Newtonsohn/BA-Smart-Waage/Doku/BA_Doku.tex

\documentclass[12pt,a4paper]{article}
\usepackage[utf8]{inputenc}
\usepackage[german]{babel}
\usepackage{amsmath}
\usepackage{amsfonts}
\usepackage{amssymb}
\usepackage{graphicx}
\usepackage{hyperref}
\usepackage{booktabs}
\usepackage{siunitx}
\usepackage{verbatim}
\usepackage{float}
\usepackage[a4paper, left=2.5cm, right=2.5cm, top=2.5cm, bottom=2.5cm]{geometry}
\usepackage{pdfpages}
\usepackage{pdflscape}

\setcounter{secnumdepth}{3}
\setcounter{tocdepth}{3}

\begin{document}
	\includepdf[pages=-]{Images/T_VL_Vorlage_Titelseite_BA.pdf}
	\includepdf[pages=-]{Images/BA_Doku_removed_signed}
	\newpage

	% ============================================================
	\section*{Abstract}
	% ============================================================

	\textbf{English}

	\medskip
	\noindent
	This thesis advances a previously developed ESP32-based smart scale prototype for industrial parts and bulk-goods inventory management.
	Two aspects are addressed in depth: measurement accuracy and energy efficiency.

	For measurement accuracy, the four YZC-133 load cells are each connected to a dedicated channel of the ADS1234 24-bit ADC with a PGA gain of~128 and a data rate of 10~SPS.
	Individual per-sensor calibration enables corner-load compensation, which was not possible with the single summed channel of the predecessor.
	Measurements confirm a repeatability of $\pm$\,0.1\,g, though absolute accuracy is limited by mechanical imperfections of the prototype.

	For energy efficiency, three hardware measures were implemented: the load-cell supply is interrupted via MOSFET before entering deep sleep; the ESP32 is powered directly through the 3V3~pin, eliminating the on-board LDO; and the buck-converter output voltage was reduced from 3.3\,V to 3.0\,V, saving an additional 73.4\,mJ per cycle ($-$17.6\,\%).
	Combined with software-level optimisations including the migration from the Arduino BLE stack to NimbleBLE, the active-cycle energy consumption is reduced from 6503\,mJ to 689.5\,mJ, a reduction of \textbf{89.4\,\%}.
	A custom PCB was designed to consolidate the power path; a component selection error in the buck converter prevents its immediate use in the current revision.

	\bigskip
	\textbf{Deutsch}

	\medskip
	\noindent
	Diese Bachelorarbeit baut auf einem bestehenden ESP32-basierten Smart-Waagen-Prototyp für die industrielle Inventarisierung von Kleinteilen und Schüttgut auf und vertieft zwei Schwerpunkte: Messgenauigkeit und Energieeffizienz.

	Zur Verbesserung der Messgenauigkeit wird jede der vier YZC-133-Wägezellen einzeln an einen dedizierten Kanal des ADS1234 (24-Bit-ADC, PGA-Faktor~128, 10~SPS) angeschlossen.
	Die individuelle Kalibrierung pro Sensor ermöglicht eine Ecklastkompensation, die mit dem summierten Einzelkanalansatz der Vorgängerarbeit nicht realisierbar war.
	Die Messungen zeigen eine Wiederholbarkeit von $\pm$\,0{,}1\,g; die Absolutgenauigkeit ist durch mechanische Unzulänglichkeiten des Prototyps eingeschränkt.

	Für die Energieoptimierung wurden drei Hardwaremassnahmen umgesetzt: Die Wägezellen werden über einen MOSFET vor dem Deep-Sleep abgeschaltet; der ESP32 wird direkt über den 3V3-Pin versorgt, womit der interne Board-LDO entfällt; die Ausgangsspannung des Buck-Converters wurde von 3{,}3\,V auf 3{,}0\,V abgesenkt, was eine zusätzliche Einsparung von 73{,}4\,mJ pro Zyklus ($-$17{,}6\,\%) erzielt.
	In Kombination mit Softwareoptimierungen -- darunter die Migration vom Arduino-BLE-Stack auf NimbleBLE -- sinkt der Energieverbrauch pro Aktivzyklus von 6503\,mJ auf 689{,}5\,mJ, eine Reduktion um \textbf{89{,}4\,\%}.
	Ein eigens entwickeltes PCB wurde zur Konsolidierung des Strompfads ausgelegt; ein Fehler bei der Schaltreglerwahl verhindert dessen unmittelbaren Einsatz in der vorliegenden Revision.

	\newpage
	\tableofcontents
	\newpage

	% ============================================================
	\section{Einleitung}
	% ============================================================

	Die zunehmende Vernetzung industrieller Prozesse stellt neue Anforderungen an eingebettete Systeme -- insbesondere hinsichtlich Energieeffizienz, Messgenauigkeit und Kommunikationszuverlässigkeit.
	Diese Arbeit baut auf einem bestehenden Proof of Concept~\cite{vorgaengerarbeit} auf und vertieft dessen technische Grundlagen mit Fokus auf die Weiterentwicklung der Smart-Waage selbst.

	\subsection{Ausgangslage}

	Ausgangslage für diese Arbeit bildet die Firma Skysec GmbH, ein Startup, das sich auf die Herstellung von Drohnen zum Schutz von Einrichtungen spezialisiert hat.
	Für den Herstellungsprozess, insbesondere die Inventarisierung von Kleinteilen und Schüttgut, sollen intelligente Waagen (Smart-Bins) eingesetzt werden.
	Bestehende kommerzielle Lösungen -- etwa von Bossard -- sind an proprietäre Cloud-Plattformen gebunden und erlauben keine eigenständige Datenhoheit, was für den Industriepartner aufgrund seiner sicherheitskritischen Tätigkeit nicht akzeptabel ist.

	Im Rahmen der vorangegangenen Bachelorarbeit~\cite{vorgaengerarbeit} (Berger \& Müller, BA~FS25) wurde bereits ein funktionsfähiger Prototyp entwickelt: ein ESP32-basiertes Wägesystem mit BLE-Kommunikation, einem Raspberry-Pi-Gateway und einem containerisierten ASP.NET-Core-Backend.
	Die vorliegende Arbeit knüpft an diesen PoC an und setzt den Schwerpunkt auf die Optimierung der Waage selbst -- mit Fokus auf Messgenauigkeit und Energieverbrauch.

	\subsection{Zielsetzung}

	Die Zielsetzung gliedert sich in funktionale und organisatorische Ziele gemäss der Projektvereinbarung~\cite{vereinbarung}.

	\begin{table}[H]
		\centering
		\caption{Funktionale Ziele gemäss Vereinbarung}
		\label{tab:ziele-funktional}
		\begin{tabular}{p{9.5cm}ccc}
			\toprule
			\textbf{Funktionales Ziel} & \textbf{Muss} & \textbf{Soll} & \textbf{Optional} \\
			\midrule
			Evaluation Hardware-Plattformen (ESP32, STM32, Arduino, Raspberry) & $\times$ & & \\
			Evaluation Kommunikationsprotokoll (BLE, ESP-NOW)                  & $\times$ & & \\
			Analyse Leistungsbedarf und Evaluation von Leistungssparmassnahmen & $\times$ & & \\
			Interface mit der Waage (Tara, Stückzahl, Gewicht, Einheitenumrechner) & $\times$ & & \\
			Power-Optimierung: Reduktion Aktiv- und Ruheströme                & $\times$ & & \\
			Evaluation Energiequelle (Batterie vs.\ Akku)                     & $\times$ & & \\
			Temperaturkorrektur der Dehnmessstreifen                          & & $\times$ & \\
			Massenproduktionstaugliches PCB                                     & & & $\times$ \\
			Umporten auf STM32                                                 & & & $\times$ \\
			Umbau auf Batteriebetrieb                                          & & & $\times$ \\
			\bottomrule
		\end{tabular}
	\end{table}

	\begin{table}[H]
		\centering
		\caption{Organisatorische Ziele gemäss Vereinbarung}
		\label{tab:ziele-org}
		\begin{tabular}{p{11cm}cc}
			\toprule
			\textbf{Organisatorisches Ziel} & \textbf{Muss} & \textbf{Soll} \\
			\midrule
			Erstellung eines Projektplans              & $\times$ & \\
			Beschaffung der benötigten Hardware        & $\times$ & \\
			Einhaltung des Abgabetermins               & $\times$ & \\
			Einhaltung der Meilensteine                & & $\times$ \\
			\bottomrule
		\end{tabular}
	\end{table}

	\subsection{Systemabgrenzung und Randbedingungen}

	Folgende Bereiche sind explizit \textbf{nicht} Bestandteil dieser Arbeit:
	\begin{itemize}
		\item On-Premise-Lösung (keine Cloud-Anbindung)
		\item Dynamisches Softwareupdate (OTA)
		\item Einbindung in Firmennetzwerk
		\item Fertiges Produkt (Prototyp-Status)
		\item Verschlüsselte Übermittlung der Sensordaten an das Gateway
		\item Weiterentwicklung des bestehenden Backends
	\end{itemize}

	\noindent Randbedingungen:
	\begin{itemize}
		\item Arbeitsplätze im Raum TE514\,/\,TE516 sowie Messgeräte, Lötstation und Industrienetzgerät stehen bereit.
		\item Der Projektstand wird regelmässig mit dem Betreuer besprochen.
		\item Der Quellcode wird auf GitHub gehostet.
	\end{itemize}

	\subsection{Meilensteine}

	\begin{enumerate}
		\item \textbf{Hardware-Entwicklung:} Evaluation alternativer Plattformen; Redesign des Strompfads für Low-Power-Betrieb.
		\item \textbf{Quality of Life:} Implementierung von Bedienelementen (Taster) sowie Software-Funktionen (Tara, Kalibrierung, Einheitenumrechner).
		\item \textbf{Kommunikationsprotokolle:} Evaluation und Implementierung von ESP-NOW vs.\ BLE (NimbleBLE).
	\end{enumerate}

	\subsection{Aufbau der Arbeit}

	Die Arbeit ist in folgende Kapitel gegliedert:
	Kapitel~2 beschreibt die technische Ausgangslage und die getroffenen Designentscheidungen.
	In Kapitel~3 werden die Low-Power-Optimierungen erläutert -- von der Hardwareanpassung bis zur Strommessung.
	Kapitel~4 behandelt die Optimierung der Messgenauigkeit, einschliesslich Sensorik, ADC-Ansteuerung und Kalibrierung.
	Eine Geräteübersicht beider Prototypen ist in Kapitel~5 dargestellt.
	Das PCB-Design ist in Kapitel~6 dokumentiert.
	Kapitel~7 fasst die Messungen zusammen, und Kapitel~8 schliesst mit Fazit und Ausblick.

	% ============================================================
	\section{Technische Ausgangslage}
	% ============================================================

	\subsection{Design Space Exploration}

	\subsubsection{MCU-Auswahl: SBC-NodeMCU-ESP32-C vs. ESP32-C3 vs. nRF52840}

	Für die Wahl des Mikrocontrollers wurden drei Kandidaten verglichen.
	Die wesentlichen Stromverbrauchswerte sind in Tabelle~\ref{tab:mcu} gegenübergestellt.

	\begin{table}[h]
		\centering
		\begin{tabular}{lrrr}
			\toprule
			\textbf{MCU} & \textbf{Aktiv (mit RF)} & \textbf{Light Sleep} & \textbf{Deep Sleep} \\
			\midrule
			SBC-NodeMCU-ESP32-C (Board)$^\dagger$ & \SI{160}{\milli\ampere} -- \SI{240}{\milli\ampere} & $\sim$\SI{5}{\milli\ampere} & $\sim$\SI{4}{\milli\ampere} \\
			ESP32-C3 (SoC)                        & \SI{100}{\milli\ampere} -- \SI{335}{\milli\ampere} & \SI{130}{\micro\ampere}     & \SI{5}{\micro\ampere}  \\
			nRF52840 (SoC)                        & $\sim$\SI{16}{\milli\ampere}                       & \SI{1{,}5}{\micro\ampere}   & \SI{0{,}4}{\micro\ampere} \\
			\bottomrule
		\end{tabular}
		\caption{Stromverbrauch der MCU-Kandidaten \cite{sbc_nodemcu_esp32c_datasheet, esp32_devboard_sleep, esp32c3_datasheet, nrf52840_datasheet}.
		$^\dagger$~Board-Werte inkl.\ CP2102, LDO und Power-LED; ESP32-C3 und nRF52840 beziehen sich auf den SoC-Chip allein.}
		\label{tab:mcu}
	\end{table}

	Das nRF52840 ist energetisch am effizientesten, erfordert jedoch ein vollständiges Porting der bestehenden Software sowie eine neue Peripherieschaltung.
	Der ESP32-C3 bietet auf SoC-Ebene einen deutlich besseren Sleep-Strom als das SBC-Entwicklungsboard und wäre mit moderatem Aufwand adaptierbar, benötigt aber ebenfalls eine eigene Peripheriebeschaltung.
	Da die Vorgängerarbeit~\cite{vorgaengerarbeit} bereits auf dem SBC-NodeMCU-ESP32-C basiert, kann dessen bestehende Hardware- und Softwarebasis direkt übernommen werden, ohne eine Peripherieschaltung neu auslegen zu müssen.
	Angesichts des erheblichen Einsparpotenzials auf Seiten der DMS-Signalkette und der Software fiel die Entscheidung daher auf den SBC-NodeMCU-ESP32-C, um den Entwicklungsaufwand zu minimieren und den Fokus auf die relevanten Optimierungen zu legen.
	Der hohe Sleep-Strom des Boards -- verursacht durch CP2102, Board-LDO und Power-LED -- wurde dabei als bekannte Einschränkung in Kauf genommen.
	
	% ============================================================
	\section{Low-Power Optimierung}
	% ============================================================
	\subsection{Motivation}

	Die Waage ist für den Einsatz in der Intralogistik konzipiert, wo sie autonom und ohne regelmässige Wartung den Füllstand von Lagerbehältern überwacht.
	In diesem Umfeld ist eine möglichst lange Batterielaufzeit entscheidend: Jeder Akkuwechsel verursacht Wartungsaufwand, der bei einer grossen Anzahl verteilter Geräte erhebliche Betriebskosten erzeugen kann.

	Da die Vorgängerarbeit ihren Schwerpunkt auf die funktionale Korrektheit des Systems legte, wurde die Optimierung des Stromverbrauchs bisher nicht adressiert.
	Das System bietet daher noch erhebliches Einsparpotenzial, das in dieser Arbeit systematisch erschlossen wird.
	
	\subsection{Strompfad Schema}
	Die folgenden Diagramme zeigen den Strompfad der alten und neuen Waage.

		\subsubsection{Ausgangslage}
			\begin{figure}[h]
			\centering
			
			\caption{Schema Strompfad -- Ausgangslage}
			\label{fig:strompfad-ausgangslage}
		\end{figure}

		Die Spannungsversorgung der Ausgangslage besteht aus drei in Reihe geschalteten 18650-Lithium-Ionen-Zellen mit einer Nennspannung von \SI{11.1}{\volt}.
		Ein \textbf{LM2596}-Schaltregler wandelt diese Spannung auf ein stabiles \SI{5}{\volt}-Rail herunter, von dem alle Verbraucher gespeist werden: der ESP32 (über den internen LDO des Entwicklerboards), der HX711-ADC, die Dehnmessstreifen sowie das E-Paper-Display.
		Der LDO des Entwicklerboards wandelt die \SI{5}{\volt} auf die vom Mikrocontroller benötigten \SI{3.3}{\volt} -- eine zusätzliche Spannungskonversion, die unnötige Verlustleistung erzeugt und im Hardware Redesign beseitigt wird.

		\subsubsection{Hardware Redesign}
			\begin{figure}[H]
			\centering
			
			\caption{Schema Strompfad -- Hardware Redesign}
			\label{fig:strompfad-redesign}
		\end{figure}

		Das Hardware Redesign optimiert den Strompfad in zwei wesentlichen Punkten:
		\begin{itemize}
			\item \textbf{Dehnmessstreifen über MOSFET geschaltet:} In der Ausgangslage waren die Wägezellen dauerhaft mit Spannung versorgt -- auch im Deep Sleep. Durch einen MOSFET wird die Versorgung der Dehnmessstreifen vor dem Eintreten in den Deep Sleep unterbrochen, was den Ruhestrom merklich senkt.
			\item \textbf{ESP32 direkt über den 3V3-Pin versorgt:} Das Entwicklerboard enthielt einen internen LDO, der \SI{5}{\volt} auf \SI{3.3}{\volt} regelte. Im neuen Design wird der ESP32 direkt über den \texttt{3V3}-Pin eingespeist, womit diese Verlustleistung entfällt. Ausserdem wurde die Ausgangsspannung des Buck-Converters auf \SI{3.0}{\volt} reduziert, was gegenüber dem Betrieb mit \SI{3.3}{\volt} eine weitere Einsparung von \SI{73.4}{\milli\joule} pro Zyklus ($-17{,}6\,\%$) erzielt (siehe Abschnitt~\ref{sec:spannungsreduktion}).
		\end{itemize}

	\subsection{Strommessungen und Low-Power-Optimierung}

	Ein zentrales Ziel dieser Arbeit ist die Minimierung des Stromverbrauchs, um eine möglichst lange Batterielaufzeit zu erreichen.
	Die folgenden Messungen dokumentieren den Energieverbrauch in den einzelnen Betriebsphasen und quantifizieren den Effekt der implementierten Optimierungen.
	Tabellen~\ref{tab:sw-vergleich} und~\ref{tab:sys-vergleich} fassen die verbrauchte Energie pro Phase zusammen -- jeweils im direkten Vergleich zwischen Ausgangslage und optimiertem System.

	\subsection{Übersicht Zyklus}

	Für die Strommessungen kamen zwei Messgeräte zum Einsatz, die je nach Messaufgabe in den Versorgungspfad eingeschleift wurden.

	Das \textbf{Nordic Semiconductor Power Profiler Kit~II} (PPK2) wurde für das qualitative Stromverlauf-Profiling eingesetzt und liefert eine zeitlich aufgelöste Visualisierung der einzelnen Betriebsphasen (Boot, ADC-Messung, BLE, Deep Sleep) in der nRF Connect Power Profiler App.

	Die quantitativen Energie- und Leistungsmessungen wurden mit dem \textbf{JouleScope} durchgeführt.
	Das JouleScope misst gleichzeitig Strom und Spannung und berechnet daraus direkt die verbrauchte Energie in Millijoule -- unter Berücksichtigung des tatsächlichen Spannungsniveaus am jeweiligen Messpunkt.
	Je nach Messung wurde das Gerät an unterschiedlichen Stellen in den Strompfad eingeschleift: vor dem Buck-Converter (Batterieseite), nach dem Buck-Converter (Power-Rail), direkt vor einzelnen Verbrauchern (ESP32, ADC, Dehnmessstreifen) oder am LDO-Ein- bzw.\ Ausgang.

	\subsection{Gesamtsystem Stromverbrauch}

	Tabelle~\ref{tab:sw-vergleich} vergleicht die Software-Ausgangslage mit dem optimierten System auf Basis der JouleScope-Messungen am 3V3-Pin des ESP32.
	Tabelle~\ref{tab:sys-vergleich} stellt den Gesamtenergieverbrauch beider Systeme gegenüber; die Werte beziehen sich auf JouleScope-Messungen vor dem Buck-Converter (Batterieseite) und umfassen damit sämtliche Wandlungsverluste.
	
	\subsubsection{Vergleich Energieverbrauch Aktiver Zyklus}
	\begin{table}[H]
	\centering
	\caption{Gesamtsystem Energiebedarf Zusammensetzung -- Vergleich Aktiver Zyklus}
	\label{tab:sys-vergleich}
	\begin{tabular*}{\textwidth}{@{\extracolsep{\fill}}lrrr@{}}
		\toprule
		Verbraucher 					& Alt [mJ] 	& Neu [mJ] 	& Ersparnis \\
		\midrule

		\multicolumn{4}{l}{\textit{Verbrauch}} \\[2pt]
		\quad ESP32 über 3V3			&	2220	&	223.8	&	$-89.9\,\%$	\\
		\quad Dehnmessstreifen			&	781.9	&	89.1	&	$-88.6\,\%$	\\
		\quad ADC						&	106.2	&	13.42	&	$-87.4\,\%$	\\[4pt]
		\multicolumn{4}{l}{\textit{Verluste Umwandlung}} \\[2pt]
		\quad Verlust LDO				&	1210	&	0		&	Entfällt	\\
		\quad Verlust Buck				&	2955	&	346.1	&	$-88.3\,\%$	\\
		\midrule
		Summiert						&	7273.1	&	672.4	&	$-90.7\,\%$	\\
		Diskrepanz						&	$-770.1$&	17.1	&				\\
		\midrule
		\textbf{Gesamt Gemessen}    	& 	6503	&	689.5	&	$-89.4\,\%$	\\
		\bottomrule
	\end{tabular*}
	\\[4pt]
\end{table}

	\subsubsection{Vergleich Leistungsverbrauch Deep-Sleep}

	Tabelle~\ref{tab:sys-vergleich-deep-sleep} vergleicht den Leistungsverbrauch im Deep Sleep.
	Einzelmessungen der Verbraucher: Abb.~\ref{fig:deep-dms-alt} (DMS), \ref{fig:deep-adc-alt}/\ref{fig:deep-adc-neu} (ADC).
	Gesamtmessungen vor dem Buck-Converter: Abb.~\ref{fig:deep-vorbuck-alt}/\ref{fig:deep-vorbuck-neu}.
	Trotz der Komponenteneinsparungen ($-87{,}7\,\%$ nach Buck) begrenzt der Leerlaufverlust des LM2596S von \SI{69.77}{\milli\watt} (Abb.~\ref{fig:deep-leerlauf-buck}) die tatsächliche Ersparnis auf Batterieebene erheblich: Er übersteigt allein bereits den Gesamtverbrauch aller Komponenten des neuen Systems.

	\begin{table}[H]
	\centering
	\caption{Vergleich Leistungsverbrauch Deep-Sleep -- Ausgangslage vs.\ Optimiertes System}
	\label{tab:sys-vergleich-deep-sleep}
	\begin{tabular}{@{}lrrr@{}}
		\toprule
		Verbraucher & Alt [mW] & Neu [mW] & Ersparnis \\
		\midrule
		\multicolumn{4}{l}{\textit{Nach Buck-Converter (Power Rail)}} \\[2pt]
		\quad Dehnmessstreifen       & 78{,}19  & 0        & $-$100\,\% (MOSFET) \\
		\quad ADC                    & 9{,}762  & 4{,}042  & $-$58{,}6\,\% \\
		\quad ESP32                  & 27{,}53  & 10{,}15  & $-$63{,}1\,\% \\
		\midrule
		Summiert (nach Buck)         & 115{,}4  & 14{,}19  & $-$87{,}7\,\% \\
		\midrule
		\multicolumn{4}{l}{\textit{Vor Buck-Converter (Batterieseite)}} \\[2pt]
		\textbf{Gesamt gemessen}     & \textbf{268{,}2} & \textbf{90{,}96} & $-$66{,}1\,\% \\
		\bottomrule
	\end{tabular}
	\\[4pt]
	\end{table}

	\subsection{Vergleich Energieverbrauch ESP32}
	
	\subsubsection{Übersicht Stromverlauf ESP32}
	
	Abbildung~\ref{fig:stromverbrauch-ausgangslage} zeigt den Stromverlauf eines vollständigen Messzyklus in der Ausgangslage, wie er direkt aus der Vorgängerarbeit übernommen wurde.
	In dieser Vorarbeit stand die funktionale Korrektheit im Vordergrund -- eine gezielte Optimierung des Stromverbrauchs hatte keine Priorität.
	
	Im Profil sind drei charakteristische Abschnitte erkennbar: ein kurzer initialer Peak während Boot und Initialisierung, ein ruhigeres Plateau während der ADC-Messung sowie ein erhöhter und zeitlich ausgedehnter Abschnitt während der BLE-Kommunikation.
	Die gesamte Aktivphase erstreckt sich über ca.\ \textbf{10\,s}, bevor das System in den Deep Sleep übergeht.
	
	\begin{figure}[H]
		\centering
		
		\caption{Stromverbrauch -- Ausgangslage, ein vollständiger Messzyklus}
		\label{fig:stromverbrauch-ausgangslage}
	\end{figure}
	
	\begin{enumerate}
		\item \textbf{Deep Sleep:} Zwischen den Messzyklen befindet sich das System im Deep Sleep. Die meisten Funktionen sind abgeschaltet; lediglich der RTC-Timer läuft weiter und weckt den ESP32 nach Ablauf des konfigurierten Intervalls. Der Stromverbrauch ist in dieser Phase minimal.
		\item \textbf{Boot und Initialisierung:} Der ESP32 startet nach dem Deep Sleep neu. Der nichtflüchtige Speicher (NVS) wird ausgelesen, die State Machine initialisiert und der HX711-ADC eingerichtet.
		\item \textbf{ADC-Messung:} Der HX711 erfasst 20 Samples auf einem einzigen Kanal, an dem alle vier Wägezellen als gemeinsame Brücke angeschlossen sind. Zwischen jedem Sample wartet der ESP32 in einem blockierenden \texttt{delay(50\,ms)}, was den Kern während der gesamten Messphase vollständig aktiv hält.
		\item \textbf{BLE-Initialisierung:} Der BLE-Stack wird gestartet und das Advertisement für die Gateway-Verbindung gesendet.
		\item \textbf{Verbindung und Datenübertragung:} Das System wartet auf den Verbindungsaufbau des Gateways (typisch ca.\ 6\,s), überträgt den Messwert per GATT-Indication und trennt die Verbindung.
		\item \textbf{Nächster Zyklus:} Der Messzyklus ist abgeschlossen; das System kehrt in den Deep Sleep zurück. Im gezeigten Stromprofil folgt der nächste Zyklus sofort, weshalb kein ausgeprägtes Tiefstromplateau sichtbar ist.
	\end{enumerate}
	\subsubsection{Vergleich ESP32 Energieverbrauch}
	\begin{table}[H]
	\centering
	\caption{Software-Vergleich Aktiver Zyklus am ESP32-3V3-Pin: Ausgangslage vs.\ Optimiertes System. Beide ESP32 wurden mit 3.0V gespeist. DMS und LDO sind aus dem Messpfad ausgeschlossen.
	Messprofile und Berechnungen vgl.\ Abschnitt~\ref{par:esp32}.}
	\label{tab:sw-vergleich}
	\begin{tabular}{@{}lrrr@{}}
		\toprule
		Betriebsphase                 & Alt [mJ]       & Neu bereinigt$^{*}$ [mJ] & Einsparung \\
		\midrule
		Boot und Ramp-up              & 360.3          & 57.66                    & $-84.0\,\%$ \\
		ADC-Messung                   & 807.8          & 37.41                    & $-95.4\,\%$ \\
		BLE                           & 1293           & 88.18                    & $-93.2\,\%$ \\
		ADS1234 Chip (Abzug$^{*}$)    & --             & 13.42                    & -- \\
		\midrule
		\textbf{Gesamt Zyklus}        & \textbf{1858}  & \textbf{210.4}           & $\mathbf{-88.7\,\%}$ \\
		\bottomrule
	\end{tabular}
	\\[6pt]
	\begin{minipage}{0.95\linewidth}
		\footnotesize $^{*}$~Der ADS1234 ist am ESP32-3V3-Rail angeschlossen und in den Phasenmessungen des
		neuen Systems enthalten. Da der HX711 des alten Systems ausserhalb des Messpfades lag, wird der
		ADS1234-Anteil (\SI{13.42}{\milli\joule}) von allen Neu-Werten abgezogen.
		Rohmessungen und Rechnungen: Abschnitt~\ref{par:esp32}.
	\end{minipage}
	\end{table}

	Die nachfolgenden Abschnitte beschreiben jede Betriebsphase im Detail und erläutern, welche Massnahmen zur jeweiligen Einsparung geführt haben:
	\subsubsection{Optimierung Energieverbrauch Software}\label{sub:software}
	\begin{enumerate}

		\item \textbf{Ramp Up -- Boot, Initialisierung und ADC}: \\
		Diese Phase umfasst den ESP32-Bootvorgang, die State-Machine-Initialisierung sowie die ADS1234-Messung.
		In der Vorgängerarbeit wurden Kalibrierparameter bei jedem Aufwachen aus dem Deep Sleep neu aus dem nichtflüchtigen Speicher (NVS) ausgelesen.
		Im optimierten System werden diese Werte einmalig beim ersten Boot geladen und anschliessend im RTC-Speicher gehalten, der den Deep Sleep überlebt -- das NVS-Auslesen entfällt damit bei jedem Folge-Zyklus und verkürzt die Boot-Phase entsprechend.

		\item \textbf{ADC}: \\
		In der Ausgangslage verwendete die Vorgängerarbeit den \textbf{HX711} -- einen einkanaligen 24-Bit-ADC, an den alle vier Wägezellen als gemeinsame Brücke angeschlossen waren.
		Die Messung erfasste 20~Samples auf diesem einzigen Kanal; zwischen jedem Sample wurde ein blockierendes \texttt{delay(50\,ms)} ausgeführt, was den ESP32-Kern für die gesamte Wartezeit vollaktiv liess.

		Im optimierten Design werden die vier Kanäle des ADS1234 sequenziell ausgelesen; pro Kanal werden \textbf{5~Samples} erfasst.
		Nach jedem Sample kehrt der ESP32 sofort in den Light Sleep zurück und wird durch einen GPIO-Interrupt auf dem \texttt{DRDY}-Pin geweckt.
		Zwischen den vier Kanalgruppen liegt eine Pause von ca.\ \textbf{400\,ms}: die physikalisch bedingte Einschwingzeit des internen sinc\textsuperscript{3}-Filters nach einem Kanalwechsel.
		Auch diese Wartezeit verbringt der ESP32 im Light Sleep.

		\begin{figure}[H]
			\centering
			\begin{minipage}[t]{0.48\linewidth}
				\centering
				
				\caption{ADC-Stromverlauf -- Ausgangslage (HX711)}
				\label{fig:sw-adc-alt}
			\end{minipage}
			\hfill
			\begin{minipage}[t]{0.48\linewidth}
				\centering
				
				\caption{ADC-Stromverlauf -- Optimiertes System (ADS1234)}
				\label{fig:sw-adc-neu}
			\end{minipage}
		\end{figure}

		\item \textbf{BLE-Initialisierung und Advertisement}: \\
		In der Ausgangslage verwendete die Firmware die Arduino-BLE-Bibliothek (Bluedroid) und baute für jeden Messzyklus eine vollständige GATT-Verbindung auf.
		Die Dauer dieser Phase variiert stark in Abhängigkeit vom Scan-Intervall des Gateways -- im gezeigten Profil \textbf{5.6\,s}, in anderen Messungen bis zu \textbf{7\,s}.

		Der fundamentale Optimierungsansatz bestand darin, den Verbindungsaufbau vollständig zu eliminieren: Der Messwert wird direkt in die Manufacturer-Specific-Data des Advertisement-Pakets kodiert -- das Gateway empfängt die Daten durch passives Scannen, ohne eine Verbindung aufzubauen.
		Im zweiten Schritt wurde Bluedroid durch den schlanken \textbf{NimBLE}-Stack ersetzt, der einen deutlich geringeren Initialisierungsoverhead aufweist.

		\begin{figure}[H]
			\centering
			\begin{minipage}[t]{0.48\linewidth}
				\centering
				
				\caption{BLE -- Ausgangslage (Bluedroid, GATT-Verbindung)}
				\label{fig:sw-ble-alt}
			\end{minipage}
			\hfill
			\begin{minipage}[t]{0.48\linewidth}
				\centering
				
				\caption{BLE -- Optimiertes System (NimBLE, Advertisement)}
				\label{fig:sw-ble-nimble}
			\end{minipage}
		\end{figure}

		Als Zwischenschritt wurde der Advertisement-Ansatz zunächst mit der bestehenden Arduino-BLE-Bibliothek validiert (Abbildung~\ref{fig:sw-ble-arduino}), bevor der Wechsel zu NimBLE erfolgte.

		\begin{figure}[H]
			\centering
			
			\caption{BLE -- Zwischenschritt (Arduino BLE-Library, Advertisement)}
			\label{fig:sw-ble-arduino}
		\end{figure}

		Die Wahl von \textbf{zwei Advertisements} pro Zyklus ist ein bewusster Kompromiss.
		In einem Zuverlässigkeitstest über \textbf{100 aufeinanderfolgende Messzyklen} wurden \textbf{91 von 100} Advertisements erfolgreich vom Gateway empfangen, was für ein periodisches Überwachungssystem ausreichend ist.

		\begin{figure}[H]
			\centering
			
			\caption{Zuverlässigkeitstest -- 100 BLE Advertisements (NimBLE)}
			\label{fig:sw-ble-reliab}
		\end{figure}

	\end{enumerate}

	% Hier Text einfügen (optimierte Messungen BLE-Verbindung -- Screenshot nachher)

	\subsection{Verluste Hardware}
	Dieses Unterkapitel quantifiziert die Wandlungsverluste des Buck-Converters und des LDO sowie den Energiebedarf des ADC.
	\subsubsection{Messmethode}
	Für Buck-Converter und LDO wird die Energie jeweils \emph{vor} und \emph{nach} dem Bauteil über einen vollständigen Zyklus erfasst; die Differenz entspricht dem jeweiligen Wandlungsverlust.
	Der Energiebedarf des ADC wird direkt am Versorgungspin des Chips gemessen.
	
	\subsubsection{Buck converter}\label{sub:Buck}

	Zur Bestimmung des Verlusts am LM2596S-Schaltregler wird die Energie \emph{vor} dem Konverter (Eingang, Batterieseite) mit der Energie \emph{nach} dem Konverter (Ausgang, Lastseite) verglichen; die Differenz entspricht dem Schaltregler-Board zuzuschreibenden Verlust.
	Die Messwerte entstammen den JouleScope-Aufzeichnungen
	(Abbildungen~\ref{fig:buck-vor-alt}, \ref{fig:buck-vor-neu},
	\ref{fig:buck-nach-alt} und~\ref{fig:buck-nach-neu})
	und umfassen jeweils einen vollständigen Messzyklus.
	Beim alten System wurde sichergestellt, dass BLE-Initialisierung und Subscription zusammen ca.\ \SI{5.4}{\second} dauerten, um vergleichbare und reproduzierbare Messungen zu gewährleisten.

	\paragraph{Altes System}

	\begin{align}
		\Delta E_{\text{Buck, alt}} &= \SI{6503}{\milli\joule} - \SI{3548}{\milli\joule} = \SI{2955}{\milli\joule} \\
		\eta_{\text{Buck, alt}} &= \frac{\SI{3548}{\milli\joule}}{\SI{6503}{\milli\joule}} \approx \SI{54.6}{\percent}
	\end{align}

	\paragraph{Neues System}

	\begin{align}
		\Delta E_{\text{Buck, neu}} &= \SI{689.5}{\milli\joule} - \SI{343.4}{\milli\joule} = \SI{346.1}{\milli\joule} \\
		\eta_{\text{Buck, neu}} &= \frac{\SI{343.4}{\milli\joule}}{\SI{689.5}{\milli\joule}} \approx \SI{49.8}{\percent}
	\end{align}

	\paragraph{Vergleich}

	Beide Systeme weisen einen ähnlichen Wirkungsgrad von ca.\ \SI{50}{\percent} auf.
	Der entscheidende Unterschied liegt im absoluten Verlust: Das alte System verliert \SI{2955}{\milli\joule} pro Zyklus am Schaltregler, das neue System nur \SI{346.1}{\milli\joule} -- eine Reduktion um den Faktor \textbf{8,5}.
	Der geringere absolute Verlust ist direkt auf den deutlich niedrigeren Gesamtenergieverbrauch des optimierten Systems zurückzuführen.

	\paragraph{Plausibilitätsprüfung anhand des Datenblatts}

	Das Datenblatt des LM2596S~\cite{lm2596_datasheet} gibt für eine Konfiguration von \SI{12}{\volt} Eingang auf \SI{3.3}{\volt} Ausgang bei einem Ausgangsstrom von \SI{3}{\ampere} einen typischen Wirkungsgrad von \SI{79}{\percent} an.
	Die gemessenen Werte von ca.\ \SI{50}{\percent} liegen erwartungsgemäss darunter -- zum einen weil beide Systeme mit mittleren Lastströmen weit unter \SI{3}{\ampere} betrieben werden, zum anderen weil es sich nicht um den nackten LM2596S-Chip handelt, sondern um ein fertiges Schaltregler-Board mit zusätzlicher Peripherie (Freilaufdiode, Spule, Filterkapazitoren, Schutzschaltungen), die den Gesamtwirkungsgrad weiter senken.

	Bei geringer Nutzlast dominiert zudem der Quiescent-Strom des LM2596S von ca.\ \SI{5.5}{\milli\ampere} den Eingangsstrom überproportional -- bei \SI{3}{\ampere} Nennlast wäre er vernachlässigbar.
	Da der LM2596S keinen Burst- oder PFM-Modus für Leichtlast unterstützt, ist dieser Verlust strukturell bedingt.
	\subsubsection{LDO}\label{sub:ldo}

	Der interne LDO des ESP32-Entwicklerboards wandelt die vom LM2596S gelieferte Spannung
	auf die vom Mikrocontroller benötigten \SI{3.3}{\volt}.
	Diese zusätzliche Konverterstufe erzeugt eine nicht vernachlässigbare Verlustleistung.

	\paragraph{Ausgangslage}

	Die Energie vor dem LDO (am VIN-Pin, Eingang) beträgt \SI{3430}{\milli\joule}; nach dem LDO
	(am 3V3-Pin, Ausgang) verbleiben \SI{2220}{\milli\joule}:

	\begin{align}
		\Delta E_{\text{LDO, alt}} &= \SI{3430}{\milli\joule} - \SI{2220}{\milli\joule} = \SI{1210}{\milli\joule} \\
		\eta_{\text{LDO, alt}} &= \frac{\SI{2220}{\milli\joule}}{\SI{3430}{\milli\joule}} \approx \SI{64.7}{\percent}
	\end{align}

	Die Messprofile sind in Abbildungen~\ref{fig:ldo-vor-alt} und~\ref{fig:ldo-nach-alt} dargestellt.

	\paragraph{Optimiertes System -- LDO entfällt}

	Im optimierten System wird der ESP32 direkt über den \texttt{3V3}-Pin eingespeist, anstatt über den
	\texttt{VIN}-Pin. Damit wird der interne LDO vollständig umgangen, und der Verlust von
	\SI{1210}{\milli\joule} pro Zyklus entfällt ersatzlos
	(vgl.\ Tabelle~\ref{tab:sys-vergleich}, Zeile \textit{Verlust LDO}).

	\subsubsection{ADC}

	Der ADS1234 wird nach der Messung über den \texttt{!PDWN}-Pin in den Standby-Modus versetzt
	und vor dem nächsten Zyklus wieder aktiviert.
	Da der ESP32 im Anschluss in den Deep Sleep übergeht und die GPIO-Pins floatend werden,
	bleibt der ADC im Tiefschlaf teilweise aktiv; ein Pull-down-Widerstand am \texttt{!PDWN}-Pin
	hätte eine vollständige Abschaltung ermöglicht.
	Im alten System war der HX711 hardwareseitig nicht im Messpfad eingebunden und wird daher
	separat betrachtet.
	Die Zahlenwerte sind Tabelle~\ref{tab:sys-vergleich} zu entnehmen;
	die Messprofile sind in Abbildungen~\ref{fig:adc-verlust-alt}
	und~\ref{fig:adc-verlust-neu} dargestellt.

	\begin{figure}[H]
		\centering
		\begin{minipage}[t]{0.48\linewidth}
			\centering
			
			\caption{ADC-Verlust -- Ausgangslage (HX711); \SI{9.765}{\milli\watt}}
			\label{fig:adc-verlust-alt}
		\end{minipage}
		\hfill
		\begin{minipage}[t]{0.48\linewidth}
			\centering
			
			\caption{ADC-Verlust -- Optimiertes System (ADS1234); \SI{3.738}{\milli\watt}}
			\label{fig:adc-verlust-neu}
		\end{minipage}
	\end{figure}
	
	\subsection{Gesamtverbrauch und Batterielebensdauer}
	\label{sec:gesamtverbrauch}

	Die Batterielaufzeit ergibt sich aus der Energiebilanz pro Messzyklus; Grundlage sind die direkt am JouleScope gemessenen Werte vor dem Buck-Converter (Batterieseite):
	\begin{itemize}
		\item \textbf{Aktivzyklus-Energie:} \SI{689.5}{\milli\joule} (neu) vs.\ \SI{6503}{\milli\joule} (alt), siehe Tabelle~\ref{tab:sys-vergleich}
		\item \textbf{Deep-Sleep-Leistung:} \SI{90.96}{\milli\watt} (neu) vs.\ \SI{268.2}{\milli\watt} (alt), siehe Tabelle~\ref{tab:sys-vergleich-deep-sleep}
	\end{itemize}

	Als Batteriekapazität wird $3 \times \SI{2600}{\milli\ampere\hour}$ bei \SI{11.1}{\volt} angenommen:
	\[
		E_{\text{Bat}} = \SI{103.9}{\kilo\joule}
	\]

	Die Energie pro Messzyklus ergibt sich zu (da $t_{\text{aktiv}} \ll T$):
	\[
		E_{\text{Zyklus}}(T) \approx E_{\text{aktiv}} + P_{\text{sleep}} \cdot T
	\]

	\begin{table}[H]
	\centering
	\caption{Berechnete Batterielaufzeit -- Vergleich Alt vs.\ Neu ($3 \times \SI{2600}{\milli\ampere\hour}$, \SI{11.1}{\volt})}
	\label{tab:batterielaufzeit}
	\begin{tabular}{@{}lrrrr@{}}
		\toprule
		Intervall $T$ & $E_{\text{Zyklus, neu}}$ & Laufzeit neu & $E_{\text{Zyklus, alt}}$ & Laufzeit alt \\
		\midrule
		1\,min\ \ (\SI{60}{\second})   & \SI{6.15}{\joule}   & $\approx$\,\textbf{12\,Tage} & \SI{22.6}{\joule}  & $\approx$\,3\,Tage \\
		10\,min (\SI{600}{\second})  & \SI{55.3}{\joule}  & $\approx$\,\textbf{13\,Tage} & \SI{167}{\joule}  & $\approx$\,4\,Tage \\
		30\,min (\SI{1800}{\second}) & \SI{164}{\joule} & $\approx$\,\textbf{13\,Tage} & \SI{489}{\joule} & $\approx$\,4\,Tage \\
		\bottomrule
	\end{tabular}
	\end{table}

	Die Laufzeit ist nahezu intervallunabhängig, da der Deep-Sleep-Ruhestrom die Energiebilanz dominiert.
	Das grösste verbleibende Einsparpotenzial liegt in der Reduktion des Tiefschlaf-Ruhestroms -- primär durch Ersetzen des SBC-NodeMCU-ESP32-C-Boards und des LM2596S.

	% ============================================================
	\section{Optimierung Messgenauigkeit}
	% ============================================================

	\subsection{Sensorik: Wägezellen und ADC}

	\subsubsection{Wägezellen (YZC-133)}

	Als Kraftsensoren kommen vier Wägezellen des Typs YZC-133 zum Einsatz \cite{yzc133_datasheet}.
	Jede Zelle ist für eine Nennlast von \SI{1}{\kilogram} ausgelegt und enthält intern eine vollständige Wheatstone-Brücke aus vier Dehnungsmessstreifen (DMS).
	Die relevanten elektrischen Kenngrössen sind in Tabelle~\ref{tab:yzc133} zusammengefasst.

	\begin{table}[h]
		\centering
		\caption{Elektrische Spezifikation YZC-133}
		\label{tab:yzc133}
		\begin{tabular}{@{}ll@{}}
			\toprule
			Parameter & Wert \\ \midrule
			Nennlast                & \SI{1}{\kilogram} \\
			Nennkennwert (Empfindlichkeit) & $1{,}0 \pm 0{,}15\,\text{mV/V}$ \\
			Nullpunktsignal         & $\pm 0{,}1\,\text{mV/V}$ \\
			Kriechfehler            & $0{,}03\,\%\,\text{F.S.} / \SI{30}{\minute}$ \\
			Eingangsimpedanz        & $1066 \pm 20\,\Omega$ \\
			Ausgangsimpedanz        & $1000 \pm 5\,\Omega$ \\ \bottomrule
		\end{tabular}
	\end{table}

	Bei \SI{3{,}0}{\volt} Erregerspannung liegen beide Ausgangspins der Brücke auf einem Gleichtaktpotenzial von ca.\ \SI{1{,}5}{\volt} ($V_{\text{ex}}/2$).
	Das Nutzsignal ist die \emph{Differenz} zwischen diesen beiden Pins: bei Vollast nominell $1{,}0\,\text{mV/V} \times 3{,}0\,\text{V} = \SI{3{,}0}{\milli\volt}$.
	Der differentielle Eingang des ADS1234 erfasst genau diese Differenz und unterdrückt das Gleichtaktsignal durch seine hohe Gleichtaktunterdrückung (CMRR).
	Die vier Zellen sind in X-Formation an den Ecken der Waagplattform montiert.

	\subsubsection{ADS1234 -- 4-Kanal-24-Bit-ADC}

	Für die Signalerfassung wird der ADS1234 von Texas Instruments eingesetzt \cite{ads1234_datasheet}.
	Der Chip ist ein 24-Bit-Sigma-Delta-ADC mit vier differenziellen Eingangskanälen und einem integrierten programmierbaren Verstärker (PGA) mit den Verstärkungsfaktoren 1, 2, 64 und 128.
	Mit PGA-Gain 128 ergibt sich für das \SI{3{,}0}{\milli\volt}-Signal der YZC-133 ein verstärktes Differenzsignal von ca. \SI{384}{\milli\volt}, das den Eingangsbereich des ADC gut ausnutzt.
	Die wählbare Ausgabedatenrate beträgt 10~SPS oder 80~SPS; im vorliegenden System wird 10~SPS verwendet, da dies das Eingangsrauschen durch die längere Integrationszeit maximal reduziert.

	\subsubsection{Von einem auf vier ADC-Kanäle}

	In der Vorarbeit zu dieser Bachelorarbeit waren alle vier Wägezellen in einer gemeinsamen Wheatstone-Brücke zusammengeschaltet und lieferten ihr summiertes Signal an einen einzigen ADC-Kanal.
	In dieser Arbeit wird jede Wägezelle einzeln an einen eigenen Eingangskanal des ADS1234 geführt.
	Dieser Wechsel bringt zwei wesentliche Vorteile:

	\paragraph{Ecklastkompensation}
	Mit einem einzigen Summensignal ist keine positionsabhängige Korrektur möglich: Das System kann nicht unterscheiden, ob eine Abweichung durch einen exzentrischen Lastangriffspunkt oder durch eine tatsächliche Massenänderung entsteht.
	Durch die individuellen Kanäle lässt sich jede Wägezelle separat kalibrieren und der dominante Sensor pro Lastposition gezielt korrigieren (siehe Abschnitt~\ref{sec:kalibrierung}).

	\paragraph{Rauschverhalten und individuelle Kalibrierung}
	Die Empfindlichkeit der YZC-133 streut mit $\pm 15\,\%$ zwischen den Exemplaren.
	In der Einzelkanal-Lösung mittelte sich diese Streuung über die parallele Zusammenschaltung heraus, konnte aber nicht pro Sensor korrigiert werden.
	Mit vier separaten Kanälen wird die Empfindlichkeitsdifferenz jeder Wägezelle durch den individuell bestimmten Skalierungsfaktor (\texttt{spanFactor}) in der Software exakt kompensiert.

	\subsection{ADS1234 -- Ansteuerung und Kalibrierung}
	\label{sec:kalibrierung}

	\subsubsection{Überblick}

	Der ADS1234 ist ein 24-Bit-Sigma-Delta-ADC von Texas Instruments, der speziell für den Einsatz mit Brückensensoren wie Dehnungsmessstreifen (DMS) ausgelegt ist \cite{ads1234_datasheet}.
	Er stellt vier unabhängige Eingangskanäle bereit, die über zwei digitale Adressleitungen (\texttt{A0}, \texttt{A1}) ausgewählt werden.
	Die Kommunikation mit dem Mikrocontroller erfolgt über ein synchrones serielles Protokoll mit den Leitungen \texttt{DRDY/DOUT} (kombiniertes Datenbereit- und Datensignal), \texttt{SCLK} (Takt) sowie \texttt{!PDWN} (Power-Down/Reset).

	\begin{table}[h]
		\centering
		\caption{Pin-Belegung ADS1234 -- ESP32}
		\begin{tabular}{@{}lll@{}}
			\toprule
			Signal & GPIO & Funktion \\ \midrule
			\texttt{DRDY/DOUT} & 2  & Datenbereit-Anzeige und serieller Datenausgang \\
			\texttt{SCLK}      & 15 & Serieller Takt (Master-Ausgang) \\
			\texttt{!PDWN}      & 26 & Power-Down / Reset \\
			\texttt{DMS\_PWR}  & 17 & Versorgung der Wägezellen (schaltbar) \\
			\texttt{A0}        & 32 & Kanal-Adresse Bit 0 \\
			\texttt{A1}        & 4  & Kanal-Adresse Bit 1 \\ \bottomrule
		\end{tabular}
	\end{table}

	\subsubsection{Serielles Leseprotokoll}

	Der ADS1234 signalisiert eine abgeschlossene Wandlung, indem er die \texttt{DRDY}-Leitung auf \texttt{LOW} zieht.
	Die Software wartet aktiv auf diesen Zustand und liest anschliessend 24 Bit MSB-first aus, indem für jedes Bit ein \texttt{SCLK}-Impuls erzeugt und der Pegel von \texttt{DOUT} abgetastet wird.
	Nach dem 24. Bit wird gemäss Datenblatt (Figure~7-10) ein 25.~Taktimpuls gesendet, der \texttt{DRDY} wieder auf \texttt{HIGH} zwingt und damit den ADC für die nächste Wandlung freigibt.
	Da der ADS1234 ein Zweierkomplement-Format mit 24~Bit Breite verwendet, wird der Rohwert abschliessend vorzeichenrichtig auf 32~Bit erweitert:

	\begin{verbatim}
	if (raw & 0x800000) raw |= 0xFF000000;
	return (int32_t)raw;
	\end{verbatim}

	\subsubsection{Kanalwechsel CH4 $\rightarrow$ CH1: !PDWN-Workaround}

	Der ADS1234 kodiert den aktiven Kanal über die beiden Adressleitungen als 2-Bit-Binärzahl: Kanal~1 entspricht \texttt{A0=0, A1=0}, Kanal~4 entspricht \texttt{A0=1, A1=1}.
	Der Chip erkennt einen Kanalwechsel intern anhand steigender Flanken auf \texttt{A0} oder \texttt{A1}.
	Beim Wechsel von Kanal~4 nach Kanal~1 fallen jedoch \emph{beide} Adressleitungen von \texttt{HIGH} auf \texttt{LOW} -- es entsteht keine einzige steigende Flanke.
	Der ADS1234 erkennt diesen Wechsel daher nicht als Kanalumschaltung und setzt \texttt{DRDY} nicht zurück.
	Die Leitung bleibt \texttt{LOW}, was der Software fälschlicherweise signalisiert, dass bereits ein gültiger Messwert des neuen Kanals vorliegt, obwohl noch der alte Kanal aktiv ist.

	Als Lösung wird nach dem Setzen der Adressleitungen auf Kanal~1 geprüft, ob \texttt{DRDY} bereits \texttt{LOW} ist.
	Trifft dies zu, wird ein \texttt{!PDWN}-Puls von \SI{500}{\micro\second} ausgelöst, der den ADC in den Power-Down-Zustand versetzt und anschliessend neu startet.
	Dieser Reset zwingt den Chip, den ausgewählten Kanal neu zu initialisieren und eine frische Wandlung durchzuführen, bevor \texttt{DRDY} das nächste Mal \texttt{LOW} wird.

	\begin{verbatim}
	int32_t readChannel(int ch) {
	    setChannel(ch);
	    if (ch == 1 && digitalRead(PIN_DRDY_DOUT) == LOW) {
	        digitalWrite(PIN_PDWN, LOW);
	        delayMicroseconds(500);
	        digitalWrite(PIN_PDWN, HIGH);
	    }
	    return readADS1234();
	}
	\end{verbatim}

	\subsubsection{Kalibrierung}

	Die Kalibrierung läuft in drei aufeinanderfolgenden Schritten ab und wird einmalig beim Start der Firmware über die serielle Schnittstelle ausgelöst.
	Alle Messwerte sind Mittelwerte aus \texttt{CAL\_SAMPLES}~=~5 Wandlungen pro Kanal, was bei 10~SPS einer Messzeit von rund 0,4~Sekunden pro Kanal entspricht.

	\paragraph{Schritt 1 -- Nullpunkt (Zero Offset)}
	Die Waage wird vollständig entlastet und für jeden der vier Kanäle ein gemittelter Rohwert erfasst, der als Nullpunkt \texttt{zeroOffset[ch]} gespeichert wird.
	Dieser Wert kompensiert thermische und mechanische Vorlast der Wägezellen sowie Offset-Fehler des ADC.

	\paragraph{Schritt 2 -- Empfindlichkeit (Span)}
	Ein bekanntes Kalibriergewicht von \SI{3000}{\gram} wird mittig auf die Waagplattform gelegt.
	Für jeden Kanal wird die Abweichung vom Nullpunkt berechnet:
	\begin{equation}
		\Delta_i = \overline{x}_i - \text{zeroOffset}_i
	\end{equation}
	Die vier Wägezellen sind in X-Formation an den Ecken der Plattform angebracht.
	Bei dieser Anordnung werden die zwei diagonal gegenüberliegenden Zellen beim Belasten auf Zug, die anderen zwei auf Druck beansprucht, was zu einem mechanisch bedingten Vorzeichenwechsel im ADC-Signal führt.
	Das Vorzeichen von $\Delta_i$ wird daher pro Kanal automatisch erfasst und als \texttt{channelSign} gespeichert.
	Der initiale Skalierungsfaktor ergibt sich aus der Gesamtauslenkung über alle vier Kanäle:
	\begin{equation}
		s_{\text{init}} = \frac{m_{\text{cal}}}{\sum_{i=1}^{4} |\Delta_i|}
		\qquad \Rightarrow \qquad
		\text{spanFactor}_i = \text{channelSign}_i \cdot s_{\text{init}}
	\end{equation}
	Damit trägt jeder Kanal anteilig zur Gesamtmasse bei, wobei die Polarität korrekt berücksichtigt wird.

	\paragraph{Schritt 3 -- Ecklastkompensation (Corner Trim)}
	Bei einer Plattformwaage mit vier Wägezellen in den Ecken führen fertigungsbedingte Toleranzen der Sensoren dazu, dass ein exzentrisch aufgelegtes Gewicht -- je nach Position -- unterschiedliche Gesamtmassen anzeigt.
	Um dies zu kompensieren, wird das Kalibriergewicht nacheinander über jede der vier Ecken gestellt.

	Bei jeder Eckenbelastung ermittelt die Software denjenigen Kanal mit der grössten absoluten Auslenkung (\emph{dominanter Kanal}), da dieser am stärksten von der Lastposition beeinflusst wird.
	Die aktuelle Gesamtanzeige $m_{\text{meas}}$ ergibt sich aus den Beiträgen aller vier Kanäle:
	\begin{equation}
		m_{\text{meas}} = \sum_{i=1}^{4} \text{spanFactor}_i \cdot \Delta_i
	\end{equation}
	Der Skalierungsfaktor des dominanten Kanals~$d$ wird anschliessend so angepasst, dass die Anzeige exakt dem Kalibriergewicht entspricht, während die Faktoren der übrigen Kanäle unverändert bleiben:
	\begin{equation}
		\text{spanFactor}_d = \frac{m_{\text{cal}} - \sum_{i \neq d} \text{spanFactor}_i \cdot \Delta_i}{\Delta_d}
	\end{equation}
	Ein einziger Durchlauf über alle vier Ecken ist für typische DMS-Toleranzen von unter 5\,\% ausreichend.

	\paragraph{Gewichtsberechnung im Betrieb}
	Nach abgeschlossener Kalibrierung berechnet sich die angezeigte Masse in jedem Messtakt als:
	\begin{equation}
		m = \sum_{i=1}^{4} \text{spanFactor}_i \cdot \bigl(\text{raw}_i - \text{zeroOffset}_i\bigr)
	\end{equation}

	 \subsection{Messreihe Messgenauigkeit}

	Zur Beurteilung der Messgenauigkeit wurden an sechs Messpositionen (vier Ecken sowie die Mitte der Wägefläche) jeweils 5 aufeinanderfolgende Messwerte aufgezeichnet.
	Die Ergebnisse sind in Tabelle~\ref{tab:messreihe} zusammengefasst.

	\begin{table}[h]
		\centering
		\begin{tabular}{llrrr}
			\toprule
			\textbf{Position} & \textbf{Referenz} & \textbf{Messwerte (g)} & \textbf{Mittelwert (g)} & \textbf{Abweichung (g)} \\
			\midrule
			Ecke 1  & 1000{,}0 g & 1020{,}5 -- 1020{,}7 & 1020{,}6 & $+$20{,}6 \\
			Ecke 2  & 1000{,}0 g & 975{,}4 -- 975{,}7  & 975{,}5  & $-$24{,}5 \\
			Ecke 3  & 1000{,}0 g & 996{,}6 -- 996{,}7  & 996{,}6  & $-$3{,}4  \\
			Ecke 4  & 1000{,}0 g & 999{,}9 -- 1000{,}2 & 1000{,}0 & $\pm$0{,}0 \\
			Mitte   & 1000{,}0 g & 1033{,}2 -- 1035{,}6 & 1035{,}1 & $+$35{,}1 \\
			Mitte   & 3000{,}0 g & 3205{,}6 -- 3205{,}8 & 3205{,}6 & $+$205{,}6 \\
			\bottomrule
		\end{tabular}
		\caption{Messreihe optimiertes Design: Messwerte an verschiedenen Positionen}
		\label{tab:messreihe}
	\end{table}

	\paragraph{Präzision vs. Genauigkeit.}
	Die Wiederholbarkeit der Messung ist durchgehend hoch: Die Streuung innerhalb jeder Messreihe beträgt lediglich ca.\ 0{,}1\,g bis 0{,}2\,g, was auf eine stabile und rauscharme Signalverarbeitung hinweist.
	Die absolute Genauigkeit hingegen weist erhebliche Abweichungen auf.
	Besonders auffällig ist die Mittenbelastung mit 3\,kg, bei der ein Messwert von rund 3206\,g statt 3000\,g ausgegeben wird -- eine Abweichung von über 6\,\%.

	\paragraph{Mechanische Einflüsse.}
	Neben der Kalibrierung tragen auch mechanische Unzulänglichkeiten des Prototyps zum Messfehler bei.
	Die vier Wägezellen sind nicht exakt symmetrisch verbaut, da die Waage mit Heisskleber fixiert wurde und dadurch geringfügig in der Horizontalen geneigt ist.
	Zusätzlich streift die Wägezelle an Ecke~4 leicht den Rand des 3D-gedruckten Gehäuses, was deren Messwert mechanisch beeinflusst.
	Diese Effekte erklären, weshalb die positionsabhängigen Abweichungen stark variieren und keine konsistente Offset-Korrektur durch einfache Nachkalibrierung möglich ist.

	\paragraph{Fehlende Transientunterdrückung.}
	Ein weiteres Problem tritt beim Aufbringen oder Abnehmen eines Gewichts auf: Während des Übergangs werden transiente Messwerte ausgelesen und ungefiltert an das Backend übermittelt.
	In einem Logistiksystem führt dies dazu, dass der erfasste Lagerbestand kurzzeitig falsche Werte annimmt und hin- und herspringt, bis sich die Waage wieder einschwingt.
	Eine softwareseitige Filterung -- etwa durch eine Schwellwertentscheidung auf Basis der zeitlichen Änderungsrate -- wäre notwendig, um stabile Messwerte zu gewährleisten, wurde im Rahmen dieser Arbeit jedoch nicht mehr umgesetzt.
	% ============================================================
	\section{Geräteübersicht}
	% ============================================================

	Abbildung~\ref{fig:vergleich-alt-neu} zeigt die beiden Prototypen nebeneinander: links die neue Waage (optimiertes Design, rosa Gehäuse) mit drei Bedientastern und verbesserter Elektronik, rechts die Ausgangslage aus der Vorgängerarbeit~\cite{vorgaengerarbeit} (schwarzes Gehäuse, ohne Bedienelemente).
	Beide Geräte verfügen über ein E-Paper-Display zur Statusanzeige.

	\begin{figure}[H]
		\centering
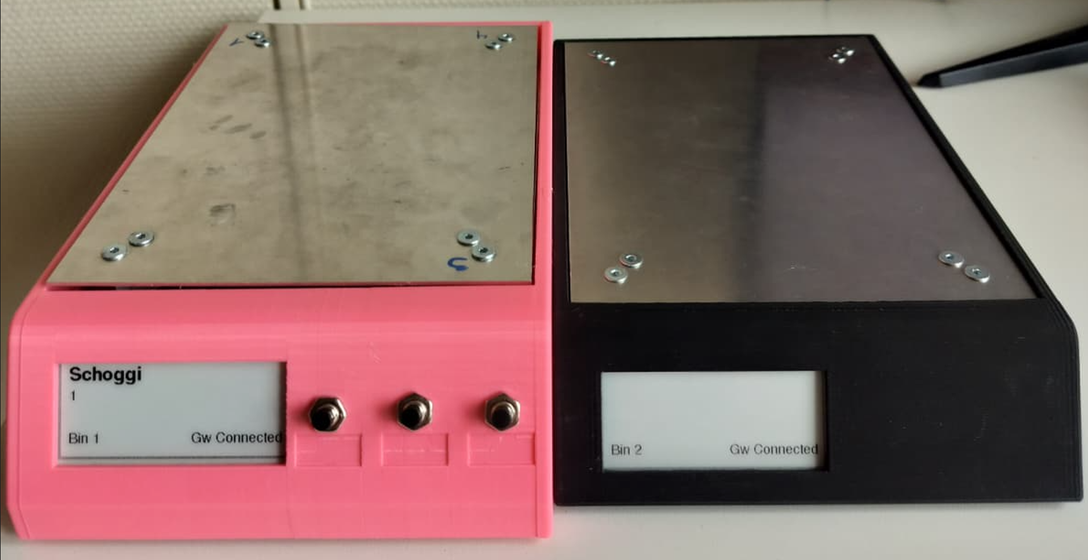
[picture p1: Doku/Images/Vergleich_alt_neu.png]
		
		\caption{Geräteübersicht: neue Waage (links, rosa) und Vorgängerprototyp (rechts, schwarz)}
		\label{fig:vergleich-alt-neu}
	\end{figure}

	% ============================================================
\section{PCB-Design}
% ============================================================

Das PCB-Layout und der vollständige Schaltplan sind im Anhang dokumentiert.
Dieses Kapitel beschreibt die wesentlichen Designentscheidungen sowie die im Rahmen der Arbeit
identifizierten Schwachstellen des realisierten Boards.

\paragraph{ADS1234}
Der Einsatz des ADS1234 hat sich als richtige Entscheidung erwiesen.
Dank seiner 24-Bit-Auflösung und vier unabhängigen Eingangskanälen ermöglicht er hochgenaue
Einzelkanalmessungen sowie die in Abschnitt~\ref{sec:kalibrierung} beschriebene
Ecklastkompensation.

\paragraph{ADS1234 -- Hardware-Filterung}
Im PCB wurde ein analoger Filterschaltkreis (RC-Tiefpass) vor den Differenzeingängen des ADS1234
vorgesehen, jedoch nicht bestückt und nicht weiter untersucht.
Die entsprechenden Bestückungsplätze wurden für den Betrieb mit Lötzinn überbrückt.

\paragraph{Temperatursensor SHT30}
Ein SHT30-Temperatursensor wurde in das PCB integriert, um temperaturbedingte Messfehler der
Wägezellen softwareseitig kompensieren zu können.
Die Hardwareanbindung (I\textsuperscript{2}C) ist vollständig implementiert; eine softwareseitige
Auswertung wurde im Rahmen dieser Arbeit nicht realisiert.

\paragraph{TPS62842 Buck-Converter}
Für das PCB wurde der TPS62842 als Schaltregler gewählt, um die Versorgungsspannung direkt auf die für den ESP32 benötigten \SI{3.0}{\volt} zu regeln -- in der Annahme, der LM2596S könne nicht unter \SI{5}{\volt} regeln.
Dass der TPS62842 mit einer maximalen Eingangsspannung von \SI{6.5}{\volt} für den direkten Betrieb an der Batterie (Nennspannung \SI{7.4}{\volt}, max.\ \SI{8.4}{\volt}) ungeeignet ist, war dabei bekannt und wäre in einer Folgerevision zu adressieren gewesen.
Der eigentliche Irrtum wurde erst gegen Ende der Arbeit erkannt: Der LM2596S kann die Ausgangsspannung durchaus auf \SI{3.0}{\volt} absenken -- der TPS62842 wäre damit überflüssig.
Die gravierendere, ebenfalls erst spät erkannte Schwäche ist die schlechte Effizienz des LM2596S bei Leichtlast, die massgeblich für den hohen Ruhestrom im Deep Sleep verantwortlich ist (vgl.\ Abschnitt~\ref{sub:Buck}).

\paragraph{Messpunkte (Power-Header)}
Auf dem PCB wurden 2$\times$1-Pin-Header als Strommess-Breakouts in die Versorgungspfade der
einzelnen Verbraucher eingeschleift.
Diese Messpunkte haben sich bei der Leistungsanalyse als äusserst
hilfreich erwiesen, da sie den direkten Anschluss des JouleScope ohne Unterbrechung der
Leiterbahnen ermöglichen.

	\section{Messungen}
	\subsection{Low-Power Analyse und Optimierung}

		\subsubsection{Reduktion Versorgungsspannung 3{,}3\,V auf 3{,}0\,V}\label{sec:spannungsreduktion}

		Da der ESP32 gemäss Datenblatt bei einer Versorgungsspannung von \SI{3.0}{\volt} bis \SI{3.6}{\volt} zuverlässig betrieben werden kann, wurde die Ausgangsspannung des Buck-Converters im neuen System von \SI{3.3}{\volt} auf \SI{3.0}{\volt} abgesenkt.
		Abbildung~\ref{fig:buck-3v3} und~\ref{fig:buck-3v} zeigen den am Buck-Converter-Ausgang gemessenen Energieverbrauch für einen vollständigen Aktivzyklus -- einmal mit \SI{3.3}{\volt} und einmal mit \SI{3.0}{\volt} Ausgangsspannung.

		\begin{figure}[H]
			\centering
			\begin{minipage}[t]{0.48\linewidth}
				\centering
				
				\caption{Messpunkt: nach Buck-Converter, Ausgang \SI{3.3}{\volt} -- neues System; Verbrauch: \SI{416.8}{\milli\joule}}
				\label{fig:buck-3v3}
			\end{minipage}
			\hfill
			\begin{minipage}[t]{0.48\linewidth}
				\centering
				
				\caption{Messpunkt: nach Buck-Converter, Ausgang \SI{3.0}{\volt} -- neues System; Verbrauch: \SI{343.4}{\milli\joule}}
				\label{fig:buck-3v}
			\end{minipage}
		\end{figure}

		Die Reduktion der Versorgungsspannung um \SI{0.3}{\volt} ergibt eine Energieeinsparung von \SI{73.4}{\milli\joule} pro Zyklus, was einer Verbesserung von \SI{17.6}{\percent} entspricht.
		Der Grund ist, dass der ESP32 bei niedrigerer Versorgungsspannung weniger Leistung aufnimmt.

		\subsubsection{Vergleich Energieverbrauch Aktiver Zyklus}

		\paragraph{ESP32 über 3V3-Pin}
		Der Messpunkt liegt direkt am 3V3-Versorgungspin des ESP32.
		In der Ausgangslage wird der ESP32 mit \SI{3.3}{\volt} gespeist, was dem Ausgang des internen Board-LDO entspricht.
		Im optimierten System entfällt der LDO; die Speisung erfolgt direkt über den 3V3-Pin mit \SI{3.0}{\volt}.

		\begin{figure}[H]
			\centering
			\begin{minipage}[t]{0.48\linewidth}
				\centering
				
				\caption{Messpunkt: vor ESP32 3V3-Pin -- Ausgangslage; Wert: \SI{2220}{\milli\joule}}
				\label{fig:esp32-3v3-alt}
			\end{minipage}
			\hfill
			\begin{minipage}[t]{0.48\linewidth}
				\centering
				
				\caption{Messpunkt: vor ESP32 3V3-Pin -- Optimiertes System; Wert: \SI{312.9}{\milli\joule}}
				\label{fig:esp32-3v3-neu}
			\end{minipage}
		\end{figure}

		\paragraph{Dehnmessstreifen}
		In der \textbf{Ausgangslage} sind die Wägezellen dauerhaft mit Spannung versorgt.
		Der gemessene Leistungsverbrauch von \SI{78.19}{\milli\watt} (Abb.~\ref{fig:deep-dms-alt}) ergibt über die aktive Zyklusdauer von \SI{10}{\second} einen Energiebedarf von:
		\[
			P_{\text{DMS}} \times t_{\text{aktiv}} = \SI{78.19}{\milli\watt} \times \SI{10}{\second} = \SI{781.9}{\milli\joule}
		\]

		Im \textbf{optimierten System} wird der DMS-Anteil indirekt als Differenz zweier Messungen am 3V3-Pin bestimmt -- einmal mit und einmal ohne eingeschaltete Dehnmessstreifen:
		\[
			E_{\text{DMS}} = E_{\text{mit DMS}} - E_{\text{ohne DMS}} = \SI{312.9}{\milli\joule} - \SI{223.8}{\milli\joule} = \SI{89.1}{\milli\joule}
		\]

		\begin{figure}[H]
			\centering
			\begin{minipage}[t]{0.48\linewidth}
				\centering
				
				\caption{Ganzer Zyklus \textbf{mit} DMS -- Optimiertes System; Wert: \SI{312.9}{\milli\joule}}
				\label{fig:dms-mitDMS}
			\end{minipage}
			\hfill
			\begin{minipage}[t]{0.48\linewidth}
				\centering
				
				\caption{Ganzer Zyklus \textbf{ohne} DMS -- Optimiertes System; Wert: \SI{223.8}{\milli\joule}}
				\label{fig:dms-ohneDMS}
			\end{minipage}
		\end{figure}

		\paragraph{ADC}
		Der Energiebedarf des ADC wird direkt am Versorgungspin des jeweiligen Chips gemessen.

		\begin{figure}[H]
			\centering
			\begin{minipage}[t]{0.48\linewidth}
				\centering
				
				\caption{Messpunkt: vor HX711 VIN-Pin -- Ausgangslage; Wert: \SI{106.2}{\milli\joule}}
				\label{fig:adc-alt}
			\end{minipage}
			\hfill
			\begin{minipage}[t]{0.48\linewidth}
				\centering
				
				\caption{Messpunkt: vor ADS1234 AVDD/DVDD-Pin -- Optimiertes System; Wert: \SI{13.42}{\milli\joule}}
				\label{fig:adc-neu}
			\end{minipage}
		\end{figure}

		\paragraph{Verluste Umwandlung}
		Die Verluste des LDO (Ausgangslage) sowie des Buck-Converters werden in den Abschnitten~\ref{par:ldo} und~\ref{sub:Buck} hergeleitet und in Tabelle~\ref{tab:sys-vergleich} übernommen.

		\subsubsection{Vergleich Energieverbrauch ESP32}\label{par:esp32}

		Dieser Abschnitt dokumentiert die JouleScope-Messungen am ESP32-3V3-Pin pro Betriebsphase (ohne DMS und LDO).
		Um Software- und Hardwareeinflüsse zu trennen, wurde das alte System für diesen Vergleich ebenfalls mit \SI{3{,}0}{\volt} am 3V3-Pin gespeist; die Gesamtsystemmessungen (Tabelle~\ref{tab:sys-vergleich}) verwenden hingegen die reale Systemkonfiguration (\SI{3{,}3}{\volt} im alten, \SI{3{,}0}{\volt} im neuen System).
		Da der ADS1234 am gleichen Rail angeschlossen ist, enthält jede Phasenmessung des neuen Systems
		dessen Anteil. Für den fairen Vergleich wird der gemessene ADS1234-Anteil von
		\SI{13.42}{\milli\joule} von allen Neu-Werten abgezogen; die bereinigten Werte entsprechen
		Tabelle~\ref{tab:sw-vergleich}.

		\paragraph{Boot und Ramp-up}
		\begin{figure}[H]
			\centering
			\begin{minipage}[t]{0.48\linewidth}
				\centering
				
				\caption{Boot -- Ausgangslage; \SI{360.3}{\milli\joule}}
				\label{fig:esp32-boot-alt}
			\end{minipage}
			\hfill
			\begin{minipage}[t]{0.48\linewidth}
				\centering
				
				\caption{Boot -- Optimiertes System; \SI{71.08}{\milli\joule}}
				\label{fig:esp32-boot-neu}
			\end{minipage}
		\end{figure}
		\[
			E_{\text{Boot, ber.}} = \SI{71.08}{\milli\joule} - \SI{13.42}{\milli\joule} = \SI{57.66}{\milli\joule}
		\]

		\paragraph{ADC-Messung}
		\begin{figure}[H]
			\centering
			\begin{minipage}[t]{0.48\linewidth}
				\centering
				
				\caption{ADC-Phase -- Ausgangslage; \SI{807.8}{\milli\joule}}
				\label{fig:esp32-adc-alt}
			\end{minipage}
			\hfill
			\begin{minipage}[t]{0.48\linewidth}
				\centering
				
				\caption{ADC-Phase -- Optimiertes System; \SI{50.83}{\milli\joule}}
				\label{fig:esp32-adc-neu}
			\end{minipage}
		\end{figure}
		\[
			E_{\text{ADC, ber.}} = \SI{50.83}{\milli\joule} - \SI{13.42}{\milli\joule} = \SI{37.41}{\milli\joule}
		\]

		\paragraph{BLE}
		\begin{figure}[H]
			\centering
			\begin{minipage}[t]{0.48\linewidth}
				\centering
				
				\caption{BLE-Phase -- Ausgangslage; \SI{1293}{\milli\joule}}
				\label{fig:esp32-ble-alt}
			\end{minipage}
			\hfill
			\begin{minipage}[t]{0.48\linewidth}
				\centering
				
				\caption{BLE-Phase -- Optimiertes System; \SI{101.6}{\milli\joule}}
				\label{fig:esp32-ble-neu}
			\end{minipage}
		\end{figure}
		\[
			E_{\text{BLE, ber.}} = \SI{101.6}{\milli\joule} - \SI{13.42}{\milli\joule} = \SI{88.18}{\milli\joule}
		\]

		\paragraph{ADS1234 Chip (nur neues System)}
		Im alten System befand sich der HX711 ausserhalb des Messpfades und wurde nicht separat erfasst.
		Im neuen System ist der ADS1234 am selben 3{,}0\,V-Rail angeschlossen; sein Gesamtanteil pro
		Zyklus wird separat über den AVDD/DVDD-Pin gemessen und als Korrekturterm von allen
		Phasenmessungen abgezogen.

		\begin{figure}[H]
			\centering
			
			\caption{ADS1234 Chip -- Optimiertes System; \SI{13.42}{\milli\joule}}
			\label{fig:esp32-adcchip-neu}
		\end{figure}

		\paragraph{Ganzer Zyklus}
		\begin{figure}[H]
			\centering
			\begin{minipage}[t]{0.48\linewidth}
				\centering
				
				\caption{Ganzer Zyklus -- Ausgangslage; \SI{1858}{\milli\joule}}
				\label{fig:esp32-zyklus-alt}
			\end{minipage}
			\hfill
			\begin{minipage}[t]{0.48\linewidth}
				\centering
				
				\caption{Ganzer Zyklus -- Optimiertes System; \SI{223.8}{\milli\joule}}
				\label{fig:esp32-zyklus-neu}
			\end{minipage}
		\end{figure}
		\[
			E_{\text{Zyklus, ber.}} = \SI{223.8}{\milli\joule} - \SI{13.42}{\milli\joule} = \SI{210.4}{\milli\joule}
		\]
		
		\subsubsection{Verluste Hardware}
		\paragraph{Buck-Converter}\label{sub:verluste-buck}

		Die Messungen erfassen jeweils die Energie \emph{vor} (Batterieseite) und \emph{nach}
		(Power-Rail) dem LM2596S-Schaltregler über einen vollständigen Zyklus.
		Die Herleitung des Wirkungsgrads sowie die Verlustberechnung finden sich in
		Abschnitt~\ref{sub:Buck}.

		\noindent\textit{Vor dem Buck-Converter (Batterieseite):}
		\begin{figure}[H]
			\centering
			\begin{minipage}[t]{0.48\linewidth}
				\centering
				
				\caption{Vor Buck-Converter -- Ausgangslage; \SI{6503}{\milli\joule}}
				\label{fig:buck-vor-alt}
			\end{minipage}
			\hfill
			\begin{minipage}[t]{0.48\linewidth}
				\centering
				
				\caption{Vor Buck-Converter -- Optimiertes System; \SI{689.5}{\milli\joule}}
				\label{fig:buck-vor-neu}
			\end{minipage}
		\end{figure}

		\noindent\textit{Nach dem Buck-Converter (Power-Rail):}
		\begin{figure}[H]
			\centering
			\begin{minipage}[t]{0.48\linewidth}
				\centering
				
				\caption{Nach Buck-Converter -- Ausgangslage; \SI{3548}{\milli\joule}}
				\label{fig:buck-nach-alt}
			\end{minipage}
			\hfill
			\begin{minipage}[t]{0.48\linewidth}
				\centering
				
				\caption{Nach Buck-Converter -- Optimiertes System; \SI{343.4}{\milli\joule}}
				\label{fig:buck-nach-neu}
			\end{minipage}
		\end{figure}

		\paragraph{LDO}\label{par:ldo}

		Der LDO ist ausschliesslich in der Ausgangslage relevant; das optimierte System speist
		den ESP32 direkt über den \texttt{3V3}-Pin ein und umgeht den LDO vollständig.

		\begin{figure}[H]
			\centering
			\begin{minipage}[t]{0.48\linewidth}
				\centering
				
				\caption{Vor LDO (VIN-Pin) -- Ausgangslage; \SI{3430}{\milli\joule}}
				\label{fig:ldo-vor-alt}
			\end{minipage}
			\hfill
			\begin{minipage}[t]{0.48\linewidth}
				\centering
				
				\caption{Nach LDO (3V3-Pin) -- Ausgangslage; \SI{2220}{\milli\joule}}
				\label{fig:ldo-nach-alt}
			\end{minipage}
		\end{figure}

		\subsubsection{Vergleich Leistungsverbrauch Deep-Sleep}\label{par:deep}

		\paragraph{Dehnmessstreifen}
		In der Ausgangslage sind die Wägezellen dauerhaft mit Spannung versorgt und verbrauchen auch im Tiefschlaf \SI{78.19}{\milli\watt}.
		Im optimierten System werden sie vor dem Deep Sleep über den MOSFET vollständig abgeschaltet; ihr Beitrag im Tiefschlaf entfällt damit ersatzlos.

		\begin{figure}[H]
			\centering
			\begin{minipage}[t]{0.48\linewidth}
				\centering
				
				\caption{Messpunkt: vor DMS -- Ausgangslage; \SI{78.19}{\milli\watt}}
				\label{fig:deep-dms-alt}
			\end{minipage}
			\hfill
			\begin{minipage}[t]{0.48\linewidth}
				\centering
				\vspace{1.5cm}
				\centering
				{\large $\rightarrow$ Entfällt}\\[0.4em]
				\small MOSFET schaltet Versorgung\\vor Deep Sleep ab.
			\end{minipage}
		\end{figure}

		\paragraph{ADC-Chip}
		Der ADS1234 verbraucht im Tiefschlaf \SI{9.762}{\milli\watt} in der Ausgangslage.
		Im optimierten System konnte dieser Wert auf \SI{4.042}{\milli\watt} gesenkt werden.
		Ein vollständiges Abschalten ist jedoch nicht möglich, da kein Hardware-Pull-down am \texttt{!PDWN}-Pin verbaut ist und der GPIO im Deep Sleep floaten kann.

		\begin{figure}[H]
			\centering
			\begin{minipage}[t]{0.48\linewidth}
				\centering
				
				\caption{ADC-Chip im Deep Sleep -- Ausgangslage (HX711); \SI{9.762}{\milli\watt}}
				\label{fig:deep-adc-alt}
			\end{minipage}
			\hfill
			\begin{minipage}[t]{0.48\linewidth}
				\centering
				
				\caption{ADC-Chip im Deep Sleep -- Optimiertes System (ADS1234); \SI{4.042}{\milli\watt}}
				\label{fig:deep-adc-neu}
			\end{minipage}
		\end{figure}

		\paragraph{Vor Buck-Converter (Gesamtsystem im Deep Sleep)}
		Die Messungen vor dem Buck-Converter erfassen den vollständigen Ruhestrom des Systems auf Batterieebene -- einschliesslich aller Buck-Converter-Verluste.

		\begin{figure}[H]
			\centering
			\begin{minipage}[t]{0.48\linewidth}
				\centering
				
				\caption{Vor Buck-Converter im Deep Sleep -- Ausgangslage; \SI{268.2}{\milli\watt}}
				\label{fig:deep-vorbuck-alt}
			\end{minipage}
			\hfill
			\begin{minipage}[t]{0.48\linewidth}
				\centering
				
				\caption{Vor Buck-Converter im Deep Sleep -- Optimiertes System; \SI{90.96}{\milli\watt}}
				\label{fig:deep-vorbuck-neu}
			\end{minipage}
		\end{figure}

		\paragraph{Buck-Converter Leerlaufverlust}
		Abbildung~\ref{fig:deep-leerlauf-buck} zeigt den Eigenverbrauch des LM2596S ohne angeschlossene Last.
		Mit \SI{69.77}{\milli\watt} übersteigt dieser Leerlaufverlust bereits den Gesamtverbrauch aller Verbraucher des neuen Systems (\SI{14.19}{\milli\watt}) um das Fünffache.

		\begin{figure}[H]
			\centering
			
			\caption{LM2596S Leerlaufverlust (kein Verbraucher angeschlossen); \SI{69.77}{\milli\watt}}
			\label{fig:deep-leerlauf-buck}
		\end{figure}

	% ============================================================

	\section{Fazit, Diskussion und Ausblick}
	% ============================================================

	\subsection{Fazit}

	Diese Arbeit hatte zwei Schwerpunkte: die Optimierung des Energieverbrauchs und die Verbesserung der Messgenauigkeit einer ESP32-basierten Smart-Waage für die industrielle Inventarisierung.

	\paragraph{Energieoptimierung.}
	Durch den kombinierten Einsatz von Hardware- und Softwaremassnahmen konnte der Energieverbrauch pro Aktivzyklus von \SI{6503}{\milli\joule} auf \SI{689.5}{\milli\joule} gesenkt werden, was einer Reduktion von \textbf{89{,}4\,\%} entspricht.
	Die wirkungsvollsten Einzelmassnahmen waren der Entfall des internen Board-LDOs durch direkte Einspeisung über den \texttt{3V3}-Pin (\SI{1210}{\milli\joule} gespart) sowie die Migration des BLE-Stacks von der Arduino-BLE-Bibliothek auf NimbleBLE, welche die Aktivzeit der Funkphase erheblich verkürzte.
	Die MOSFET-Abschaltung der Dehnmessstreifen im Tiefschlaf sowie die Reduktion der Buck-Converter-Ausgangsspannung von \SI{3.3}{\volt} auf \SI{3.0}{\volt} leisteten weitere messbare Beiträge.
	Auf Batterieebene steigt die Laufzeit gegenüber der Ausgangslage von ca.\ \textbf{3\,Tagen} auf ca.\ \textbf{12\,Tagen} -- eine Verbesserung um den Faktor~4 (vgl.\ Tabelle~\ref{tab:batterielaufzeit}).

	\paragraph{Messgenauigkeit.}
	Der Wechsel von einem summierten Einzelkanal auf vier individuelle ADS1234-Kanäle mit separater Kalibrierung pro Sensor ermöglicht erstmals eine Ecklastkompensation.
	Die Wiederholbarkeit der Messung ist mit $\pm$\,0{,}1\,g gut; die absolute Genauigkeit ist jedoch aufgrund einer unzureichenden Kalibrierung und mechanischer Mängel des Prototypen eingeschränkt -- bei Mittenbelastung mit \SI{3}{\kilogram} wurden bis zu \SI{+205}{\gram} Abweichung gemessen.

	\subsection{Kritische Beurteilung}

	Trotz der erzielten Fortschritte weist das System eine Reihe fundamentaler Schwächen auf, die einer praxistauglichen Umsetzung entgegenstehen.

	\paragraph{Entwicklungsboard und Sleep-Strom.}
	Die Entscheidung, das SBC-NodeMCU-ESP32-C-Entwicklungsboard beizubehalten, war pragmatisch, erweist sich aber als grösste Limitierung des Systems.
	Das Board verbraucht im Deep Sleep ca.\ \SI{13.75}{\milli\ampere} am 3{,}3\,V-Rail -- massgeblich verursacht durch den dauernd aktiven CP2102-USB-UART-Chip, den internen LDO und die Power-LED, die auch im Tiefschlaf nicht abgeschaltet werden können.
	Zum Vergleich: das nRF52840 erreicht im System-OFF-Modus \SI{0.4}{\micro\ampere} -- einen um den Faktor \textbf{34\,000} niedrigeren Ruhestrom.
	Die Folge ist, dass der Sleep-Strom die Energiebilanz vollständig dominiert: Die berechnete Batterielaufzeit ist nahezu unabhängig vom Messintervall (12--13 Tage bei 1\,min bis 30\,min Intervall), was den Nutzen längerer Schlafphasen zunichtemacht.
	In einem realen Logistiksystem, das auf Batterie läuft, macht dieses Board das Produkt in der vorliegenden Form \textbf{nicht industrietauglich}.

	\paragraph{ADC-Ruhestrom durch fehlenden Pull-down.}
	Der \texttt{!PDWN}-Pin des ADS1234 wird im Deep Sleep nicht durch einen Hardware-Pull-down auf \texttt{LOW} gehalten.
	Da der GPIO im unkonfigurierten Zustand floaten oder auf \texttt{HIGH} gezogen sein kann, bleibt der ADC möglicherweise aktiv und verbraucht unnötig ca.\ \SI{1}{\milli\ampere} im Schlaf.
	Dieser Fehler hätte mit einem einzigen Pull-down-Widerstand auf der Platine behoben werden können.

	\paragraph{Ineffizienter Buck-Converter.}
	Der eingesetzte LM2596S ist für den vorliegenden Anwendungsfall ungeeignet.
	Sein Leerlaufverbrauch beträgt \SI{69.77}{\milli\watt} -- fast fünfmal so viel wie der Gesamtverbrauch des neuen Systems im Tiefschlaf (\SI{14.19}{\milli\watt}).
	Bei der im Tiefschlaf anliegenden Teillast sinkt der Wirkungsgrad auf unter 50\,\%, was bedeutet, dass mehr Energie im Schaltregler verheizt als an die Last geliefert wird.
	Dieser Umstand wurde erst spät im Projektverlauf erkannt und konnte nicht mehr behoben werden.
	In Kombination mit dem hohen Board-Sleep-Strom ist der LM2596S der zweitgrösste Energiefresser des Systems.
	Hinzu kommt, dass keine geeignete Kombination aus effizientem Schaltregler und passendem Akku-Setup evaluiert werden konnte; die in Abschnitt~\ref{sec:gesamtverbrauch} berechnete Batterielaufzeit basiert daher auf dem vorhandenen, ineffizienten LM2596S und ist nicht repräsentativ für eine optimierte Hardwarekonfiguration.

	\paragraph{Nicht evaluierte Muss-Ziele.}
	Zwei Muss-Ziele gemäss Projektvereinbarung wurden nicht erfüllt.
	Die Evaluation der Energiequelle (Batterie vs.\ Akku) wurde vernachlässigt; eine strukturierte Gegenüberstellung unter realistischen Lastprofilen hätte die Laufzeitberechnung auf eine solidere Grundlage gestellt.
	Die Evaluation des Kommunikationsprotokolls ESP-NOW wurde bewusst nicht durchgeführt: Da eine professionelle Waage langfristig auf ein energieeffizientes Custom-PCB mit einem nRF-Chip migriert werden sollte -- wie im Ausblick beschrieben -- und ESP-NOW auf nRF-Chips nicht verfügbar ist, wäre eine Implementierung auf dem ESP32 eine sackgassenartige Optimierung ohne Zukunft.

	\paragraph{Messgenauigkeit.}
	Die aktuelle Kalibrierung genügt nicht für den produktiven Einsatz.
	Die positionsabhängigen Abweichungen (bis $-24{,}5$\,g an Ecke~2 und $+35$\,g bei Mittenbelastung mit \SI{1}{\kilogram}) sowie die stark ausgeprägte Überschätzung bei \SI{3}{\kilogram} zeigen, dass die Kalibrierstrategie und die mechanische Ausführung des Prototypen überarbeitet werden müssen.
	Zudem fehlt eine Transientunterdrückung: Beim Aufbringen oder Abnehmen von Gewicht werden instabile Messwerte ungefiltert ans Backend übermittelt, was im Logistiksystem zu Bestandsschwankungen führt.

	\subsection{Ausblick}

	Die vorliegende Arbeit legt eine solide Grundlage, lässt aber klare Ansatzpunkte für folgende Arbeiten offen.

	\paragraph{Plattformwechsel.}
	Der wirkungsvollste einzelne Schritt wäre der Wechsel auf eine Hardware-Plattform mit minimalem Sleep-Strom.
	Das nRF52840 wäre mit \SI{0.4}{\micro\ampere} System-OFF-Strom ideal; alternativ bietet der ESP32-C3 mit \SI{5}{\micro\ampere} Deep-Sleep auf einem schlanken Custom-Board einen guten Kompromiss bei geringerem Portierungsaufwand.

	\paragraph{Buck-Converter und Energiequelle.}
	Der LM2596S muss durch einen modernen Schaltregler mit niedrigem Quiescent-Strom und Leichtlast-Optimierung (z.\,B.\ PFM-Modus) ersetzt werden; die konkrete Bauteilwahl muss mit dem endgültigen Akku-Setup (Zellanzahl, Spannungsbereich) abgestimmt werden.
	Parallel dazu sollte eine strukturierte Evaluation der Energiequelle (Lithium-Polymer-Akku vs.\ Primärzelle) unter realistischen Zyklusbedingungen durchgeführt werden.

	\paragraph{ADC-Abschaltung.}
	Ein Hardware-Pull-down-Widerstand auf dem \texttt{!PDWN}-Pin des ADS1234 stellt sicher, dass der ADC im Deep Sleep vollständig abgeschaltet ist und keine unnötigen \SI{1}{\milli\ampere} verbraucht.

	\paragraph{Messgenauigkeit und Mechanik.}
	Eine überarbeitete Kalibrierung -- idealerweise mit positionsabhängiger Gewichtung der vier Kanäle -- sowie eine präzisere, formschlüssige Montage der Wägezellen im Gehäuse würden die Absolutgenauigkeit erheblich verbessern.
	Eine softwareseitige Transientenfilterung (z.\,B.\ Schwellwertentscheidung auf der zeitlichen Änderungsrate) sollte implementiert werden, um stabile Messwerte an das Backend zu liefern.
	Längerfristig wäre eine Temperaturkompensation der Dehnmessstreifen sinnvoll, da die YZC-133-Zellen temperaturbedingte Drifts aufweisen können.

	\paragraph{Weg zum Produkt.}
	Für eine produktionsreife Version sind ein massenproduktionstaugliches PCB-Layout, ein robustes Gehäusedesign sowie eine Ende-zu-Ende-Validierung unter realen Logistikbedingungen notwendig.
	Die in dieser Arbeit erzielten Software-Optimierungen und das ADS1234-Kanalkonzept stellen dabei eine wiederverwendbare Basis dar.

	\bibliographystyle{plain}
	\bibliography{quellen}

	% ============================================================
	\appendix
	\section{PCB Schaltplan}\label{sec:anhang-pcb}
	% ============================================================

	\begin{landscape}
		\begin{figure}[H]
			\centering
			
			\caption{PCB Schaltplan -- Seite 1}
			\label{fig:anhang-schaltplan-1}
		\end{figure}
	\end{landscape}

	\begin{landscape}
		\begin{figure}[H]
			\centering
			
			\caption{PCB Schaltplan -- Seite 2}
			\label{fig:anhang-schaltplan-2}
		\end{figure}
	\end{landscape}

	\section{Projektvereinbarung}\label{sec:anhang-vereinbarung}

	\includepdf[pages=-]{Images/BA26_brnn_241-Vereinbarung_signed}

	\section{Quellcode}\label{sec:anhang-quellcode}

	Der vollständige Quellcode dieser Arbeit ist öffentlich auf GitHub verfügbar:

	\medskip
	\noindent\url{https://github.com/Newtonsohn/BA-Smart-Waage}
	\medskip

	\noindent Das Repository enthält die Firmware des ESP32 (PlatformIO/Arduino-Framework), die Mess- und Auswertungsskripte sowie die LaTeX-Quelldateien dieser Dokumentation.

\end{document}
