Newtonsohn/BA-Smart-Waage/Doku/BA_Doku.pdf

School of Engineering

### Institute of Embedded Systems (InES)

### Bachelorarbeit Studiengang Elektrotechnik

# Entwicklung einer Smart-Waage mit offener Schnittstelle für die Industrie 4.0

Autor:innen | Thomas Lino Rocheteau
Hauptbetreuung | Kilian Brunner
Datum | 05.06.2026

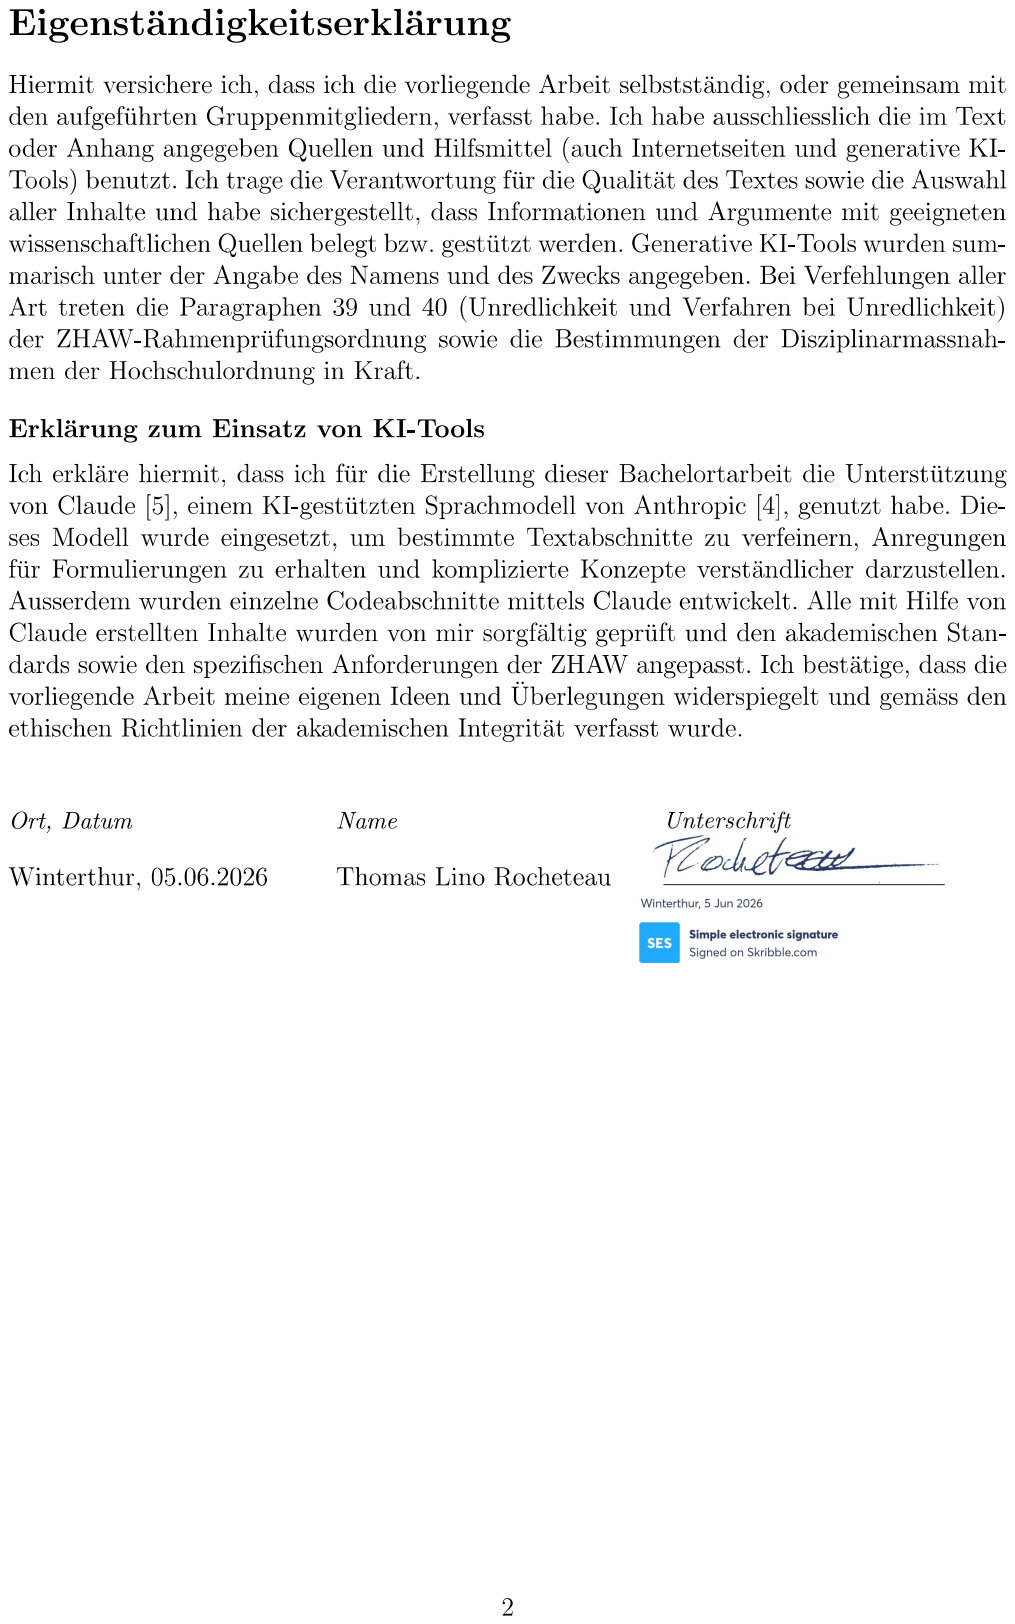
[picture p2: page 2]

## Abstract

English

This thesis advances a previously developed ESP32-based smart scale prototype for industrial parts and bulk-goods inventory management. Two aspects are addressed in depth: measurement accuracy and energy efficiency.
For measurement accuracy, the four YZC-133 load cells are each connected to a dedicated channel of the ADS1234 24-bit ADC with a PGA gain of 128 and a data rate of 10 SPS. Individual per-sensor calibration enables corner-load compensation, which was not possible with the single summed channel of the predecessor. Measurements confirm a repeatability of ± 0.1 g, though absolute accuracy is limited by mechanical imperfections of the prototype.
For energy efficiency, three hardware measures were implemented: the load-cell supply is interrupted via MOSFET before entering deep sleep; the ESP32 is powered directly through the 3V3 pin, eliminating the on-board LDO; and the buck-converter output voltage was reduced from 3.3 V to 3.0 V, saving an additional 73.4 mJ per cycle (−17.6 %). Combined with software-level optimisations including the migration from the Arduino BLE stack to NimbleBLE, the active-cycle energy consumption is reduced from 6503 mJ to 689.5 mJ, a reduction of 89.4 %. A custom PCB was designed to consolidate the power path; a component selection error in the buck converter prevents its immediate use in the current revision.

Deutsch

Diese Bachelorarbeit baut auf einem bestehenden ESP32-basierten Smart-Waagen-Prototyp
fur die industrielle Inventarisierung von Kleinteilen und Sch ¨ | uttgut auf und vertieft zwei ¨
Schwerpunkte: Messgenauigkeit und Energieeffizienz.
Zur Verbesserung der Messgenauigkeit wird jede der vier YZC-133-Wägezellen einzeln an einen dedizierten Kanal des ADS1234 (24-Bit-ADC, PGA-Faktor 128, 10 SPS) angeschlossen. Die individuelle Kalibrierung pro Sensor ermöglicht eine Ecklastkompensation, die mit dem summierten Einzelkanalansatz der Vorgängerarbeit nicht realisierbar war. Die Messungen zeigen eine Wiederholbarkeit von ± 0,1 g; die Absolutgenauigkeit ist durch mechanische Unzulänglichkeiten des Prototyps eingeschränkt.
Fur die Energieoptimierung wurden drei Hardwaremassnahmen umgesetzt: Die W ¨ | ägezellen
werden uber einen MOSFET vor dem Deep-Sleep abgeschaltet; der ESP32 wird direkt ¨
uber den 3V3-Pin versorgt, womit der interne Board-LDO entf ¨ | ällt; die Ausgangsspan-
nung des Buck-Converters wurde von 3,3 V auf 3,0 V abgesenkt, was eine zusätzliche Einsparung von 73,4 mJ pro Zyklus (−17,6 %) erzielt. In Kombination mit Softwareoptimierungen – darunter die Migration vom Arduino-BLE-Stack auf NimbleBLE – sinkt der Energieverbrauch pro Aktivzyklus von 6503 mJ auf 689,5 mJ, eine Reduktion um 89,4 %. Ein eigens entwickeltes PCB wurde zur Konsolidierung des Strompfads ausgelegt; ein Fehler bei der Schaltreglerwahl verhindert dessen unmittelbaren Einsatz in der vorliegenden Revision.

## Inhaltsverzeichnis

1 Einleitung | 6
2 Technische Ausgangslage | 8
2.1.1 | MCU-Auswahl: SBC-NodeMCU-ESP32-C vs. ESP32-C3 vs. nRF52840 8
3 Low-Power Optimierung | 8
3.4 Ubersicht Zyklus | ¨ | 10
3.6.1 | Ubersicht Stromverlauf ESP32 | ¨ | 11
4 Optimierung Messgenauigkeit | 18
4.2.1 | Uberblick | ¨ | 19
5 Geräteubersicht | 22 ¨
6 PCB-Design | 23

7 Messungen | 24
8 Fazit, Diskussion und Ausblick | 31
A PCB Schaltplan | 34
B Projektvereinbarung | 37
C Quellcode | 51

## 1 Einleitung

Die zunehmende Vernetzung industrieller Prozesse stellt neue Anforderungen an eingebettete Systeme – insbesondere hinsichtlich Energieeffizienz, Messgenauigkeit und Kommunikationszuverlässigkeit. Diese Arbeit baut auf einem bestehenden Proof of Concept [4] auf und vertieft dessen technische Grundlagen mit Fokus auf die Weiterentwicklung der Smart-Waage selbst.

### 1.1 Ausgangslage

Ausgangslage fur diese Arbeit bildet die Firma Skysec GmbH, ein Startup, das sich auf die ¨ Herstellung von Drohnen zum Schutz von Einrichtungen spezialisiert hat. Fur den Her- ¨ stellungsprozess, insbesondere die Inventarisierung von Kleinteilen und Schuttgut, sollen ¨ intelligente Waagen (Smart-Bins) eingesetzt werden. Bestehende kommerzielle Lösungen – etwa von Bossard – sind an proprietäre Cloud-Plattformen gebunden und erlauben keine eigenständige Datenhoheit, was fur den Industriepartner aufgrund seiner sicherheitskriti- ¨ schen Tätigkeit nicht akzeptabel ist.
Im Rahmen der vorangegangenen Bachelorarbeit [4] (Berger & Muller, BA FS25) wur- ¨ de bereits ein funktionsfähiger Prototyp entwickelt: ein ESP32-basiertes Wägesystem mit BLE-Kommunikation, einem Raspberry-Pi-Gateway und einem containerisierten ASP.NET-Core-Backend. Die vorliegende Arbeit knupft an diesen PoC an und setzt den Schwerpunkt ¨ auf die Optimierung der Waage selbst – mit Fokus auf Messgenauigkeit und Energieverbrauch.

### 1.2 Zielsetzung

Die Zielsetzung gliedert sich in funktionale und organisatorische Ziele gemäss der Projektvereinbarung [8].

Tabelle 1: Funktionale Ziele gemäss Vereinbarung
Funktionales Ziel | Muss Soll Optional
Evaluation Hardware-Plattformen (ESP32, STM32, Arduino, Raspberry) | ×
Evaluation Kommunikationsprotokoll (BLE, ESP- NOW) | ×
Analyse Leistungsbedarf und Evaluation von Lei- stungssparmassnahmen | ×
Interface mit der Waage (Tara, Stuckzahl, Gewicht, ¨ Einheitenumrechner) | ×
Power-Optimierung: Reduktion Aktiv- und Ruhe- ströme | ×
Evaluation Energiequelle (Batterie vs. Akku) | ×
Temperaturkorrektur der Dehnmessstreifen | ×
Massenproduktionstaugliches PCB | ×
Umporten auf STM32 | ×
Umbau auf Batteriebetrieb | ×

Tabelle 2: Organisatorische Ziele gemäss Vereinbarung
Organisatorisches Ziel | Muss Soll
Erstellung eines Projektplans | ×
Beschaffung der benötigten Hardware | ×
Einhaltung des Abgabetermins | ×
Einhaltung der Meilensteine | ×

### 1.3 Systemabgrenzung und Randbedingungen

Folgende Bereiche sind explizit nicht Bestandteil dieser Arbeit:

On-Premise-Lösung (keine Cloud-Anbindung)

Dynamisches Softwareupdate (OTA)

Einbindung in Firmennetzwerk

Fertiges Produkt (Prototyp-Status)

Verschlusselte ¨ | Ubermittlung der Sensordaten an das Gateway ¨

Weiterentwicklung des bestehenden Backends

Randbedingungen:

Arbeitsplätze im Raum TE514 / TE516 sowie Messgeräte, Lötstation und Industrienetzgerät stehen bereit.

Der Projektstand wird regelmässig mit dem Betreuer besprochen.

Der Quellcode wird auf GitHub gehostet.

### 1.4 Meilensteine

1. Hardware-Entwicklung: Evaluation alternativer Plattformen; Redesign des Strompfads fur Low-Power-Betrieb. ¨
2. Quality of Life: Implementierung von Bedienelementen (Taster) sowie Software-Funktionen (Tara, Kalibrierung, Einheitenumrechner).
3. Kommunikationsprotokolle: Evaluation und Implementierung von ESP-NOW vs. BLE (NimbleBLE).

### 1.5 Aufbau der Arbeit

Die Arbeit ist in folgende Kapitel gegliedert: Kapitel 2 beschreibt die technische Ausgangslage und die getroffenen Designentscheidungen. In Kapitel 3 werden die Low-Power-Optimierungen erläutert – von der Hardwareanpassung bis zur Strommessung. Kapitel 4 behandelt die Optimierung der Messgenauigkeit, einschliesslich Sensorik, ADC-Ansteuerung und Kalibrierung. Eine Geräteubersicht beider Prototypen ist in Kapitel 5 ¨ dargestellt. Das PCB-Design ist in Kapitel 6 dokumentiert. Kapitel 7 fasst die Messungen zusammen, und Kapitel 8 schliesst mit Fazit und Ausblick.

## 2 Technische Ausgangslage

### 2.1 Design Space Exploration

### 2.1.1 MCU-Auswahl: SBC-NodeMCU-ESP32-C vs. ESP32-C3 vs. nRF52840

Fur die Wahl des Mikrocontrollers wurden drei Kandidaten verglichen. Die wesentlichen ¨ Stromverbrauchswerte sind in Tabelle 3 gegenubergestellt. ¨

MCU | Aktiv (mit RF) Light Sleep Deep Sleep
SBC-NodeMCU-ESP32-C (Board)† | 160 mA – 240 mA | ∼5 mA | ∼4 mA
ESP32-C3 (SoC) | 100 mA – 335 mA | 130 µA | 5 µA
nRF52840 (SoC) | ∼16 mA | 1.5 µA | 0.4 µA

Tabelle 3: Stromverbrauch der MCU-Kandidaten [6, 1, 5, 7]. † Board-Werte inkl. CP2102, LDO und Power-LED; ESP32-C3 und nRF52840 beziehen sich auf den SoC-Chip allein.

Das nRF52840 ist energetisch am effizientesten, erfordert jedoch ein vollständiges Porting der bestehenden Software sowie eine neue Peripherieschaltung. Der ESP32-C3 bietet auf SoC-Ebene einen deutlich besseren Sleep-Strom als das SBC-Entwicklungsboard und wäre mit moderatem Aufwand adaptierbar, benötigt aber ebenfalls eine eigene Peripheriebeschaltung. Da die Vorgängerarbeit [4] bereits auf dem SBC-NodeMCU-ESP32-C basiert, kann dessen bestehende Hardware- und Softwarebasis direkt ubernommen werden, ohne ¨ eine Peripherieschaltung neu auslegen zu mussen. Angesichts des erheblichen Einsparpo- ¨ tenzials auf Seiten der DMS-Signalkette und der Software fiel die Entscheidung daher auf den SBC-NodeMCU-ESP32-C, um den Entwicklungsaufwand zu minimieren und den Fokus auf die relevanten Optimierungen zu legen. Der hohe Sleep-Strom des Boards – verursacht durch CP2102, Board-LDO und Power-LED – wurde dabei als bekannte Einschränkung in Kauf genommen.

## 3 Low-Power Optimierung

### 3.1 Motivation

Die Waage ist fur den Einsatz in der Intralogistik konzipiert, wo sie autonom und ohne re- ¨
gelmässige Wartung den Fullstand von Lagerbeh ¨ | ältern uberwacht. In diesem Umfeld ist ¨
eine möglichst lange Batterielaufzeit entscheidend: Jeder Akkuwechsel verursacht Wartungsaufwand, der bei einer grossen Anzahl verteilter Geräte erhebliche Betriebskosten erzeugen kann.
Da die Vorgängerarbeit ihren Schwerpunkt auf die funktionale Korrektheit des Systems legte, wurde die Optimierung des Stromverbrauchs bisher nicht adressiert. Das System bietet daher noch erhebliches Einsparpotenzial, das in dieser Arbeit systematisch erschlossen wird.

### 3.2 Strompfad Schema

Die folgenden Diagramme zeigen den Strompfad der alten und neuen Waage.

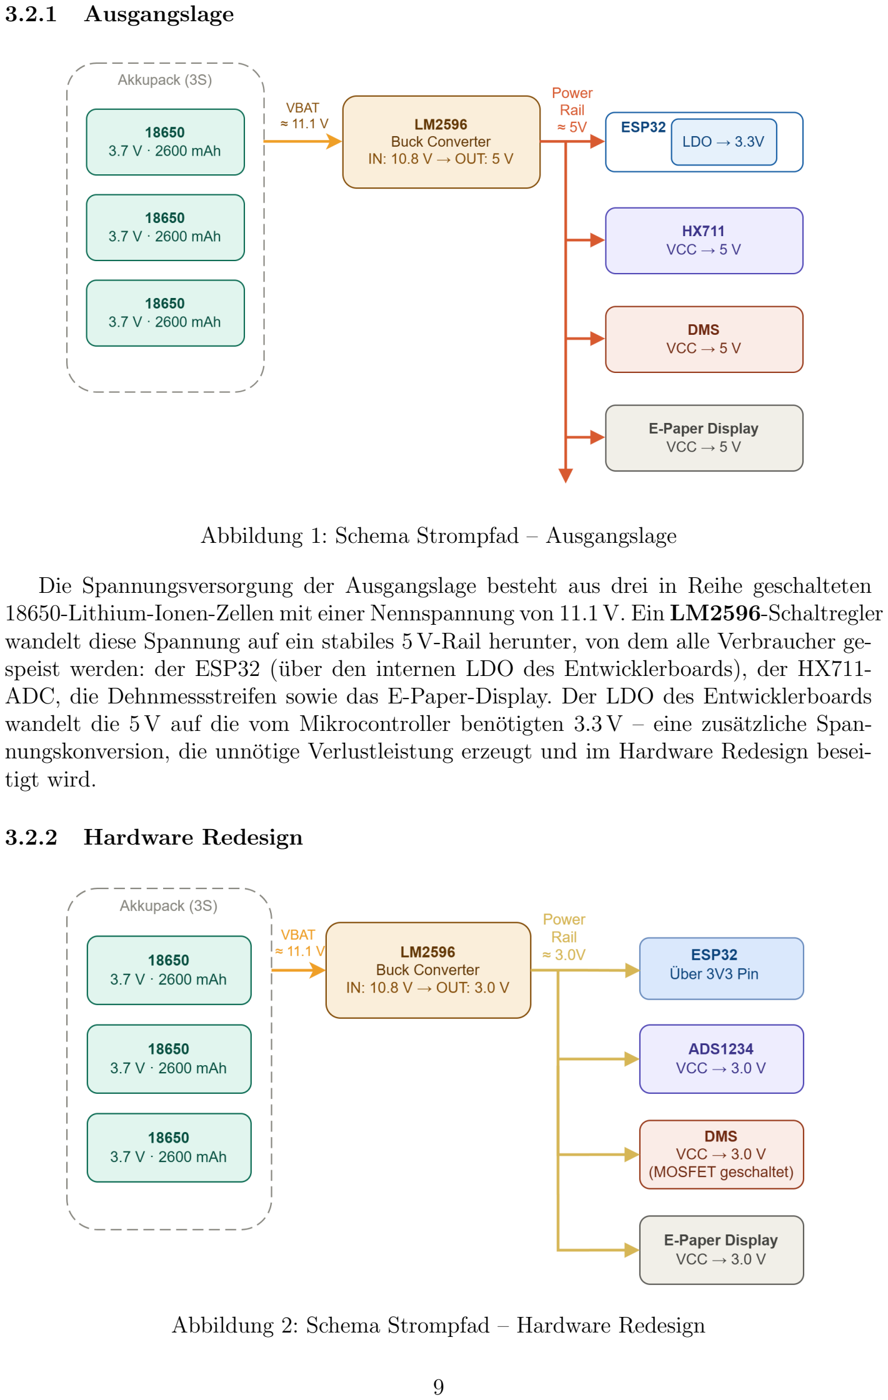
[picture p3: page 9]

### 3.2.1 Ausgangslage

Abbildung 1: Schema Strompfad – Ausgangslage

Die Spannungsversorgung der Ausgangslage besteht aus drei in Reihe geschalteten 18650-Lithium-Ionen-Zellen mit einer Nennspannung von 11.1 V. Ein LM2596-Schaltregler wandelt diese Spannung auf ein stabiles 5 V-Rail herunter, von dem alle Verbraucher gespeist werden: der ESP32 (uber den internen LDO des Entwicklerboards), der HX711- ¨ ADC, die Dehnmessstreifen sowie das E-Paper-Display. Der LDO des Entwicklerboards wandelt die 5 V auf die vom Mikrocontroller benötigten 3.3 V – eine zusätzliche Spannungskonversion, die unnötige Verlustleistung erzeugt und im Hardware Redesign beseitigt wird.

### 3.2.2 Hardware Redesign

Abbildung 2: Schema Strompfad – Hardware Redesign

Das Hardware Redesign optimiert den Strompfad in zwei wesentlichen Punkten:

Dehnmessstreifen uber MOSFET geschaltet: ¨ | In der Ausgangslage waren die
Wägezellen dauerhaft mit Spannung versorgt – auch im Deep Sleep. Durch einen MOSFET wird die Versorgung der Dehnmessstreifen vor dem Eintreten in den Deep Sleep unterbrochen, was den Ruhestrom merklich senkt.
ESP32 direkt uber den 3V3-Pin versorgt: ¨ | Das Entwicklerboard enthielt einen
internen LDO, der 5 V auf 3.3 V regelte. Im neuen Design wird der ESP32 direkt
uber den ¨ | 3V3-Pin eingespeist, womit diese Verlustleistung entfällt. Ausserdem wurde
die Ausgangsspannung des Buck-Converters auf 3.0 V reduziert, was gegenuber dem ¨ Betrieb mit 3.3 V eine weitere Einsparung von 73.4 mJ pro Zyklus (−17,6 %) erzielt (siehe Abschnitt 7.1.1).

### 3.3 Strommessungen und Low-Power-Optimierung

Ein zentrales Ziel dieser Arbeit ist die Minimierung des Stromverbrauchs, um eine möglichst lange Batterielaufzeit zu erreichen. Die folgenden Messungen dokumentieren den Energieverbrauch in den einzelnen Betriebsphasen und quantifizieren den Effekt der implementierten Optimierungen. Tabellen 6 und 4 fassen die verbrauchte Energie pro Phase zusammen – jeweils im direkten Vergleich zwischen Ausgangslage und optimiertem System.

### 3.4 Ubersicht Zyklus ¨

Fur die Strommessungen kamen zwei Messger ¨ | äte zum Einsatz, die je nach Messaufgabe
in den Versorgungspfad eingeschleift wurden.
Das Nordic Semiconductor Power Profiler Kit II (PPK2) wurde fur das qualita- ¨ tive Stromverlauf-Profiling eingesetzt und liefert eine zeitlich aufgelöste Visualisierung der einzelnen Betriebsphasen (Boot, ADC-Messung, BLE, Deep Sleep) in der nRF Connect Power Profiler App.
Die quantitativen Energie- und Leistungsmessungen wurden mit dem JouleScope durchgefuhrt. Das JouleScope misst gleichzeitig Strom und Spannung und berechnet dar- ¨
aus direkt die verbrauchte Energie in Millijoule – unter Berucksichtigung des tats ¨ | ächlichen
Spannungsniveaus am jeweiligen Messpunkt. Je nach Messung wurde das Gerät an unterschiedlichen Stellen in den Strompfad eingeschleift: vor dem Buck-Converter (Batterieseite), nach dem Buck-Converter (Power-Rail), direkt vor einzelnen Verbrauchern (ESP32, ADC, Dehnmessstreifen) oder am LDO-Ein- bzw. Ausgang.

### 3.5 Gesamtsystem Stromverbrauch

Tabelle 6 vergleicht die Software-Ausgangslage mit dem optimierten System auf Basis der JouleScope-Messungen am 3V3-Pin des ESP32. Tabelle 4 stellt den Gesamtenergieverbrauch beider Systeme gegenuber; die Werte beziehen sich auf JouleScope-Messungen vor ¨ dem Buck-Converter (Batterieseite) und umfassen damit sämtliche Wandlungsverluste.

### 3.5.1 Vergleich Energieverbrauch Aktiver Zyklus

Tabelle 4: Gesamtsystem Energiebedarf Zusammensetzung – Vergleich Aktiver Zyklus
Verbraucher | Alt [mJ] | Neu [mJ] | Ersparnis

Verbrauch
ESP32 uber 3V3 | 2220 | 223.8 ¨ | −89.9 %
Dehnmessstreifen | 781.9 | 89.1 | −88.6 %
ADC | 106.2 | 13.42 | −87.4 %

Verluste Umwandlung
Verlust LDO | 1210 | 0 | Entfällt
Verlust Buck | 2955 | 346.1 | −88.3 %
Summiert | 7273.1 | 672.4 | −90.7 %
Diskrepanz | −770.1 | 17.1
Gesamt Gemessen | 6503 | 689.5 | −89.4 %

### 3.5.2 Vergleich Leistungsverbrauch Deep-Sleep

Tabelle 5 vergleicht den Leistungsverbrauch im Deep Sleep. Einzelmessungen der Verbraucher: Abb. 36 (DMS), 37/38 (ADC). Gesamtmessungen vor dem Buck-Converter: Abb. 39/40. Trotz der Komponenteneinsparungen (−87,7 % nach Buck) begrenzt der Leerlaufverlust des LM2596S von 69.77 mW (Abb. 41) die tatsächliche Ersparnis auf Batterieebene erheblich: Er ubersteigt allein bereits den Gesamtverbrauch aller Komponenten ¨ des neuen Systems.

Tabelle 5: Vergleich Leistungsverbrauch Deep-Sleep – Ausgangslage vs. Optimiertes System
Verbraucher | Alt [mW] Neu [mW] | Ersparnis

Nach Buck-Converter (Power Rail)
Dehnmessstreifen | 78,19 | 0 −100 % (MOSFET)
ADC | 9,762 | 4,042 | −58,6 %
ESP32 | 27,53 | 10,15 | −63,1 %
Summiert (nach Buck) | 115,4 | 14,19 | −87,7 %

Vor Buck-Converter (Batterieseite)
Gesamt gemessen | 268,2 | 90,96 | −66,1 %

### 3.6 Vergleich Energieverbrauch ESP32

### 3.6.1 Ubersicht Stromverlauf ESP32 ¨

Abbildung 3 zeigt den Stromverlauf eines vollständigen Messzyklus in der Ausgangslage, wie er direkt aus der Vorgängerarbeit ubernommen wurde. In dieser Vorarbeit stand die ¨ funktionale Korrektheit im Vordergrund – eine gezielte Optimierung des Stromverbrauchs hatte keine Priorität.

Im Profil sind drei charakteristische Abschnitte erkennbar: ein kurzer initialer Peak während Boot und Initialisierung, ein ruhigeres Plateau während der ADC-Messung sowie ein erhöhter und zeitlich ausgedehnter Abschnitt während der BLE-Kommunikation. Die
gesamte Aktivphase erstreckt sich uber ca. ¨ | 10 s, bevor das System in den Deep Sleep
ubergeht. ¨

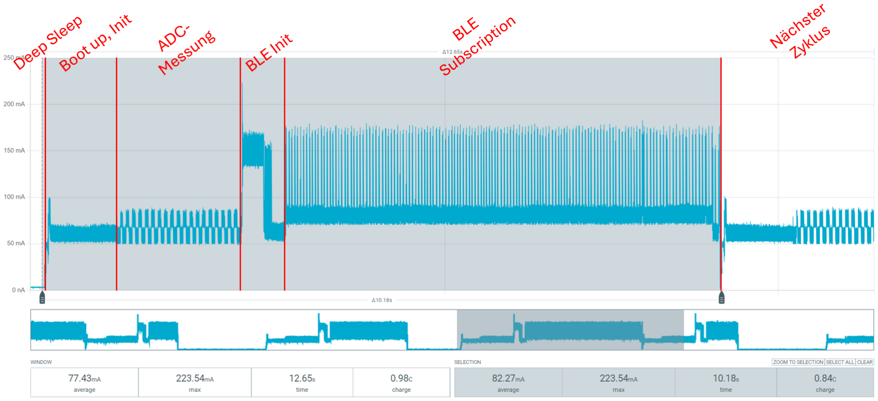
[picture p4: figure]

Abbildung 3: Stromverbrauch – Ausgangslage, ein vollständiger Messzyklus

1. Deep Sleep: Zwischen den Messzyklen befindet sich das System im Deep Sleep. Die meisten Funktionen sind abgeschaltet; lediglich der RTC-Timer läuft weiter und weckt den ESP32 nach Ablauf des konfigurierten Intervalls. Der Stromverbrauch ist in dieser Phase minimal.
2. Boot und Initialisierung: Der ESP32 startet nach dem Deep Sleep neu. Der nichtfluchtige Speicher (NVS) wird ausgelesen, die State Machine initialisiert und ¨ der HX711-ADC eingerichtet.
3. ADC-Messung: Der HX711 erfasst 20 Samples auf einem einzigen Kanal, an dem alle vier Wägezellen als gemeinsame Brucke angeschlossen sind. Zwischen jedem ¨ Sample wartet der ESP32 in einem blockierenden delay(50 ms), was den Kern während der gesamten Messphase vollständig aktiv hält.
4. BLE-Initialisierung: Der BLE-Stack wird gestartet und das Advertisement fur ¨ die Gateway-Verbindung gesendet.
5. Verbindung und Datenubertragung: ¨ | Das System wartet auf den Verbindungs-
aufbau des Gateways (typisch ca. 6 s), ubertr ¨ | ägt den Messwert per GATT-Indication
und trennt die Verbindung.
6. Nächster Zyklus: Der Messzyklus ist abgeschlossen; das System kehrt in den Deep
Sleep zuruck. Im gezeigten Stromprofil folgt der n ¨ | ächste Zyklus sofort, weshalb kein
ausgeprägtes Tiefstromplateau sichtbar ist.

### 3.6.2 Vergleich ESP32 Energieverbrauch

Tabelle 6: Software-Vergleich Aktiver Zyklus am ESP32-3V3-Pin: Ausgangslage vs. Optimiertes System. Beide ESP32 wurden mit 3.0V gespeist. DMS und LDO sind aus dem Messpfad ausgeschlossen. Messprofile und Berechnungen vgl. Abschnitt 7.1.3.
Betriebsphase | Alt [mJ] Neu bereinigt∗
[mJ] Einsparung
Boot und Ramp-up | 360.3 | 57.66 | −84.0 %
ADC-Messung | 807.8 | 37.41 | −95.4 %
BLE | 1293 | 88.18 | −93.2 %
ADS1234 Chip (Abzug∗
) | – | 13.42 | –
Gesamt Zyklus | 1858 | 210.4 | −88.7 %

∗ Der ADS1234 ist am ESP32-3V3-Rail angeschlossen und in den Phasenmessungen des neuen Systems enthalten. Da der HX711 des alten Systems ausserhalb des Messpfades lag, wird der ADS1234-Anteil (13.42 mJ) von allen Neu-Werten abgezogen. Rohmessungen und Rechnungen: Abschnitt 7.1.3.

Die nachfolgenden Abschnitte beschreiben jede Betriebsphase im Detail und erläutern, welche Massnahmen zur jeweiligen Einsparung gefuhrt haben: ¨

### 3.6.3 Optimierung Energieverbrauch Software

1. Ramp Up – Boot, Initialisierung und ADC:
Diese Phase umfasst den ESP32-Bootvorgang, die State-Machine-Initialisierung sowie die ADS1234-Messung. In der Vorgängerarbeit wurden Kalibrierparameter bei jedem Aufwachen aus dem Deep Sleep neu aus dem nichtfluchtigen Speicher (NVS) ¨ ausgelesen. Im optimierten System werden diese Werte einmalig beim ersten Boot geladen und anschliessend im RTC-Speicher gehalten, der den Deep Sleep uberlebt ¨ – das NVS-Auslesen entfällt damit bei jedem Folge-Zyklus und verkurzt die Boot- ¨ Phase entsprechend.
2. ADC:
In der Ausgangslage verwendete die Vorgängerarbeit den HX711 – einen einkanaligen 24-Bit-ADC, an den alle vier Wägezellen als gemeinsame Brucke angeschlossen ¨ waren. Die Messung erfasste 20 Samples auf diesem einzigen Kanal; zwischen jedem
Sample wurde ein blockierendes delay(50 ms) ausgefuhrt, was den ESP32-Kern f ¨ | ur ¨
die gesamte Wartezeit vollaktiv liess.

Im optimierten Design werden die vier Kanäle des ADS1234 sequenziell ausgelesen; pro Kanal werden 5 Samples erfasst. Nach jedem Sample kehrt der ESP32 sofort
in den Light Sleep zuruck und wird durch einen GPIO-Interrupt auf dem ¨ | | | DRDY-Pin
geweckt. Zwischen den vier Kanalgruppen liegt eine Pause von ca. 400 ms: die physikalisch bedingte Einschwingzeit des internen sinc³
-Filters nach einem Kanalwechsel. Auch diese Wartezeit verbringt der ESP32 im Light Sleep.

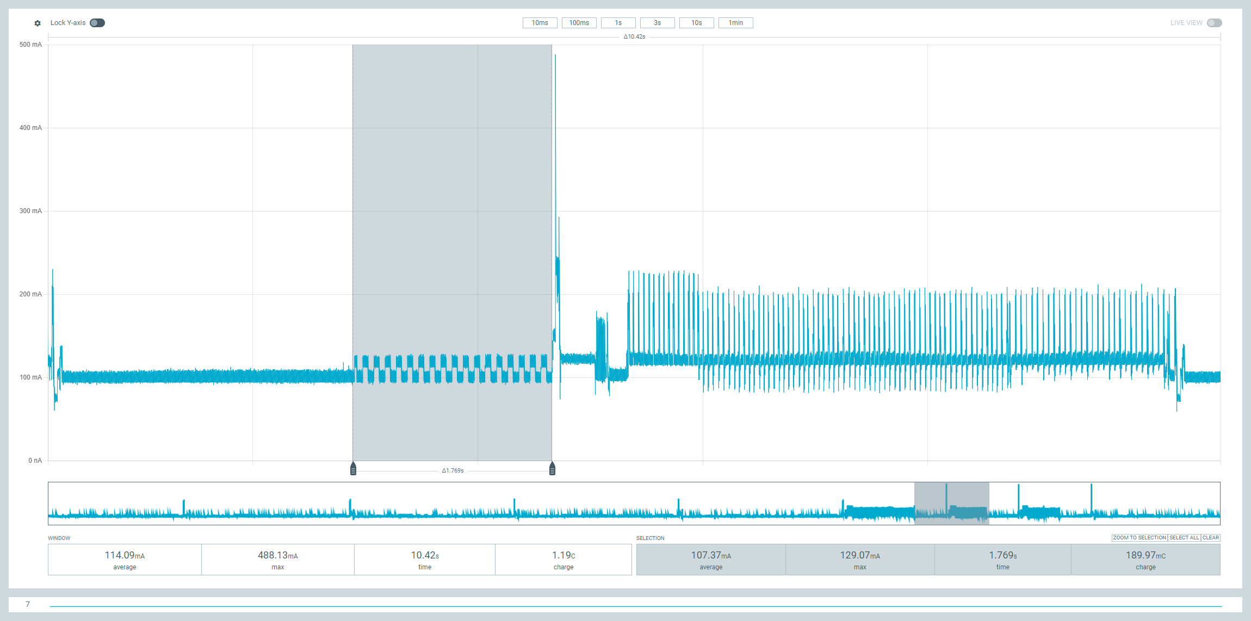
[picture p5: figure]

Abbildung 4: ADC-Stromverlauf – Ausgangslage (HX711)

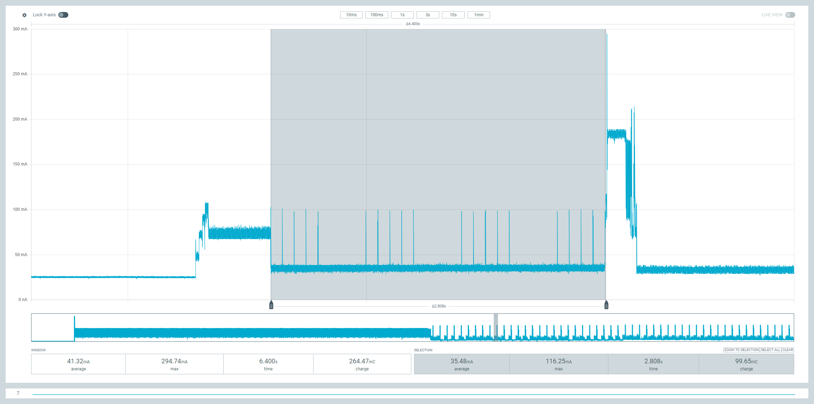
[picture p6: figure]

Abbildung 5: ADC-Stromverlauf – Optimiertes System (ADS1234)

3. BLE-Initialisierung und Advertisement:
In der Ausgangslage verwendete die Firmware die Arduino-BLE-Bibliothek (Blue-
droid) und baute fur jeden Messzyklus eine vollst ¨ | ändige GATT-Verbindung auf. Die
Dauer dieser Phase variiert stark in Abhängigkeit vom Scan-Intervall des Gateways
– im gezeigten Profil 5.6 s, in anderen Messungen bis zu 7 s.

Der fundamentale Optimierungsansatz bestand darin, den Verbindungsaufbau vollständig zu eliminieren: Der Messwert wird direkt in die Manufacturer-Specific-Data des Advertisement-Pakets kodiert – das Gateway empfängt die Daten durch passives Scannen, ohne eine Verbindung aufzubauen. Im zweiten Schritt wurde Bluedroid durch den schlanken NimBLE-Stack ersetzt, der einen deutlich geringeren Initialisierungsoverhead aufweist.

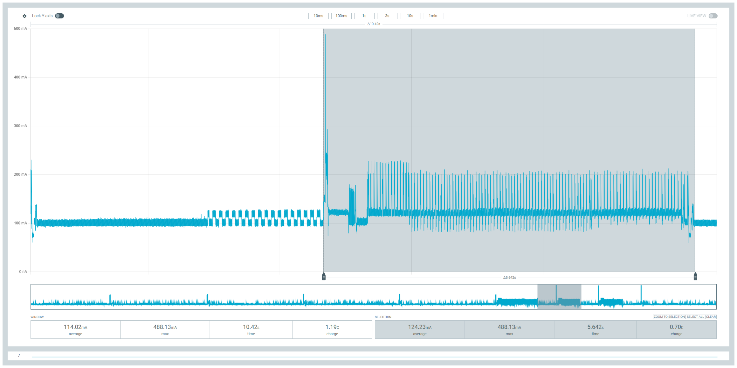
[picture p7: figure]

Abbildung 6: BLE – Ausgangslage (Bluedroid, GATT-Verbindung)

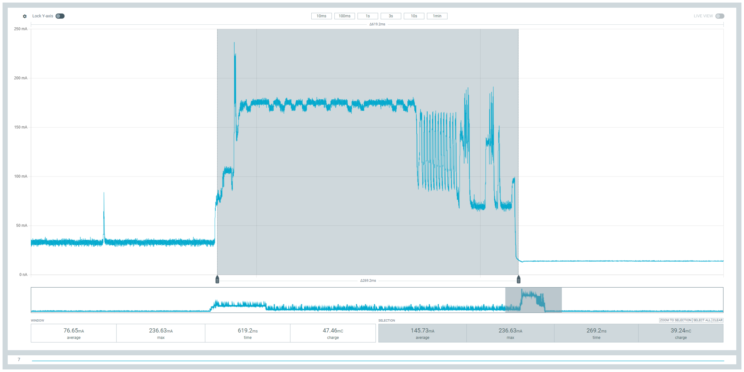
[picture p8: figure]

Abbildung 7: BLE – Optimiertes System (NimBLE, Advertisement)

Als Zwischenschritt wurde der Advertisement-Ansatz zunächst mit der bestehenden Arduino-BLE-Bibliothek validiert (Abbildung 8), bevor der Wechsel zu NimBLE erfolgte.

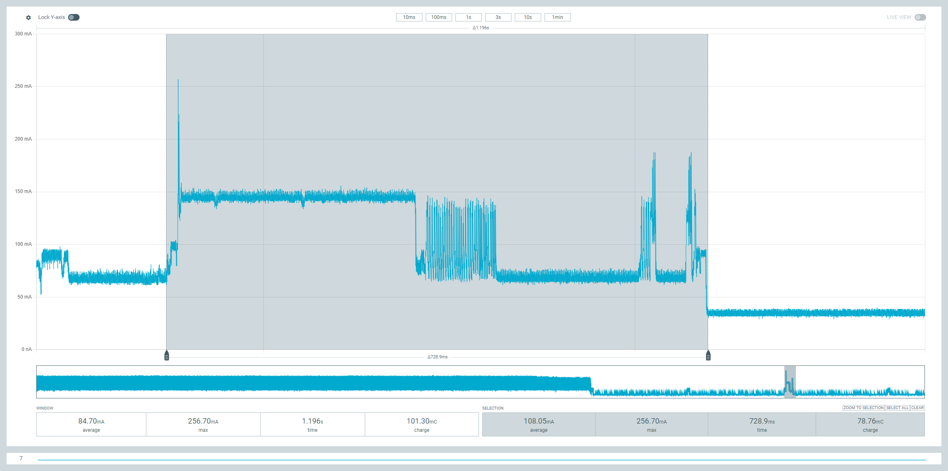
[picture p9: figure]

Abbildung 8: BLE – Zwischenschritt (Arduino BLE-Library, Advertisement)

Die Wahl von zwei Advertisements pro Zyklus ist ein bewusster Kompromiss. In einem Zuverlässigkeitstest uber ¨ 100 aufeinanderfolgende Messzyklen wurden 91 von 100 Advertisements erfolgreich vom Gateway empfangen, was fur ein ¨ periodisches Uberwachungssystem ausreichend ist. ¨

Abbildung 9: Zuverlässigkeitstest – 100 BLE Advertisements (NimBLE)

### 3.7 Verluste Hardware

Dieses Unterkapitel quantifiziert die Wandlungsverluste des Buck-Converters und des LDO sowie den Energiebedarf des ADC.

### 3.7.1 Messmethode

Fur Buck-Converter und LDO wird die Energie jeweils ¨ | vor und nach dem Bauteil uber ¨
einen vollständigen Zyklus erfasst; die Differenz entspricht dem jeweiligen Wandlungsverlust. Der Energiebedarf des ADC wird direkt am Versorgungspin des Chips gemessen.

### 3.7.2 Buck converter

Zur Bestimmung des Verlusts am LM2596S-Schaltregler wird die Energie vor dem Konverter (Eingang, Batterieseite) mit der Energie nach dem Konverter (Ausgang, Lastseite) verglichen; die Differenz entspricht dem Schaltregler-Board zuzuschreibenden Verlust. Die Messwerte entstammen den JouleScope-Aufzeichnungen (Abbildungen 30, 31, 32 und 33) und umfassen jeweils einen vollständigen Messzyklus. Beim alten System wurde sichergestellt, dass BLE-Initialisierung und Subscription zusammen ca. 5.4 s dauerten, um vergleichbare und reproduzierbare Messungen zu gewährleisten.

Altes System

∆EBuck, alt = 6503 mJ − 3548 mJ = 2955 mJ | (1)

ηBuck, alt =

3548 mJ
6503 mJ
≈ 54.6 % | (2)

Neues System

∆EBuck, neu = 689.5 mJ − 343.4 mJ = 346.1 mJ | (3)

ηBuck, neu =

343.4 mJ
689.5 mJ
≈ 49.8 % | (4)

Vergleich Beide Systeme weisen einen ähnlichen Wirkungsgrad von ca. 50 % auf. Der entscheidende Unterschied liegt im absoluten Verlust: Das alte System verliert 2955 mJ pro Zyklus am Schaltregler, das neue System nur 346.1 mJ – eine Reduktion um den Faktor 8,5. Der geringere absolute Verlust ist direkt auf den deutlich niedrigeren Gesam-
tenergieverbrauch des optimierten Systems zuruckzuf ¨ | uhren. ¨
Plausibilitätsprufung anhand des Datenblatts ¨ | Das Datenblatt des LM2596S [10]
gibt fur eine Konfiguration von 12 V Eingang auf 3 ¨ | .3 V Ausgang bei einem Ausgangs-
strom von 3 A einen typischen Wirkungsgrad von 79 % an. Die gemessenen Werte von ca. 50 % liegen erwartungsgemäss darunter – zum einen weil beide Systeme mit mittleren Lastströmen weit unter 3 A betrieben werden, zum anderen weil es sich nicht um den nackten LM2596S-Chip handelt, sondern um ein fertiges Schaltregler-Board mit zusätzlicher Peripherie (Freilaufdiode, Spule, Filterkapazitoren, Schutzschaltungen), die den Gesamtwirkungsgrad weiter senken.
Bei geringer Nutzlast dominiert zudem der Quiescent-Strom des LM2596S von ca.
5.5 mA den Eingangsstrom uberproportional – bei 3 A Nennlast w ¨ | äre er vernachlässigbar.
Da der LM2596S keinen Burst- oder PFM-Modus fur Leichtlast unterst ¨ | utzt, ist dieser ¨
Verlust strukturell bedingt.

### 3.7.3 LDO

Der interne LDO des ESP32-Entwicklerboards wandelt die vom LM2596S gelieferte Spannung auf die vom Mikrocontroller benötigten 3.3 V. Diese zusätzliche Konverterstufe erzeugt eine nicht vernachlässigbare Verlustleistung.

Ausgangslage Die Energie vor dem LDO (am VIN-Pin, Eingang) beträgt 3430 mJ; nach dem LDO (am 3V3-Pin, Ausgang) verbleiben 2220 mJ:

∆ELDO, alt = 3430 mJ − 2220 mJ = 1210 mJ | (5)

ηLDO, alt =

2220 mJ
3430 mJ
≈ 64.7 % | (6)

Die Messprofile sind in Abbildungen 34 und 35 dargestellt.

Optimiertes System – LDO entfällt Im optimierten System wird der ESP32 direkt
uber den ¨ | 3V3-Pin eingespeist, anstatt uber den ¨ | VIN-Pin. Damit wird der interne LDO
vollständig umgangen, und der Verlust von 1210 mJ pro Zyklus entfällt ersatzlos (vgl. Tabelle 4, Zeile Verlust LDO).

### 3.7.4 ADC

Der ADS1234 wird nach der Messung uber den ¨ | !PDWN-Pin in den Standby-Modus versetzt
und vor dem nächsten Zyklus wieder aktiviert. Da der ESP32 im Anschluss in den Deep Sleep ubergeht und die GPIO-Pins floatend werden, bleibt der ADC im Tiefschlaf teil- ¨ weise aktiv; ein Pull-down-Widerstand am !PDWN-Pin hätte eine vollständige Abschaltung ermöglicht. Im alten System war der HX711 hardwareseitig nicht im Messpfad eingebunden und wird daher separat betrachtet. Die Zahlenwerte sind Tabelle 4 zu entnehmen; die Messprofile sind in Abbildungen 10 und 11 dargestellt.

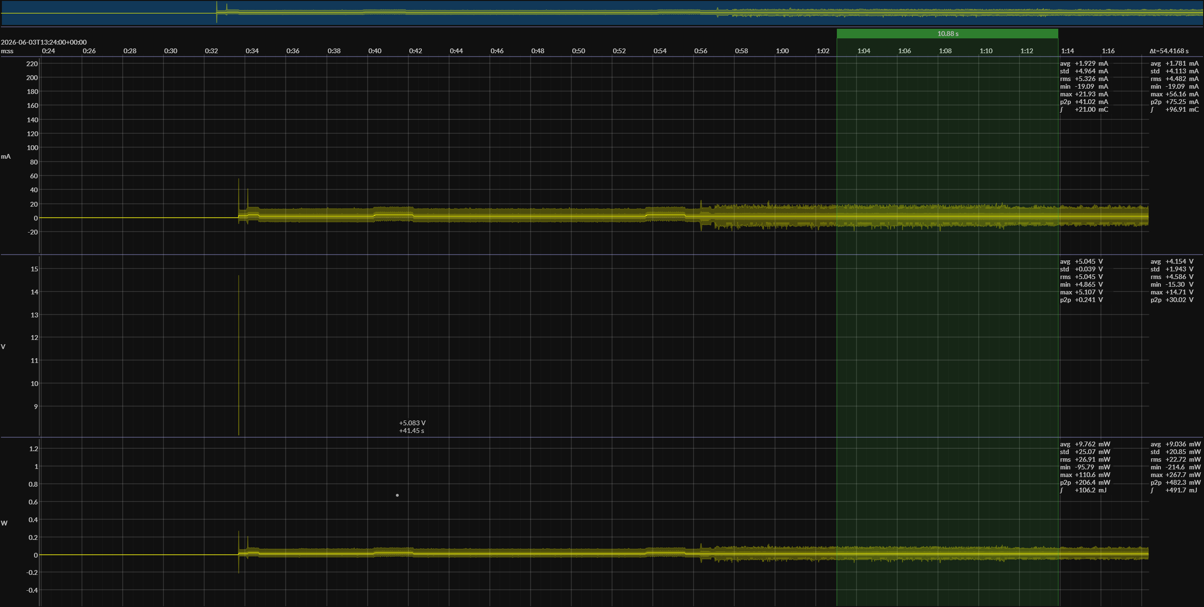
[picture p10: figure]

Abbildung 10: ADC-Verlust – Ausgangslage (HX711); 9.765 mW

Abbildung 11: ADC-Verlust – Optimiertes System (ADS1234); 3.738 mW

### 3.8 Gesamtverbrauch und Batterielebensdauer

Die Batterielaufzeit ergibt sich aus der Energiebilanz pro Messzyklus; Grundlage sind die direkt am JouleScope gemessenen Werte vor dem Buck-Converter (Batterieseite):

Aktivzyklus-Energie: 689.5 mJ (neu) vs. 6503 mJ (alt), siehe Tabelle 4

Deep-Sleep-Leistung: 90.96 mW (neu) vs. 268.2 mW (alt), siehe Tabelle 5

Als Batteriekapazität wird 3 × 2600 mA h bei 11.1 V angenommen:

EBat = 103.9 kJ

Die Energie pro Messzyklus ergibt sich zu (da taktiv ≪ T):

EZyklus(T) ≈ Eaktiv + Psleep · T

Tabelle 7: Berechnete Batterielaufzeit – Vergleich Alt vs. Neu (3 × 2600 mA h, 11.1 V)

Intervall T | EZyklus, neu | Laufzeit neu EZyklus, alt | Laufzeit alt
1 min (60 s) | 6.15 J | ≈ 12 Tage | 22.6 J | ≈ 3 Tage
10 min (600 s) | 55.3 J | ≈ 13 Tage | 167 J | ≈ 4 Tage
30 min (1800 s) | 164 J | ≈ 13 Tage | 489 J | ≈ 4 Tage

Die Laufzeit ist nahezu intervallunabhängig, da der Deep-Sleep-Ruhestrom die Energiebilanz dominiert. Das grösste verbleibende Einsparpotenzial liegt in der Reduktion des Tiefschlaf-Ruhestroms – primär durch Ersetzen des SBC-NodeMCU-ESP32-C-Boards und des LM2596S.

## 4 Optimierung Messgenauigkeit

### 4.1 Sensorik: Wägezellen und ADC

### 4.1.1 Wägezellen (YZC-133)

Als Kraftsensoren kommen vier Wägezellen des Typs YZC-133 zum Einsatz [2]. Jede Zelle
ist fur eine Nennlast von 1 kg ausgelegt und enth ¨ | ält intern eine vollständige Wheatstone-
Brucke aus vier Dehnungsmessstreifen (DMS). Die relevanten elektrischen Kenngr ¨ | össen
sind in Tabelle 8 zusammengefasst.

Tabelle 8: Elektrische Spezifikation YZC-133
Parameter | Wert
Nennlast | 1 kg
Nennkennwert (Empfindlichkeit) 1,0 ± 0,15 mV/V
Nullpunktsignal | ±0,1 mV/V
Kriechfehler | 0,03 % F.S./30 min
Eingangsimpedanz | 1066 ± 20 Ω
Ausgangsimpedanz | 1000 ± 5 Ω

Bei 3.0 V Erregerspannung liegen beide Ausgangspins der Brucke auf einem Gleichtakt- ¨ potenzial von ca. 1.5 V (Vex/2). Das Nutzsignal ist die Differenz zwischen diesen beiden Pins: bei Vollast nominell 1,0 mV/V × 3,0 V = 3.0 mV. Der differentielle Eingang des ADS1234 erfasst genau diese Differenz und unterdruckt das Gleichtaktsignal durch sei- ¨ ne hohe Gleichtaktunterdruckung (CMRR). Die vier Zellen sind in X-Formation an den ¨ Ecken der Waagplattform montiert.

### 4.1.2 ADS1234 – 4-Kanal-24-Bit-ADC

Fur die Signalerfassung wird der ADS1234 von Texas Instruments eingesetzt [9]. Der Chip ¨ ist ein 24-Bit-Sigma-Delta-ADC mit vier differenziellen Eingangskanälen und einem integrierten programmierbaren Verstärker (PGA) mit den Verstärkungsfaktoren 1, 2, 64 und
128. Mit PGA-Gain 128 ergibt sich fur das 3 ¨ | .0 mV-Signal der YZC-133 ein verstärktes
Differenzsignal von ca. 384 mV, das den Eingangsbereich des ADC gut ausnutzt. Die wählbare Ausgabedatenrate beträgt 10 SPS oder 80 SPS; im vorliegenden System wird 10 SPS verwendet, da dies das Eingangsrauschen durch die längere Integrationszeit maximal reduziert.

### 4.1.3 Von einem auf vier ADC-Kanäle

In der Vorarbeit zu dieser Bachelorarbeit waren alle vier Wägezellen in einer gemeinsamen Wheatstone-Brucke zusammengeschaltet und lieferten ihr summiertes Signal an ¨ einen einzigen ADC-Kanal. In dieser Arbeit wird jede Wägezelle einzeln an einen eigenen Eingangskanal des ADS1234 gefuhrt. Dieser Wechsel bringt zwei wesentliche Vorteile: ¨

Ecklastkompensation Mit einem einzigen Summensignal ist keine positionsabhängige Korrektur möglich: Das System kann nicht unterscheiden, ob eine Abweichung durch einen exzentrischen Lastangriffspunkt oder durch eine tatsächliche Massenänderung entsteht. Durch die individuellen Kanäle lässt sich jede Wägezelle separat kalibrieren und der dominante Sensor pro Lastposition gezielt korrigieren (siehe Abschnitt 4.2).

Rauschverhalten und individuelle Kalibrierung Die Empfindlichkeit der YZC-133 streut mit ±15 % zwischen den Exemplaren. In der Einzelkanal-Lösung mittelte sich diese Streuung uber die parallele Zusammenschaltung heraus, konnte aber nicht pro Sensor ¨ korrigiert werden. Mit vier separaten Kanälen wird die Empfindlichkeitsdifferenz jeder Wägezelle durch den individuell bestimmten Skalierungsfaktor (spanFactor) in der Software exakt kompensiert.

### 4.2 ADS1234 – Ansteuerung und Kalibrierung

### 4.2.1 Uberblick ¨

Der ADS1234 ist ein 24-Bit-Sigma-Delta-ADC von Texas Instruments, der speziell fur ¨ den Einsatz mit Bruckensensoren wie Dehnungsmessstreifen (DMS) ausgelegt ist [9]. Er ¨
stellt vier unabhängige Eingangskanäle bereit, die uber zwei digitale Adressleitungen ( ¨ | A0,
A1) ausgewählt werden. Die Kommunikation mit dem Mikrocontroller erfolgt uber ein ¨ synchrones serielles Protokoll mit den Leitungen DRDY/DOUT (kombiniertes Datenbereitund Datensignal), SCLK (Takt) sowie !PDWN (Power-Down/Reset).

Tabelle 9: Pin-Belegung ADS1234 – ESP32
Signal | GPIO Funktion
DRDY/DOUT | 2 | Datenbereit-Anzeige und serieller Datenausgang
SCLK | 15 | Serieller Takt (Master-Ausgang)
!PDWN | 26 | Power-Down / Reset
DMS PWR | 17 | Versorgung der Wägezellen (schaltbar)
A0 | 32 | Kanal-Adresse Bit 0
A1 | 4 | Kanal-Adresse Bit 1

### 4.2.2 Serielles Leseprotokoll

Der ADS1234 signalisiert eine abgeschlossene Wandlung, indem er die DRDY-Leitung auf LOW zieht. Die Software wartet aktiv auf diesen Zustand und liest anschliessend 24 Bit
MSB-first aus, indem fur jedes Bit ein ¨ | SCLK-Impuls erzeugt und der Pegel von DOUT abge-
tastet wird. Nach dem 24. Bit wird gemäss Datenblatt (Figure 7-10) ein 25. Taktimpuls
gesendet, der DRDY wieder auf HIGH zwingt und damit den ADC fur die n ¨ | ächste Wand-
lung freigibt. Da der ADS1234 ein Zweierkomplement-Format mit 24 Bit Breite verwendet, wird der Rohwert abschliessend vorzeichenrichtig auf 32 Bit erweitert:

if (raw & 0x800000) raw |= 0xFF000000;
return (int32_t)raw;

### 4.2.3 Kanalwechsel CH4 → CH1: !PDWN-Workaround

Der ADS1234 kodiert den aktiven Kanal uber die beiden Adressleitungen als 2-Bit- ¨ Binärzahl: Kanal 1 entspricht A0=0, A1=0, Kanal 4 entspricht A0=1, A1=1. Der Chip erkennt einen Kanalwechsel intern anhand steigender Flanken auf A0 oder A1. Beim Wechsel von Kanal 4 nach Kanal 1 fallen jedoch beide Adressleitungen von HIGH auf LOW – es entsteht keine einzige steigende Flanke. Der ADS1234 erkennt diesen Wechsel daher nicht
als Kanalumschaltung und setzt DRDY nicht zuruck. Die Leitung bleibt ¨ | LOW, was der Soft-
ware fälschlicherweise signalisiert, dass bereits ein gultiger Messwert des neuen Kanals ¨ vorliegt, obwohl noch der alte Kanal aktiv ist.
Als Lösung wird nach dem Setzen der Adressleitungen auf Kanal 1 gepruft, ob ¨ | DRDY
bereits LOW ist. Trifft dies zu, wird ein !PDWN-Puls von 500 µs ausgelöst, der den ADC in den Power-Down-Zustand versetzt und anschliessend neu startet. Dieser Reset zwingt den Chip, den ausgewählten Kanal neu zu initialisieren und eine frische Wandlung durch-
zufuhren, bevor ¨ | DRDY das nächste Mal LOW wird.

int32_t readChannel(int ch) {
setChannel(ch);
if (ch == 1 && digitalRead(PIN_DRDY_DOUT) == LOW) { digitalWrite(PIN_PDWN, LOW); delayMicroseconds(500);
digitalWrite(PIN_PDWN, HIGH);
}
return readADS1234();
}

### 4.2.4 Kalibrierung

Die Kalibrierung läuft in drei aufeinanderfolgenden Schritten ab und wird einmalig beim
Start der Firmware uber die serielle Schnittstelle ausgel ¨ | öst. Alle Messwerte sind Mittel-
werte aus CAL SAMPLES = 5 Wandlungen pro Kanal, was bei 10 SPS einer Messzeit von rund 0,4 Sekunden pro Kanal entspricht.

Schritt 1 – Nullpunkt (Zero Offset) Die Waage wird vollständig entlastet und fur ¨ jeden der vier Kanäle ein gemittelter Rohwert erfasst, der als Nullpunkt zeroOffset[ch] gespeichert wird. Dieser Wert kompensiert thermische und mechanische Vorlast der Wägezellen sowie Offset-Fehler des ADC.

Schritt 2 – Empfindlichkeit (Span) Ein bekanntes Kalibriergewicht von 3000 g wird mittig auf die Waagplattform gelegt. Fur jeden Kanal wird die Abweichung vom Nullpunkt ¨ berechnet:
∆i = xi − zeroOffseti | (7)

Die vier Wägezellen sind in X-Formation an den Ecken der Plattform angebracht. Bei dieser Anordnung werden die zwei diagonal gegenuberliegenden Zellen beim Belasten auf Zug, ¨ die anderen zwei auf Druck beansprucht, was zu einem mechanisch bedingten Vorzeichen-
wechsel im ADC-Signal fuhrt. Das Vorzeichen von ∆ ¨ | i wird daher pro Kanal automatisch

erfasst und als channelSign gespeichert. Der initiale Skalierungsfaktor ergibt sich aus der
Gesamtauslenkung uber alle vier Kan ¨ | äle:

sinit =

mcal
P4
i=1 |∆i

⇒ | spanFactori = channelSigni
- sinit | (8)

Damit trägt jeder Kanal anteilig zur Gesamtmasse bei, wobei die Polarität korrekt berucksichtigt ¨ wird.

Schritt 3 – Ecklastkompensation (Corner Trim) Bei einer Plattformwaage mit vier Wägezellen in den Ecken fuhren fertigungsbedingte Toleranzen der Sensoren dazu, dass ¨ ein exzentrisch aufgelegtes Gewicht – je nach Position – unterschiedliche Gesamtmassen anzeigt. Um dies zu kompensieren, wird das Kalibriergewicht nacheinander uber jede der ¨ vier Ecken gestellt.
Bei jeder Eckenbelastung ermittelt die Software denjenigen Kanal mit der grössten absoluten Auslenkung (dominanter Kanal), da dieser am stärksten von der Lastposition beeinflusst wird. Die aktuelle Gesamtanzeige mmeas ergibt sich aus den Beiträgen aller vier Kanäle:

mmeas =

X

4

i=1

spanFactori

- ∆i | (9)

Der Skalierungsfaktor des dominanten Kanals d wird anschliessend so angepasst, dass die
Anzeige exakt dem Kalibriergewicht entspricht, während die Faktoren der ubrigen Kan ¨ | äle
unverändert bleiben:

spanFactord =

mcal −

P
i̸=d

spanFactori

- ∆i
∆d

(10)

Ein einziger Durchlauf uber alle vier Ecken ist f ¨ | ur typische DMS-Toleranzen von unter ¨
5 % ausreichend.

Gewichtsberechnung im Betrieb Nach abgeschlossener Kalibrierung berechnet sich die angezeigte Masse in jedem Messtakt als:

m =

X

4

i=1

spanFactori

·

rawi − zeroOffseti
(11)

### 4.3 Messreihe Messgenauigkeit

Zur Beurteilung der Messgenauigkeit wurden an sechs Messpositionen (vier Ecken sowie die Mitte der Wägefläche) jeweils 5 aufeinanderfolgende Messwerte aufgezeichnet. Die Ergebnisse sind in Tabelle 10 zusammengefasst.

Präzision vs. Genauigkeit. Die Wiederholbarkeit der Messung ist durchgehend hoch: Die Streuung innerhalb jeder Messreihe beträgt lediglich ca. 0,1 g bis 0,2 g, was auf eine stabile und rauscharme Signalverarbeitung hinweist. Die absolute Genauigkeit hingegen weist erhebliche Abweichungen auf. Besonders auffällig ist die Mittenbelastung mit 3 kg, bei der ein Messwert von rund 3206 g statt 3000 g ausgegeben wird – eine Abweichung von uber 6 %. ¨

Position Referenz Messwerte (g) Mittelwert (g) Abweichung (g)

Ecke 1 | 1000,0 g | 1020,5 – 1020,7 | 1020,6 | +20,6
Ecke 2 | 1000,0 g | 975,4 – 975,7 | 975,5 | −24,5
Ecke 3 | 1000,0 g | 996,6 – 996,7 | 996,6 | −3,4
Ecke 4 | 1000,0 g | 999,9 – 1000,2 | 1000,0 | ±0,0
Mitte | 1000,0 g | 1033,2 – 1035,6 | 1035,1 | +35,1
Mitte | 3000,0 g | 3205,6 – 3205,8 | 3205,6 | +205,6

Tabelle 10: Messreihe optimiertes Design: Messwerte an verschiedenen Positionen

Mechanische Einflusse. ¨ | Neben der Kalibrierung tragen auch mechanische Unzulänglichkeiten
des Prototyps zum Messfehler bei. Die vier Wägezellen sind nicht exakt symmetrisch verbaut, da die Waage mit Heisskleber fixiert wurde und dadurch geringfugig in der Ho- ¨ rizontalen geneigt ist. Zusätzlich streift die Wägezelle an Ecke 4 leicht den Rand des 3D-gedruckten Gehäuses, was deren Messwert mechanisch beeinflusst. Diese Effekte erklären, weshalb die positionsabhängigen Abweichungen stark variieren und keine konsistente Offset-Korrektur durch einfache Nachkalibrierung möglich ist.
Fehlende Transientunterdruckung. ¨ | Ein weiteres Problem tritt beim Aufbringen oder
Abnehmen eines Gewichts auf: Während des Ubergangs werden transiente Messwerte aus- ¨
gelesen und ungefiltert an das Backend ubermittelt. In einem Logistiksystem f ¨ | uhrt dies ¨
dazu, dass der erfasste Lagerbestand kurzzeitig falsche Werte annimmt und hin- und herspringt, bis sich die Waage wieder einschwingt. Eine softwareseitige Filterung – etwa
durch eine Schwellwertentscheidung auf Basis der zeitlichen Anderungsrate – w ¨ | äre not-
wendig, um stabile Messwerte zu gewährleisten, wurde im Rahmen dieser Arbeit jedoch nicht mehr umgesetzt.

## 5 Geräteubersicht ¨

Abbildung 12 zeigt die beiden Prototypen nebeneinander: links die neue Waage (optimiertes Design, rosa Gehäuse) mit drei Bedientastern und verbesserter Elektronik, rechts die Ausgangslage aus der Vorgängerarbeit [4] (schwarzes Gehäuse, ohne Bedienelemente). Beide Geräte verfugen ¨ uber ein E-Paper-Display zur Statusanzeige. ¨

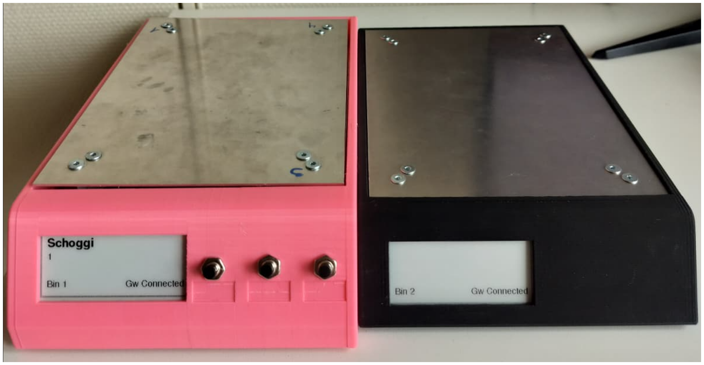
[picture p11: figure]

Abbildung 12: Geräteubersicht: neue Waage (links, rosa) und Vorg ¨ | | ängerprototyp (rechts,
schwarz)

## 6 PCB-Design

Das PCB-Layout und der vollständige Schaltplan sind im Anhang dokumentiert. Dieses Kapitel beschreibt die wesentlichen Designentscheidungen sowie die im Rahmen der Arbeit identifizierten Schwachstellen des realisierten Boards.

ADS1234 Der Einsatz des ADS1234 hat sich als richtige Entscheidung erwiesen. Dank seiner 24-Bit-Auflösung und vier unabhängigen Eingangskanälen ermöglicht er hochgenaue Einzelkanalmessungen sowie die in Abschnitt 4.2 beschriebene Ecklastkompensation.

ADS1234 – Hardware-Filterung Im PCB wurde ein analoger Filterschaltkreis (RC-Tiefpass) vor den Differenzeingängen des ADS1234 vorgesehen, jedoch nicht bestuckt und ¨
nicht weiter untersucht. Die entsprechenden Bestuckungspl ¨ | ätze wurden fur den Betrieb ¨
mit Lötzinn uberbr ¨ | uckt. ¨

Temperatursensor SHT30 Ein SHT30-Temperatursensor wurde in das PCB integriert, um temperaturbedingte Messfehler der Wägezellen softwareseitig kompensieren zu können. Die Hardwareanbindung (I²C) ist vollständig implementiert; eine softwareseitige Auswertung wurde im Rahmen dieser Arbeit nicht realisiert.

TPS62842 Buck-Converter Fur das PCB wurde der TPS62842 als Schaltregler gew ¨ | ählt,
um die Versorgungsspannung direkt auf die fur den ESP32 ben ¨ | ötigten 3.0 V zu regeln –
in der Annahme, der LM2596S könne nicht unter 5 V regeln. Dass der TPS62842 mit einer maximalen Eingangsspannung von 6.5 V fur den direkten Betrieb an der Batterie ¨ (Nennspannung 7.4 V, max. 8.4 V) ungeeignet ist, war dabei bekannt und wäre in einer Folgerevision zu adressieren gewesen. Der eigentliche Irrtum wurde erst gegen Ende der Arbeit erkannt: Der LM2596S kann die Ausgangsspannung durchaus auf 3.0 V absenken
– der TPS62842 wäre damit uberfl ¨ | ussig. Die gravierendere, ebenfalls erst sp ¨ | ät erkannte

Schwäche ist die schlechte Effizienz des LM2596S bei Leichtlast, die massgeblich fur den ¨ hohen Ruhestrom im Deep Sleep verantwortlich ist (vgl. Abschnitt 3.7.2).

Messpunkte (Power-Header) Auf dem PCB wurden 2×1-Pin-Header als Strommess-Breakouts in die Versorgungspfade der einzelnen Verbraucher eingeschleift. Diese Messpunkte haben sich bei der Leistungsanalyse als äusserst hilfreich erwiesen, da sie den direkten Anschluss des JouleScope ohne Unterbrechung der Leiterbahnen ermöglichen.

## 7 Messungen

### 7.1 Low-Power Analyse und Optimierung

### 7.1.1 Reduktion Versorgungsspannung 3,3 V auf 3,0 V

Da der ESP32 gemäss Datenblatt bei einer Versorgungsspannung von 3.0 V bis 3.6 V zuverlässig betrieben werden kann, wurde die Ausgangsspannung des Buck-Converters im neuen System von 3.3 V auf 3.0 V abgesenkt. Abbildung 13 und 14 zeigen den am Buck-
Converter-Ausgang gemessenen Energieverbrauch fur einen vollst ¨ | ändigen Aktivzyklus –
einmal mit 3.3 V und einmal mit 3.0 V Ausgangsspannung.

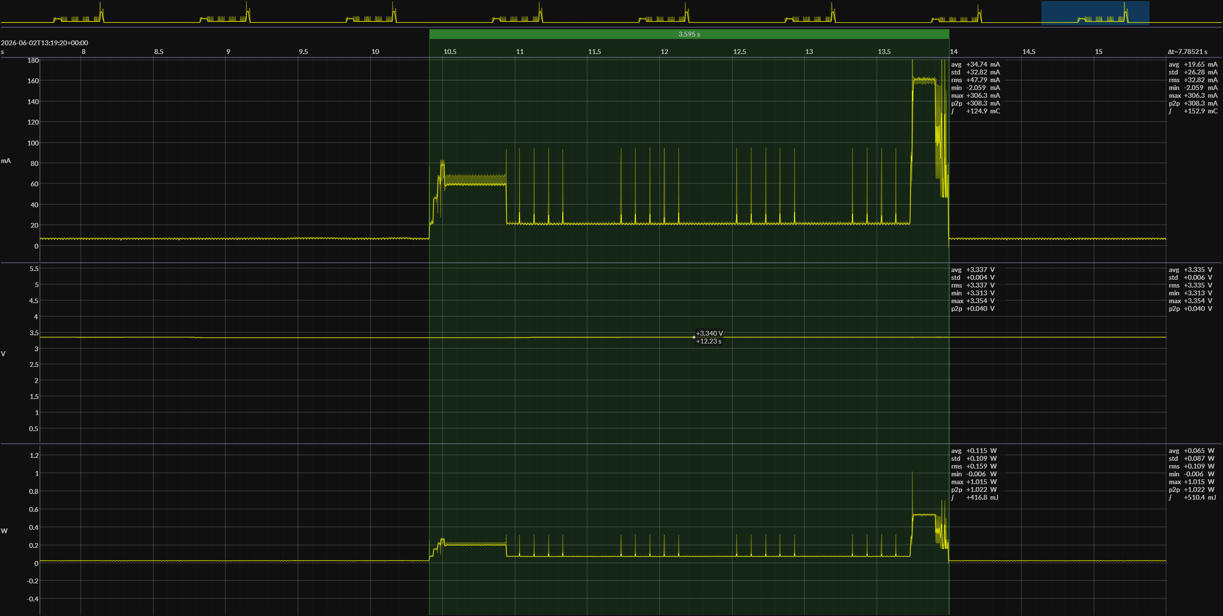
[picture p12: figure]

Abbildung 13: Messpunkt: nach Buck-Converter, Ausgang 3.3 V – neues System; Verbrauch: 416.8 mJ

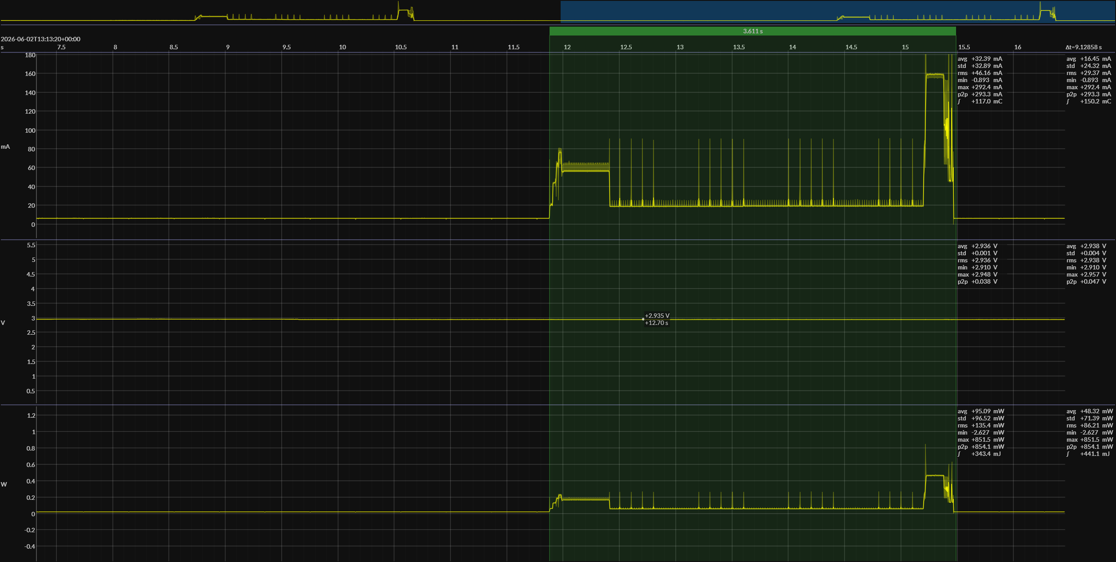
[picture p13: figure]

Abbildung 14: Messpunkt: nach Buck-Converter, Ausgang 3.0 V – neues System; Verbrauch: 343.4 mJ

Die Reduktion der Versorgungsspannung um 0.3 V ergibt eine Energieeinsparung von 73.4 mJ pro Zyklus, was einer Verbesserung von 17.6 % entspricht. Der Grund ist, dass der ESP32 bei niedrigerer Versorgungsspannung weniger Leistung aufnimmt.

### 7.1.2 Vergleich Energieverbrauch Aktiver Zyklus

ESP32 uber 3V3-Pin ¨ | Der Messpunkt liegt direkt am 3V3-Versorgungspin des ESP32.
In der Ausgangslage wird der ESP32 mit 3.3 V gespeist, was dem Ausgang des internen Board-LDO entspricht. Im optimierten System entfällt der LDO; die Speisung erfolgt
direkt uber den 3V3-Pin mit 3 ¨ | .0 V.

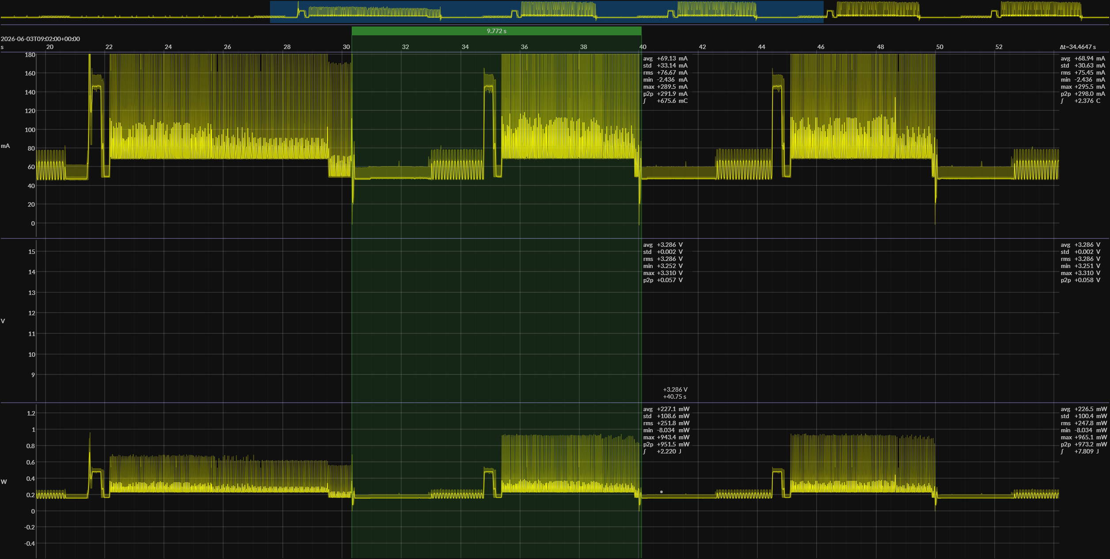
[picture p14: figure]

Abbildung 15: Messpunkt: vor ESP32 3V3-Pin – Ausgangslage; Wert: 2220 mJ

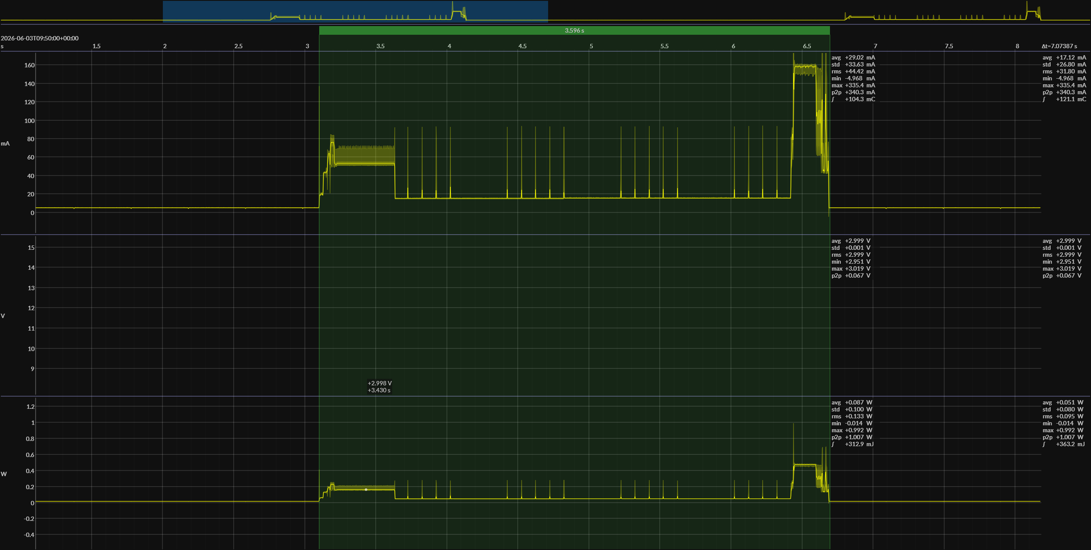
[picture p15: figure]

Abbildung 16: Messpunkt: vor ESP32 3V3-Pin – Optimiertes System; Wert: 312.9 mJ

Dehnmessstreifen In der Ausgangslage sind die Wägezellen dauerhaft mit Spannung versorgt. Der gemessene Leistungsverbrauch von 78.19 mW (Abb. 36) ergibt uber die ¨ aktive Zyklusdauer von 10 s einen Energiebedarf von:

PDMS × taktiv = 78.19 mW × 10 s = 781.9 mJ

Im optimierten System wird der DMS-Anteil indirekt als Differenz zweier Messungen am 3V3-Pin bestimmt – einmal mit und einmal ohne eingeschaltete Dehnmessstreifen:

EDMS = Emit DMS − Eohne DMS = 312.9 mJ − 223.8 mJ = 89.1 mJ

Abbildung 17: Ganzer Zyklus mit DMS – Optimiertes System; Wert: 312.9 mJ

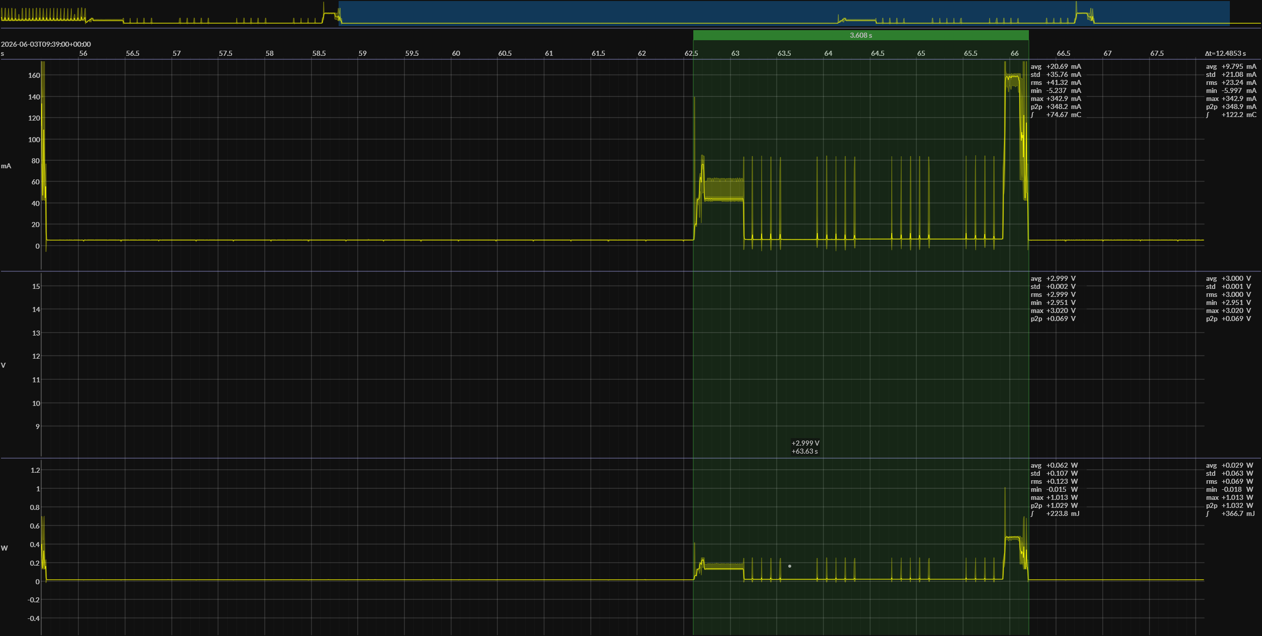
[picture p16: figure]

Abbildung 18: Ganzer Zyklus ohne DMS – Optimiertes System; Wert: 223.8 mJ

ADC Der Energiebedarf des ADC wird direkt am Versorgungspin des jeweiligen Chips gemessen.

Abbildung 19: Messpunkt: vor HX711 VIN-Pin – Ausgangslage; Wert: 106.2 mJ

Abbildung 20: Messpunkt: vor ADS1234 AVDD/DVDD-Pin – Optimiertes System; Wert: 13.42 mJ

Verluste Umwandlung Die Verluste des LDO (Ausgangslage) sowie des Buck-Converters werden in den Abschnitten 7.1.4 und 3.7.2 hergeleitet und in Tabelle 4 ubernommen. ¨

### 7.1.3 Vergleich Energieverbrauch ESP32

Dieser Abschnitt dokumentiert die JouleScope-Messungen am ESP32-3V3-Pin pro Betriebsphase (ohne DMS und LDO). Um Software- und Hardwareeinflusse zu trennen, ¨
wurde das alte System fur diesen Vergleich ebenfalls mit 3 ¨ | .0 V am 3V3-Pin gespeist; die
Gesamtsystemmessungen (Tabelle 4) verwenden hingegen die reale Systemkonfiguration (3.3 V im alten, 3.0 V im neuen System). Da der ADS1234 am gleichen Rail angeschlossen ist, enthält jede Phasenmessung des neuen Systems dessen Anteil. Fur den fairen Vergleich ¨ wird der gemessene ADS1234-Anteil von 13.42 mJ von allen Neu-Werten abgezogen; die bereinigten Werte entsprechen Tabelle 6.

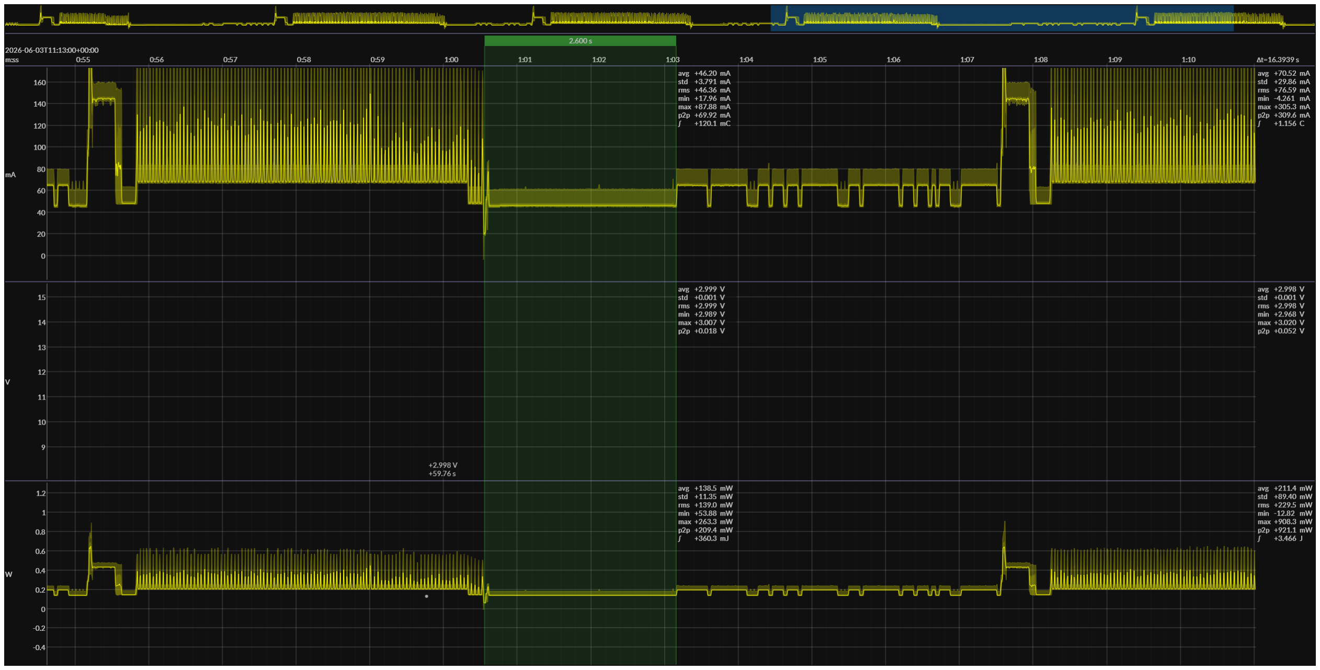
[picture p17: figure]

Abbildung 21: Boot – Ausgangslage; 360.3 mJ

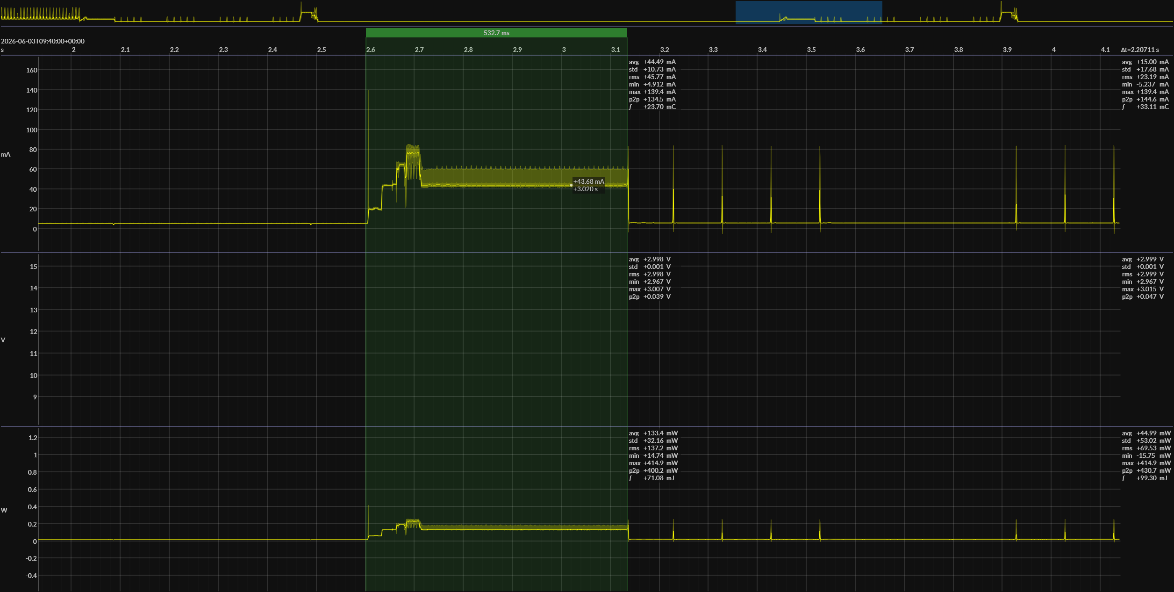
[picture p18: figure]

Abbildung 22: Boot – Optimiertes System; 71.08 mJ

Boot und Ramp-up

EBoot, ber. = 71.08 mJ − 13.42 mJ = 57.66 mJ

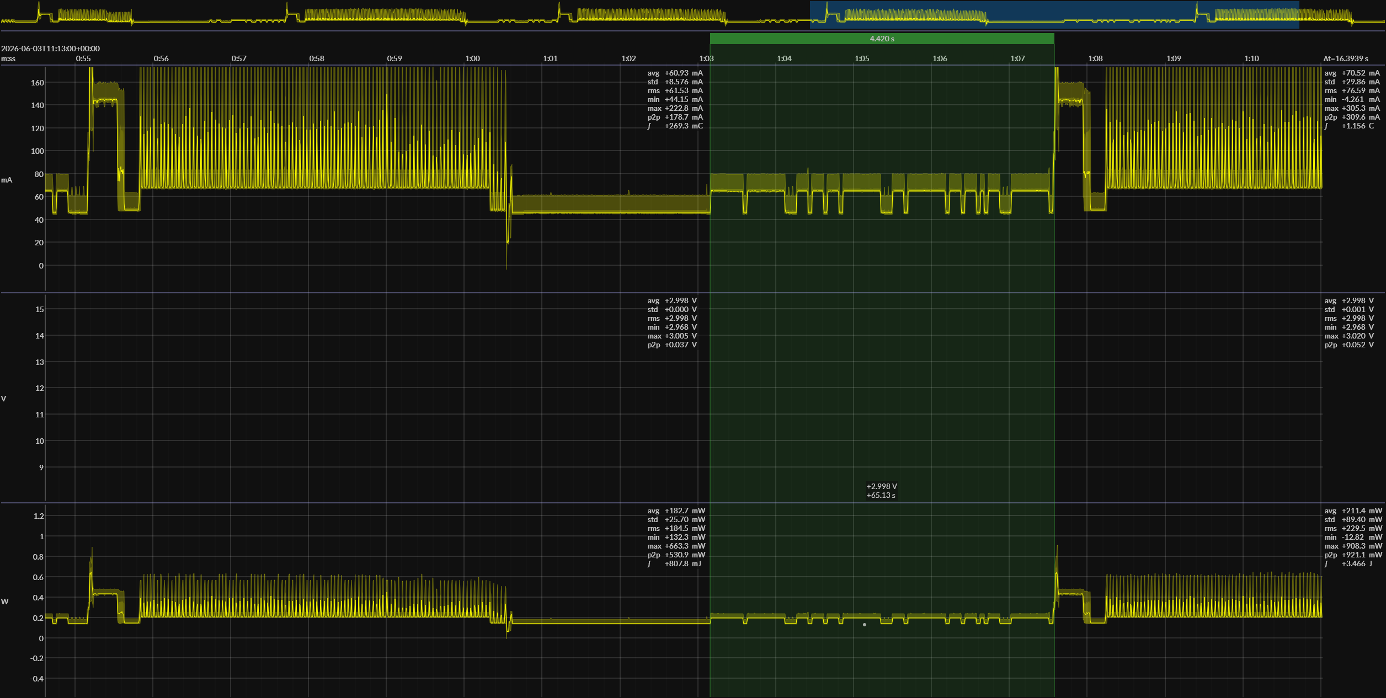
[picture p19: figure]

Abbildung 23: ADC-Phase – Ausgangslage; 807.8 mJ

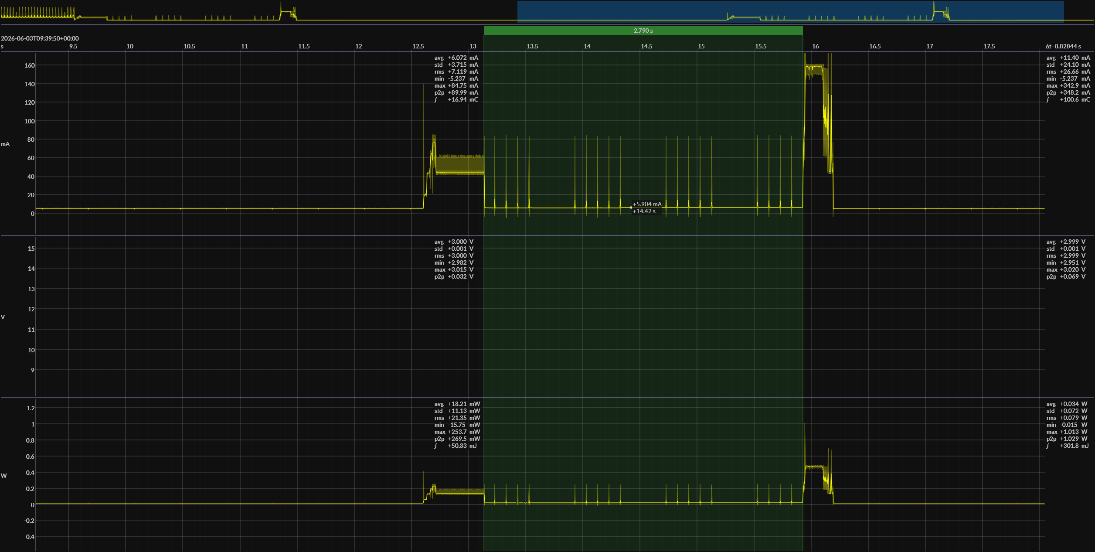
[picture p20: figure]

Abbildung 24: ADC-Phase – Optimiertes System; 50.83 mJ

ADC-Messung
EADC, ber. = 50.83 mJ − 13.42 mJ = 37.41 mJ

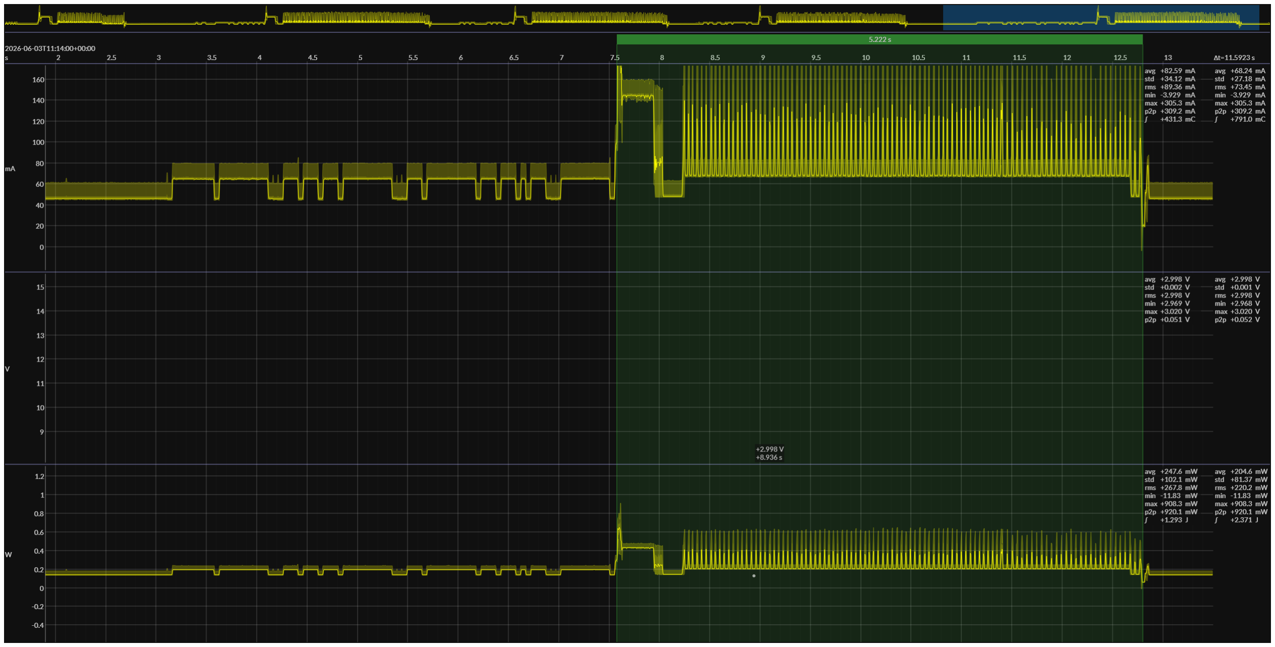
[picture p21: figure]

Abbildung 25: BLE-Phase – Ausgangslage; 1293 mJ

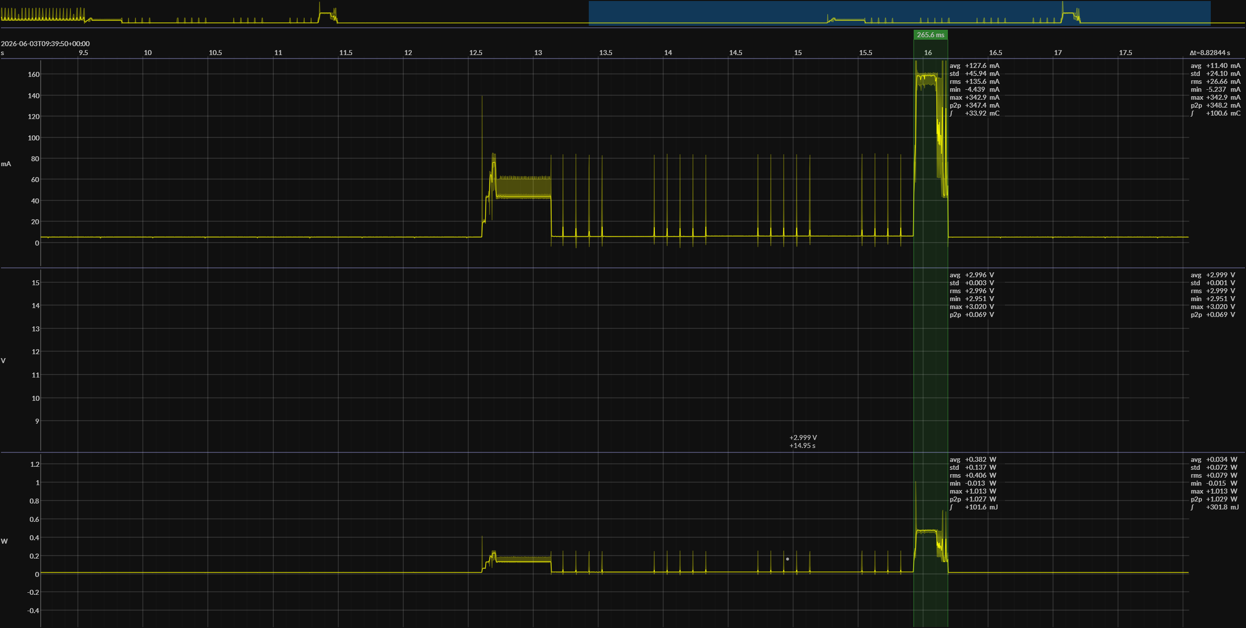
[picture p22: figure]

Abbildung 26: BLE-Phase – Optimiertes System; 101.6 mJ

BLE
EBLE, ber. = 101.6 mJ − 13.42 mJ = 88.18 mJ

ADS1234 Chip (nur neues System) Im alten System befand sich der HX711 ausserhalb des Messpfades und wurde nicht separat erfasst. Im neuen System ist der ADS1234 am selben 3,0 V-Rail angeschlossen; sein Gesamtanteil pro Zyklus wird separat uber den ¨ AVDD/DVDD-Pin gemessen und als Korrekturterm von allen Phasenmessungen abgezogen.

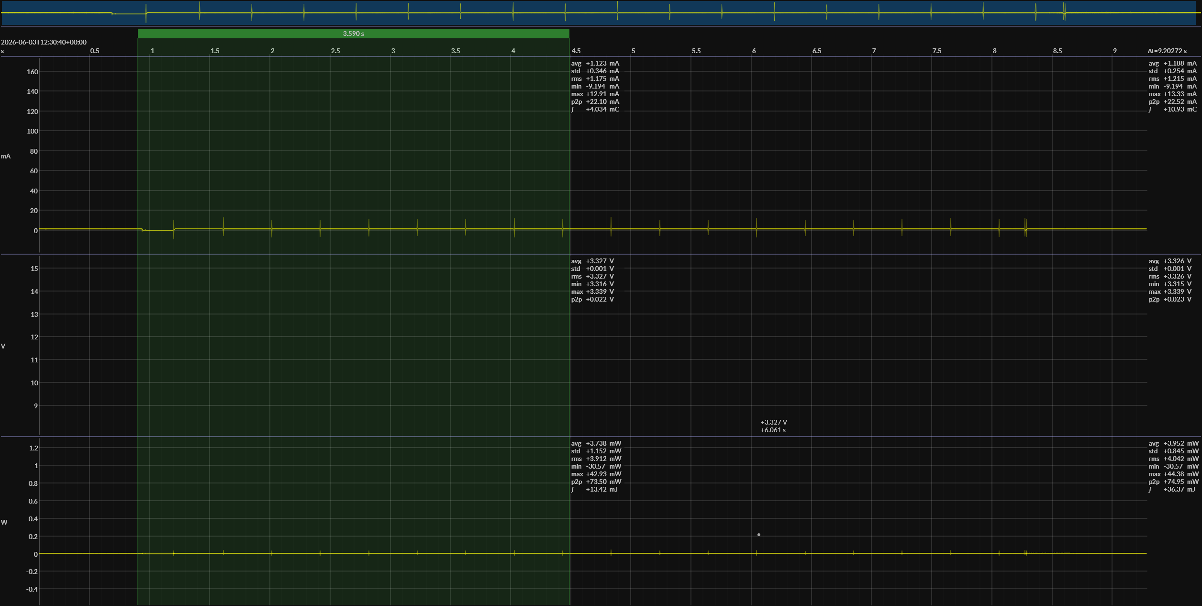
[picture p23: figure]

Abbildung 27: ADS1234 Chip – Optimiertes System; 13.42 mJ

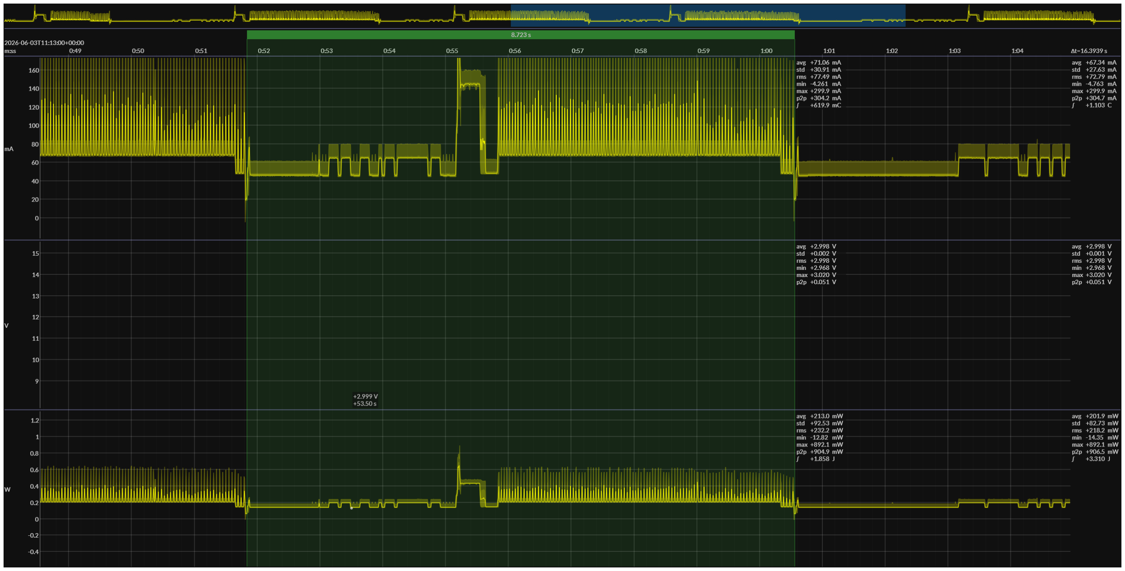
[picture p24: figure]

Abbildung 28: Ganzer Zyklus – Ausgangslage; 1858 mJ

Abbildung 29: Ganzer Zyklus – Optimiertes System; 223.8 mJ

Ganzer Zyklus
EZyklus, ber. = 223.8 mJ − 13.42 mJ = 210.4 mJ

### 7.1.4 Verluste Hardware

Buck-Converter Die Messungen erfassen jeweils die Energie vor (Batterieseite) und
nach (Power-Rail) dem LM2596S-Schaltregler uber einen vollst ¨ | ändigen Zyklus. Die Her-
leitung des Wirkungsgrads sowie die Verlustberechnung finden sich in Abschnitt 3.7.2. Vor dem Buck-Converter (Batterieseite):

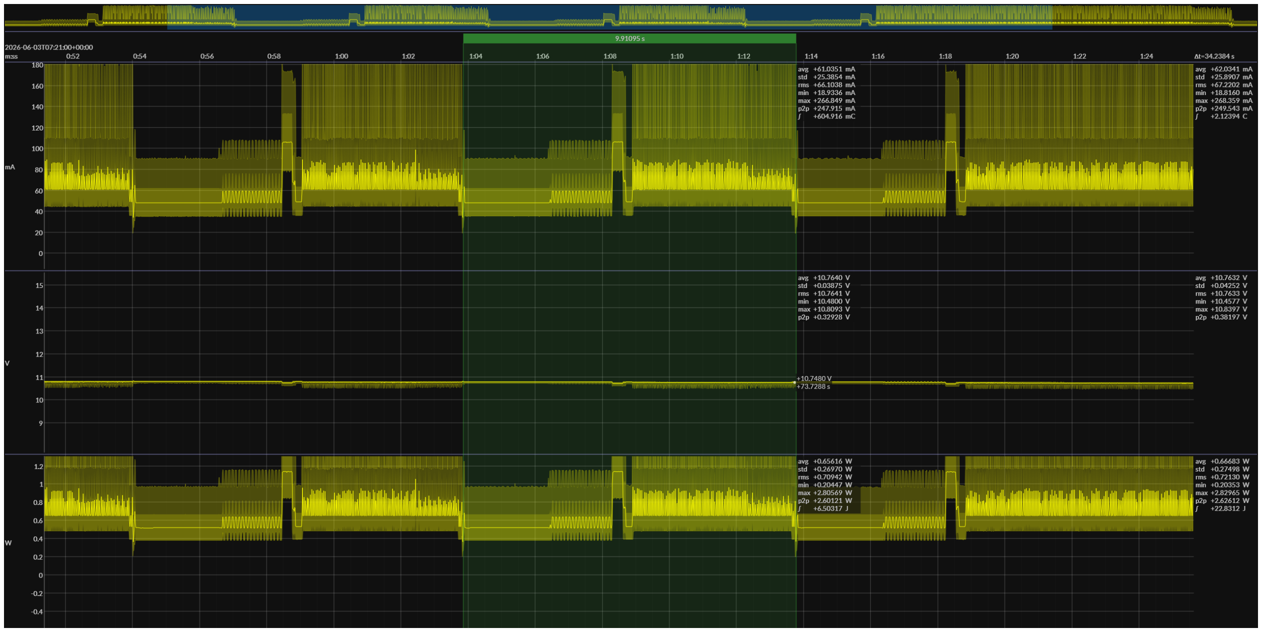
[picture p25: figure]

Abbildung 30: Vor Buck-Converter – Ausgangslage; 6503 mJ

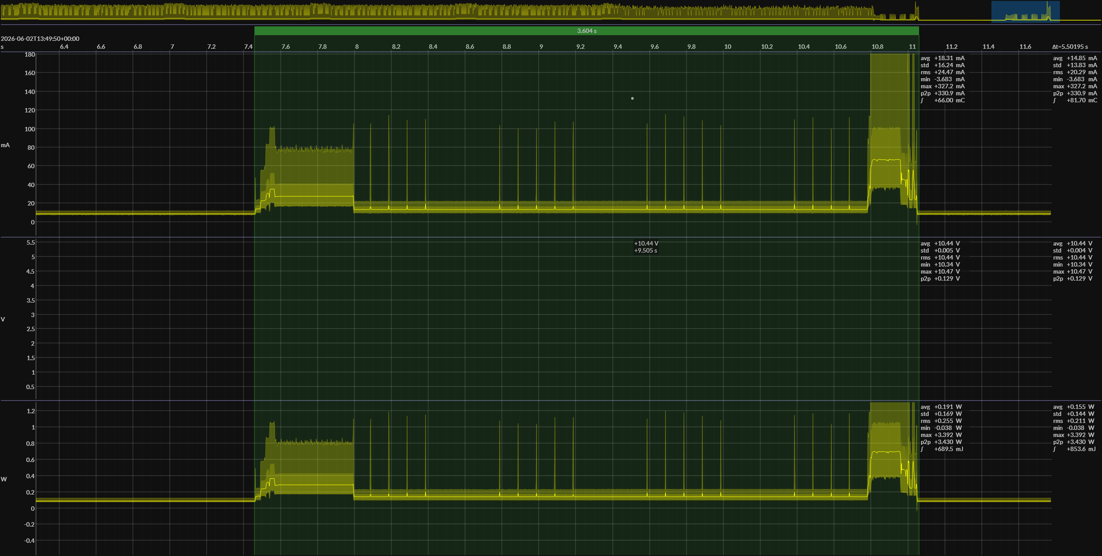
[picture p26: figure]

Abbildung 31: Vor Buck-Converter – Optimiertes System; 689.5 mJ

Nach dem Buck-Converter (Power-Rail):

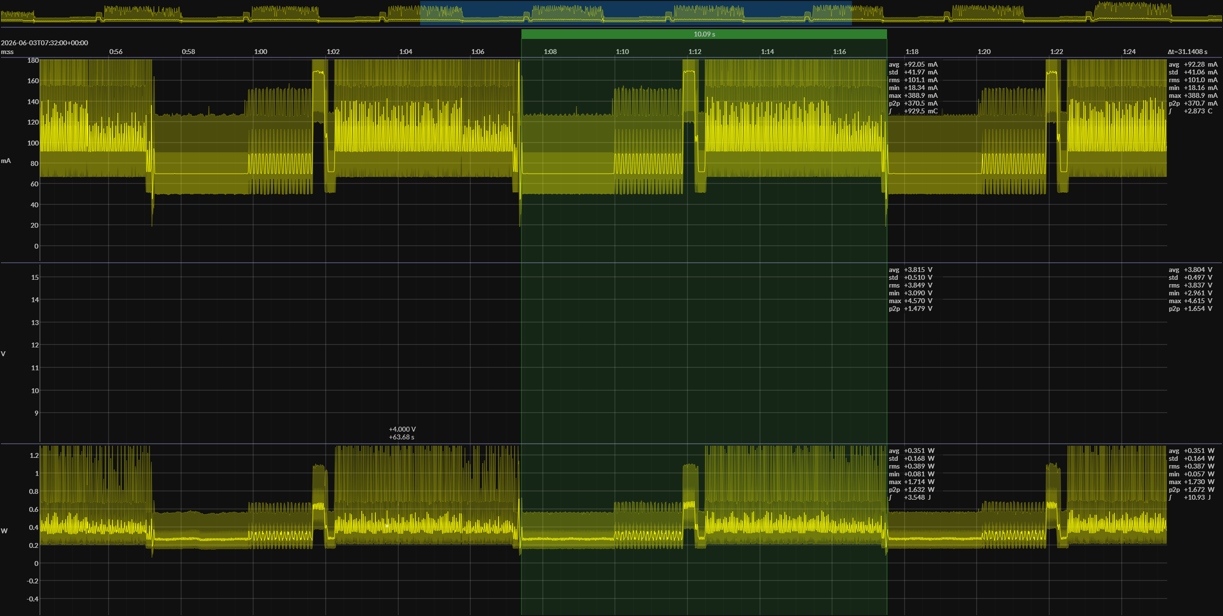
[picture p27: figure]

Abbildung 32: Nach Buck-Converter – Ausgangslage; 3548 mJ

Abbildung 33: Nach Buck-Converter – Optimiertes System; 343.4 mJ

LDO Der LDO ist ausschliesslich in der Ausgangslage relevant; das optimierte System
speist den ESP32 direkt uber den ¨ | 3V3-Pin ein und umgeht den LDO vollständig.

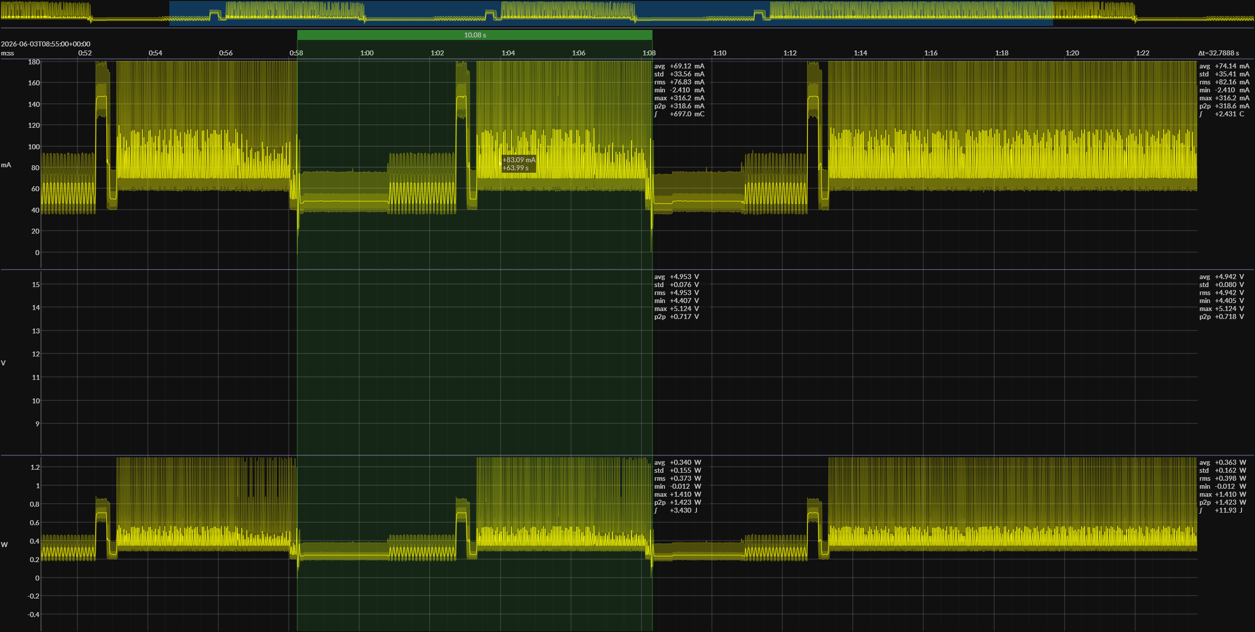
[picture p28: figure]

Abbildung 34: Vor LDO (VIN-Pin) – Ausgangslage; 3430 mJ

Abbildung 35: Nach LDO (3V3-Pin) – Ausgangslage; 2220 mJ

### 7.1.5 Vergleich Leistungsverbrauch Deep-Sleep

Dehnmessstreifen In der Ausgangslage sind die Wägezellen dauerhaft mit Spannung versorgt und verbrauchen auch im Tiefschlaf 78.19 mW. Im optimierten System werden sie
vor dem Deep Sleep uber den MOSFET vollst ¨ | ändig abgeschaltet; ihr Beitrag im Tiefschlaf
entfällt damit ersatzlos.

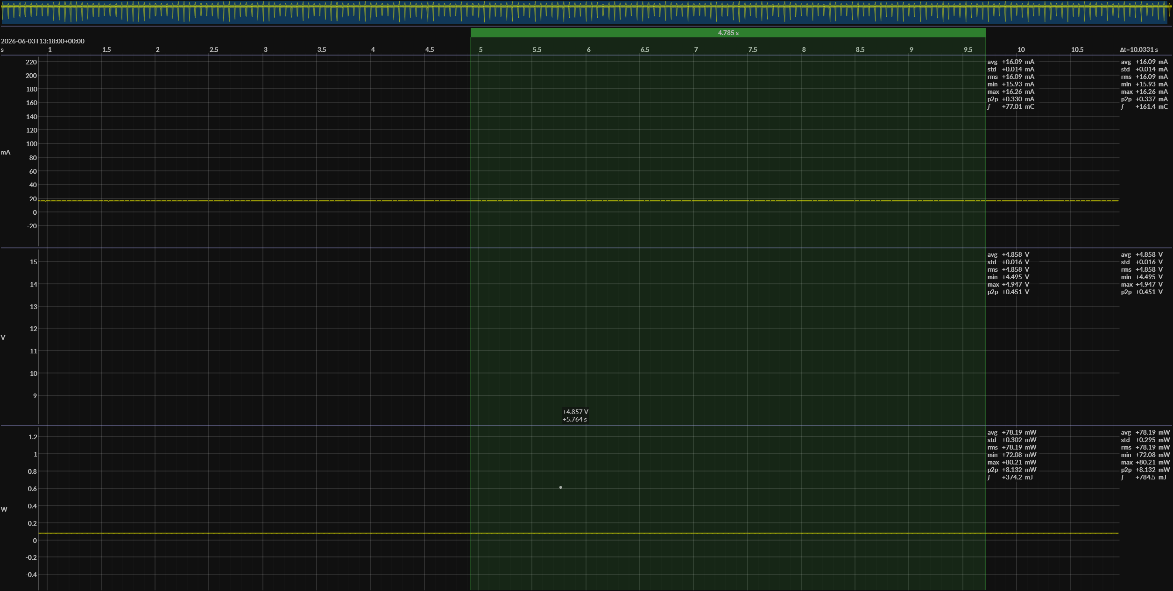
[picture p29: figure]

Abbildung 36: Messpunkt: vor DMS – Aus-
gangslage; 78.19 mW | → Entfällt
| MOSFET schaltet Versorgung vor Deep Sleep ab.

ADC-Chip Der ADS1234 verbraucht im Tiefschlaf 9.762 mW in der Ausgangslage. Im optimierten System konnte dieser Wert auf 4.042 mW gesenkt werden. Ein vollständiges Abschalten ist jedoch nicht möglich, da kein Hardware-Pull-down am !PDWN-Pin verbaut ist und der GPIO im Deep Sleep floaten kann.

Abbildung 37: ADC-Chip im Deep Sleep – Ausgangslage (HX711); 9.762 mW

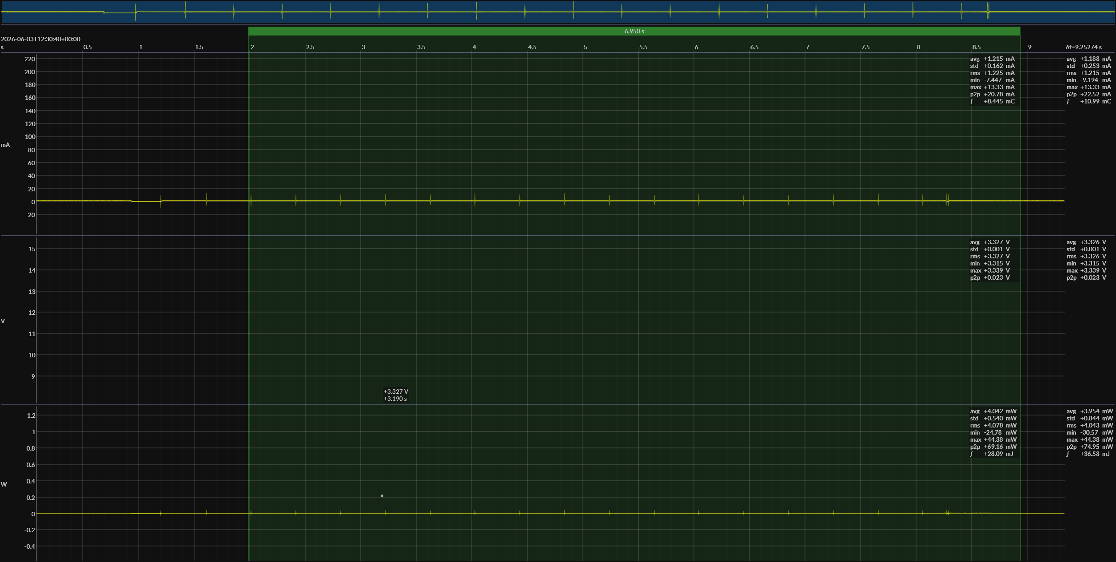
[picture p30: figure]

Abbildung 38: ADC-Chip im Deep Sleep – Optimiertes System (ADS1234); 4.042 mW

Vor Buck-Converter (Gesamtsystem im Deep Sleep) Die Messungen vor dem Buck-Converter erfassen den vollständigen Ruhestrom des Systems auf Batterieebene – einschliesslich aller Buck-Converter-Verluste.

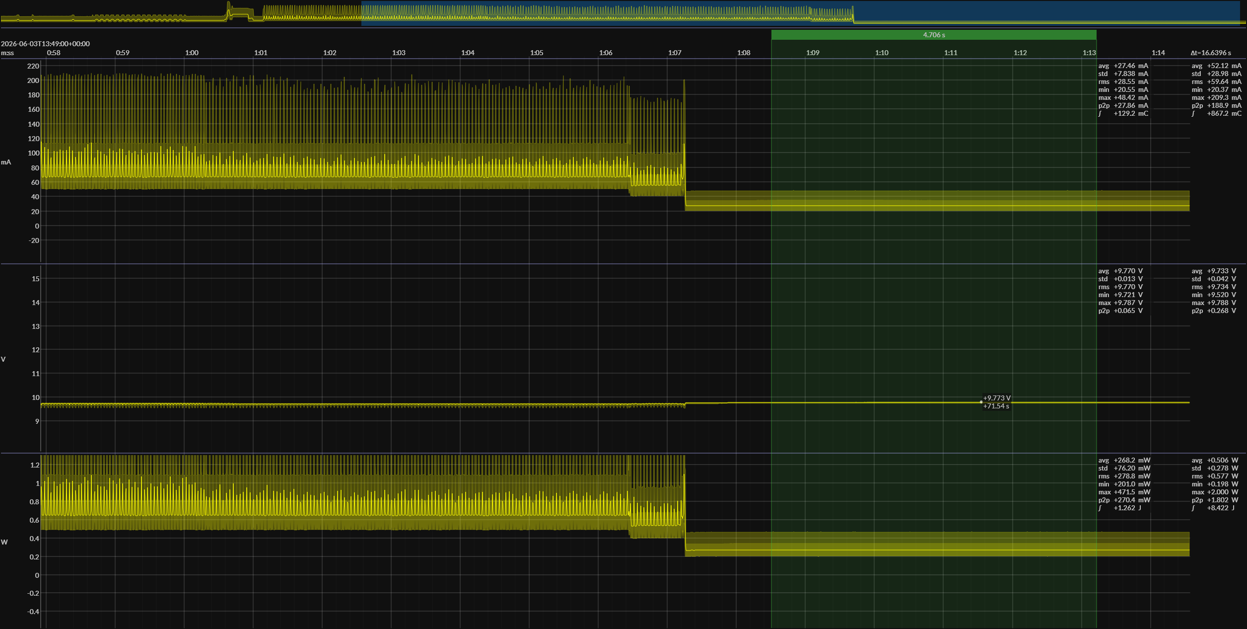
[picture p31: figure]

Abbildung 39: Vor Buck-Converter im Deep Sleep – Ausgangslage; 268.2 mW

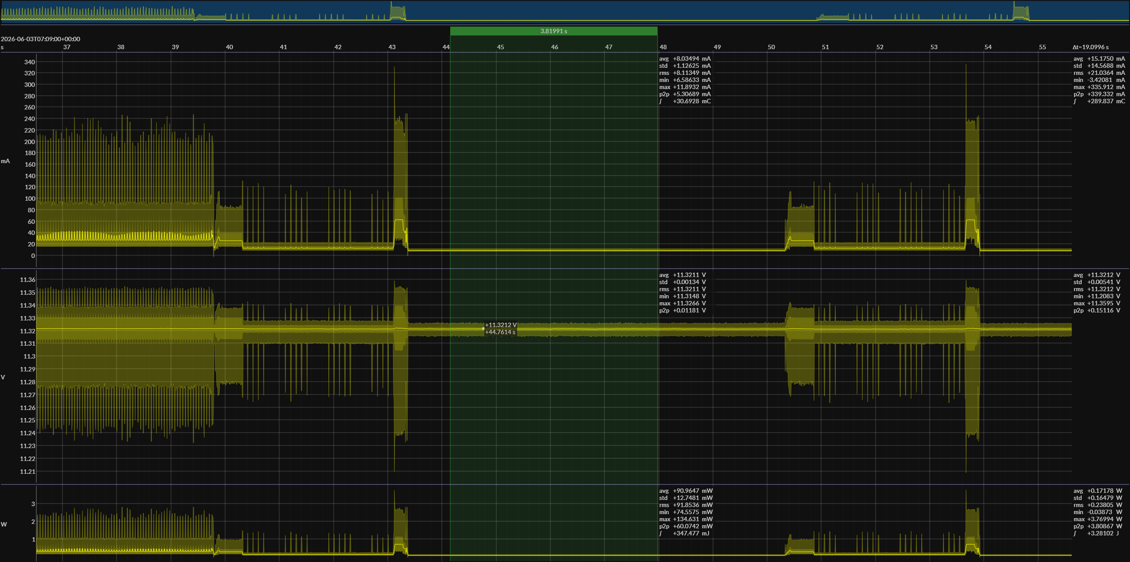
[picture p32: figure]

Abbildung 40: Vor Buck-Converter im Deep Sleep – Optimiertes System; 90.96 mW

Buck-Converter Leerlaufverlust Abbildung 41 zeigt den Eigenverbrauch des LM2596S ohne angeschlossene Last. Mit 69.77 mW ubersteigt dieser Leerlaufverlust bereits den Ge- ¨ samtverbrauch aller Verbraucher des neuen Systems (14.19 mW) um das Funffache. ¨

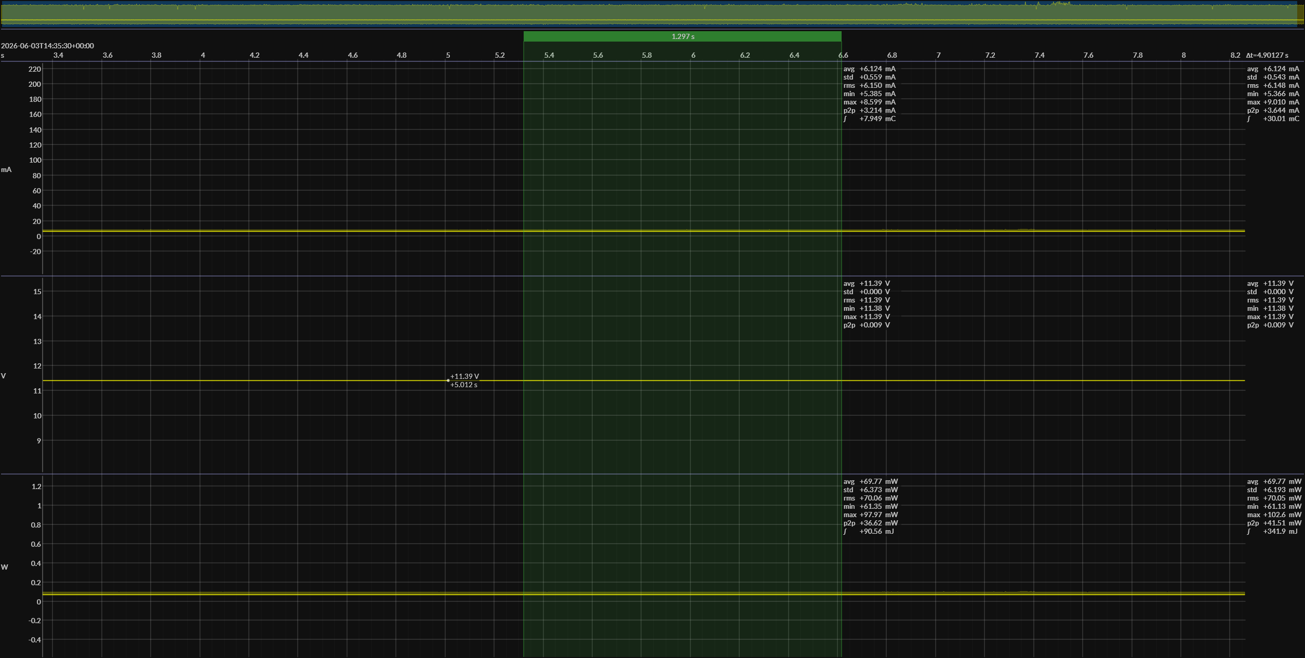
[picture p33: figure]

Abbildung 41: LM2596S Leerlaufverlust (kein Verbraucher angeschlossen); 69.77 mW

## 8 Fazit, Diskussion und Ausblick

### 8.1 Fazit

Diese Arbeit hatte zwei Schwerpunkte: die Optimierung des Energieverbrauchs und die Verbesserung der Messgenauigkeit einer ESP32-basierten Smart-Waage fur die industrielle ¨ Inventarisierung.

Energieoptimierung. Durch den kombinierten Einsatz von Hardware- und Softwaremassnahmen konnte der Energieverbrauch pro Aktivzyklus von 6503 mJ auf 689.5 mJ gesenkt werden, was einer Reduktion von 89,4 % entspricht. Die wirkungsvollsten Einzelmassnahmen waren der Entfall des internen Board-LDOs durch direkte Einspeisung uber ¨ den 3V3-Pin (1210 mJ gespart) sowie die Migration des BLE-Stacks von der Arduino-BLE-Bibliothek auf NimbleBLE, welche die Aktivzeit der Funkphase erheblich verkurzte. ¨ Die MOSFET-Abschaltung der Dehnmessstreifen im Tiefschlaf sowie die Reduktion der Buck-Converter-Ausgangsspannung von 3.3 V auf 3.0 V leisteten weitere messbare Bei-
träge. Auf Batterieebene steigt die Laufzeit gegenuber der Ausgangslage von ca. ¨ | 3 Tagen
auf ca. 12 Tagen – eine Verbesserung um den Faktor 4 (vgl. Tabelle 7).

Messgenauigkeit. Der Wechsel von einem summierten Einzelkanal auf vier individuelle ADS1234-Kanäle mit separater Kalibrierung pro Sensor ermöglicht erstmals eine Ecklastkompensation. Die Wiederholbarkeit der Messung ist mit ± 0,1 g gut; die absolute Genauigkeit ist jedoch aufgrund einer unzureichenden Kalibrierung und mechanischer Mängel des Prototypen eingeschränkt – bei Mittenbelastung mit 3 kg wurden bis zu 205 g Abweichung gemessen.

### 8.2 Kritische Beurteilung

Trotz der erzielten Fortschritte weist das System eine Reihe fundamentaler Schwächen auf, die einer praxistauglichen Umsetzung entgegenstehen.

Entwicklungsboard und Sleep-Strom. Die Entscheidung, das SBC-NodeMCU-ESP32-C-Entwicklungsboard beizubehalten, war pragmatisch, erweist sich aber als grösste Limitierung des Systems. Das Board verbraucht im Deep Sleep ca. 13.75 mA am 3,3 V-Rail – massgeblich verursacht durch den dauernd aktiven CP2102-USB-UART-Chip, den internen LDO und die Power-LED, die auch im Tiefschlaf nicht abgeschaltet werden können. Zum Vergleich: das nRF52840 erreicht im System-OFF-Modus 0.4 µA – einen um den Faktor 34 000 niedrigeren Ruhestrom. Die Folge ist, dass der Sleep-Strom die Energiebilanz vollständig dominiert: Die berechnete Batterielaufzeit ist nahezu unabhängig vom Messintervall (12–13 Tage bei 1 min bis 30 min Intervall), was den Nutzen längerer Schlafphasen zunichtemacht. In einem realen Logistiksystem, das auf Batterie läuft, macht dieses Board das Produkt in der vorliegenden Form nicht industrietauglich.

ADC-Ruhestrom durch fehlenden Pull-down. Der !PDWN-Pin des ADS1234 wird im Deep Sleep nicht durch einen Hardware-Pull-down auf LOW gehalten. Da der GPIO im unkonfigurierten Zustand floaten oder auf HIGH gezogen sein kann, bleibt der ADC möglicherweise aktiv und verbraucht unnötig ca. 1 mA im Schlaf. Dieser Fehler hätte mit einem einzigen Pull-down-Widerstand auf der Platine behoben werden können.

Ineffizienter Buck-Converter. Der eingesetzte LM2596S ist fur den vorliegenden An- ¨ wendungsfall ungeeignet. Sein Leerlaufverbrauch beträgt 69.77 mW – fast funfmal so viel ¨ wie der Gesamtverbrauch des neuen Systems im Tiefschlaf (14.19 mW). Bei der im Tiefschlaf anliegenden Teillast sinkt der Wirkungsgrad auf unter 50 %, was bedeutet, dass mehr Energie im Schaltregler verheizt als an die Last geliefert wird. Dieser Umstand wurde erst spät im Projektverlauf erkannt und konnte nicht mehr behoben werden. In Kombination mit dem hohen Board-Sleep-Strom ist der LM2596S der zweitgrösste Energiefresser des Systems. Hinzu kommt, dass keine geeignete Kombination aus effizientem Schaltregler und passendem Akku-Setup evaluiert werden konnte; die in Abschnitt 3.8 berechnete Batterielaufzeit basiert daher auf dem vorhandenen, ineffizienten LM2596S und ist nicht repräsentativ fur eine optimierte Hardwarekonfiguration. ¨

Nicht evaluierte Muss-Ziele. Zwei Muss-Ziele gemäss Projektvereinbarung wurden
nicht erfullt. Die Evaluation der Energiequelle (Batterie vs. Akku) wurde vernachl ¨ | ässigt;
eine strukturierte Gegenuberstellung unter realistischen Lastprofilen h ¨ | ätte die Laufzeit-
berechnung auf eine solidere Grundlage gestellt. Die Evaluation des Kommunikationsprotokolls ESP-NOW wurde bewusst nicht durchgefuhrt: Da eine professionelle Waage ¨ langfristig auf ein energieeffizientes Custom-PCB mit einem nRF-Chip migriert werden sollte – wie im Ausblick beschrieben – und ESP-NOW auf nRF-Chips nicht verfugbar ¨ ist, wäre eine Implementierung auf dem ESP32 eine sackgassenartige Optimierung ohne Zukunft.
Messgenauigkeit. Die aktuelle Kalibrierung genugt nicht f ¨ | ur den produktiven Einsatz. ¨
Die positionsabhängigen Abweichungen (bis −24,5 g an Ecke 2 und +35 g bei Mittenbe-
lastung mit 1 kg) sowie die stark ausgeprägte Ubersch ¨ | ätzung bei 3 kg zeigen, dass die
Kalibrierstrategie und die mechanische Ausfuhrung des Prototypen ¨ | uberarbeitet werden ¨
mussen. Zudem fehlt eine Transientunterdr ¨ | uckung: Beim Aufbringen oder Abnehmen von ¨
Gewicht werden instabile Messwerte ungefiltert ans Backend ubermittelt, was im Logi- ¨ stiksystem zu Bestandsschwankungen fuhrt. ¨

### 8.3 Ausblick

Die vorliegende Arbeit legt eine solide Grundlage, lässt aber klare Ansatzpunkte fur fol- ¨ gende Arbeiten offen.

Plattformwechsel. Der wirkungsvollste einzelne Schritt wäre der Wechsel auf eine Hardware-Plattform mit minimalem Sleep-Strom. Das nRF52840 wäre mit 0.4 µA System-OFF-Strom ideal; alternativ bietet der ESP32-C3 mit 5 µA Deep-Sleep auf einem schlanken Custom-Board einen guten Kompromiss bei geringerem Portierungsaufwand.

Buck-Converter und Energiequelle. Der LM2596S muss durch einen modernen Schaltregler mit niedrigem Quiescent-Strom und Leichtlast-Optimierung (z. B. PFM-Modus) ersetzt werden; die konkrete Bauteilwahl muss mit dem endgultigen Akku-Setup (Zel- ¨ lanzahl, Spannungsbereich) abgestimmt werden. Parallel dazu sollte eine strukturierte Evaluation der Energiequelle (Lithium-Polymer-Akku vs. Primärzelle) unter realistischen Zyklusbedingungen durchgefuhrt werden. ¨

ADC-Abschaltung. Ein Hardware-Pull-down-Widerstand auf dem !PDWN-Pin des ADS1234 stellt sicher, dass der ADC im Deep Sleep vollständig abgeschaltet ist und keine unnötigen
1 mA verbraucht.

Messgenauigkeit und Mechanik. Eine uberarbeitete Kalibrierung – idealerweise mit ¨ positionsabhängiger Gewichtung der vier Kanäle – sowie eine präzisere, formschlussige ¨ Montage der Wägezellen im Gehäuse wurden die Absolutgenauigkeit erheblich verbessern. ¨ Eine softwareseitige Transientenfilterung (z. B. Schwellwertentscheidung auf der zeitlichen Anderungsrate) sollte implementiert werden, um stabile Messwerte an das Backend zu ¨ liefern. Längerfristig wäre eine Temperaturkompensation der Dehnmessstreifen sinnvoll, da die YZC-133-Zellen temperaturbedingte Drifts aufweisen können.

Weg zum Produkt. Fur eine produktionsreife Version sind ein massenproduktions- ¨ taugliches PCB-Layout, ein robustes Gehäusedesign sowie eine Ende-zu-Ende-Validierung unter realen Logistikbedingungen notwendig. Die in dieser Arbeit erzielten Software-Optimierungen und das ADS1234-Kanalkonzept stellen dabei eine wiederverwendbare Basis dar.

## Literatur

[1] ESP32 | active | mode | and | deep | sleep | mode | power | consumption | com-
parison. | https://circuitdigest.com/microcontroller-projects/
esp32-active-mode-and-deep-sleep-mode-power-consumption. (https://circuitdigest.com/microcontroller-projects/esp32-active-mode-and-deep-sleep-mode-power-consumption) Online; aufgerufen 05.06.2026.
[2] Kraftsensor 0. . . 1 kg, yzc-133. https://www.reichelt.com/ch/de/shop/produkt/kraftsensor_0_1_kg_yzc-133-282443. (https://www.reichelt.com/ch/de/shop/produkt/kraftsensor_0_1_kg_yzc-133-282443) Online; aufgerufen 29.04.2026.
[3] Tps62842 datasheet. https://www.ti.com/product/TPS62840/part-details/TPS62842DGRR. (https://www.ti.com/product/TPS62840/part-details/TPS62842DGRR) Online; aufgerufen 01.06.2026.

[4] Cyrill Berger, Dominik Muller, and Kilian Brunner. Entwicklung einer smart- ¨ waage mit offener schnittstelle fur die industrie 4.0. Bachelorarbeit studiengang ¨ informatik, ZHAW, Institute of Embedded Systems (InES), June 2025. Dok.-Nr.: BA FS 25 brnn 283; Industriepartner: Skysec GmbH.
[5] Espressif Systems. | ESP32-C3 series datasheet. | https://www.espressif.com/
sites/default/files/documentation/esp32-c3_datasheet_en.pdf. (https://www.espressif.com/sites/default/files/documentation/esp32-c3_datasheet_en.pdf) Version 2.4; Online; aufgerufen 05.06.2026.
[6] Joy-IT. | SBC-NodeMCU-ESP32-C | nodemcu | esp32 | usb-c | – | datasheet.
https://joy-it.net/files/files/Produkte/SBC-NodeMCU-ESP32-C/SBC-NodeMCU-ESP32-C_Datasheet-EN_2024-12-16.pdf. (https://joy-it.net/files/files/Produkte/SBC-NodeMCU-ESP32-C/SBC-NodeMCU-ESP32-C_Datasheet-EN_2024-12-16.pdf) Version 2024-12-16; Online; aufgerufen 05.06.2026.
[7] Nordic Semiconductor. | nRF52840 product specification. | https://docs.
nordicsemi.com/bundle/ps_nrf52840/page/keyfeatures_html5.html. (https://docs.nordicsemi.com/bundle/ps_nrf52840/page/keyfeatures_html5.html) | Online;
aufgerufen 05.06.2026.
[8] Thomas Rocheteau. Vereinbarung projekt- / bachelorarbeit: Entwicklung einer smart-waage mit offener schnittstelle fur die industrie 4.0. Projektvereinbarung ba- ¨ chelorarbeit, ZHAW, Institute of Embedded Systems (InES), February 2026. Dok.-Nr.: BA26 brnn 241; Betreuer: Kilian Brunner; Industriepartner: Skysec GmbH.
[9] Texas Instruments. ADS1234 product datasheet. https://www.ti.com/lit/ds/symlink/ads1234.pdf. (https://www.ti.com/lit/ds/symlink/ads1234.pdf) Online; aufgerufen 29.04.2026.
[10] Texas Instruments. LM2596 SIMPLE SWITCHER® Power Converter 150-kHz 3-A Step-Down Voltage Regulator. https://www.ti.com/lit/ds/symlink/lm2596. pdf. (https://www.ti.com/lit/ds/symlink/lm2596.pdf) Revision C (SNVS124C); Online; aufgerufen 01.06.2026.

## A PCB Schaltplan

10k C17

100k 1 | 3 2 | Q3 Si2319CDS ²¹

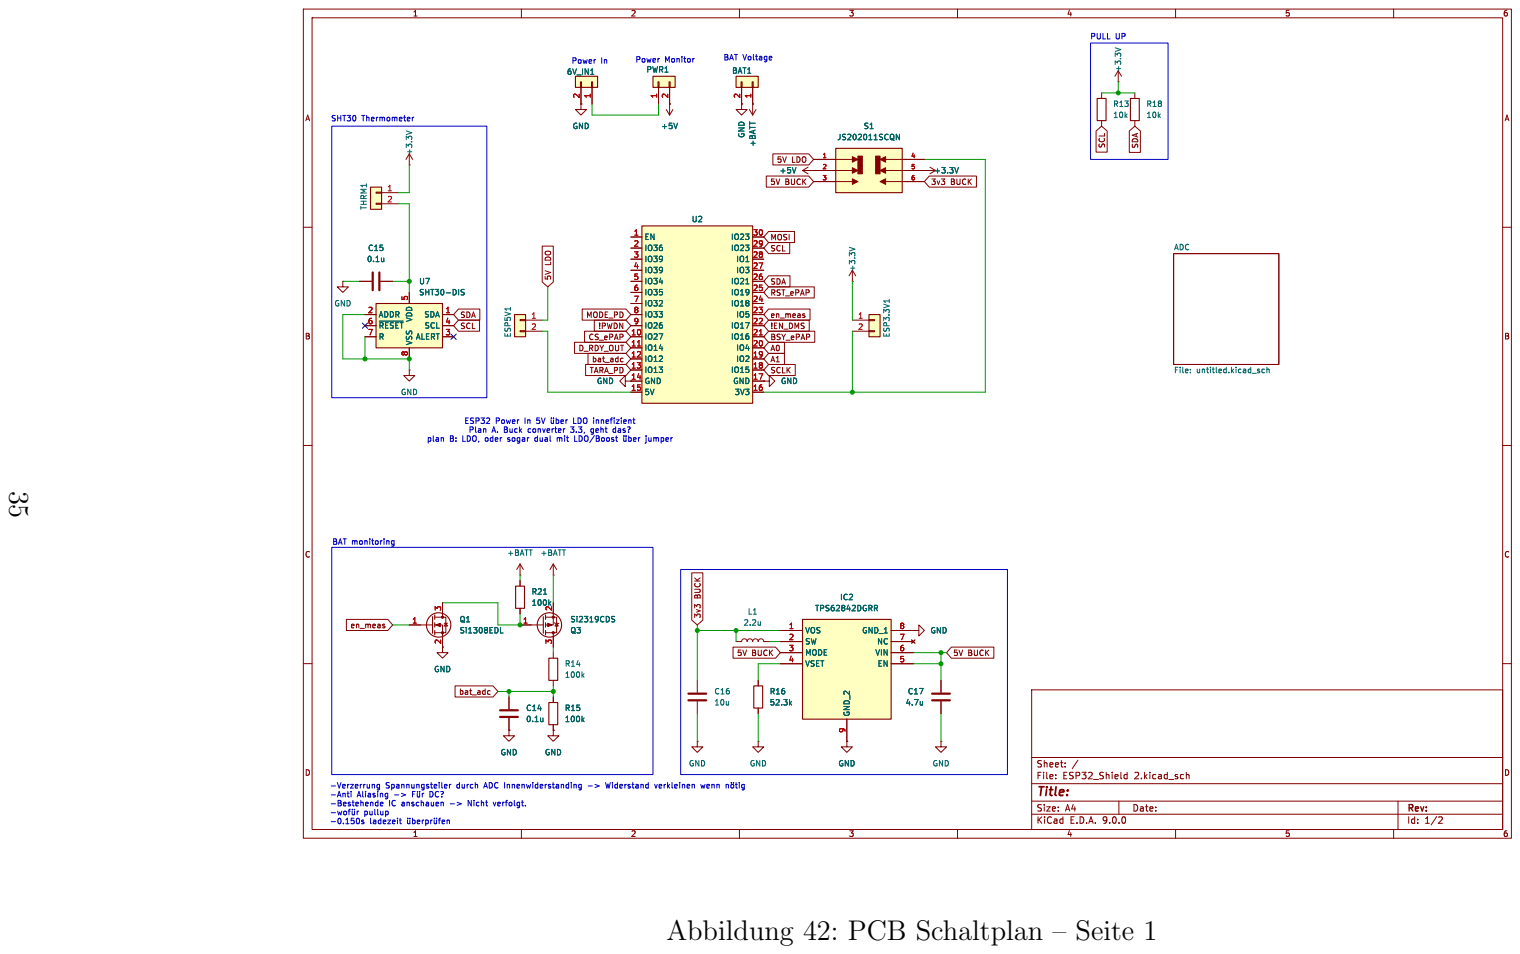
[picture p34: page 35]

16 Abbildung 42: PCB Schaltplan – Seite 1

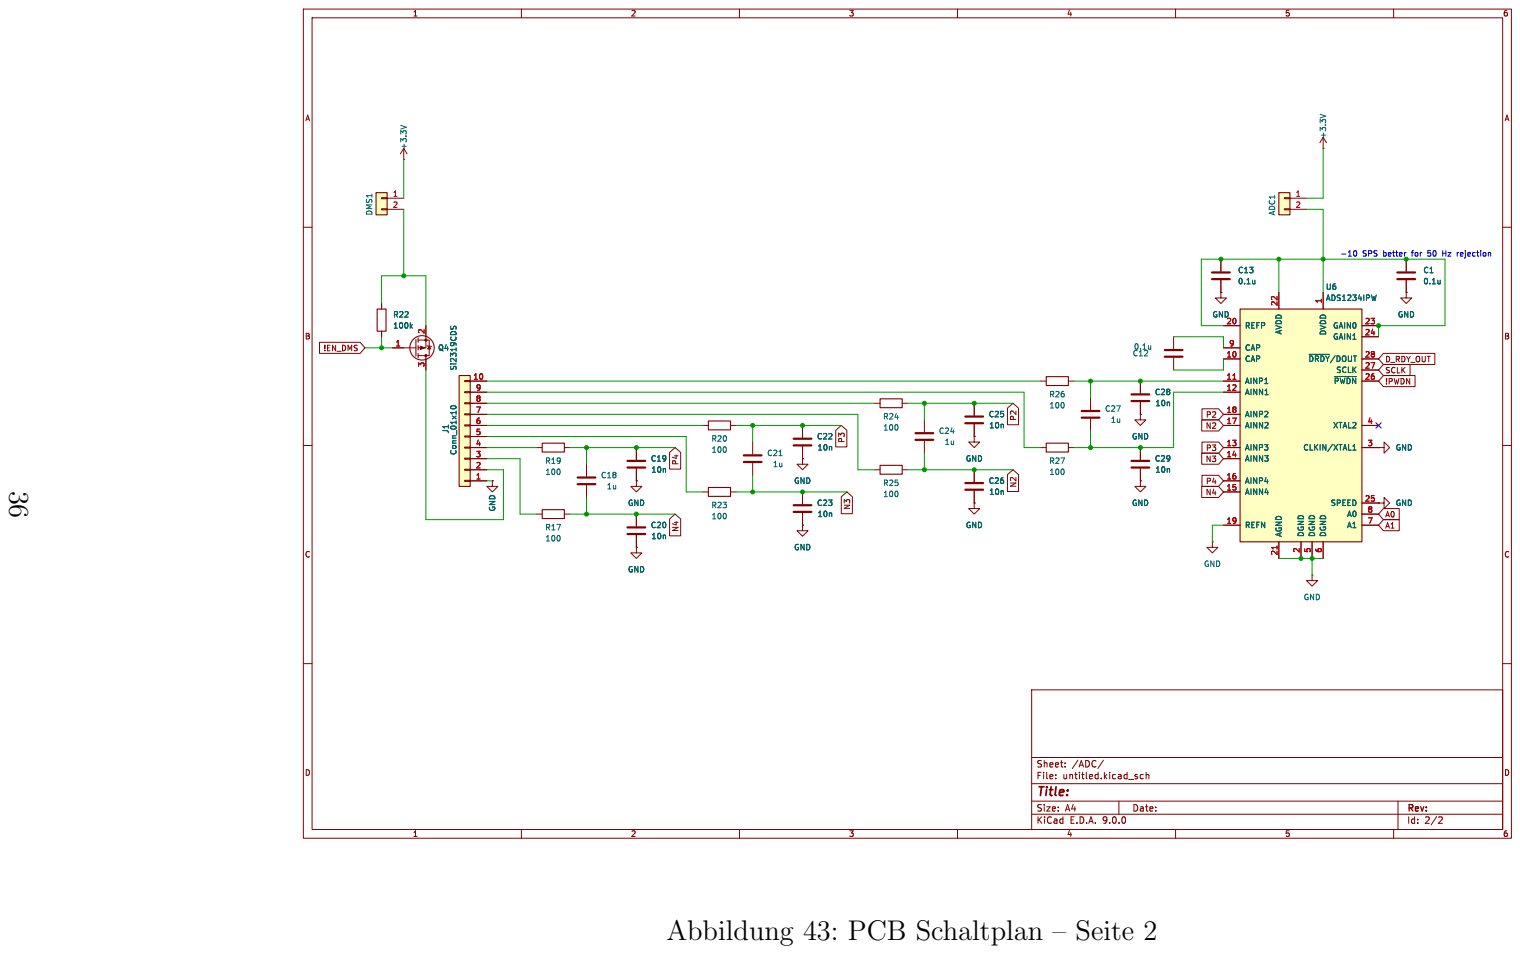
[picture p35: page 36]

10n GND Abbildung 43: PCB Schaltplan – Seite 2

## B Projektvereinbarung

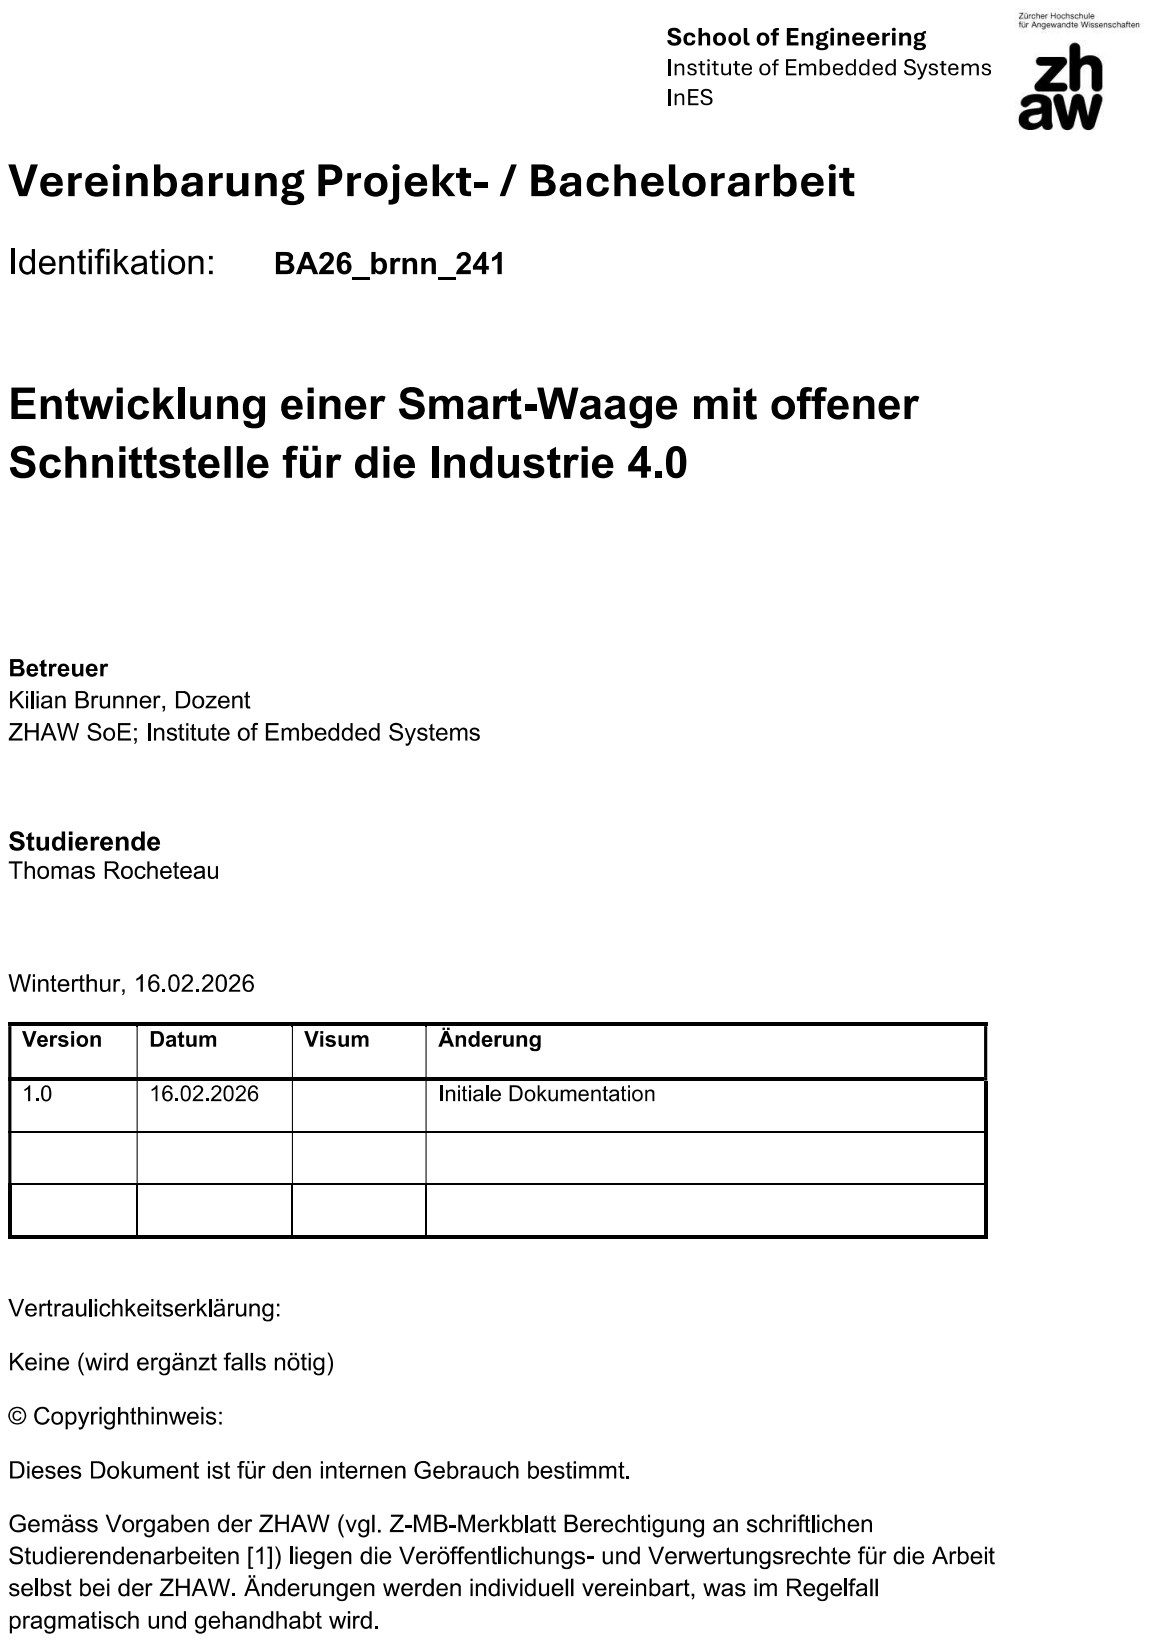
[picture p36: page 38]

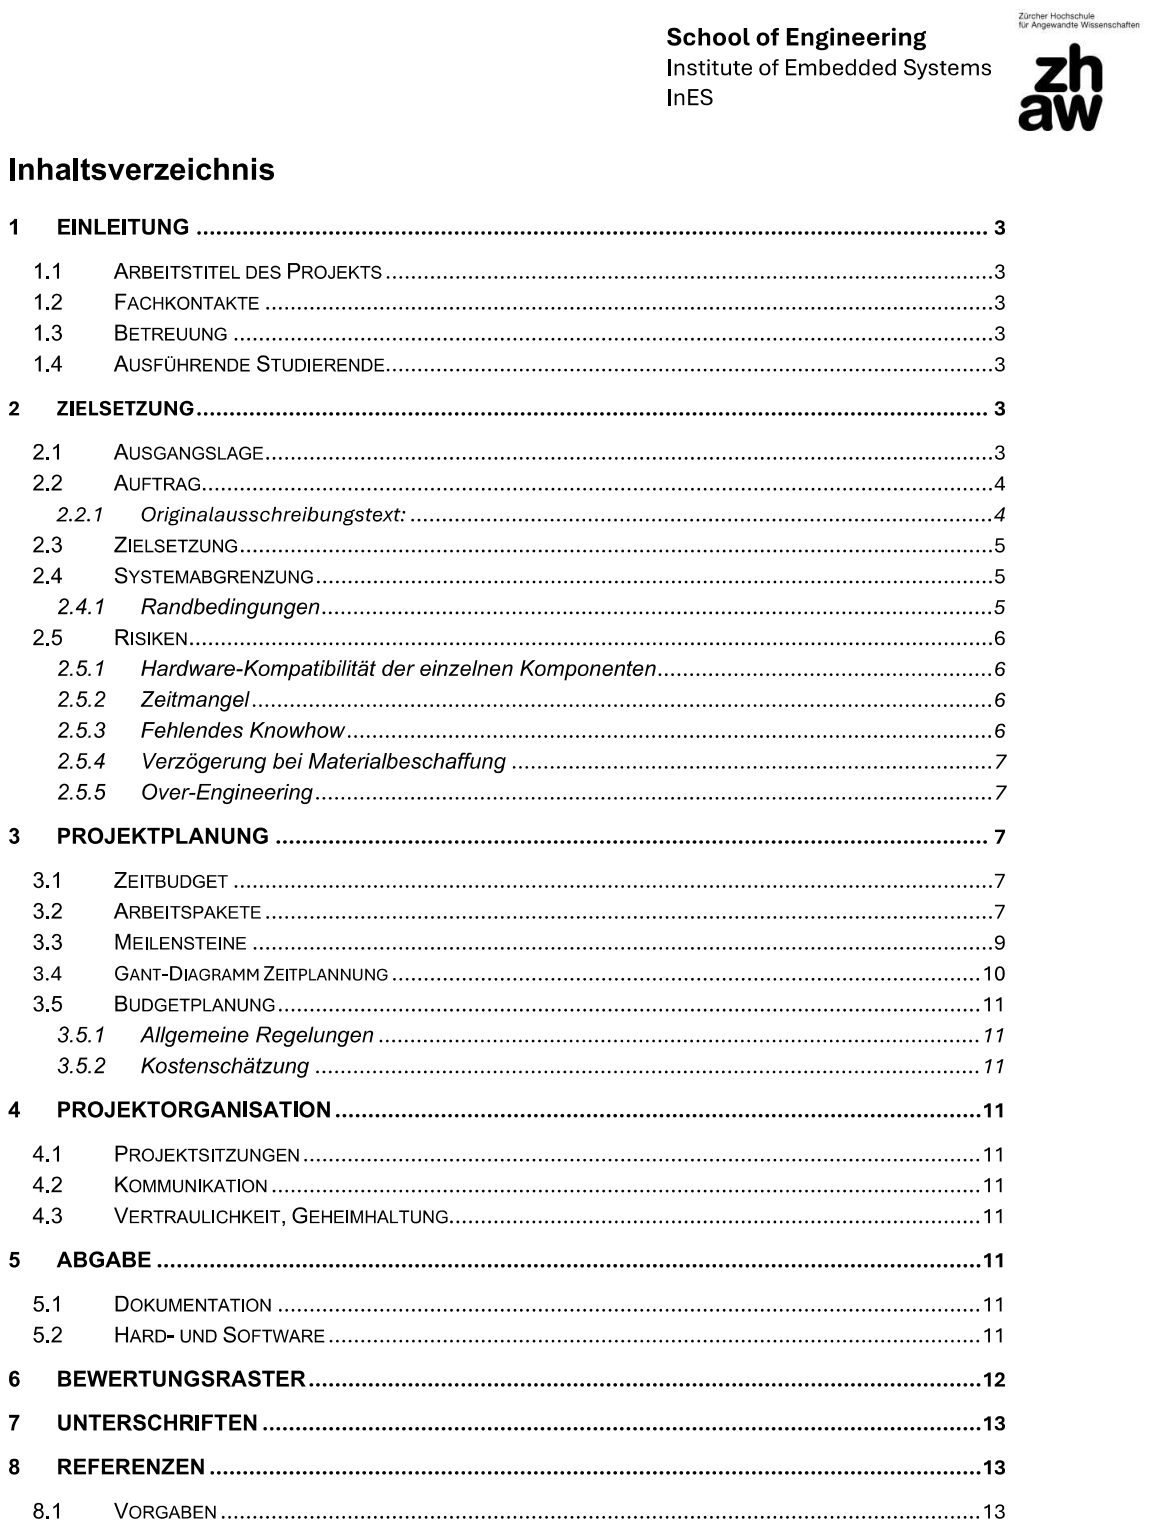
[picture p37: page 39]

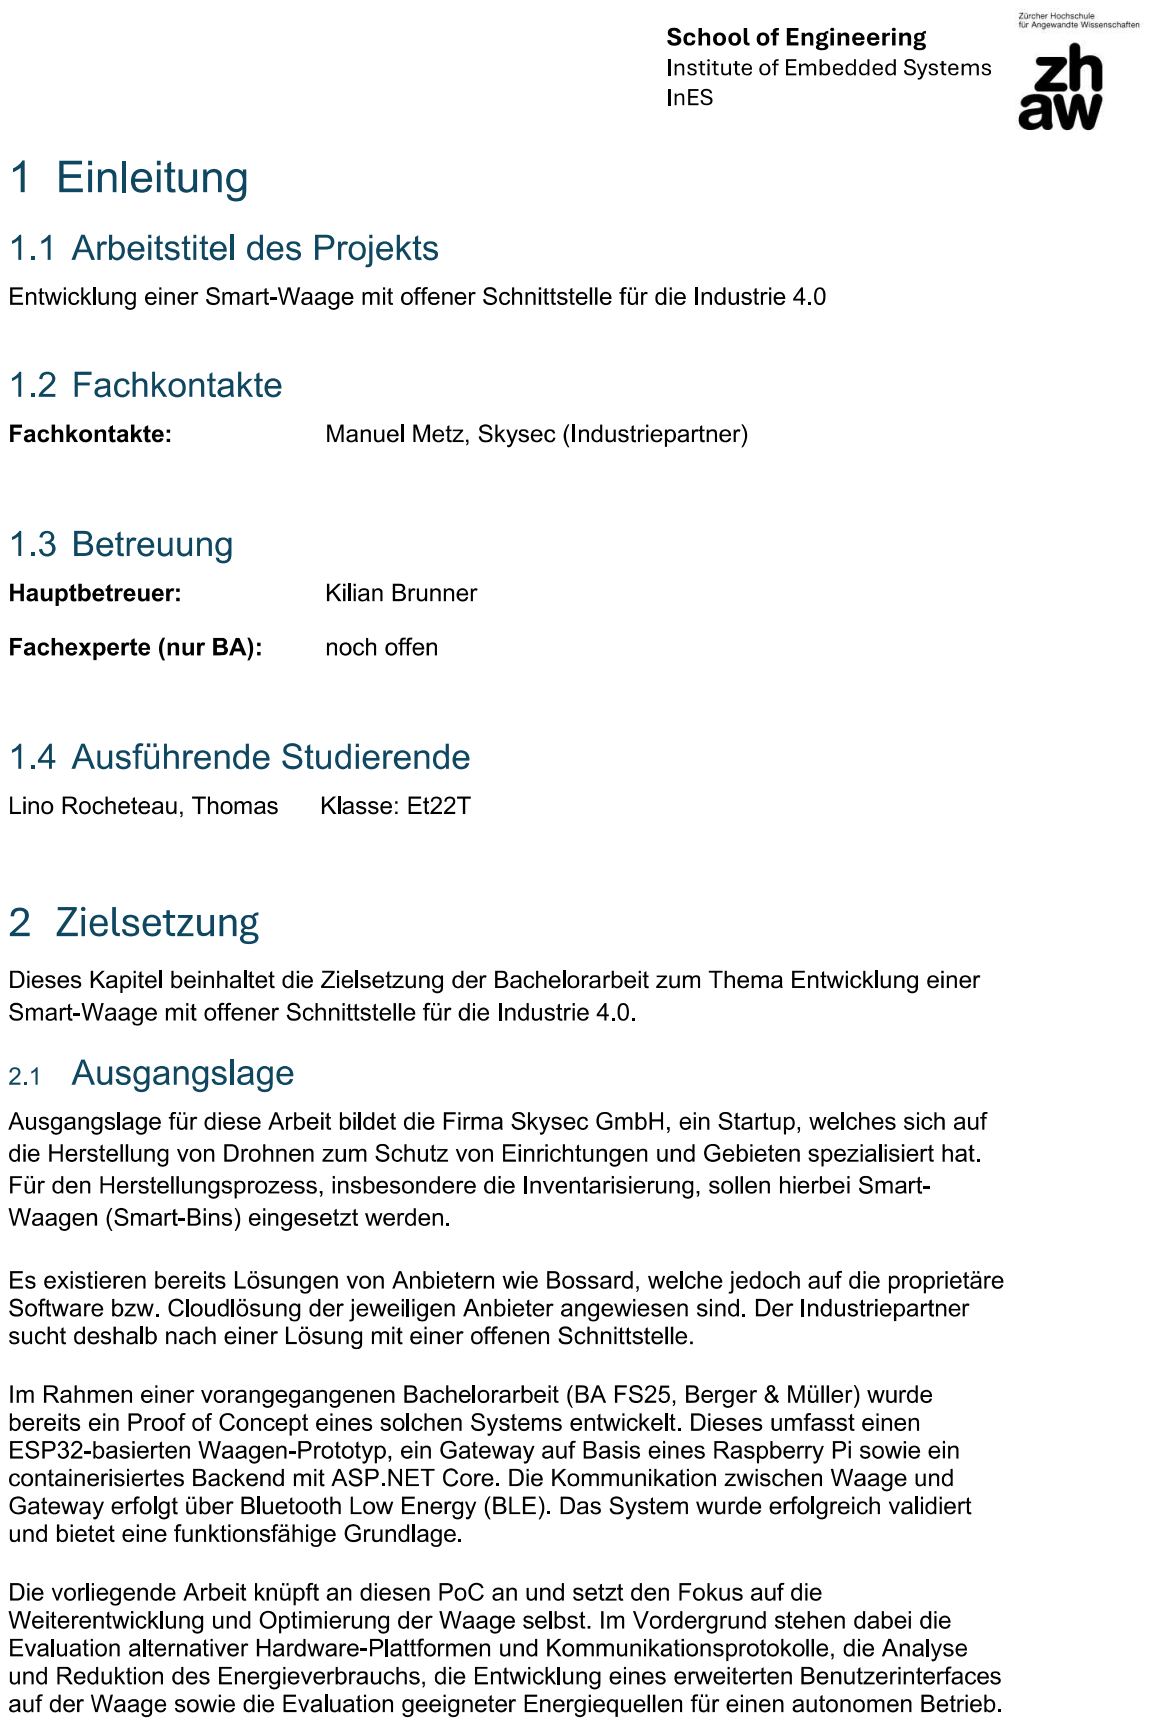
[picture p38: page 40]

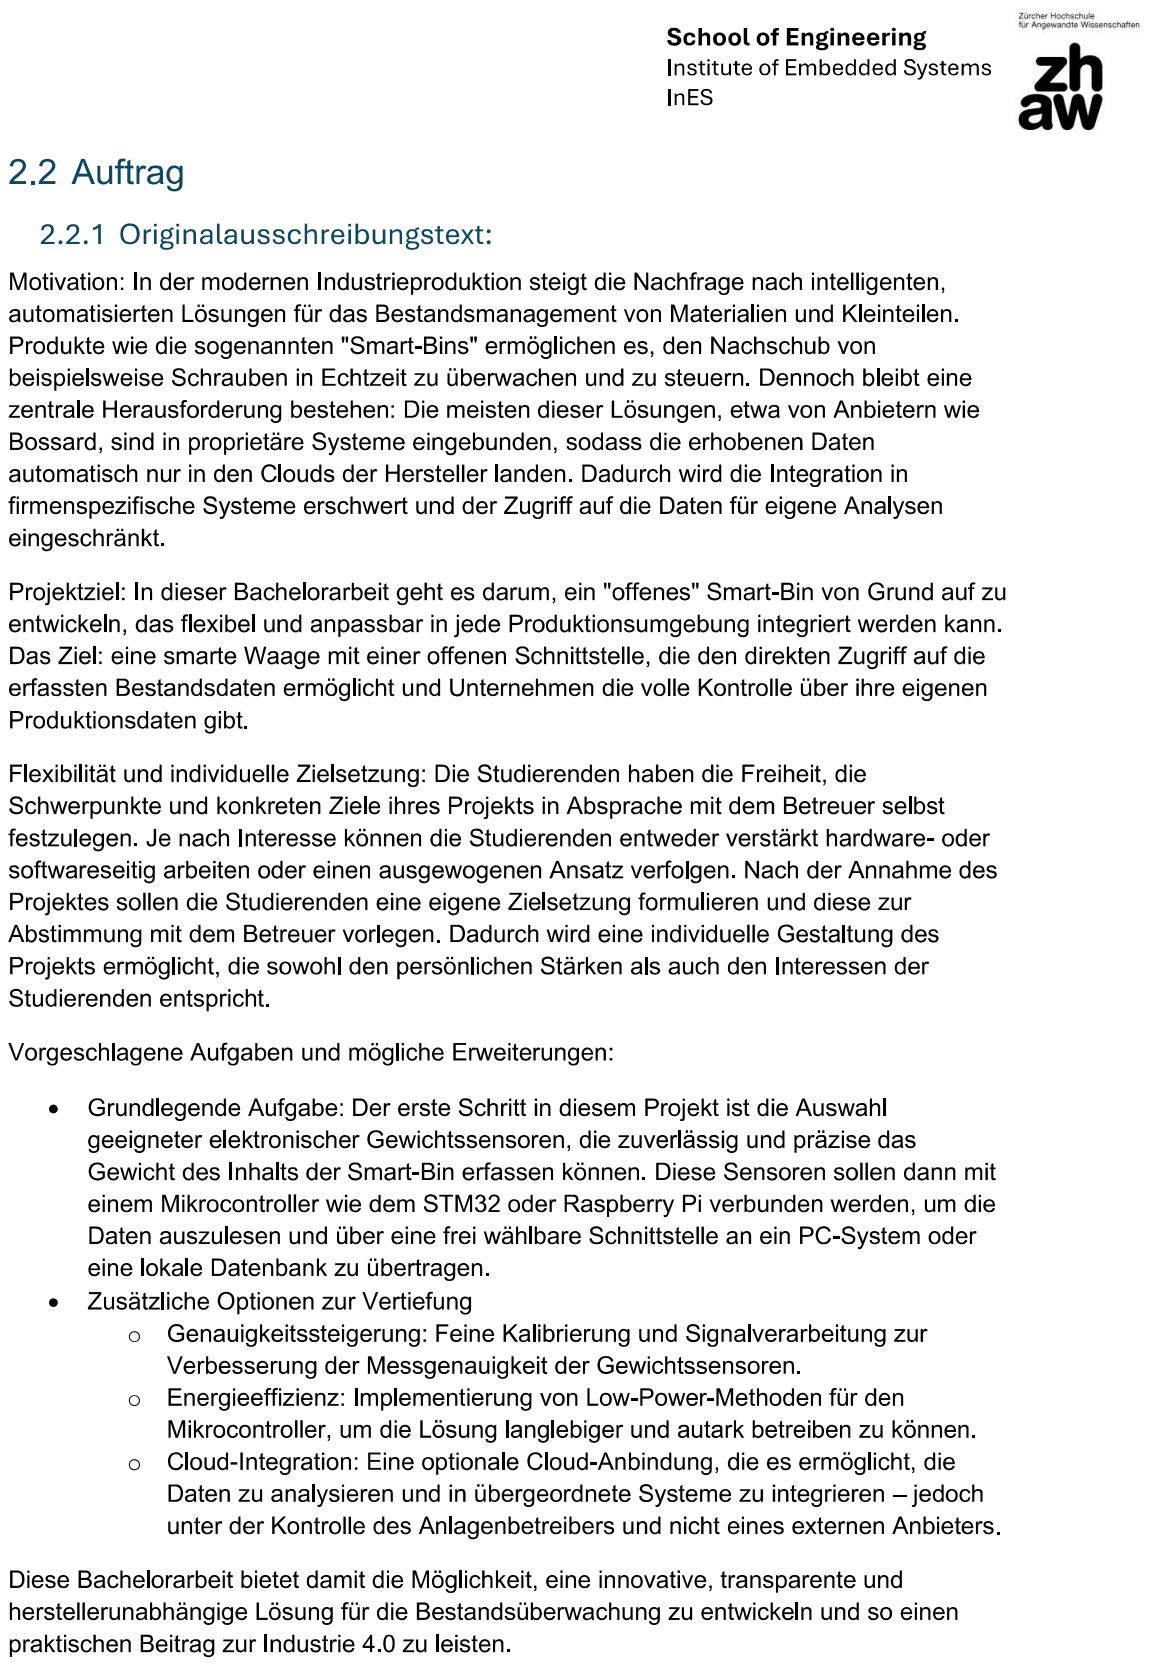
[picture p39: page 41]

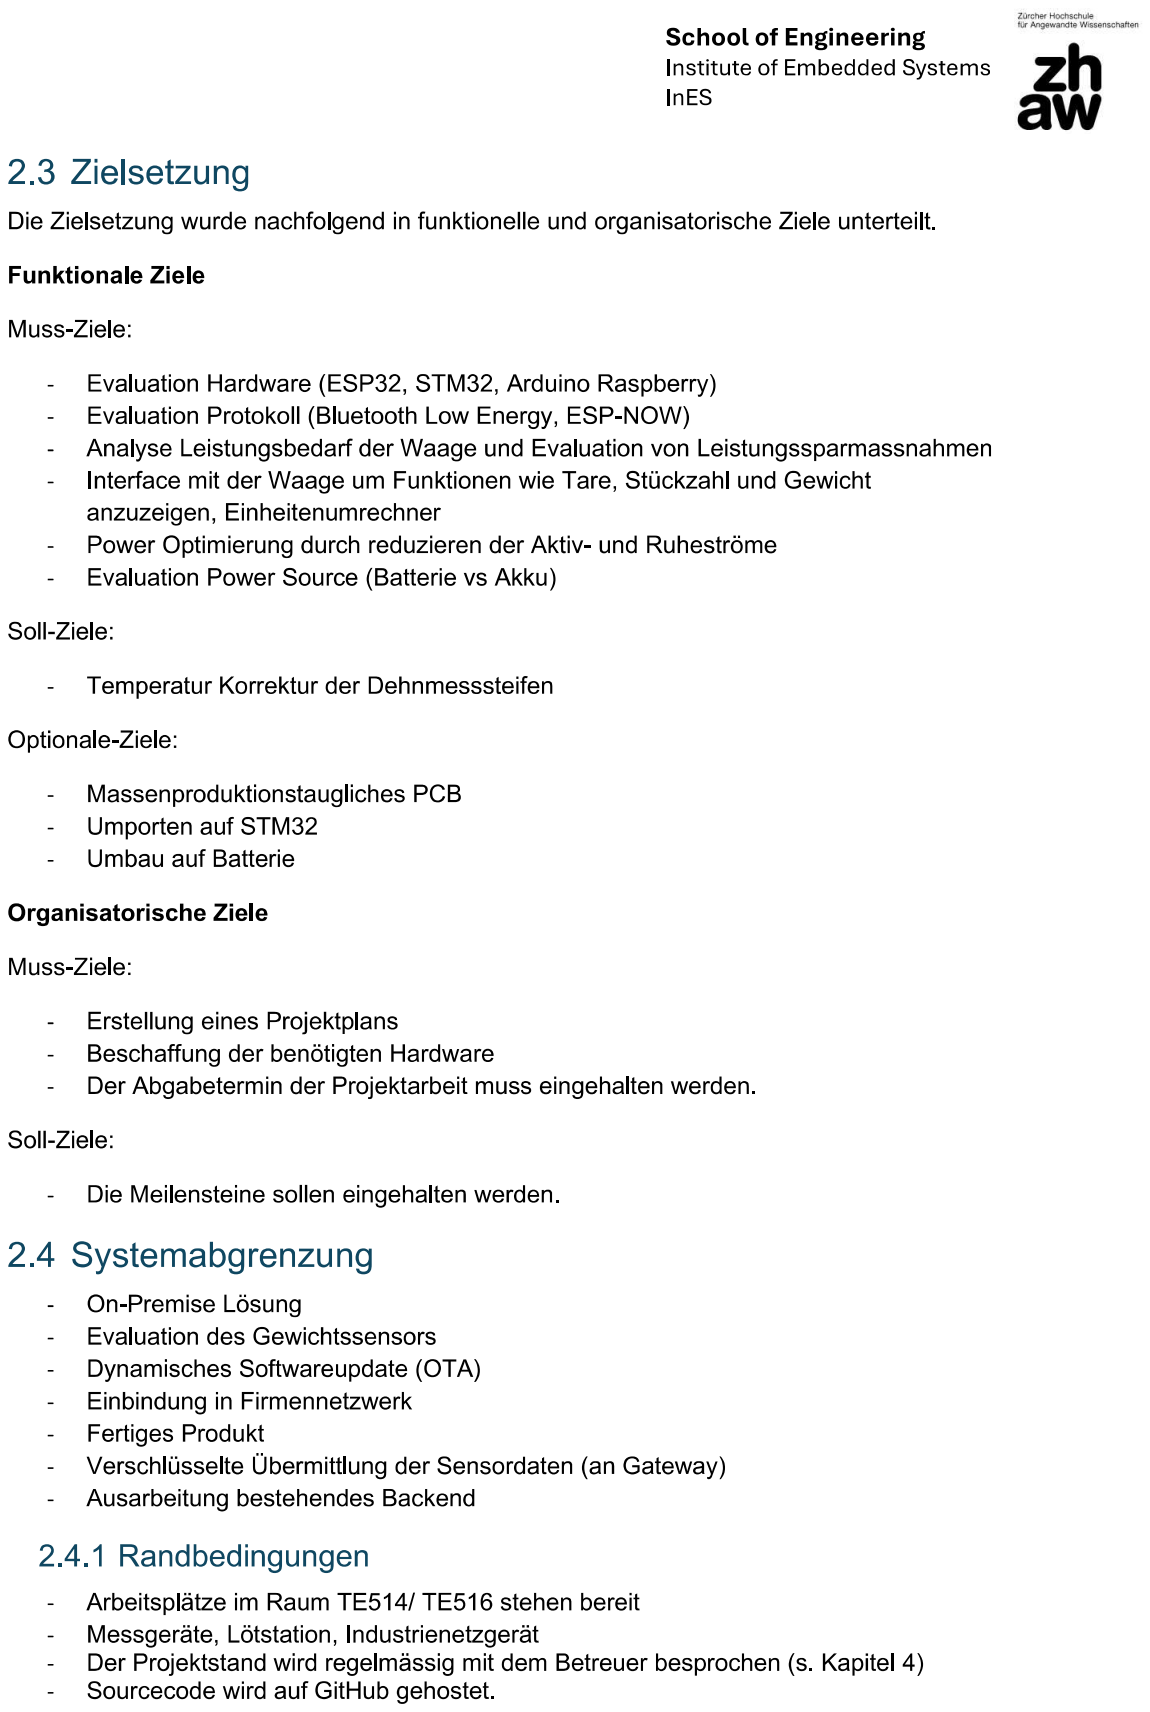
[picture p40: page 42]

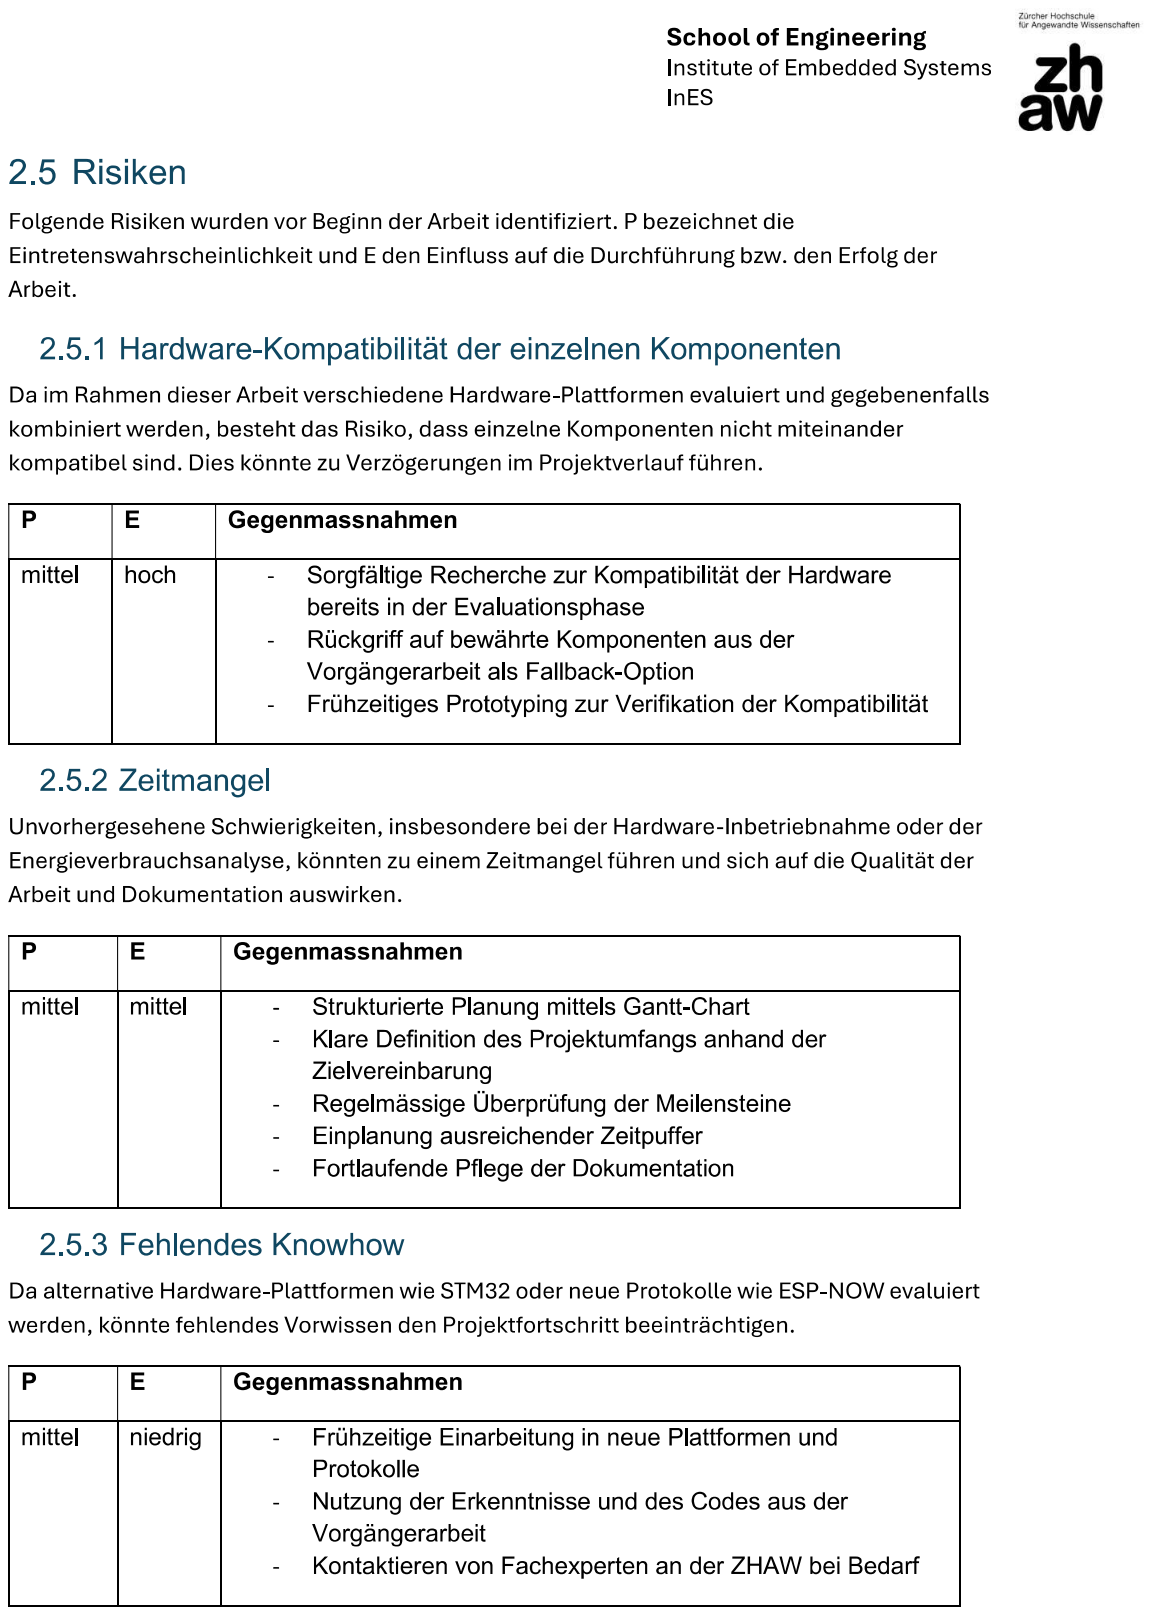
[picture p41: page 43]

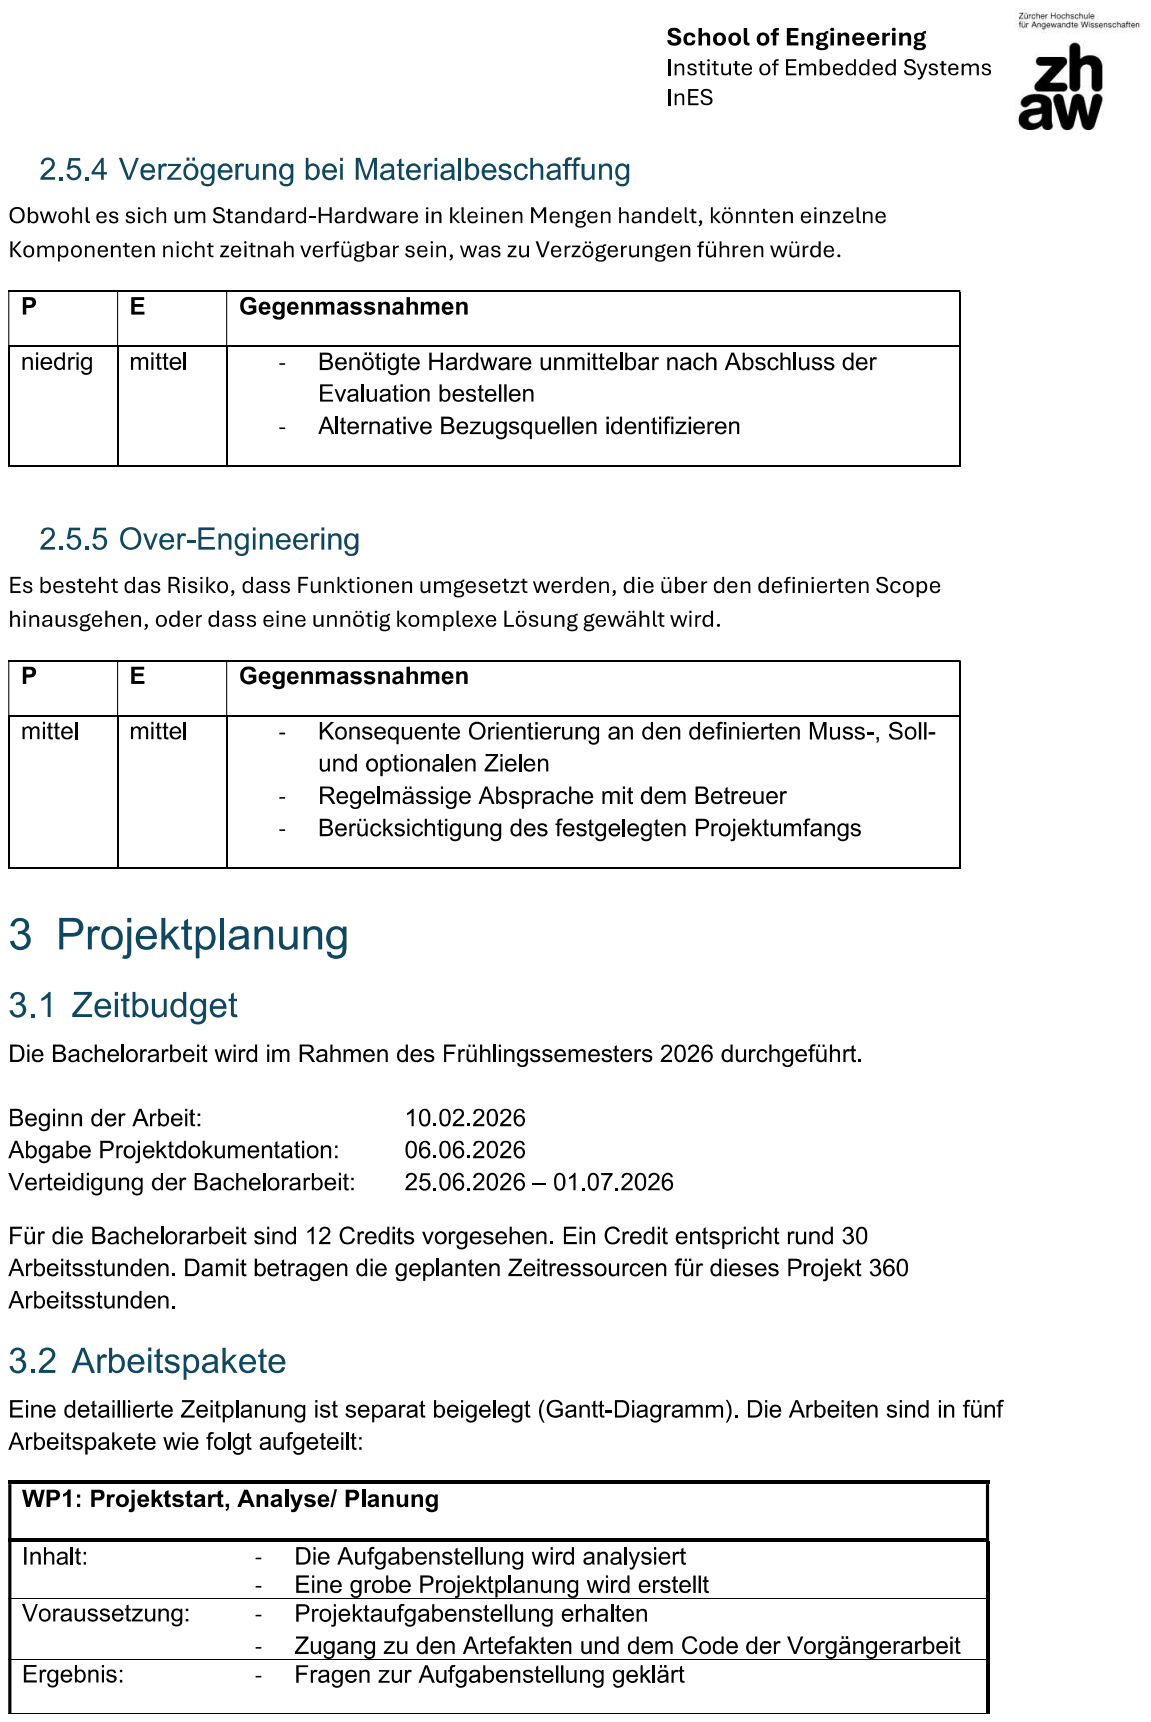
[picture p42: page 44]

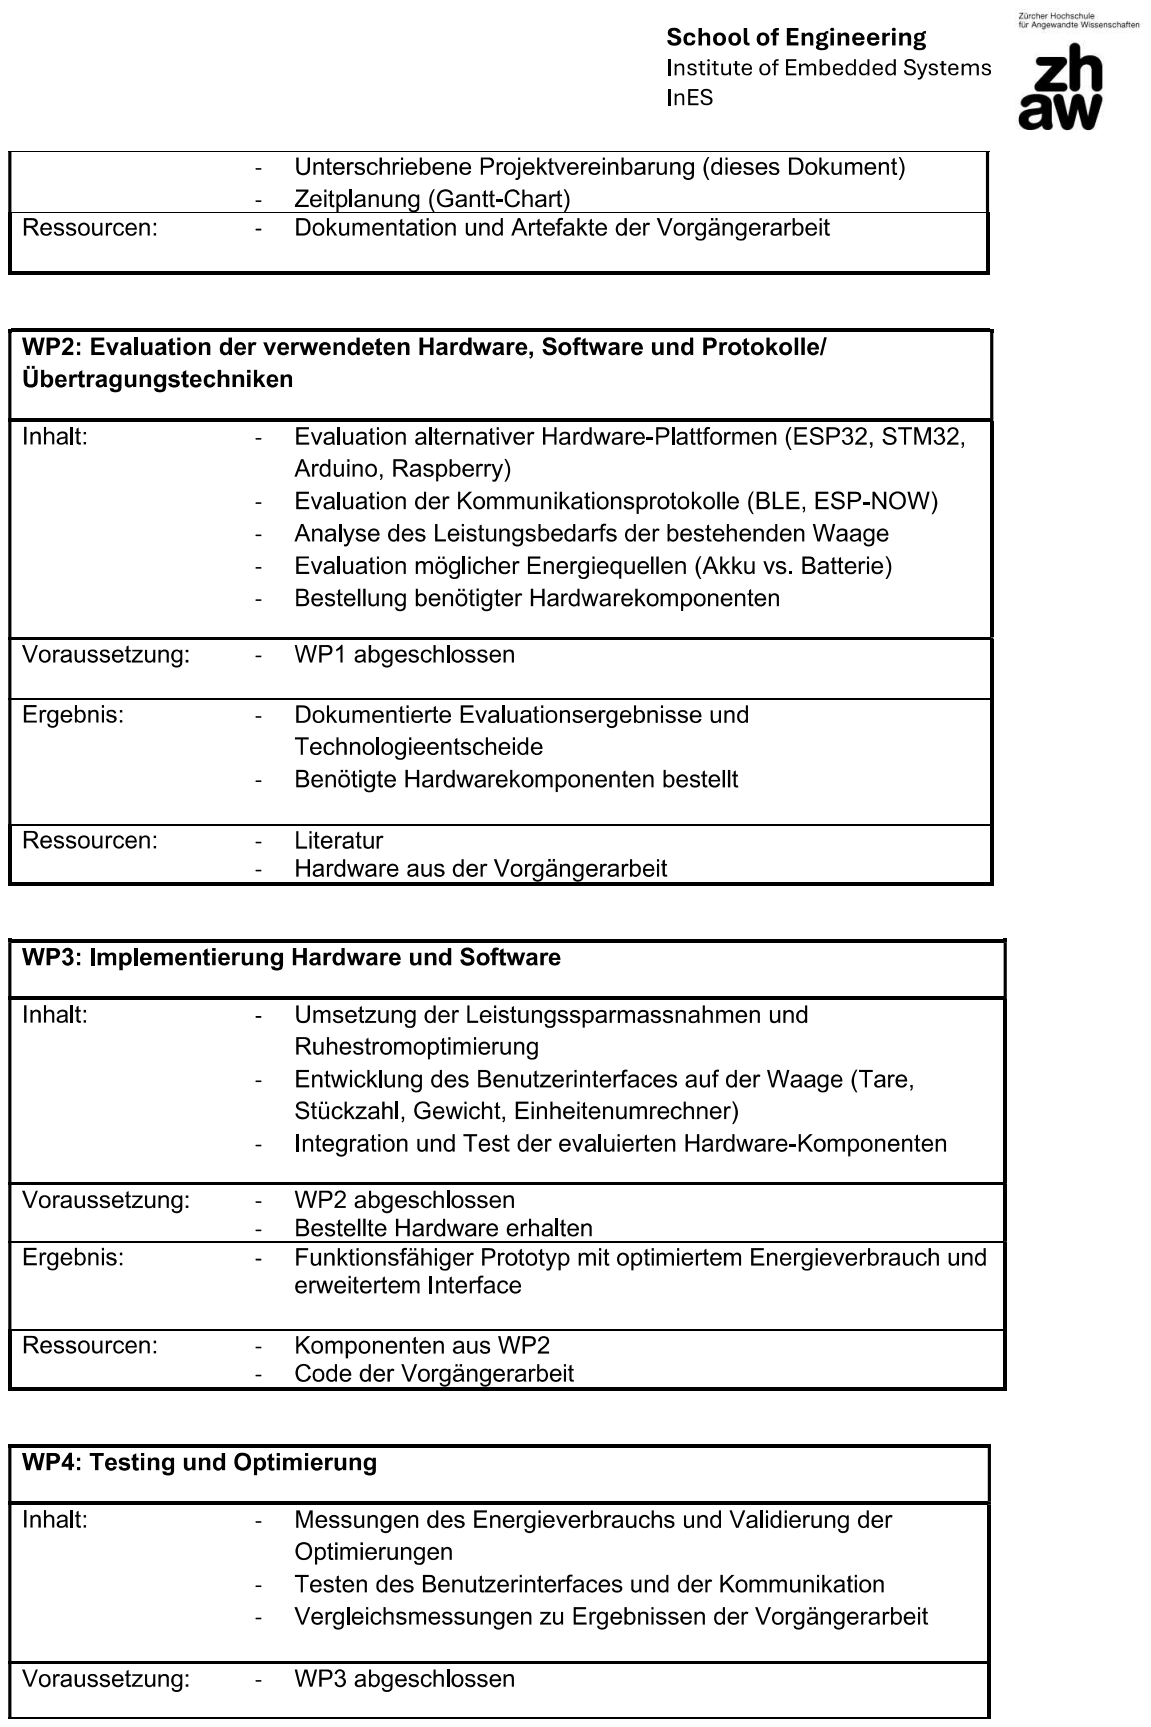
[picture p43: page 45]

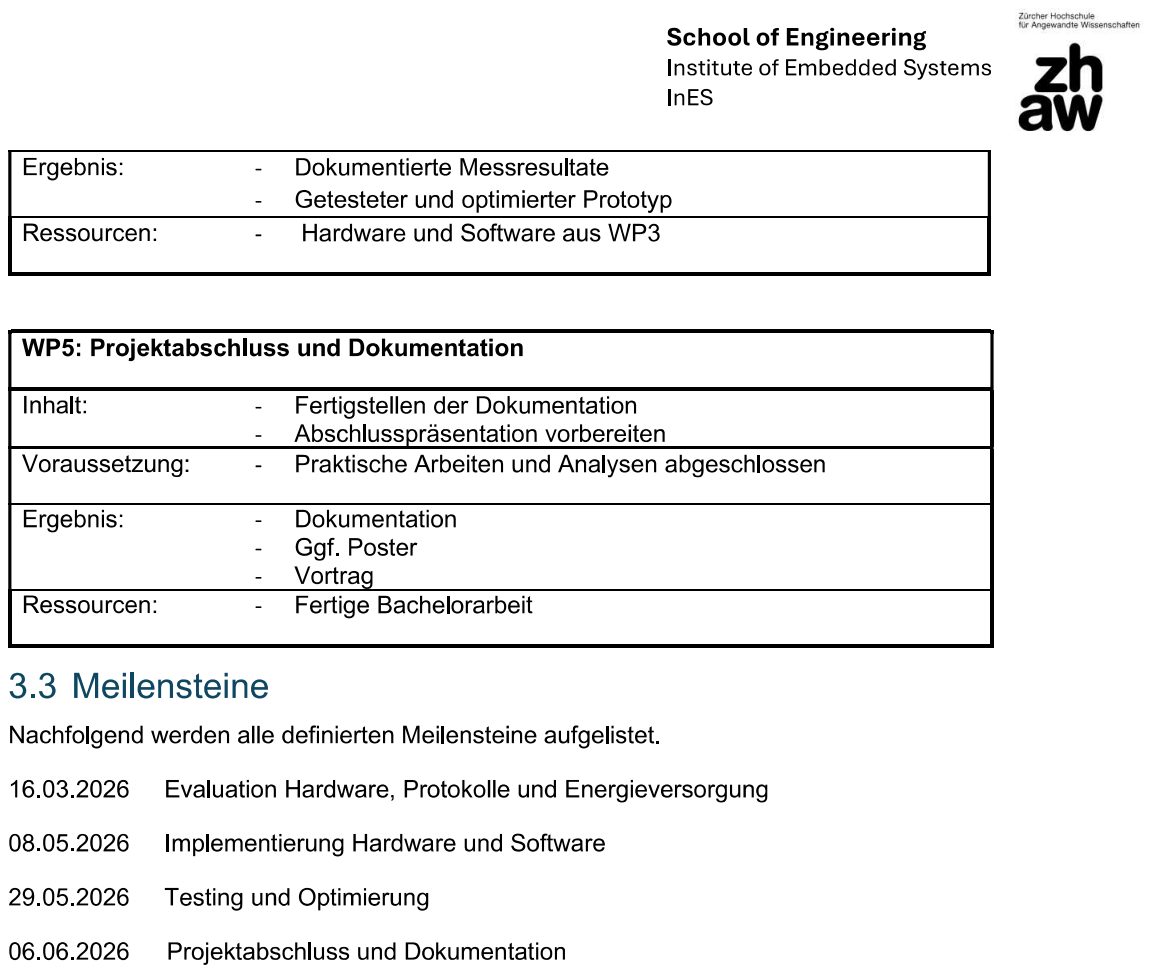
[picture p44: page 46]

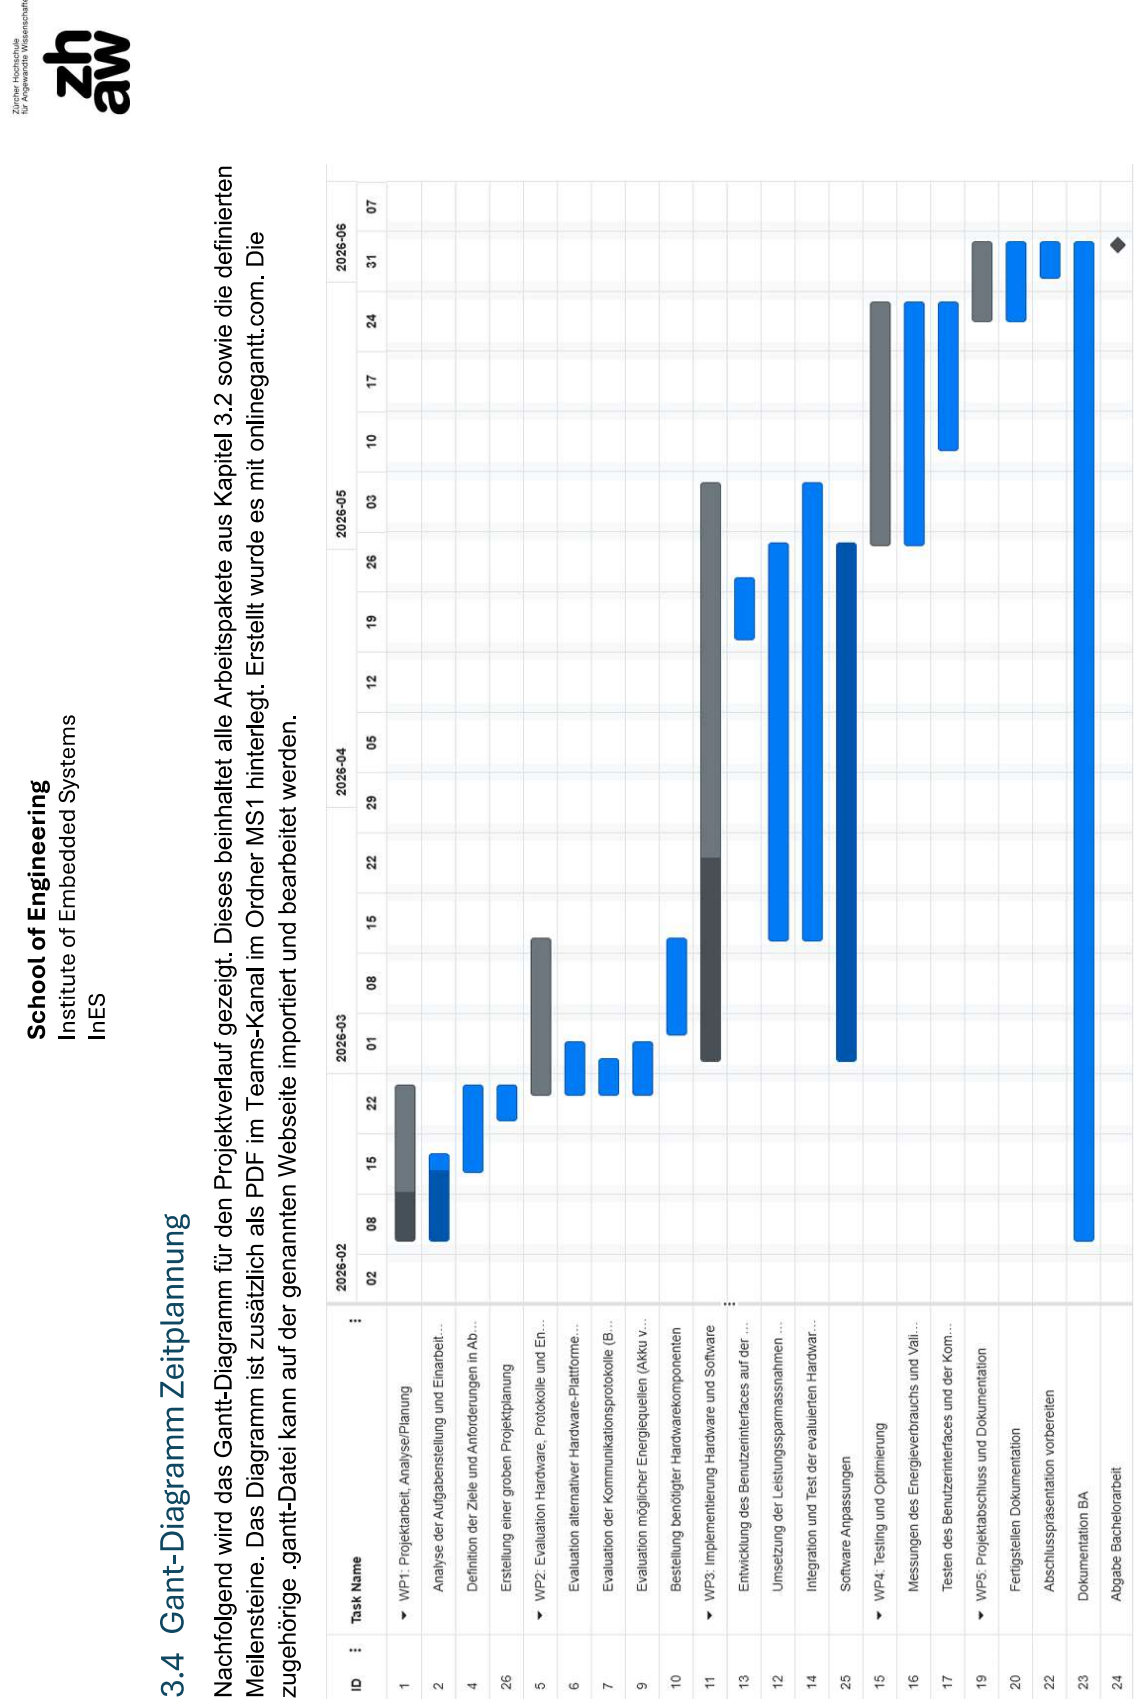
[picture p45: page 47]

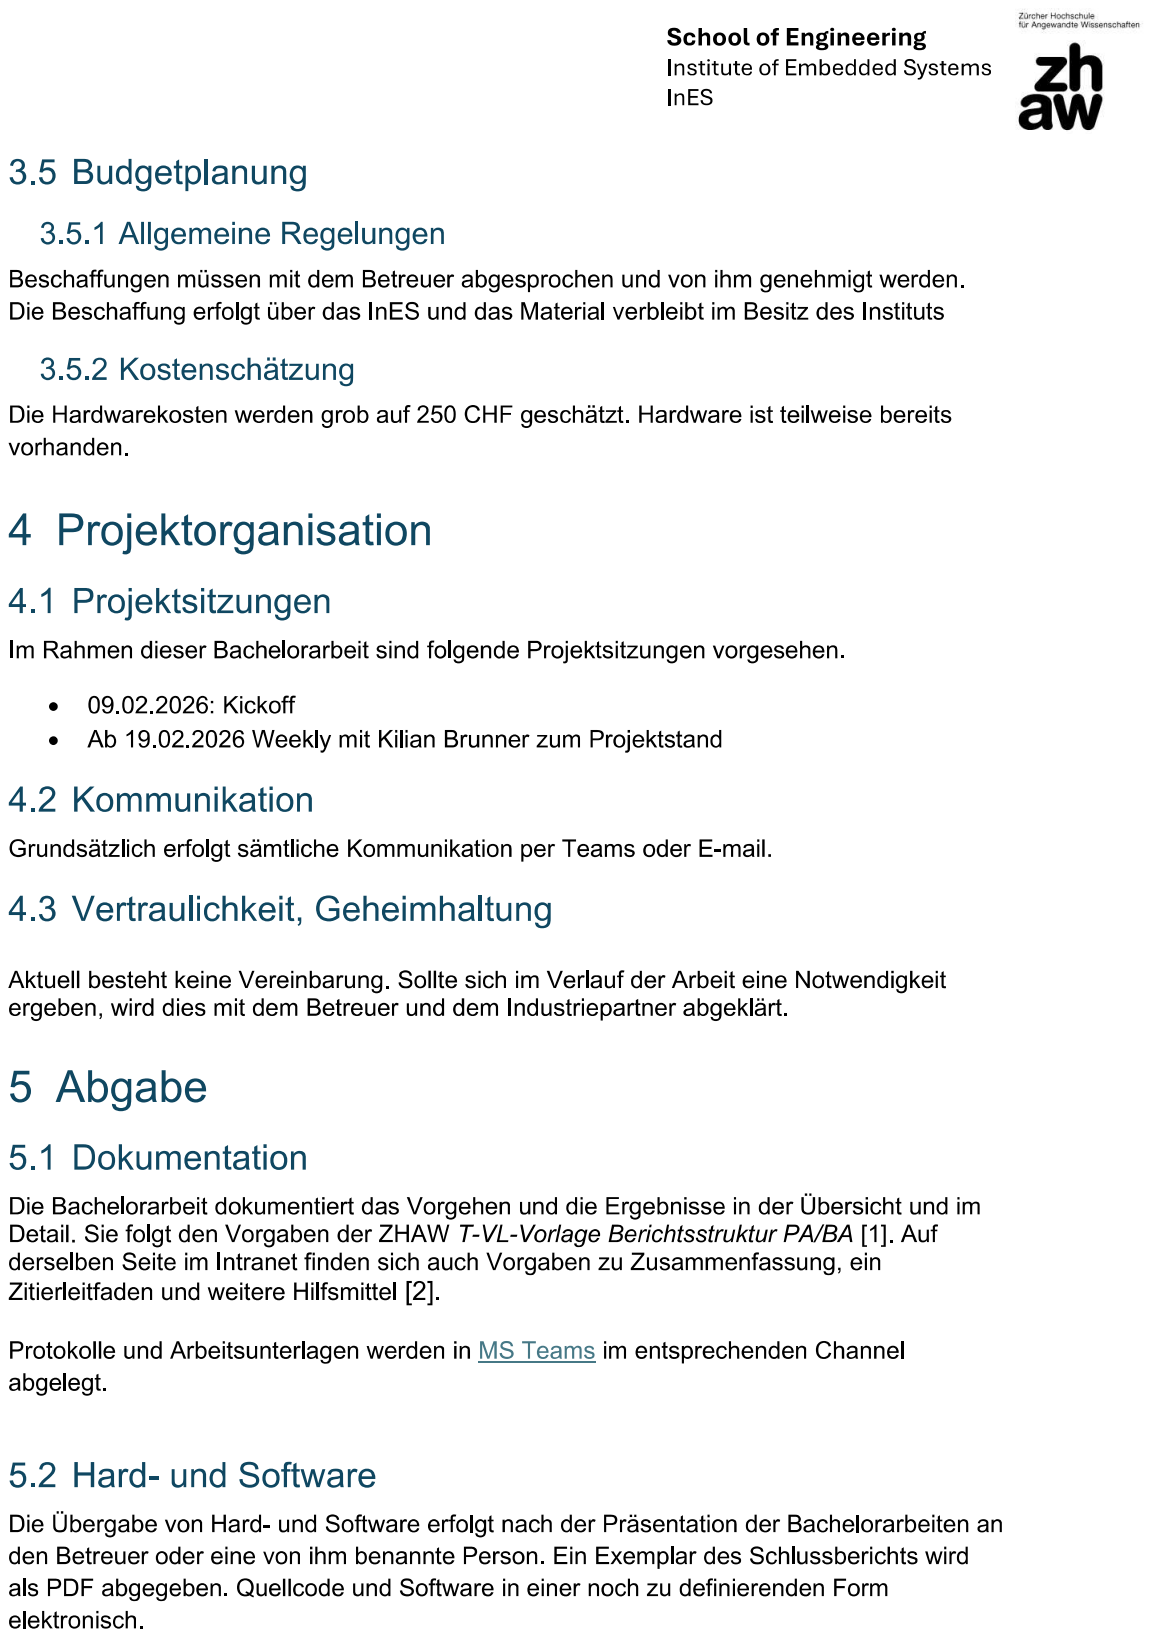
[picture p46: page 48]

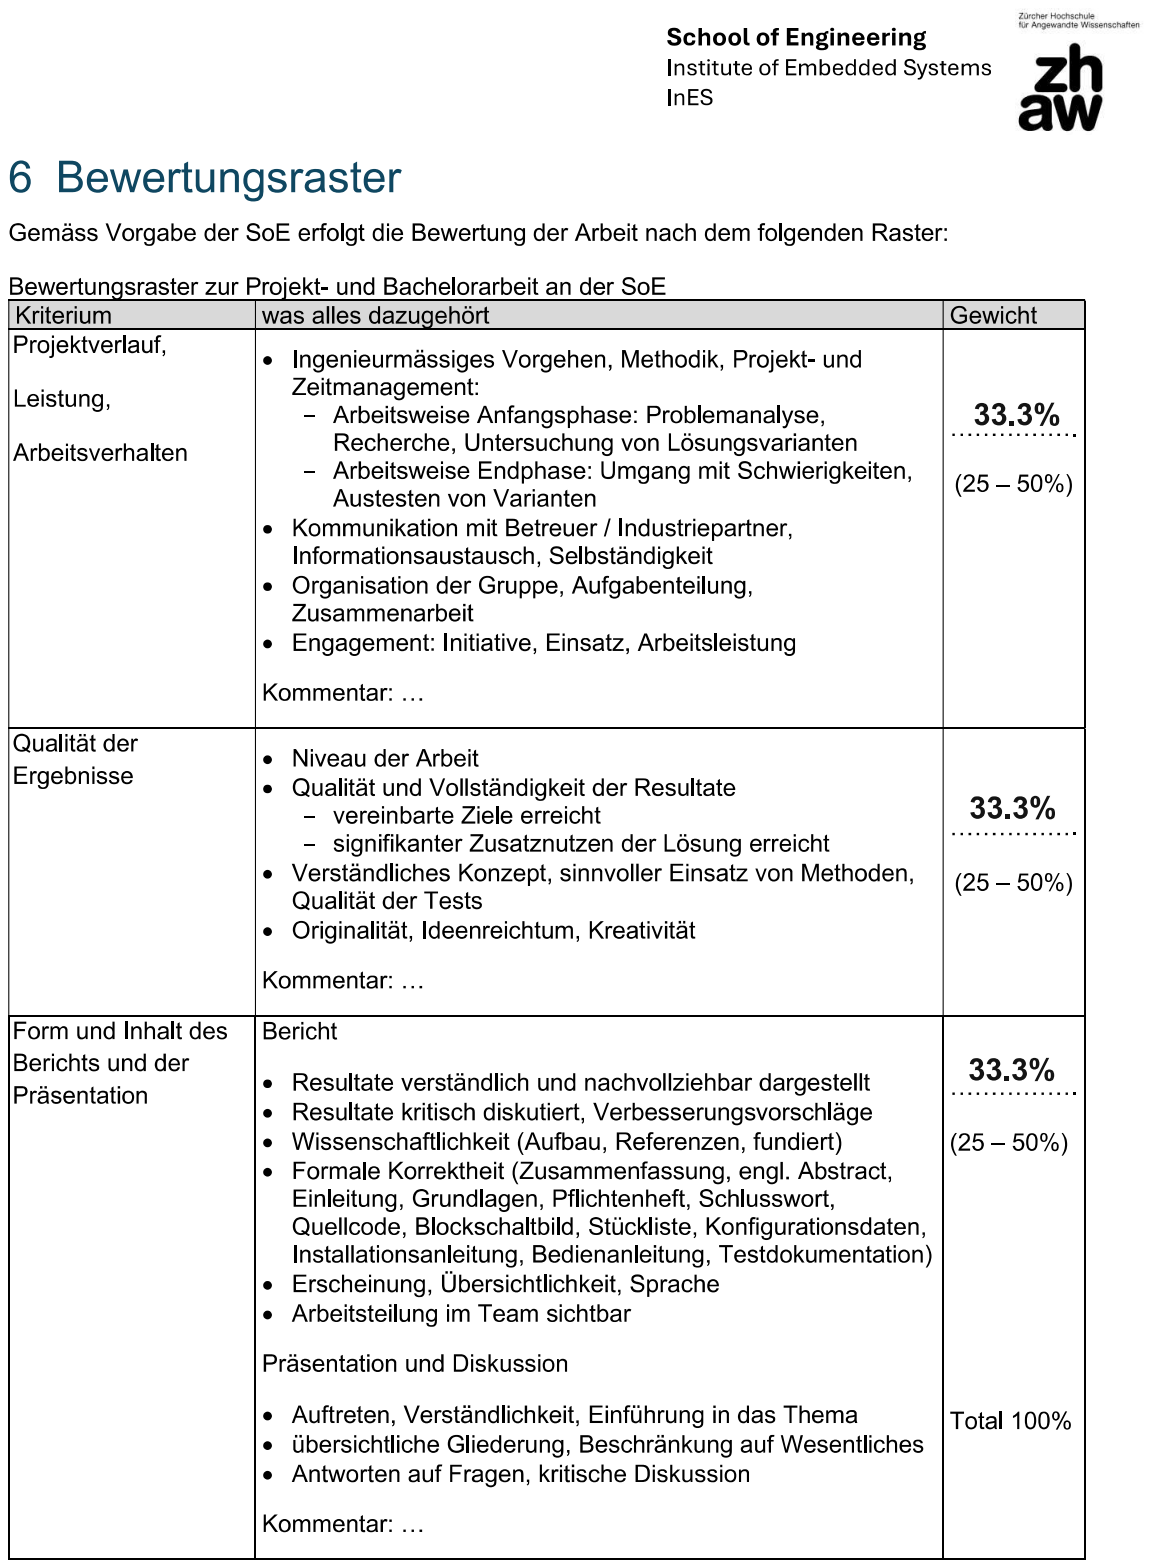
[picture p47: page 49]

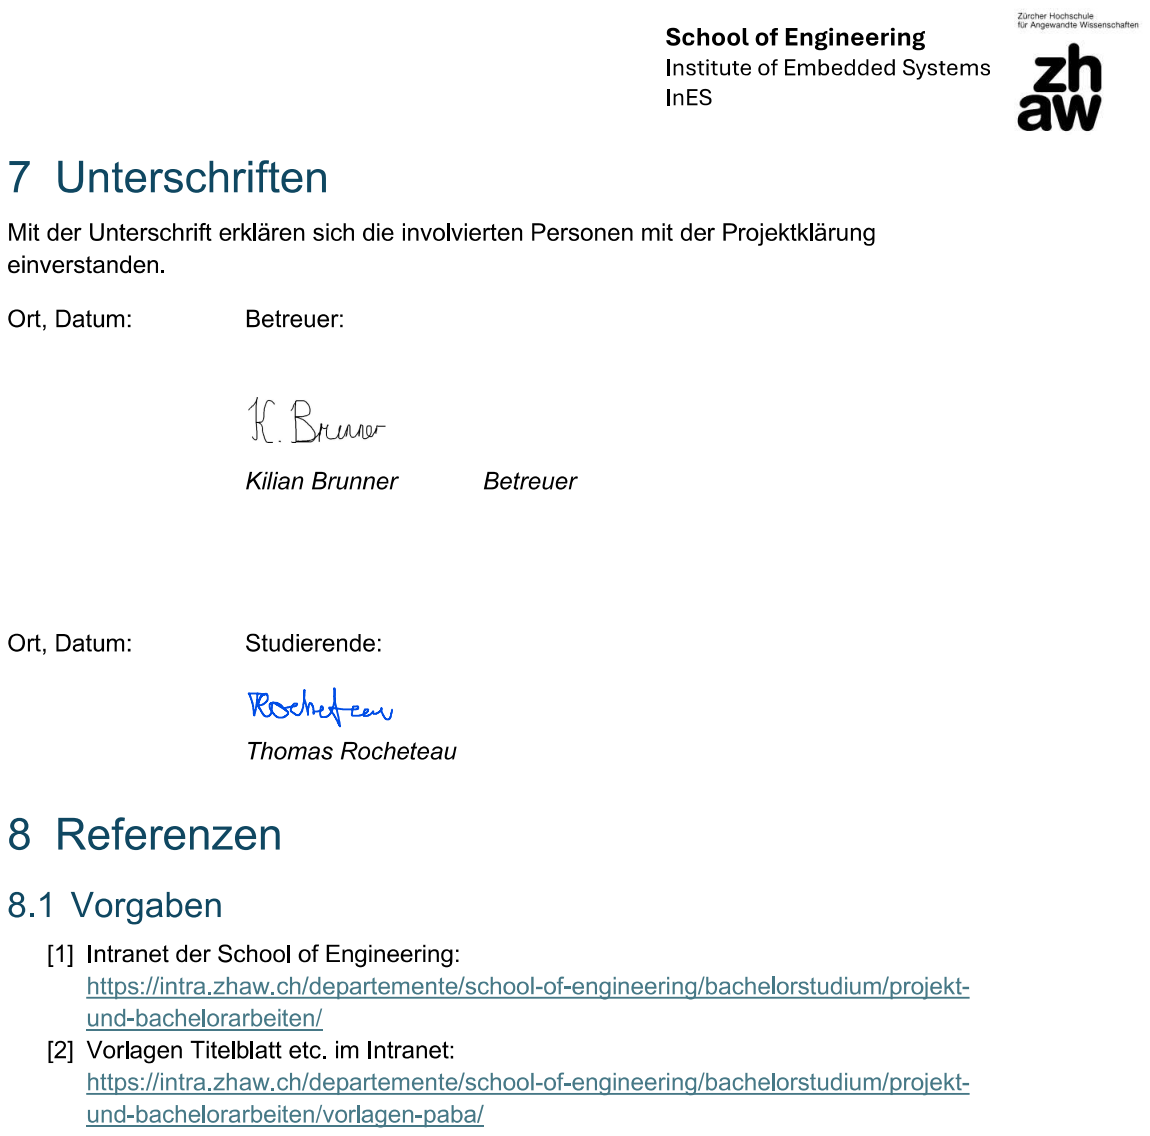
[picture p48: page 50]

## C Quellcode

Der vollständige Quellcode dieser Arbeit ist öffentlich auf GitHub verfugbar: ¨

https://github.com/Newtonsohn/BA-Smart-Waage

Das Repository enthält die Firmware des ESP32 (PlatformIO/Arduino-Framework), die Mess- und Auswertungsskripte sowie die LaTeX-Quelldateien dieser Dokumentation.
