Newtonsohn/BA-Smart-Waage/Doku/Images/ALL0008/F0008TEK.BMP

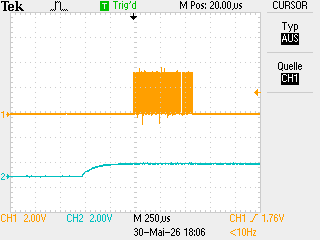
Doku/Images/ALL0008/F0008TEK.BMP
