Newtonsohn/BA-Smart-Waage/Doku/Images/Buck_TPS.png

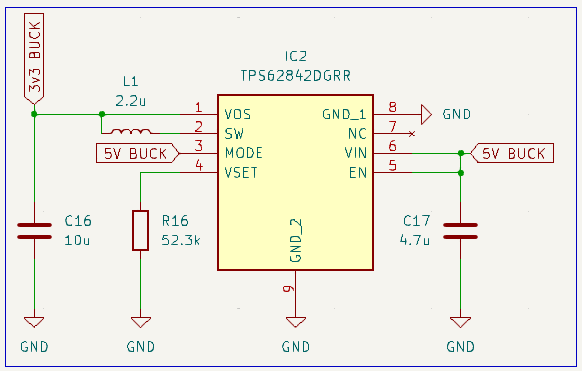
Doku/Images/Buck_TPS.png
