Newtonsohn/BA-Smart-Waage/Doku/Images/mu7c0e2yxx6imnh1vxw870vgo3i83xzxu9uzmccsvjwquh1uh4.jpg

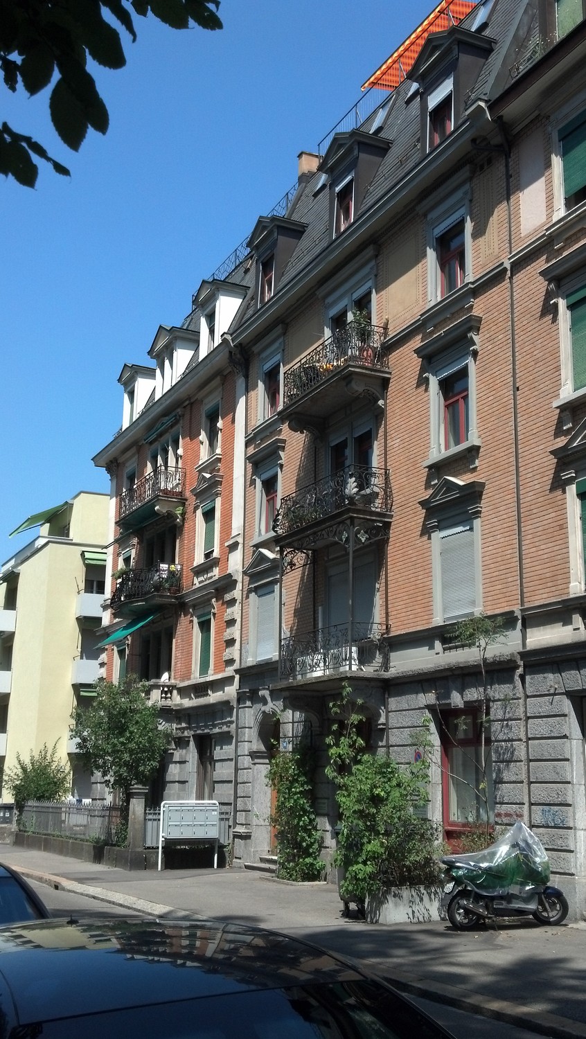
Doku/Images/mu7c0e2yxx6imnh1vxw870vgo3i83xzxu9uzmccsvjwquh1uh4.jpg
