Newtonsohn/BA-Smart-Waage/Doku/Images/neu_power_schema_smartbin .drawio.png

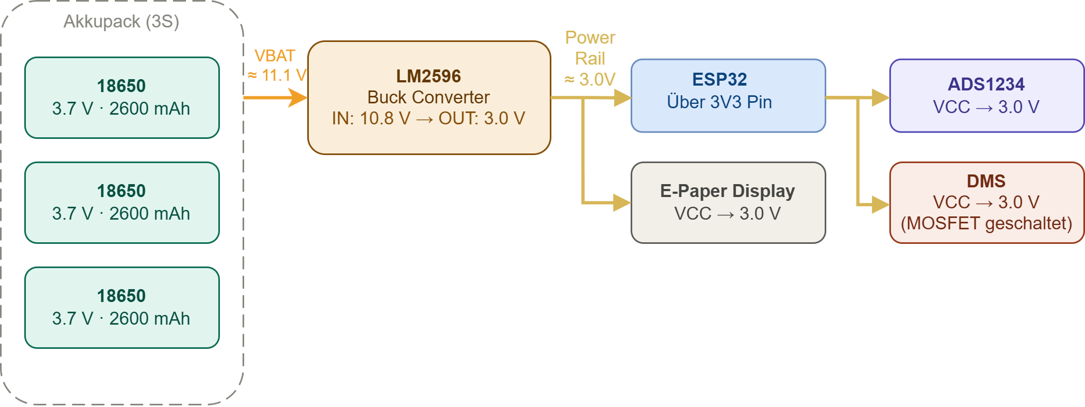
Doku/Images/neu_power_schema_smartbin .drawio.png
