Newtonsohn/BA-Smart-Waage/Doku/Images/neu_power_schema_smartbin.png

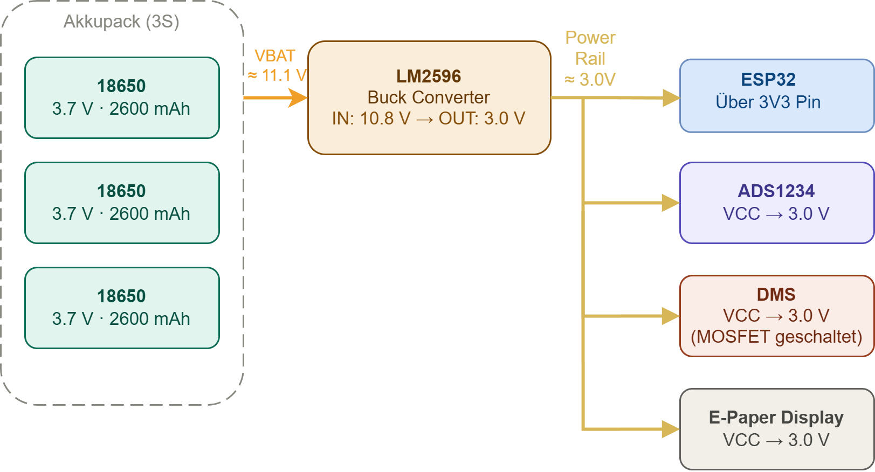
Doku/Images/neu_power_schema_smartbin.png
