Newtonsohn/BA-Smart-Waage/Doku/Images/power_schema_smartbin.drawio.png

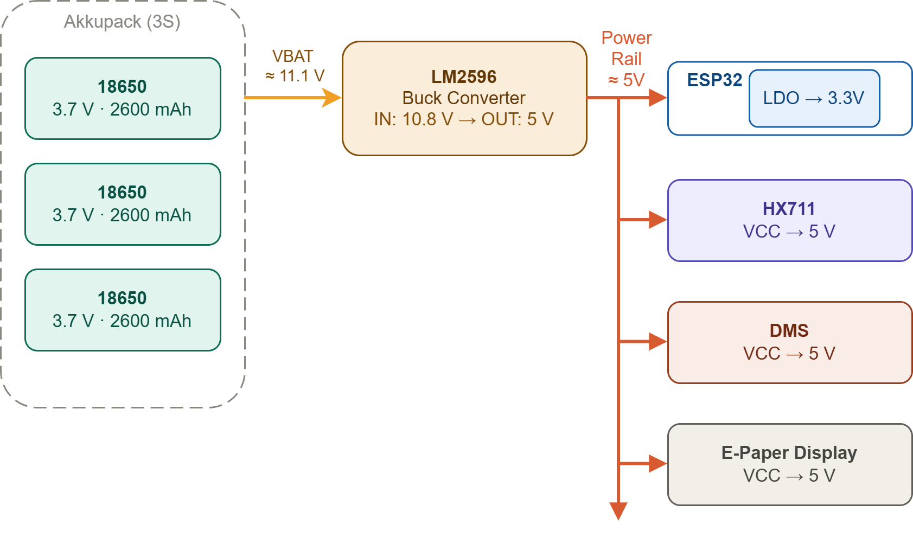
Doku/Images/power_schema_smartbin.drawio.png
