Newtonsohn/BA-Smart-Waage/Doku/Images/Schematics/ADC_Filtering.png

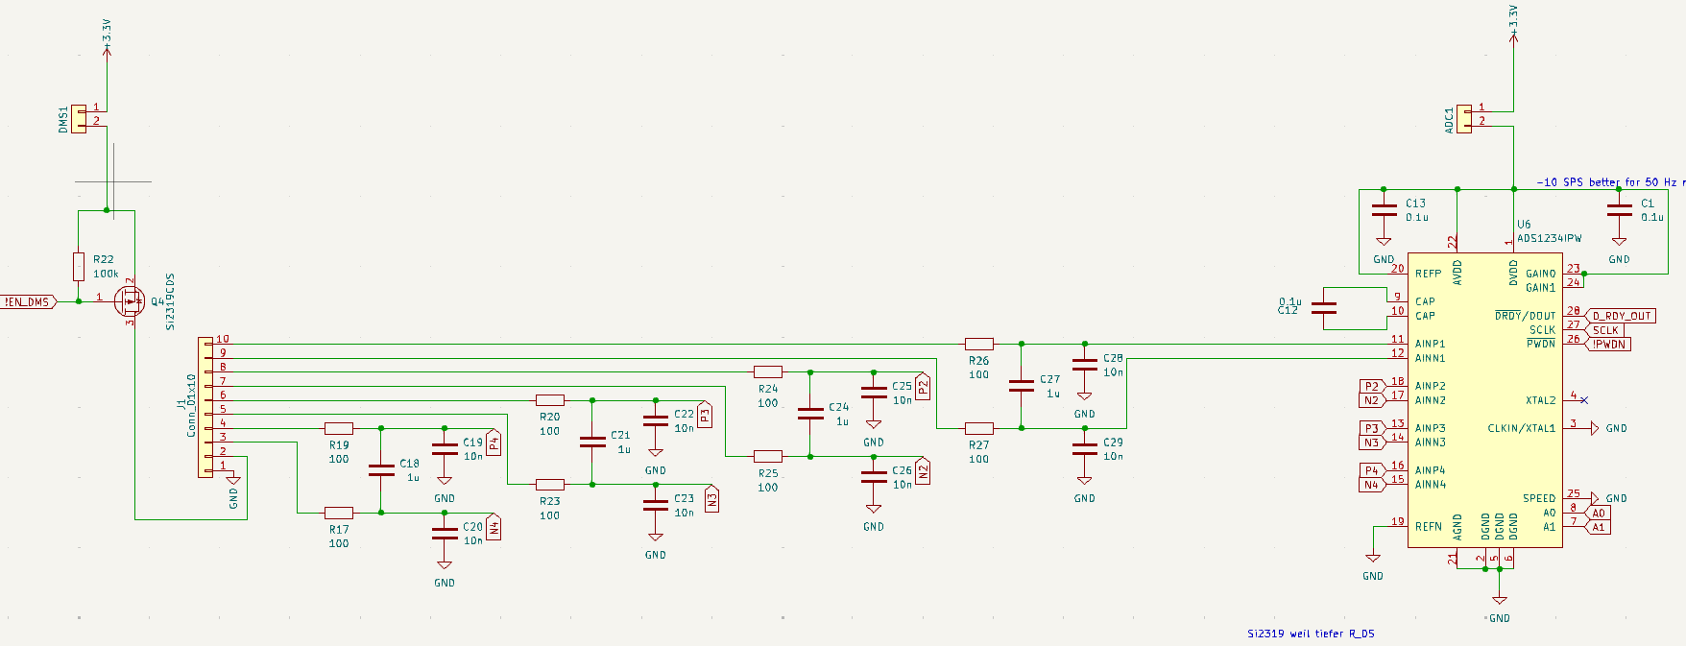
Doku/Images/Schematics/ADC_Filtering.png
