Newtonsohn/BA-Smart-Waage/Doku/Images/Schematics/bat_monitor.png

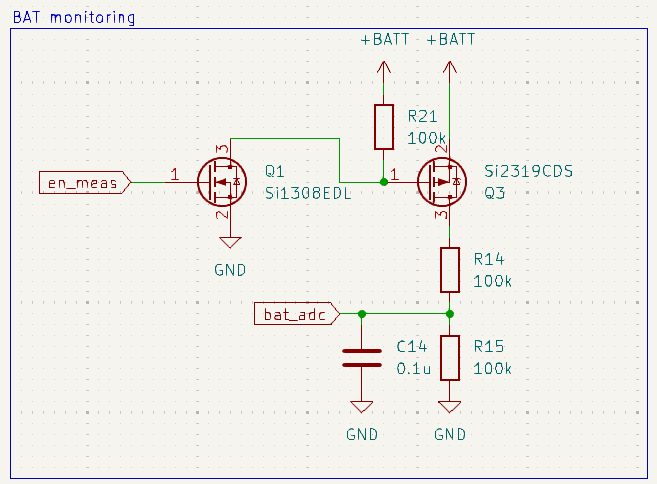
Doku/Images/Schematics/bat_monitor.png
