Newtonsohn/BA-Smart-Waage/Doku/Images/Schematics/Thermo.png

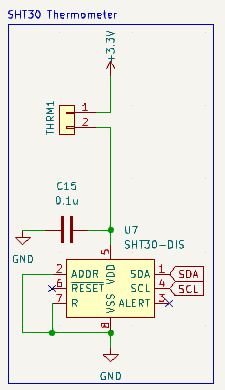
Doku/Images/Schematics/Thermo.png
