Newtonsohn/BA-Smart-Waage/Doku/Images/signed.png

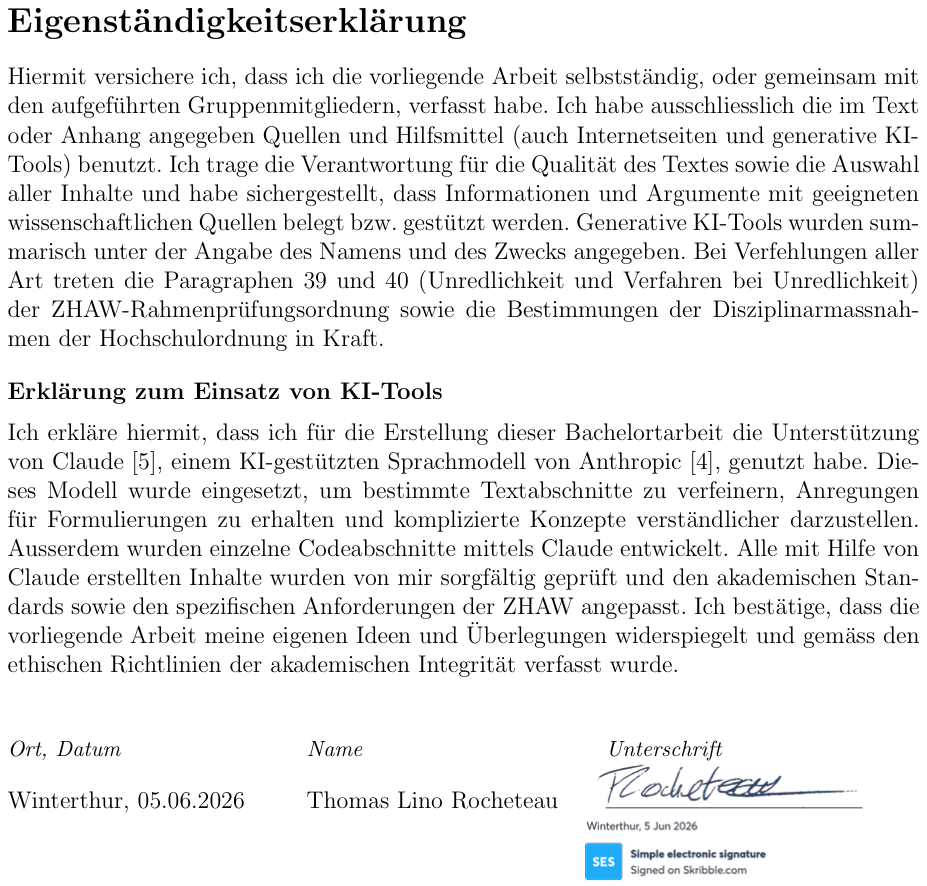
Doku/Images/signed.png
