Newtonsohn/BA-Smart-Waage/Doku/Images/Stromverbrauch/JouleScope/Deepsleep/neu/mitADC.png

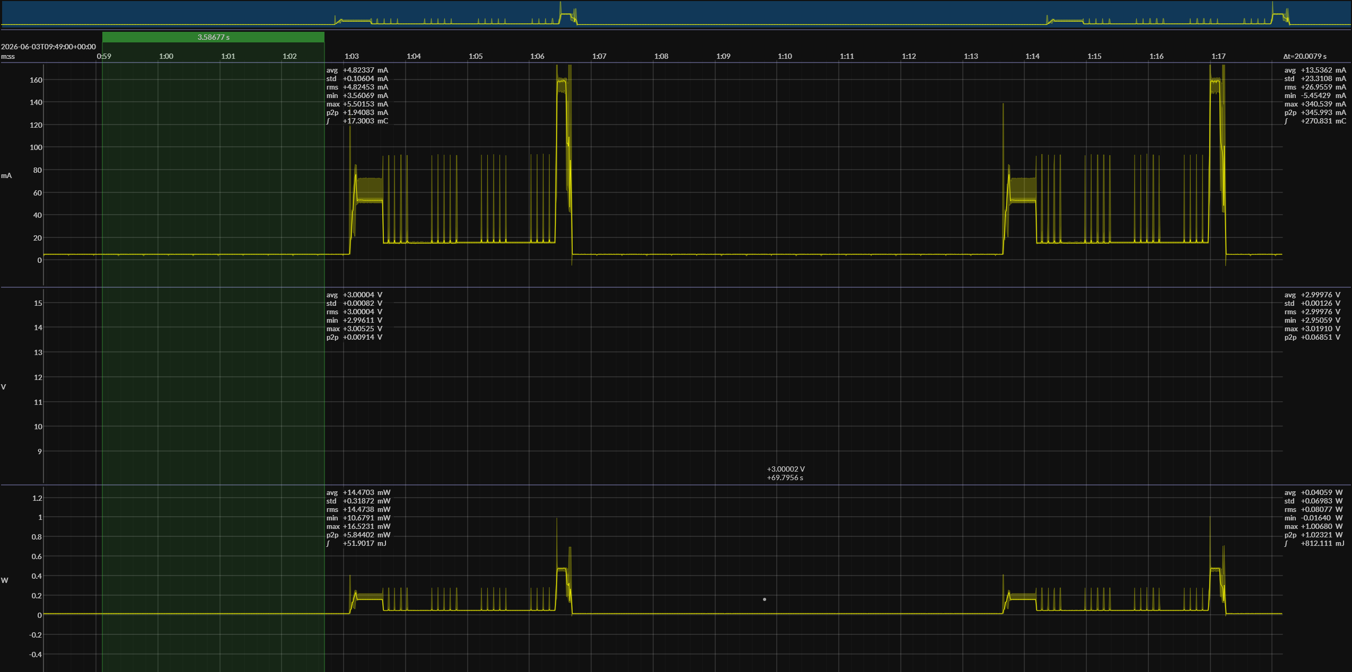
Doku/Images/Stromverbrauch/JouleScope/Deepsleep/neu/mitADC.png
