Newtonsohn/BA-Smart-Waage/Doku/Images/Stromverbrauch/JouleScope/neu/ADC.png

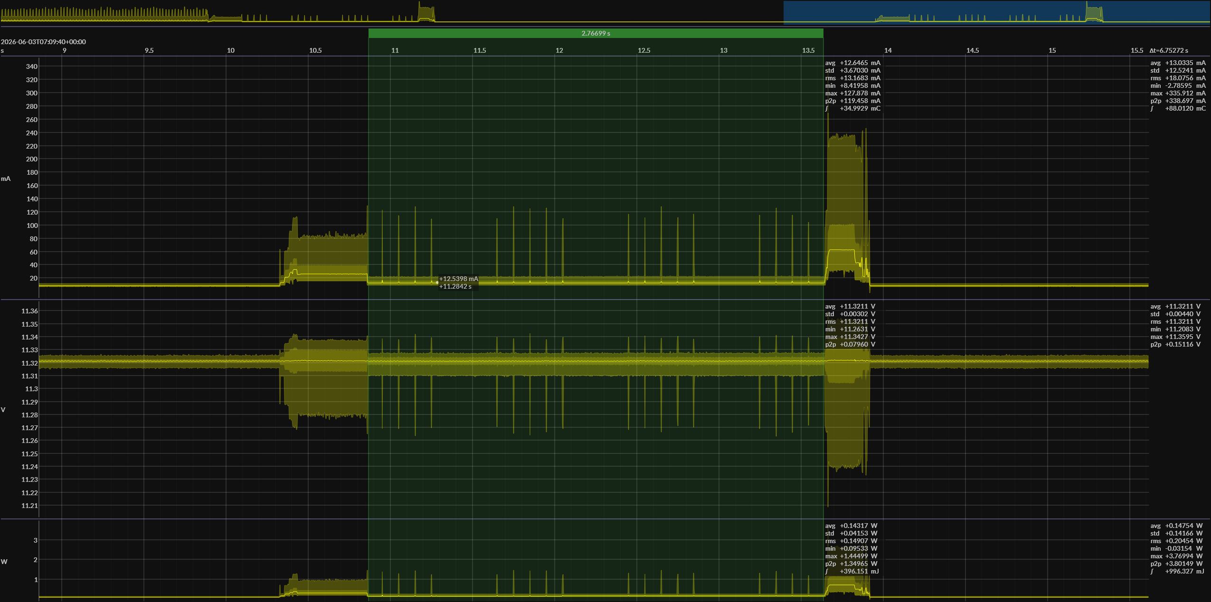
Doku/Images/Stromverbrauch/JouleScope/neu/ADC.png
