Newtonsohn/BA-Smart-Waage/Doku/Images/Stromverbrauch/JouleScope/neu/BLE.png

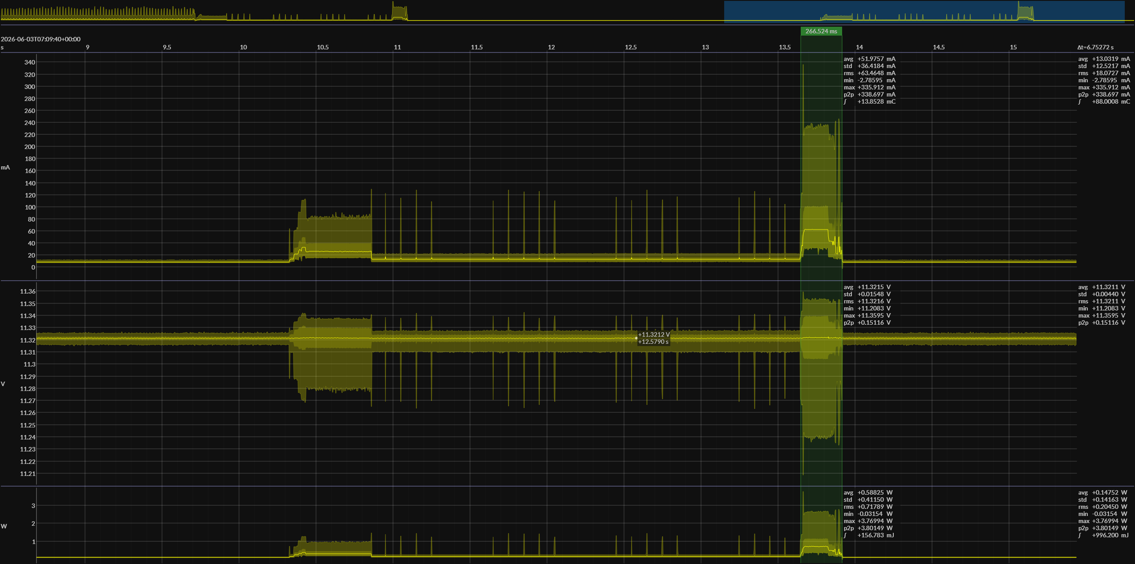
Doku/Images/Stromverbrauch/JouleScope/neu/BLE.png
