Newtonsohn/BA-Smart-Waage/Doku/Images/Stromverbrauch/JouleScope/neu/Boot.png

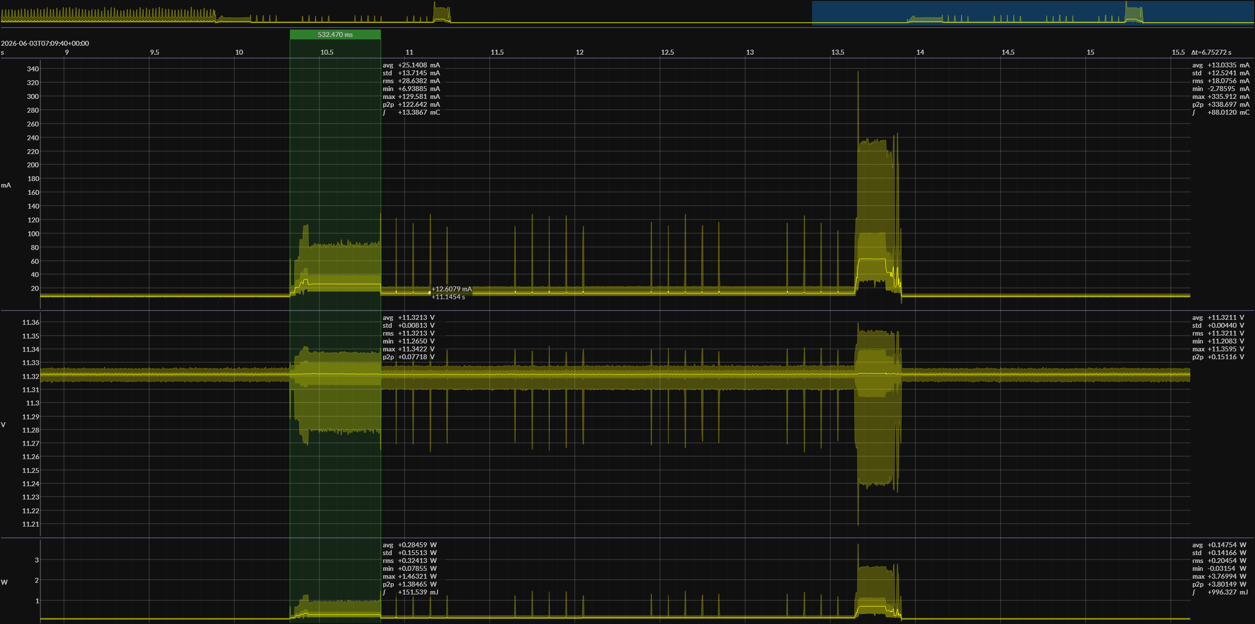
Doku/Images/Stromverbrauch/JouleScope/neu/Boot.png
