Newtonsohn/BA-Smart-Waage/Doku/Images/Stromverbrauch/JouleScope/neu/neu_vor_buck.png

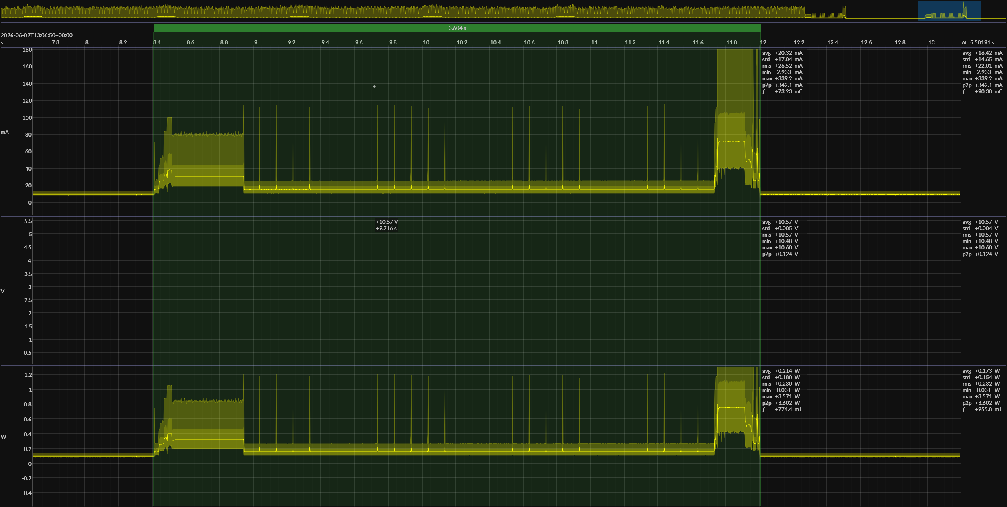
Doku/Images/Stromverbrauch/JouleScope/neu/neu_vor_buck.png
