Newtonsohn/BA-Smart-Waage/Doku/Images/Stromverbrauch/JouleScope/neu/new_esp32_3v3_3v_mitDMS/BLE.png

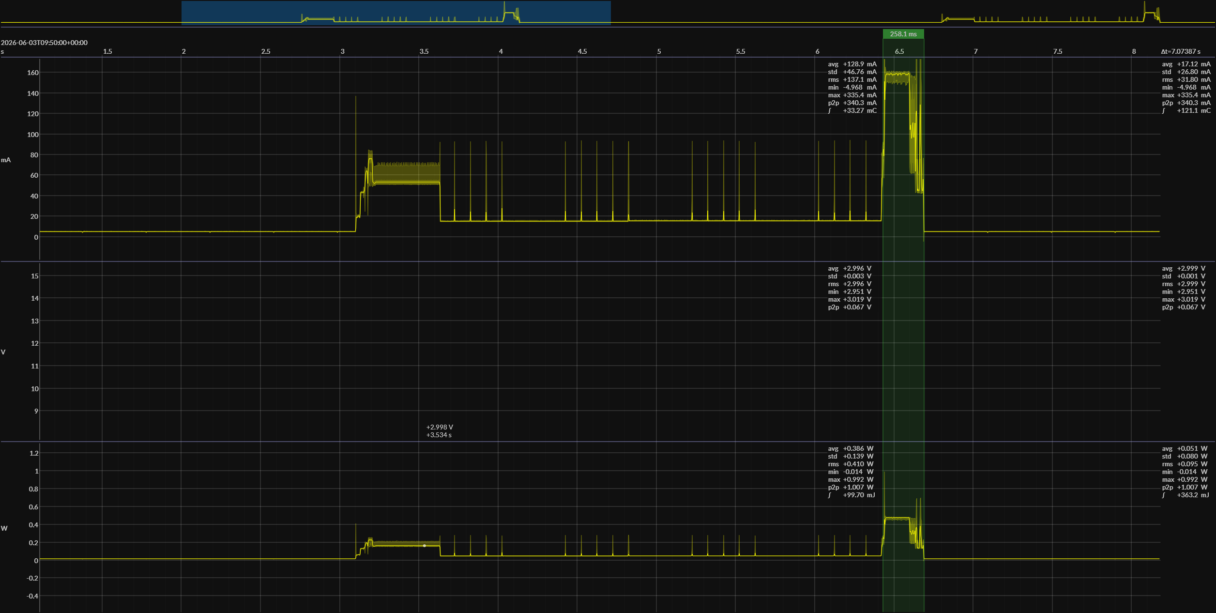
Doku/Images/Stromverbrauch/JouleScope/neu/new_esp32_3v3_3v_mitDMS/BLE.png
