Newtonsohn/BA-Smart-Waage/Doku/Images/Stromverbrauch/Nachher/BLE_ADV.png

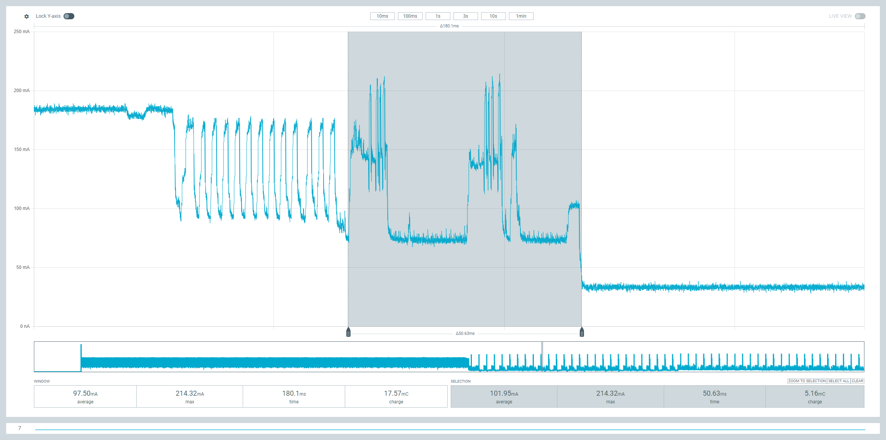
Doku/Images/Stromverbrauch/Nachher/BLE_ADV.png
