Newtonsohn/BA-Smart-Waage/Doku/Images/Stromverbrauch/Nachher/BLE_INIT.png

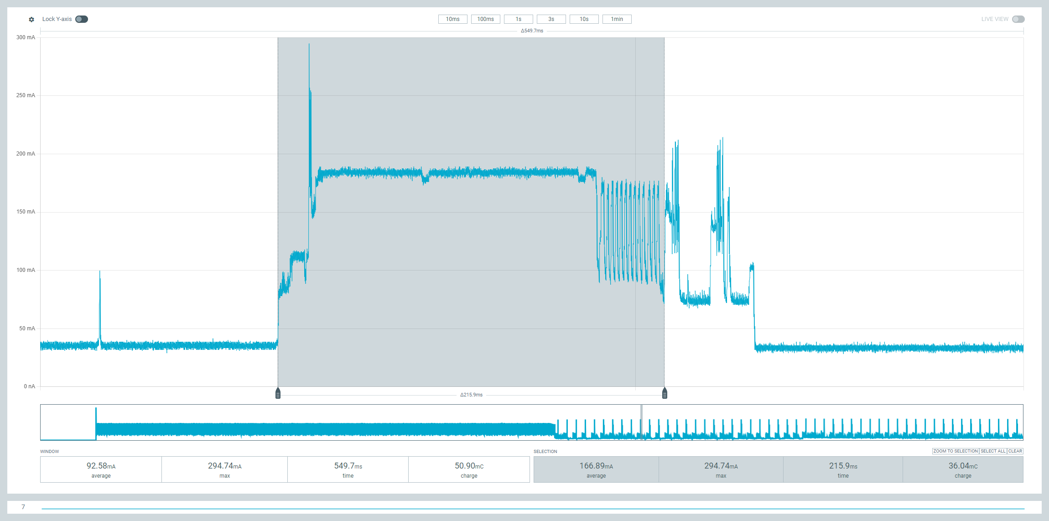
Doku/Images/Stromverbrauch/Nachher/BLE_INIT.png
