Newtonsohn/BA-Smart-Waage/Doku/Images/Stromverbrauch/Nachher/Buck/new_buck.png

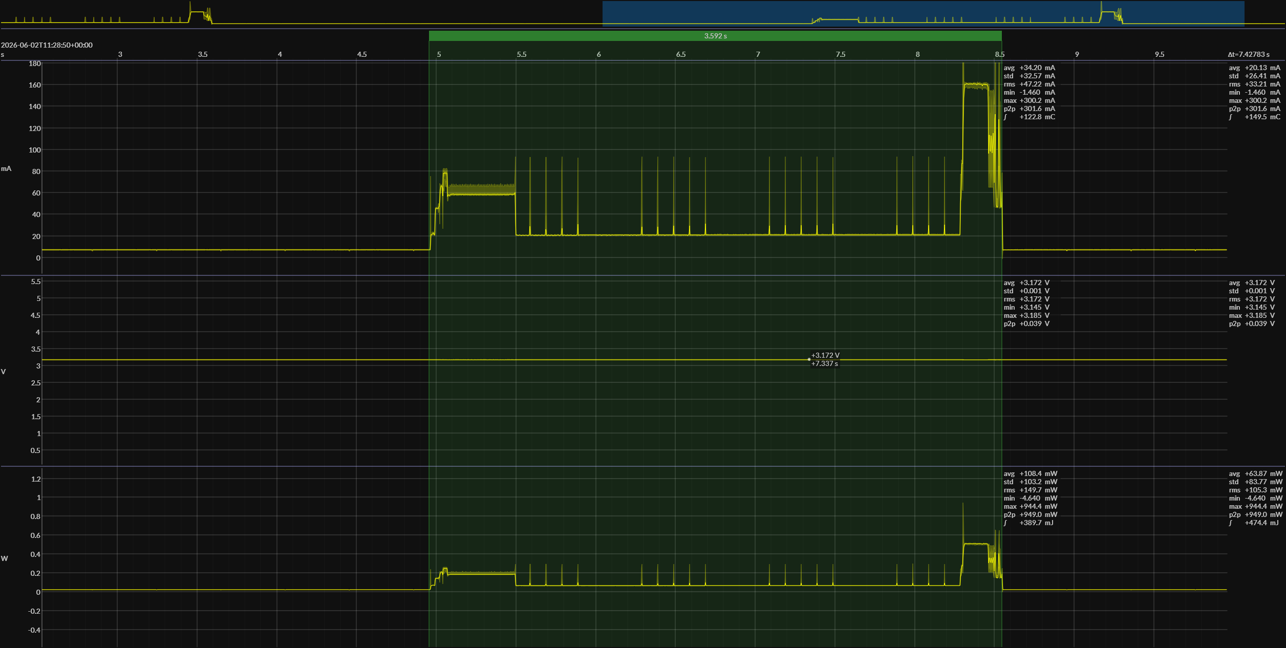
Doku/Images/Stromverbrauch/Nachher/Buck/new_buck.png
