Newtonsohn/BA-Smart-Waage/Doku/Images/Stromverbrauch/Nachher/init_bootup.png

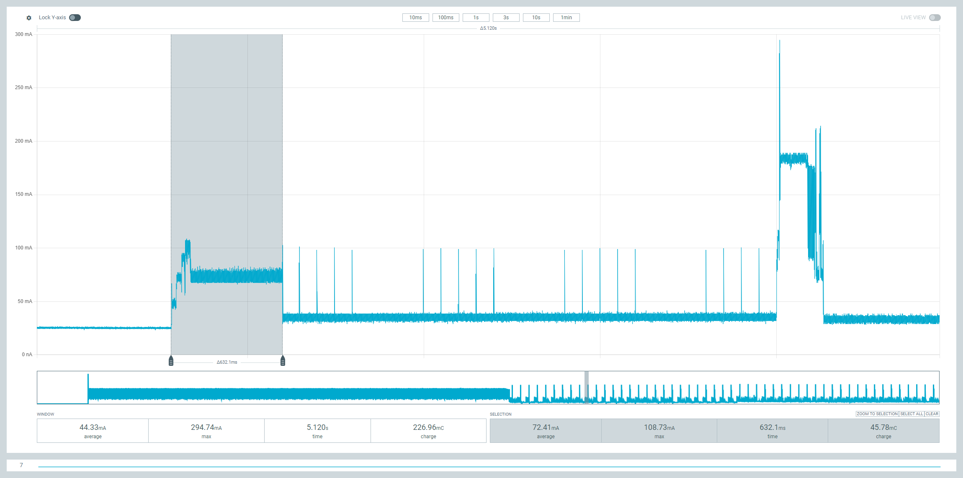
Doku/Images/Stromverbrauch/Nachher/init_bootup.png
