Newtonsohn/BA-Smart-Waage/Doku/Images/Stromverbrauch/Nachher/new_3v3/ADC.png

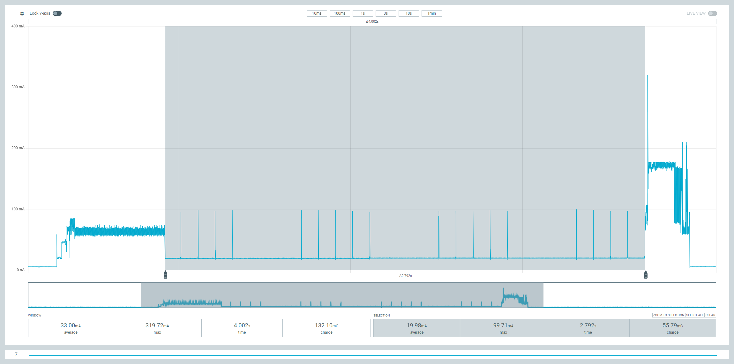
Doku/Images/Stromverbrauch/Nachher/new_3v3/ADC.png
