Newtonsohn/BA-Smart-Waage/Doku/Images/Stromverbrauch/Nachher/new_3v3/BLE.png

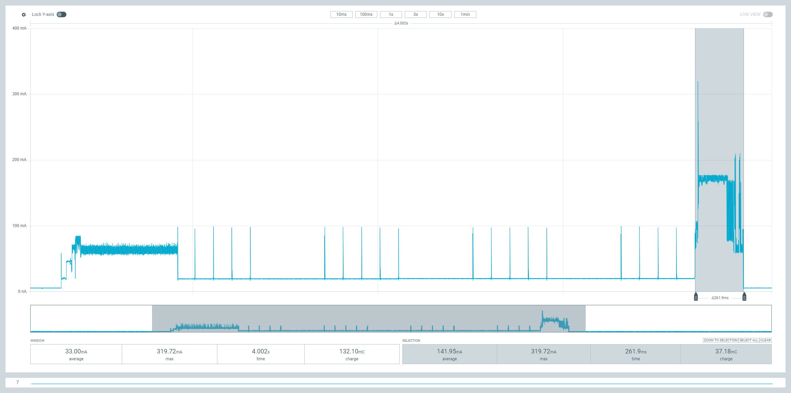
Doku/Images/Stromverbrauch/Nachher/new_3v3/BLE.png
