Newtonsohn/BA-Smart-Waage/Doku/Images/Stromverbrauch/Nachher/new_3v3/zyklus.png

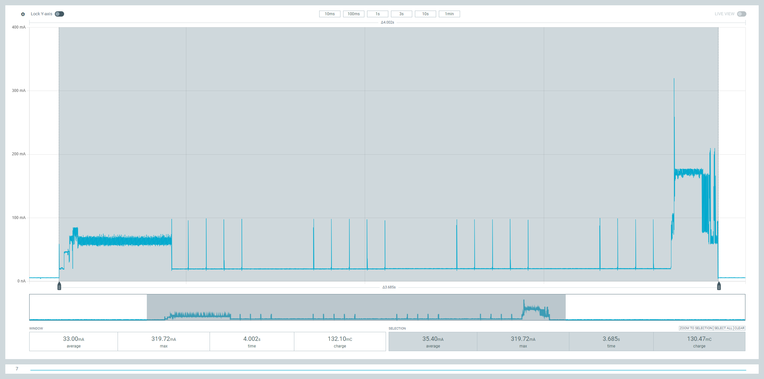
Doku/Images/Stromverbrauch/Nachher/new_3v3/zyklus.png
