Newtonsohn/BA-Smart-Waage/Doku/Images/Stromverbrauch/Stromverbrauch vorher/bootup.png

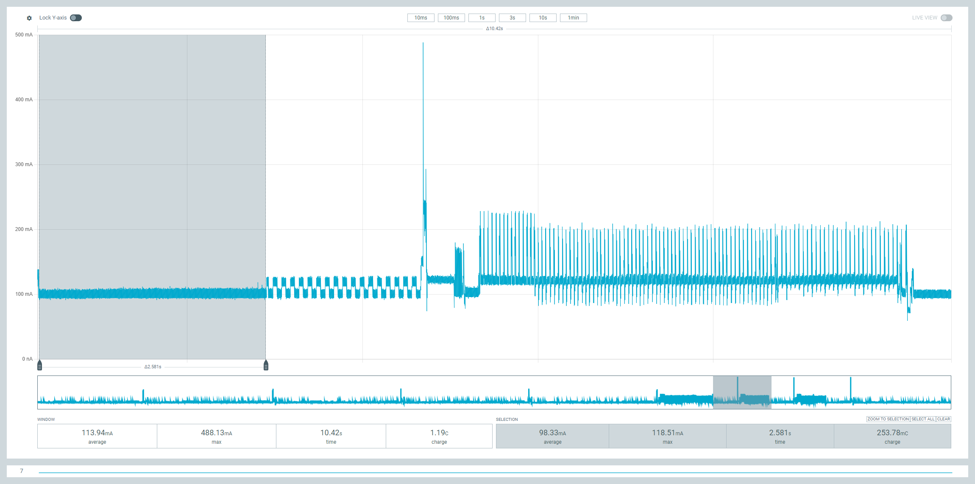
Doku/Images/Stromverbrauch/Stromverbrauch vorher/bootup.png
