Newtonsohn/BA-Smart-Waage/Doku/Images/Stromverbrauch/Stromverbrauch vorher/Direkt_ueber_3v3Pin/boot.png

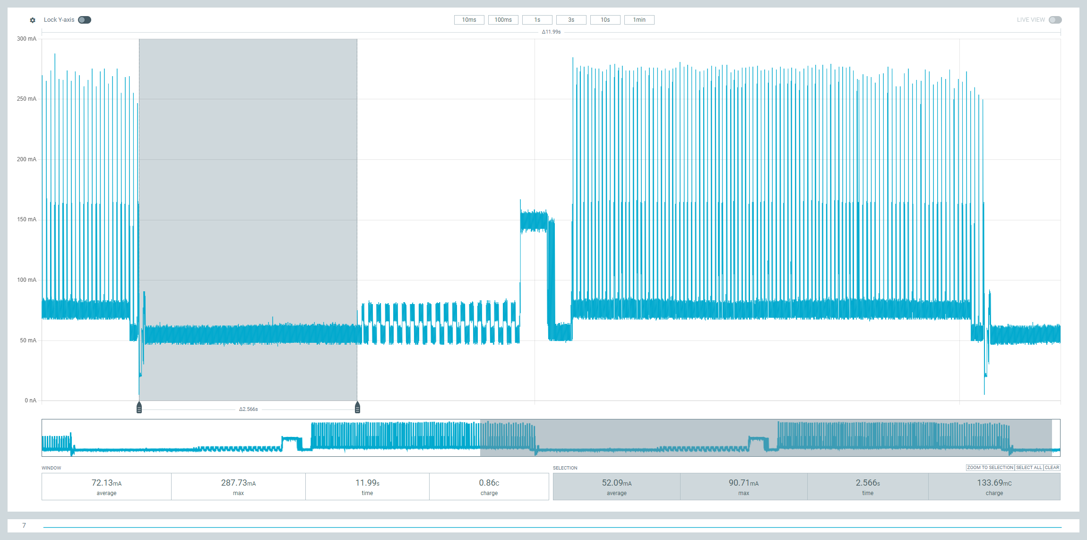
Doku/Images/Stromverbrauch/Stromverbrauch vorher/Direkt_ueber_3v3Pin/boot.png
