Newtonsohn/BA-Smart-Waage/Doku/Images/Stromverbrauch/Stromverbrauch vorher/DMS.png

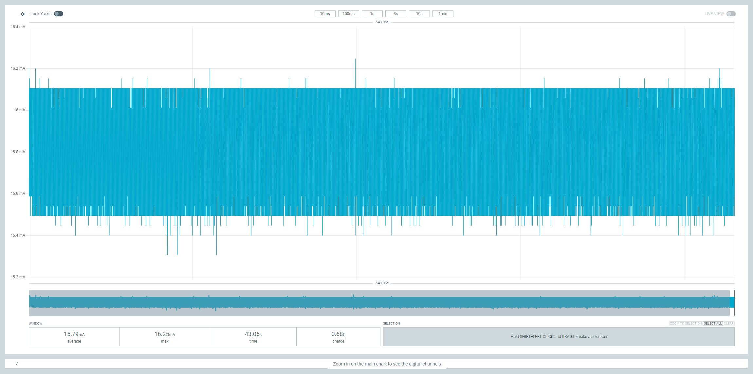
Doku/Images/Stromverbrauch/Stromverbrauch vorher/DMS.png
