Newtonsohn/BA-Smart-Waage/Doku/Images/Stromverbrauch/Stromverbrauch vorher/Durchschnittlicher Stromverbrauch Ausgangslage.png

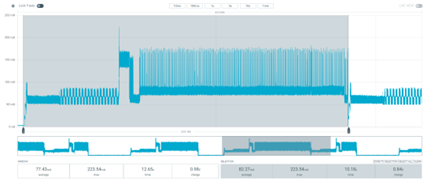
Doku/Images/Stromverbrauch/Stromverbrauch vorher/Durchschnittlicher Stromverbrauch Ausgangslage.png
