Newtonsohn/BA-Smart-Waage/Doku/Images/Stromverbrauch/Stromverbrauch vorher/Stat_Alles.png

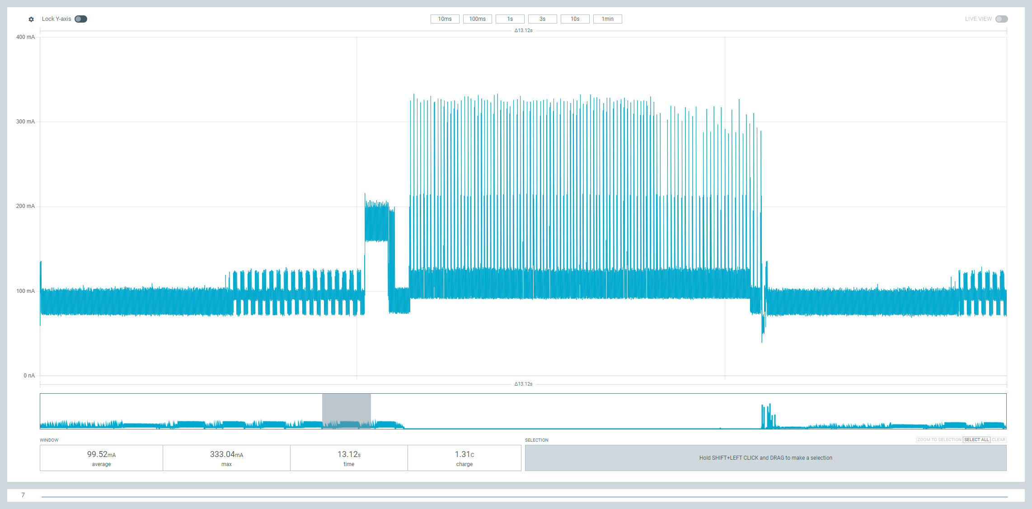
Doku/Images/Stromverbrauch/Stromverbrauch vorher/Stat_Alles.png
