Newtonsohn/BA-Smart-Waage/Doku/Images/Stromverbrauch/Stromverbrauch vorher/Stat_Vin.png

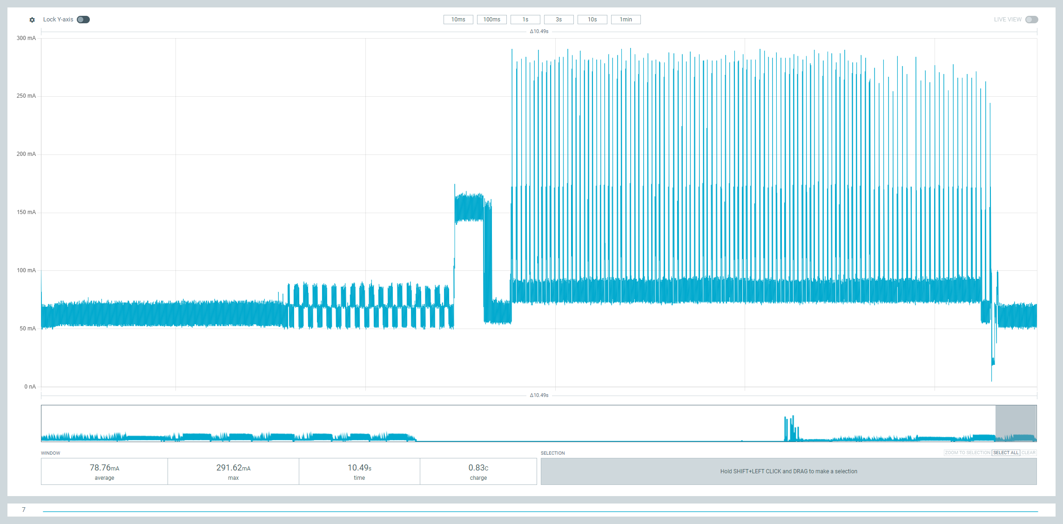
Doku/Images/Stromverbrauch/Stromverbrauch vorher/Stat_Vin.png
