Newtonsohn/BA-Smart-Waage/Doku/Images/Stromverbrauch/Stromverbrauch vorher/Stromvorher Gesamt.png

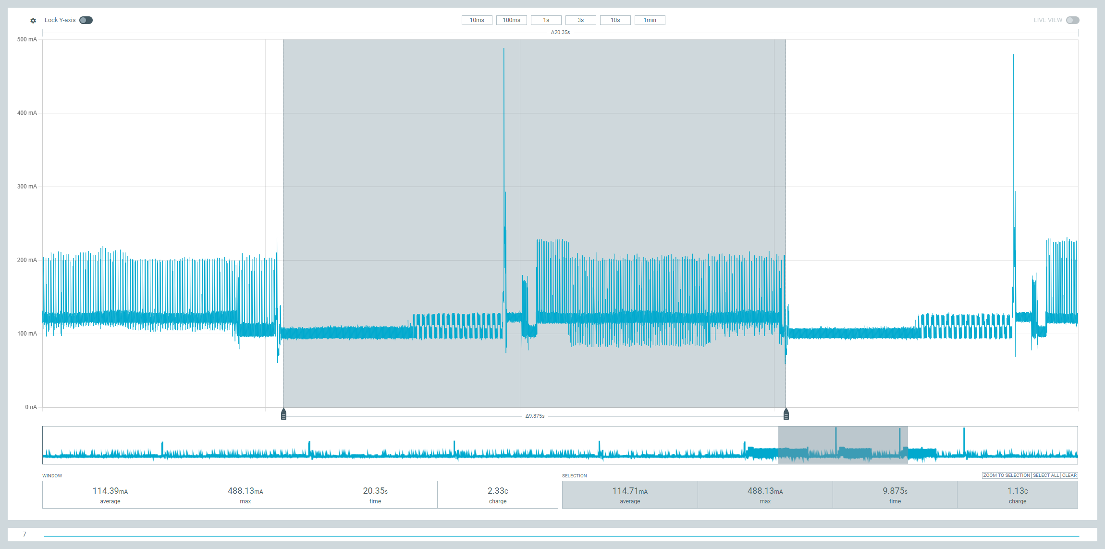
Doku/Images/Stromverbrauch/Stromverbrauch vorher/Stromvorher Gesamt.png
