Newtonsohn/BA-Smart-Waage/Doku/Images/WhatsApp Image 2026-06-05 at 12.04.05 (1).jpeg

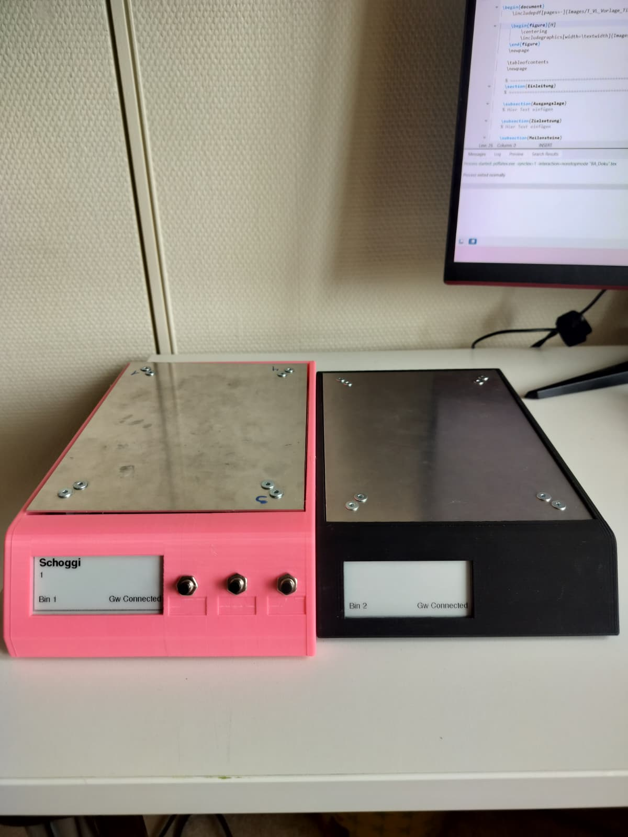
Doku/Images/WhatsApp Image 2026-06-05 at 12.04.05 (1).jpeg
