Newtonsohn/BA-Smart-Waage/CAD/Scale-Case_new.3mf

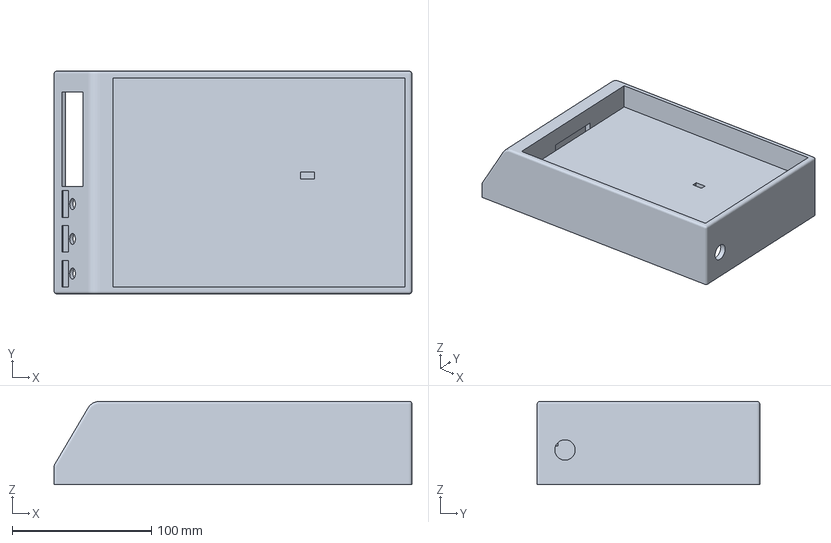
[picture p88: CAD file, 2026-06-05]
CAD/Scale-Case_new.3mf
257.2 x 160.0 x 60.0 mm
