Newtonsohn/BA-Smart-Waage/(list of files, cad)

Other CAD files:
CAD/Scale-Case.f3d
CAD/Scale-Case_new.stl
