Newtonsohn/BA-Smart-Waage/Doku/Images/ESP32_Shield 2-ADC.pdf

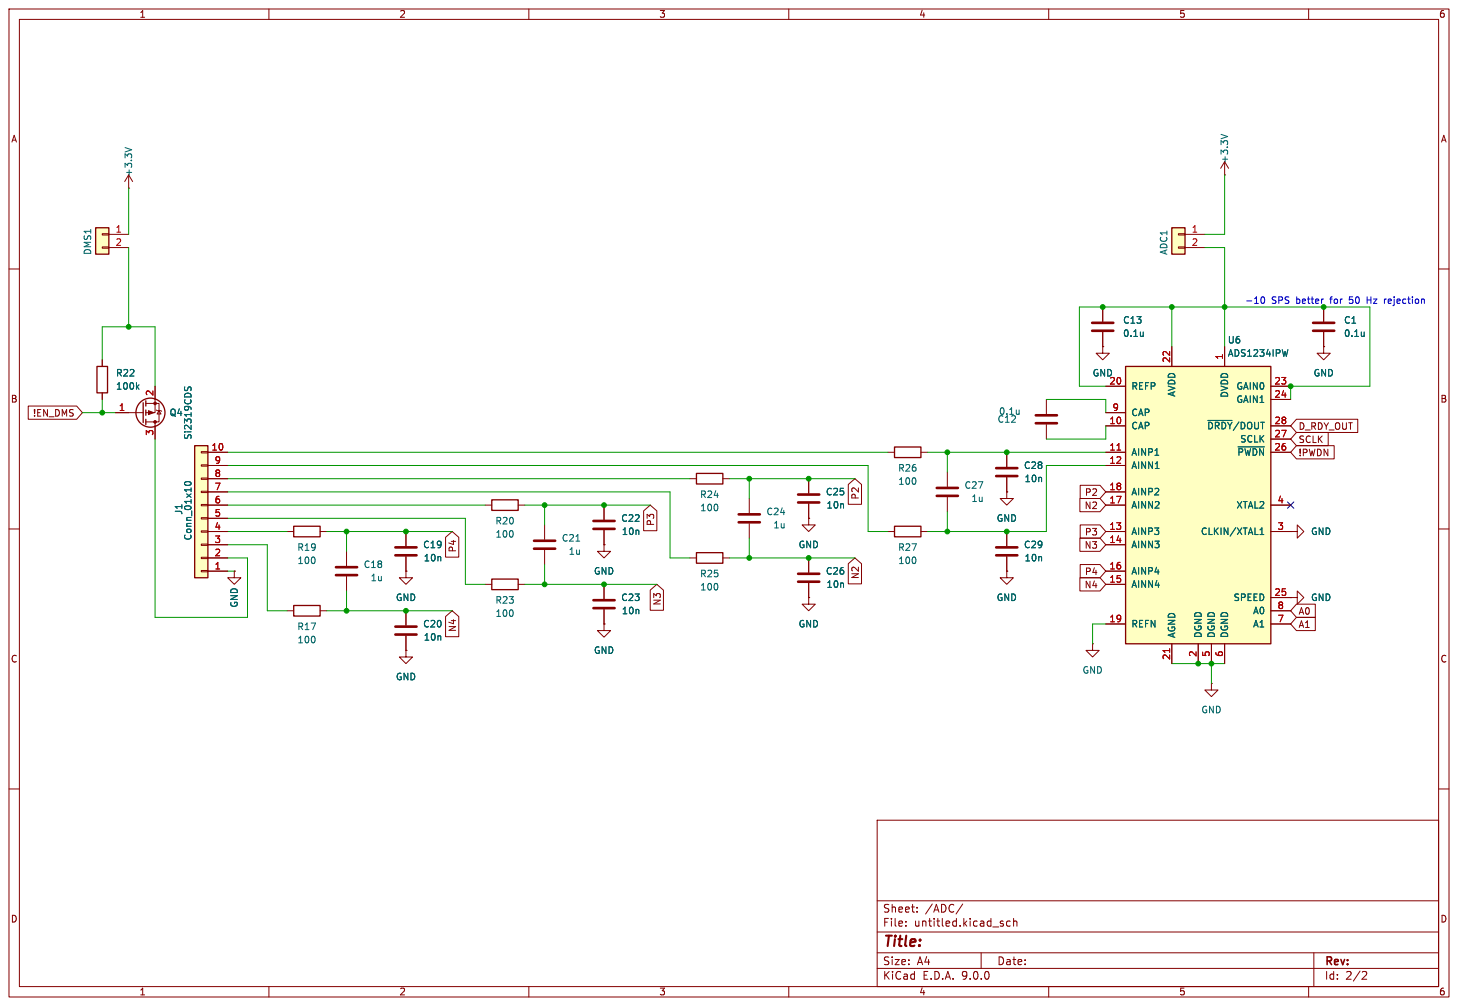
[picture p89: page 1]

6 GAIN0 23 GAIN1 24 ~{DRDY}/DOUT28 SCLK 27 ~{PWDN}26 XTAL2 4 CLKIN/XTAL1 3 SPEED 25 A0 8 A1 7 U6ADS1234IPW

6 GAIN0 23 GAIN1 24 ~{DRDY}/DOUT28 SCLK 27 ~{PWDN}26 XTAL2 4 CLKIN/XTAL1 3 SPEED 25 A0 8 A1 7 GND
