Newtonsohn/BA-Smart-Waage/Doku/Images/ESP32_Shield 2.pdf

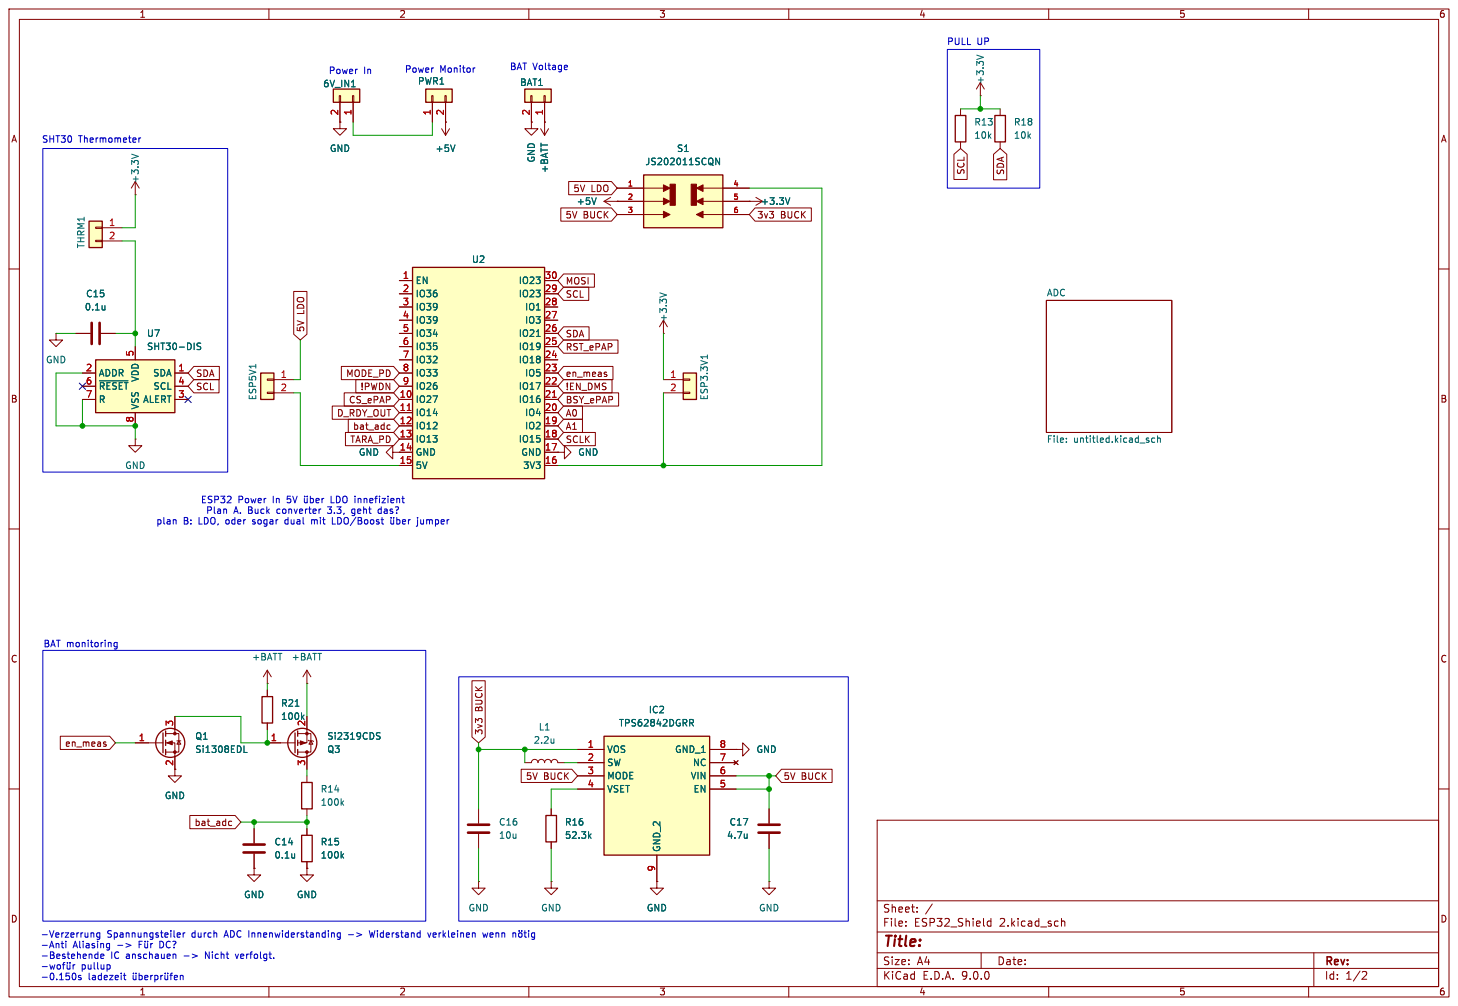
[picture p90: page 1]

8 SDA 1 SCL 4 ALERT 3 U7SHT30-DIS

9 GND_1 8 NC 7 VIN 6 EN 5 GND
