Newtonsohn/BA-Smart-Waage/Doku/Images/BA_Doku_removed_signed.pdf

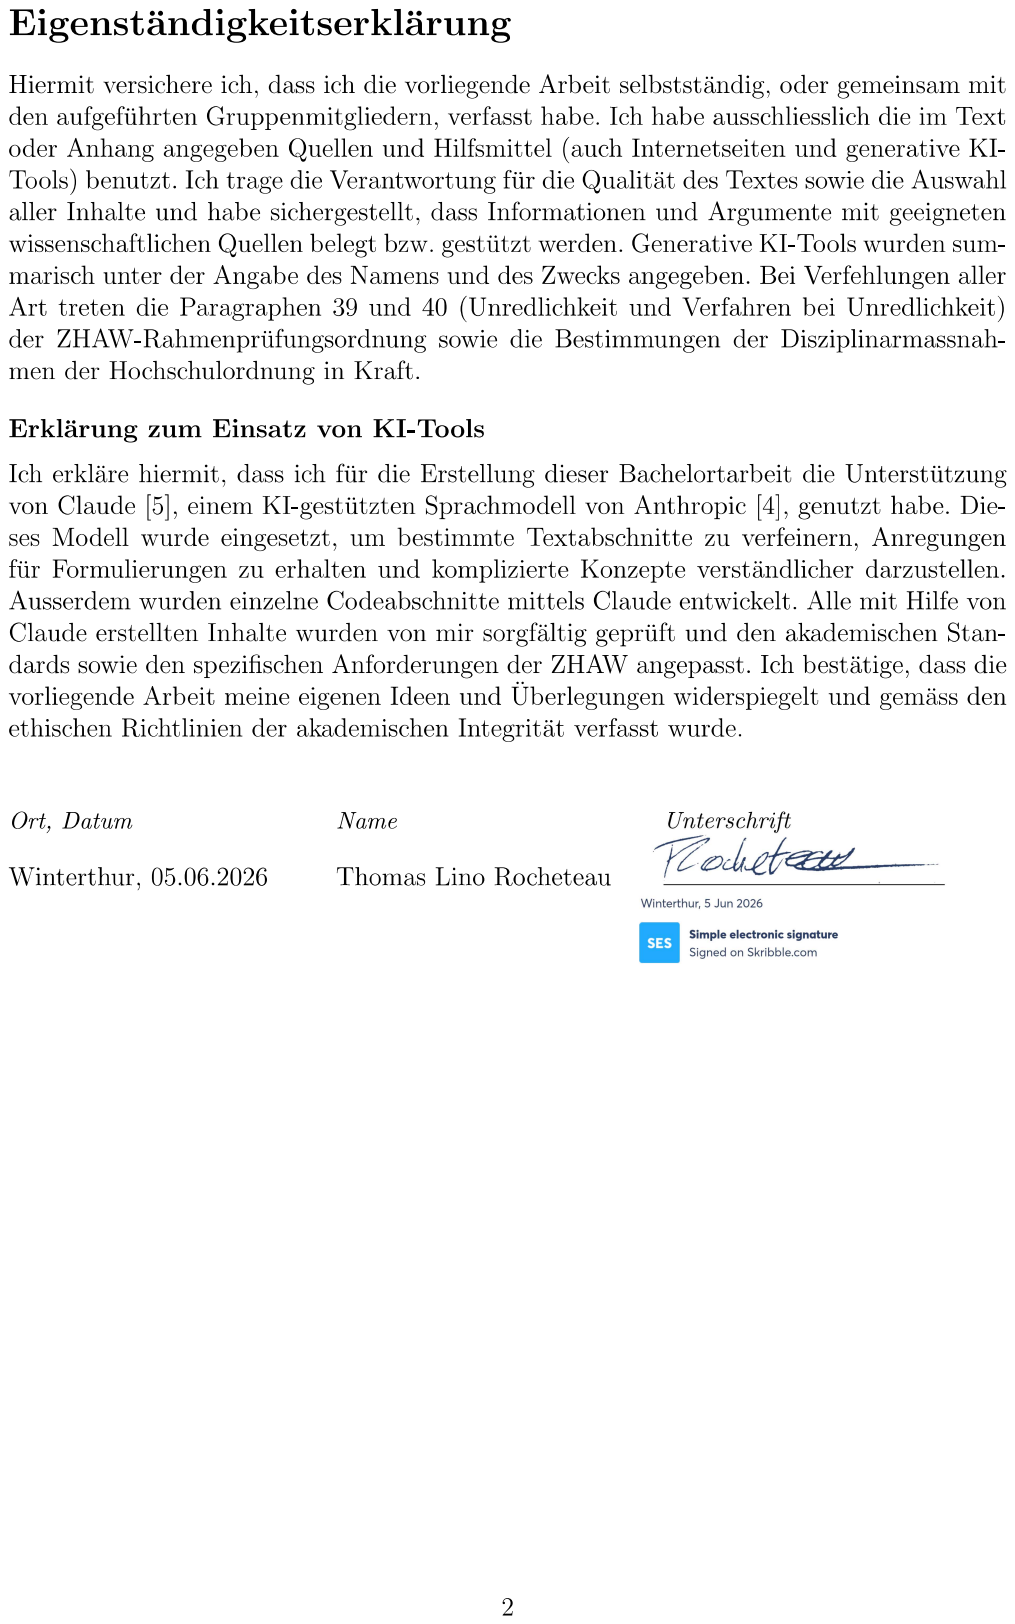
[picture p91: page 1]
