Newtonsohn/BA-Smart-Waage/Doku/Images/BA26_brnn_241-Vereinbarung_signed.pdf

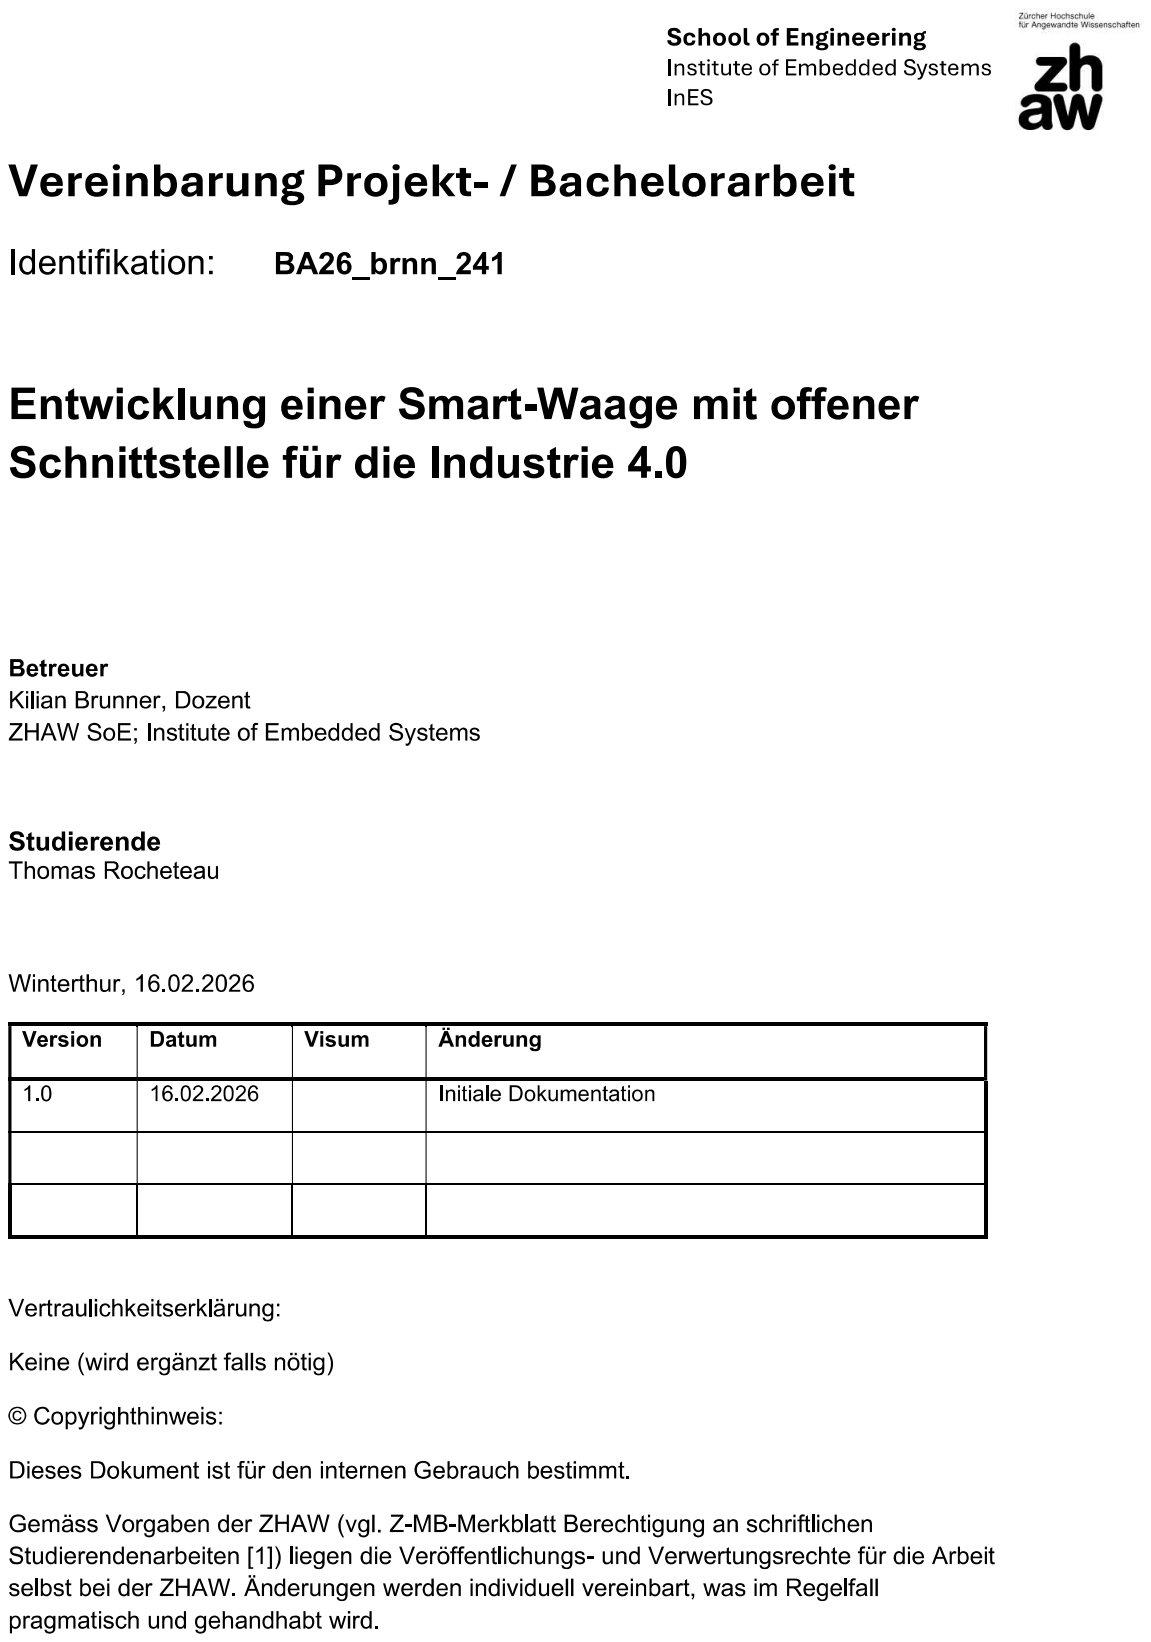
[picture p92: page 1]

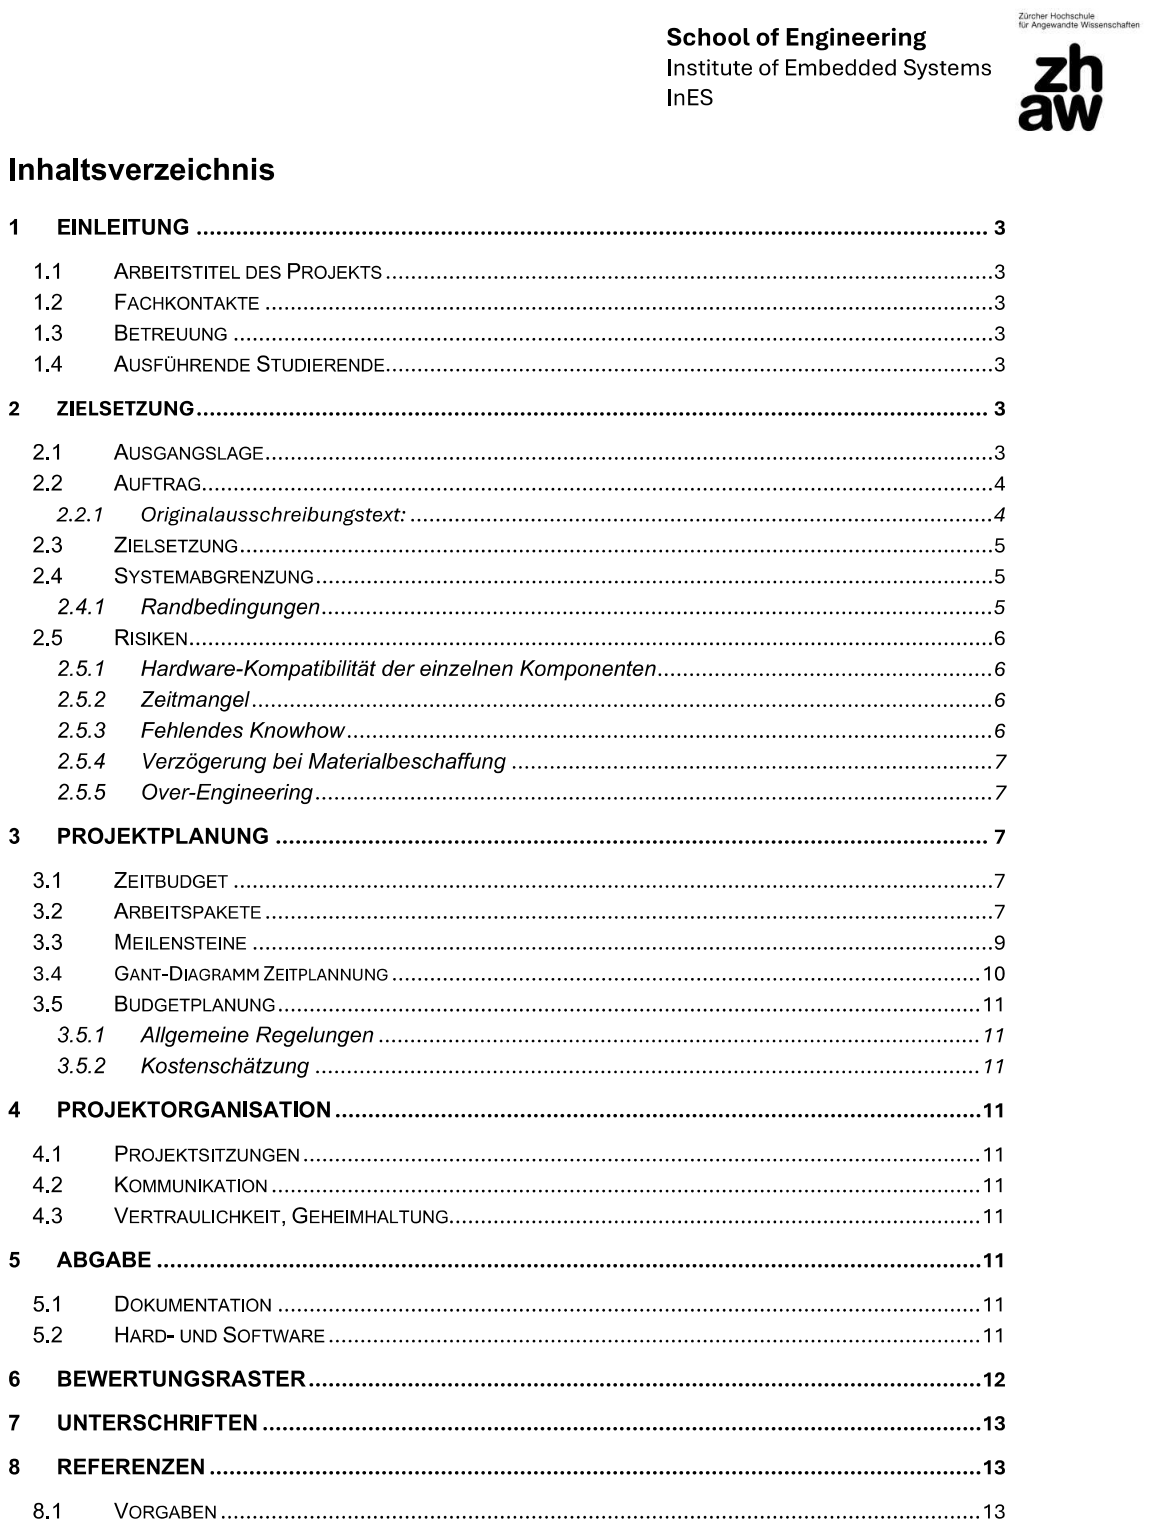
[picture p93: page 2]

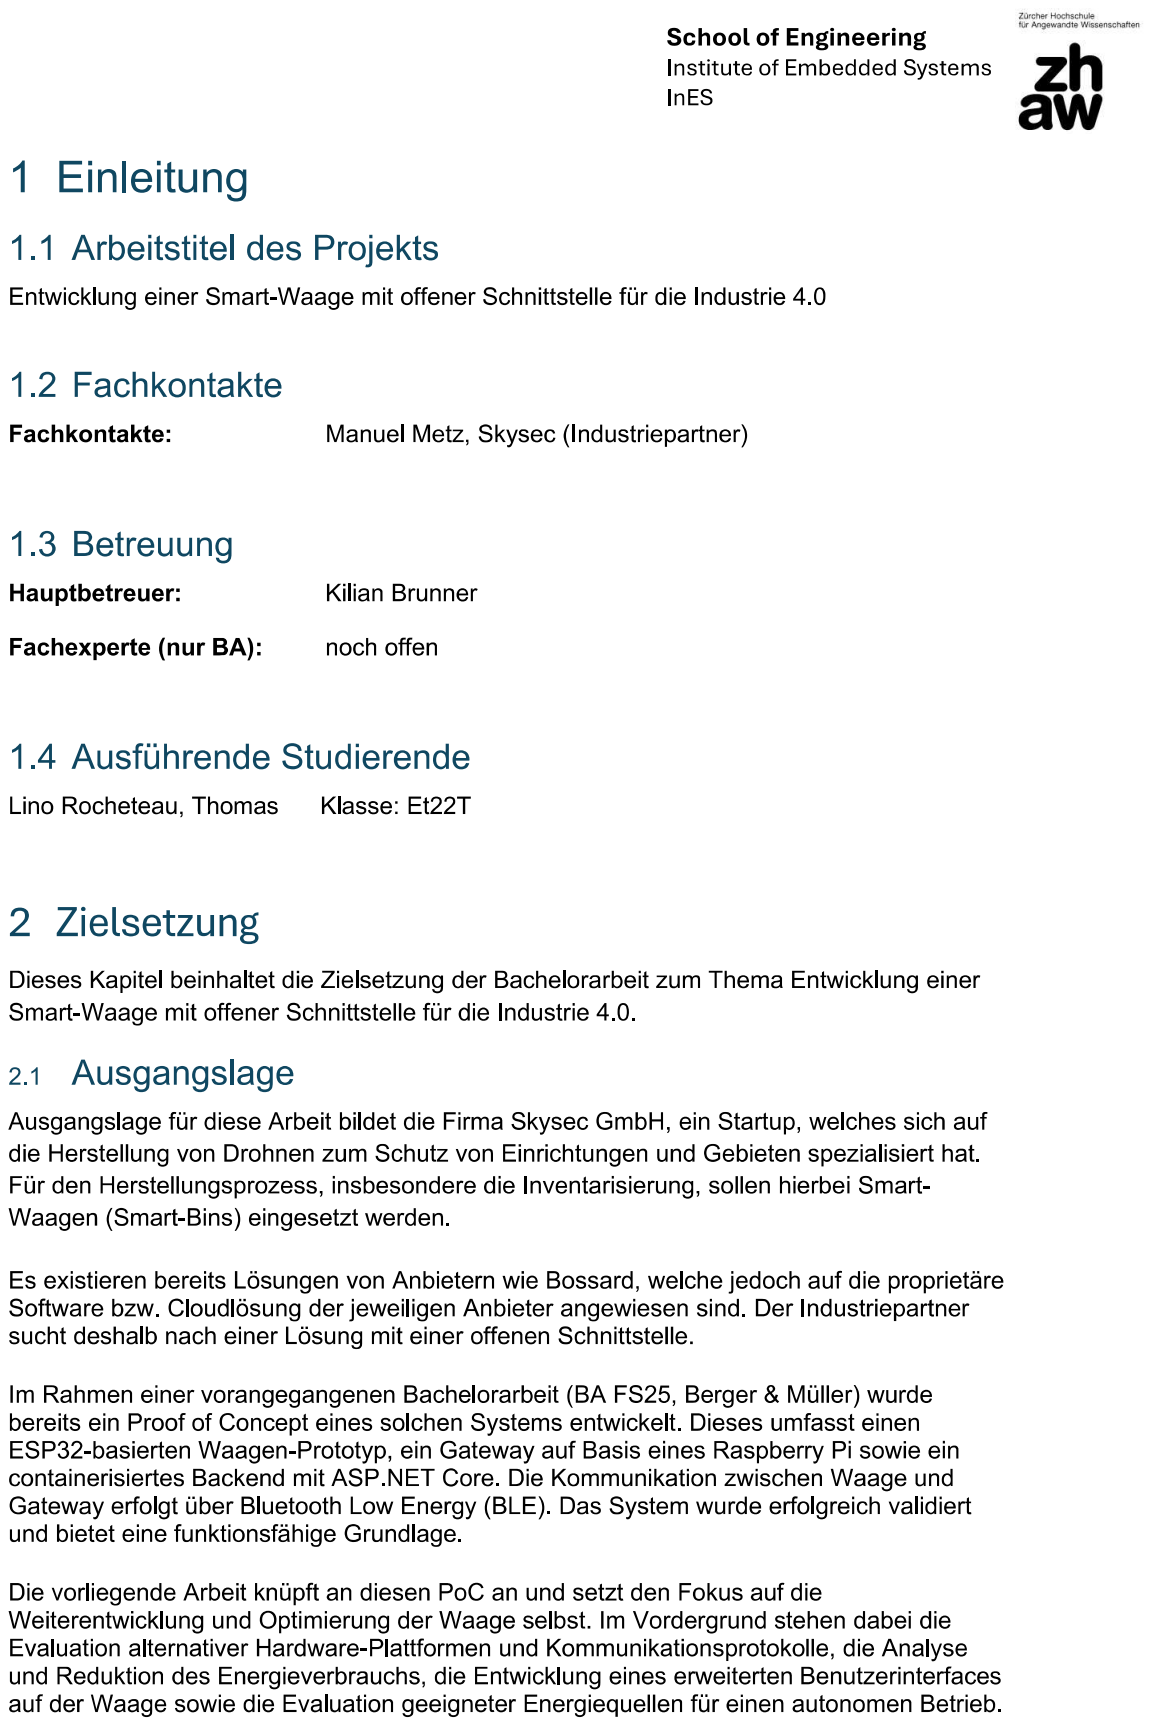
[picture p94: page 3]

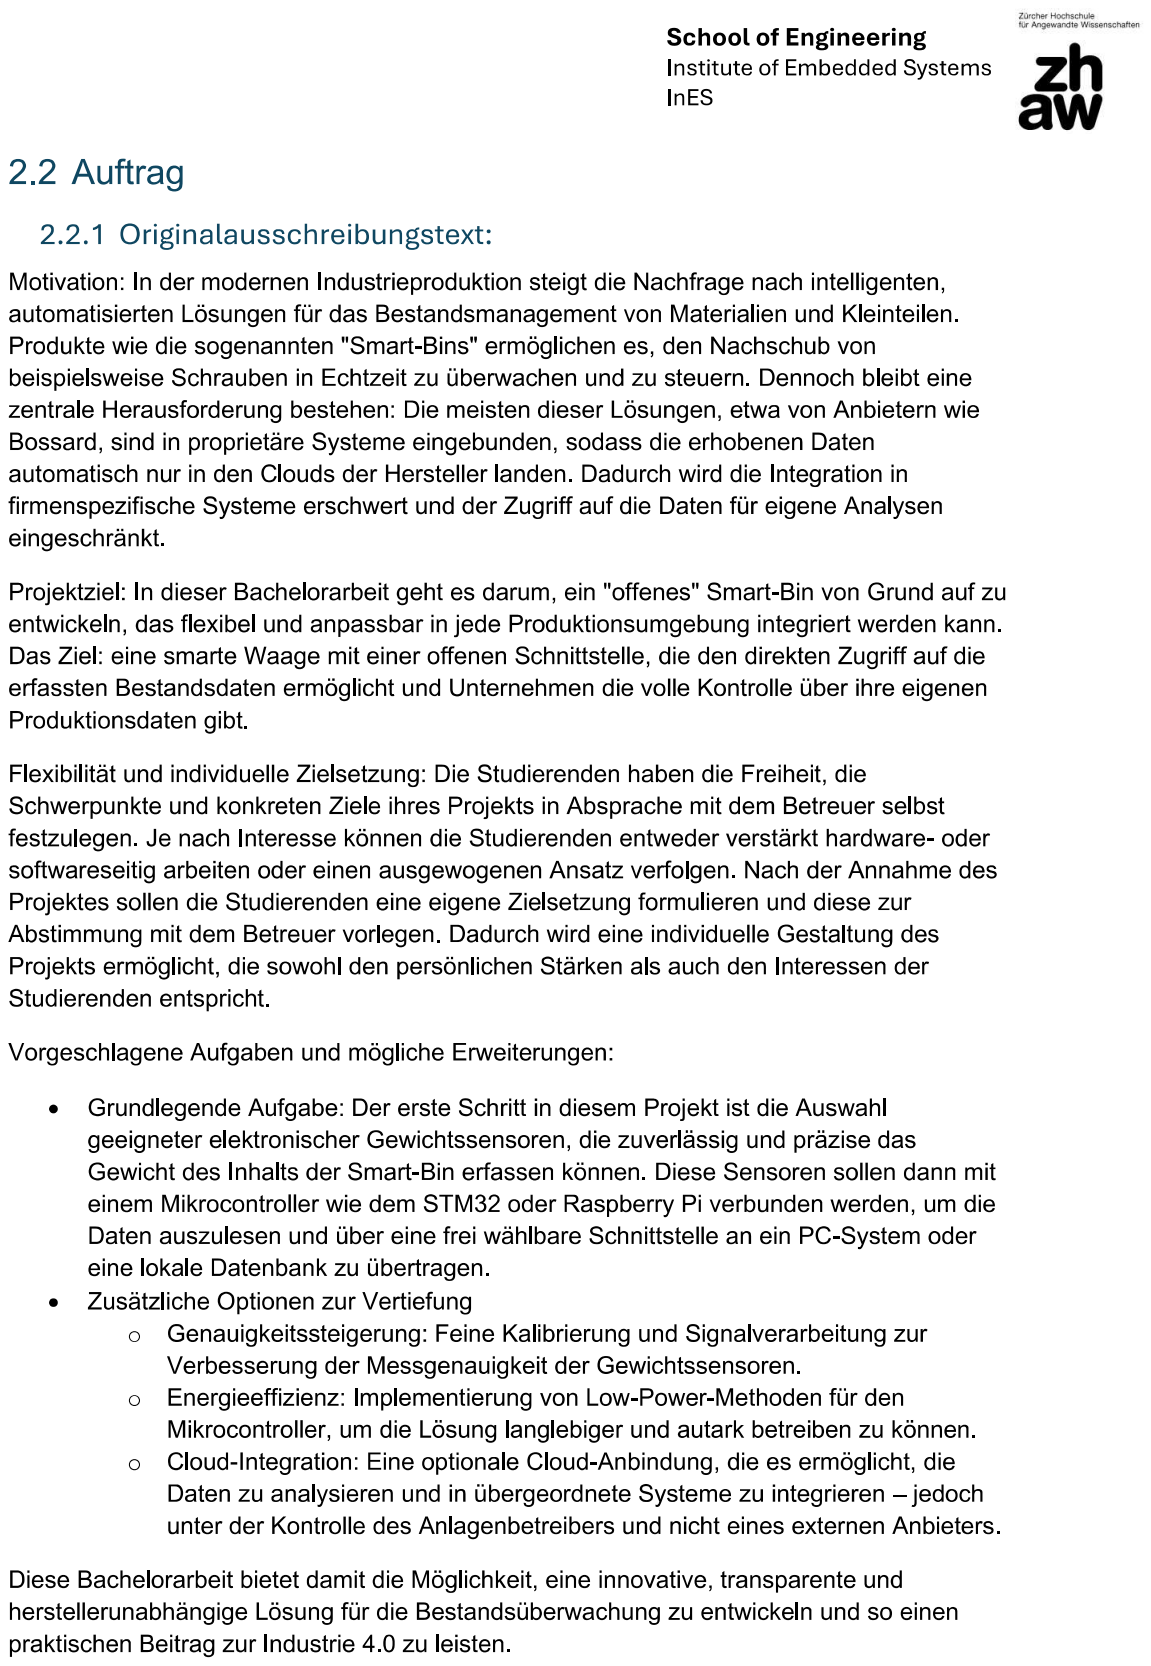
[picture p95: page 4]

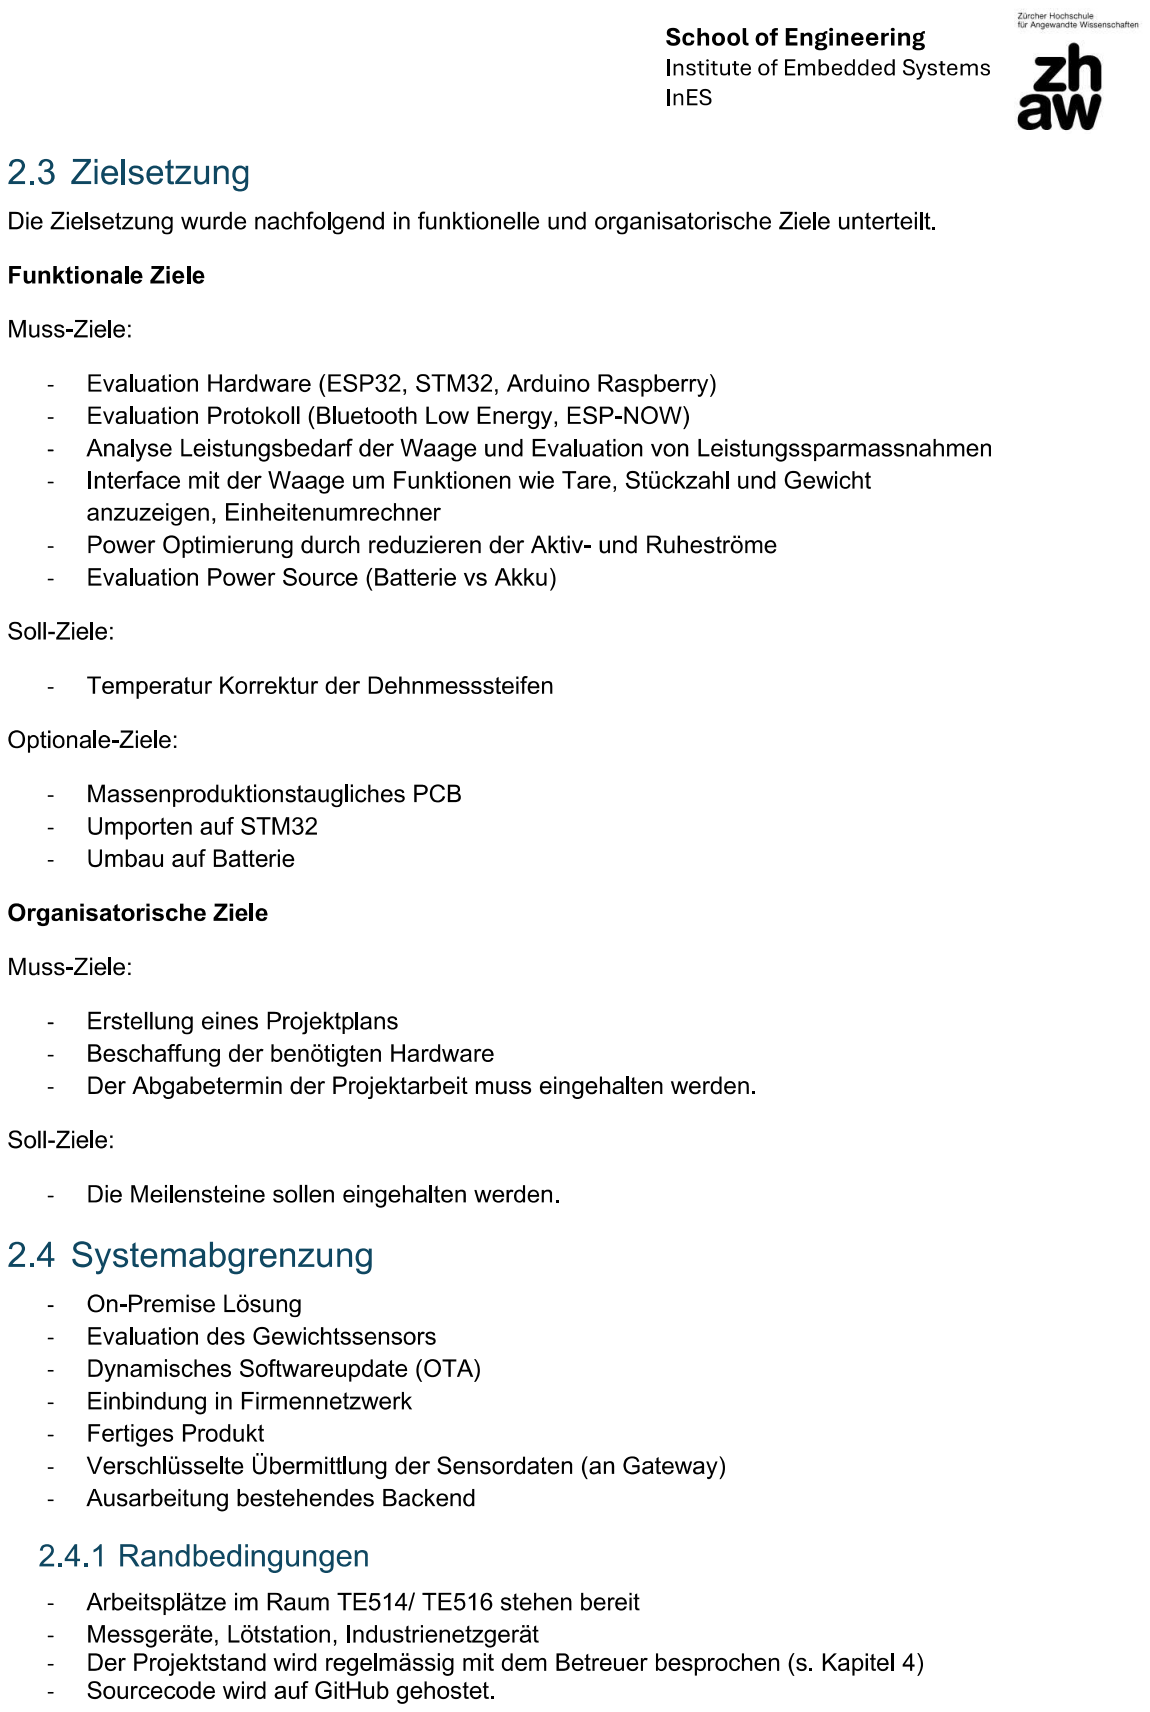
[picture p96: page 5]

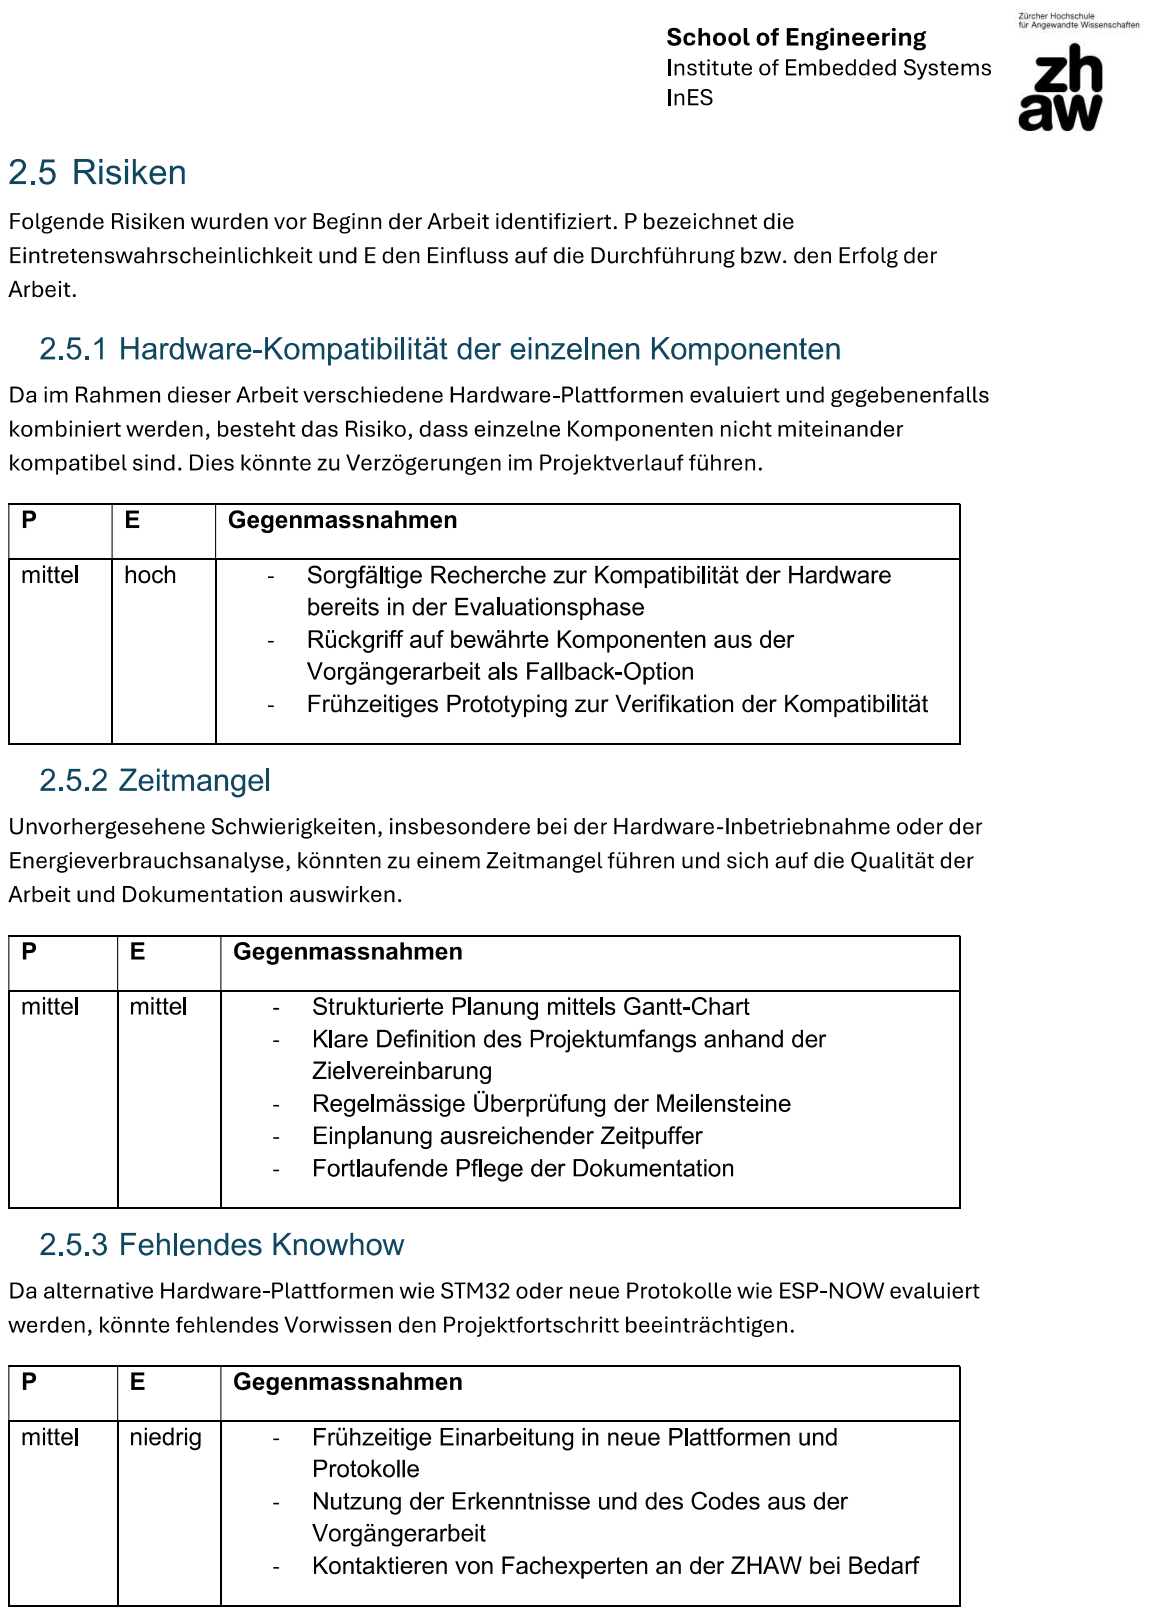
[picture p97: page 6]

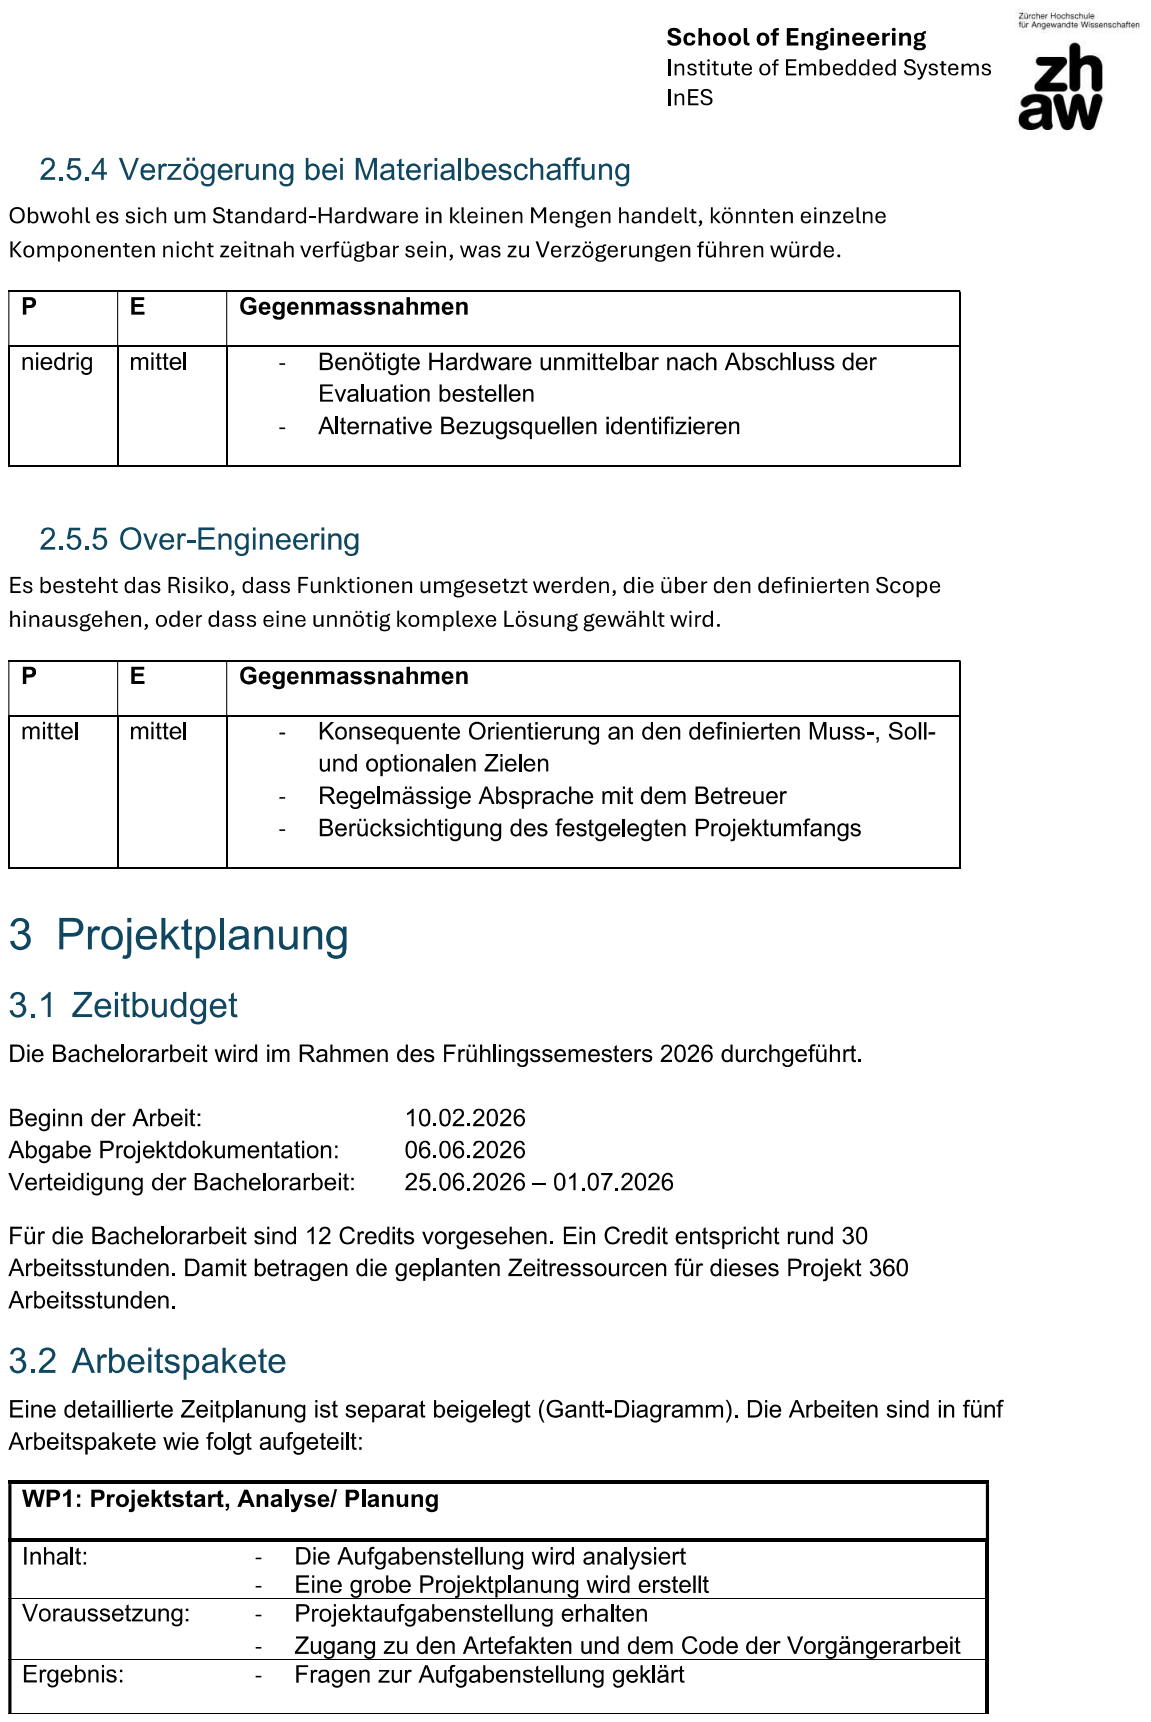
[picture p98: page 7]

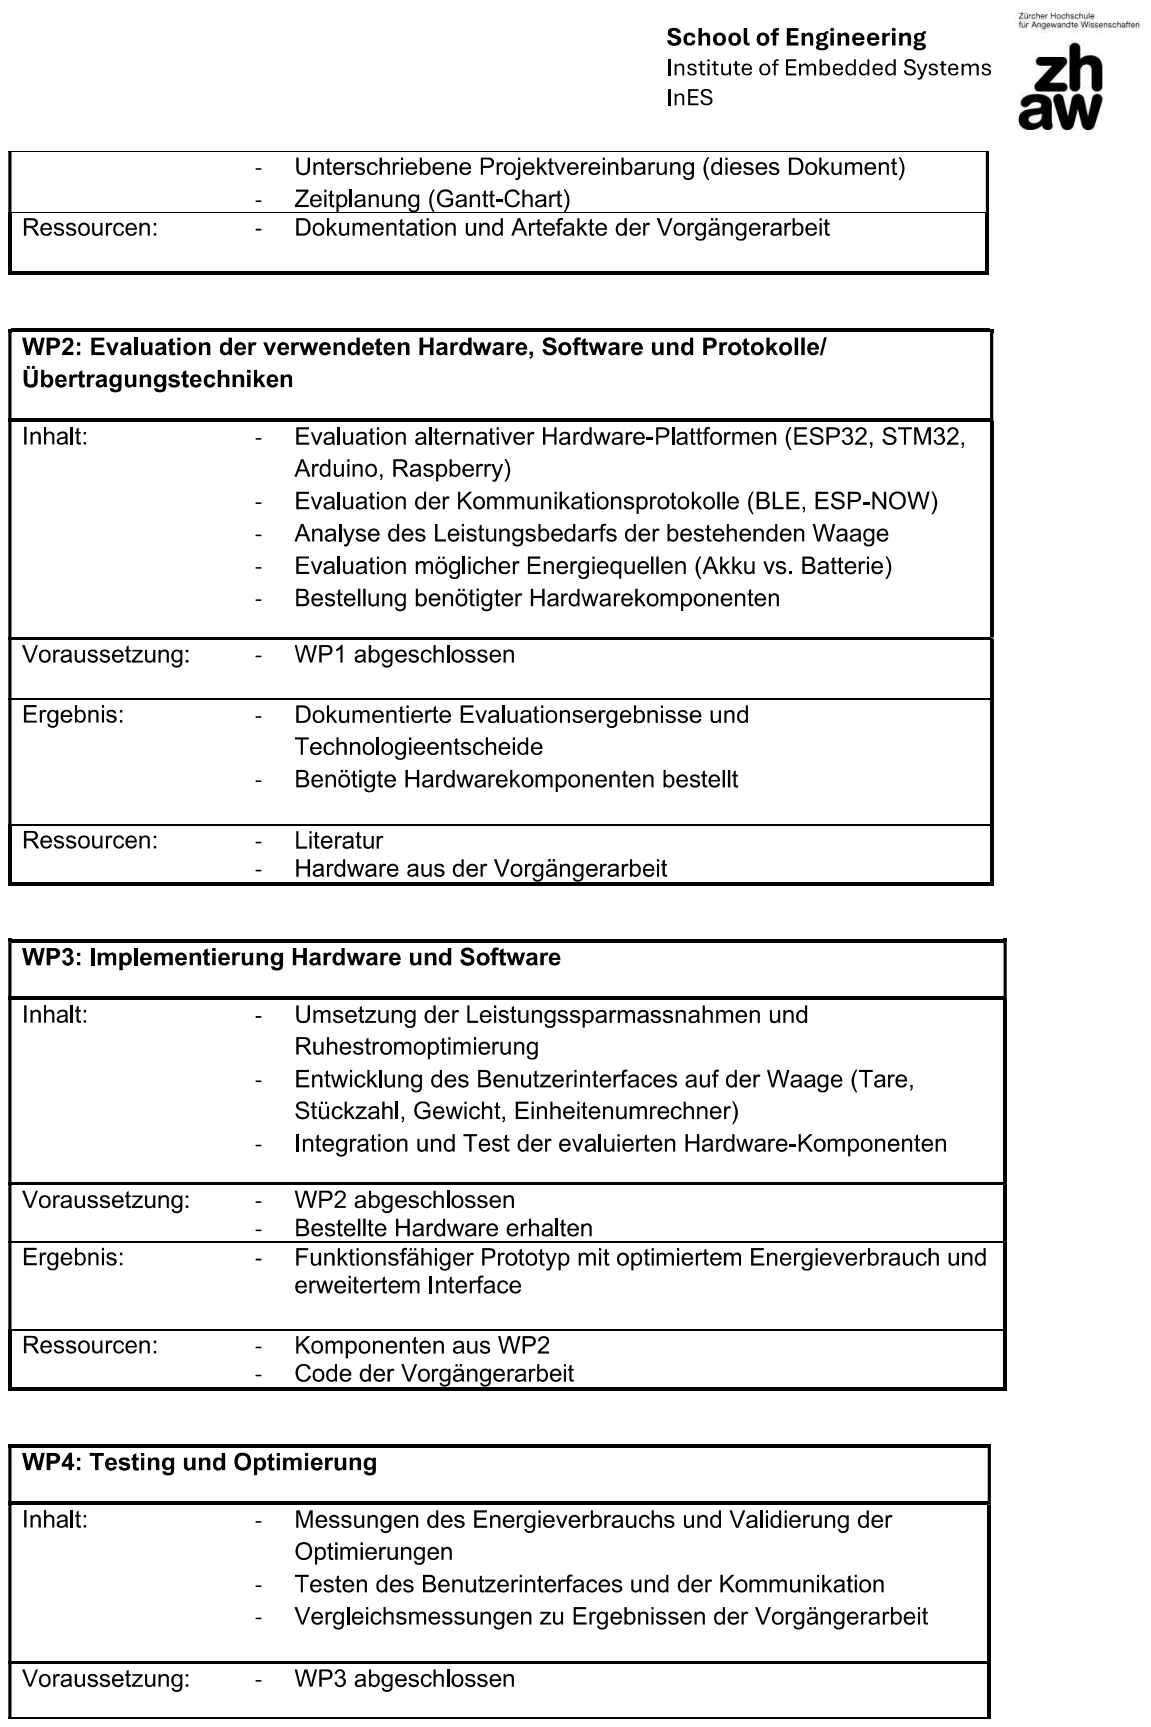
[picture p99: page 8]

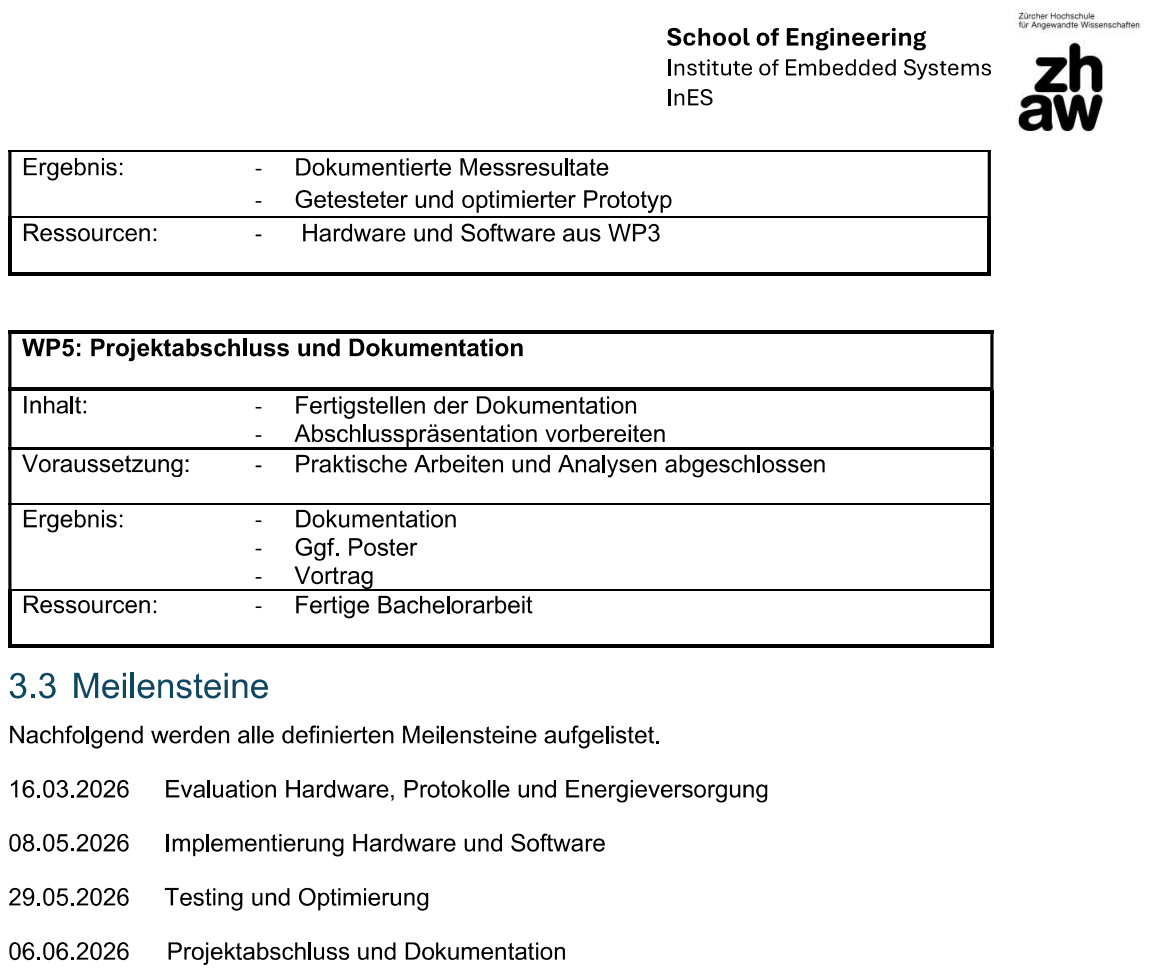
[picture p100: page 9]

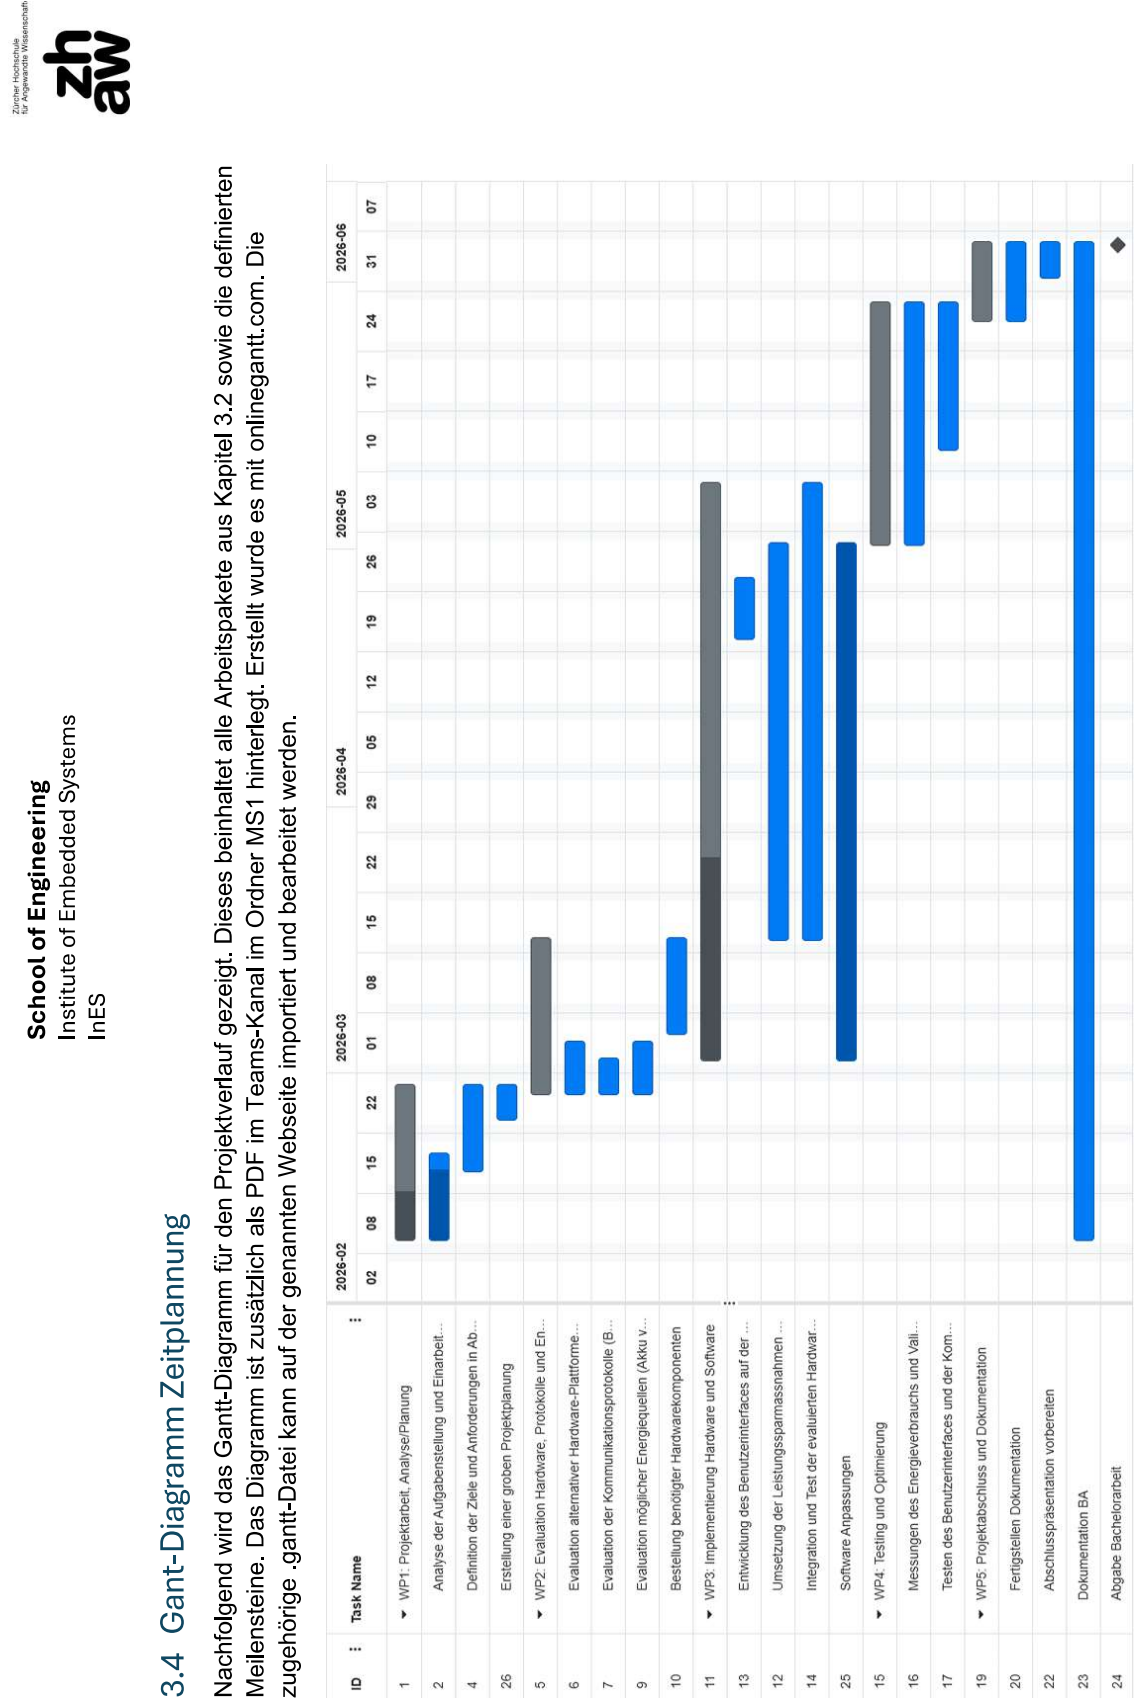
[picture p101: page 10]

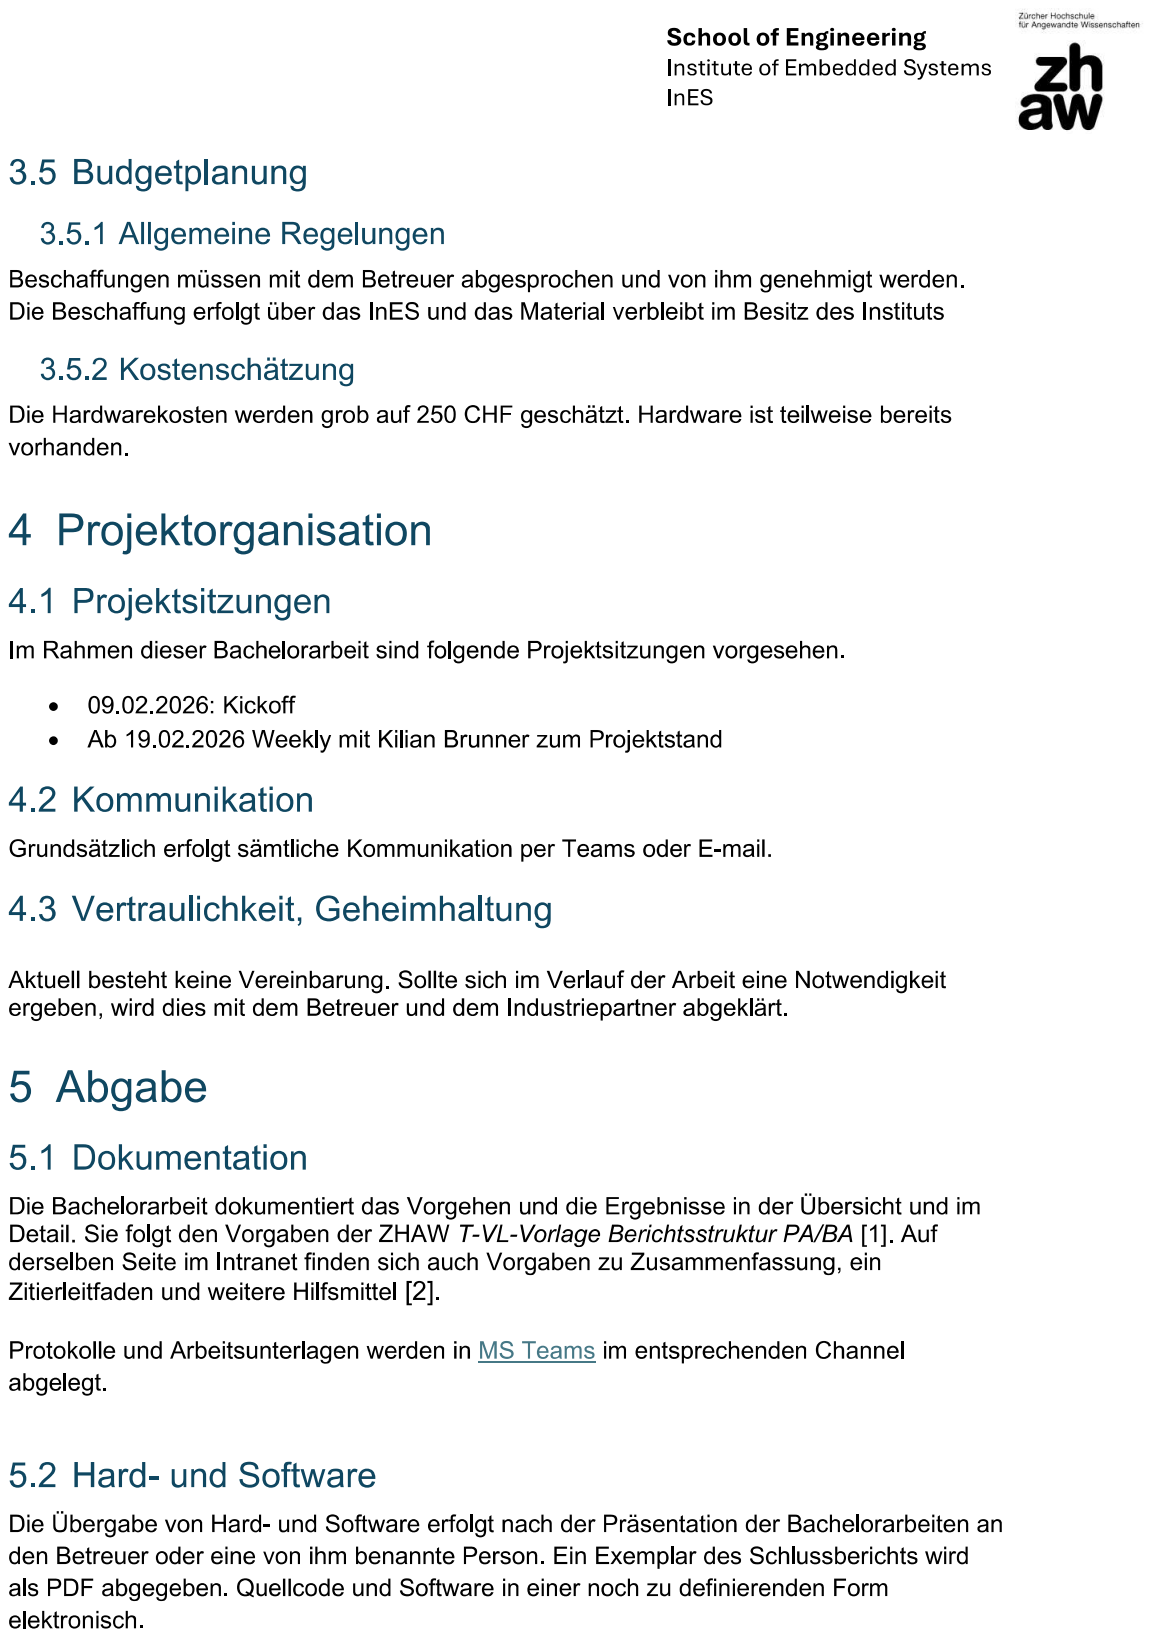
[picture p102: page 11]

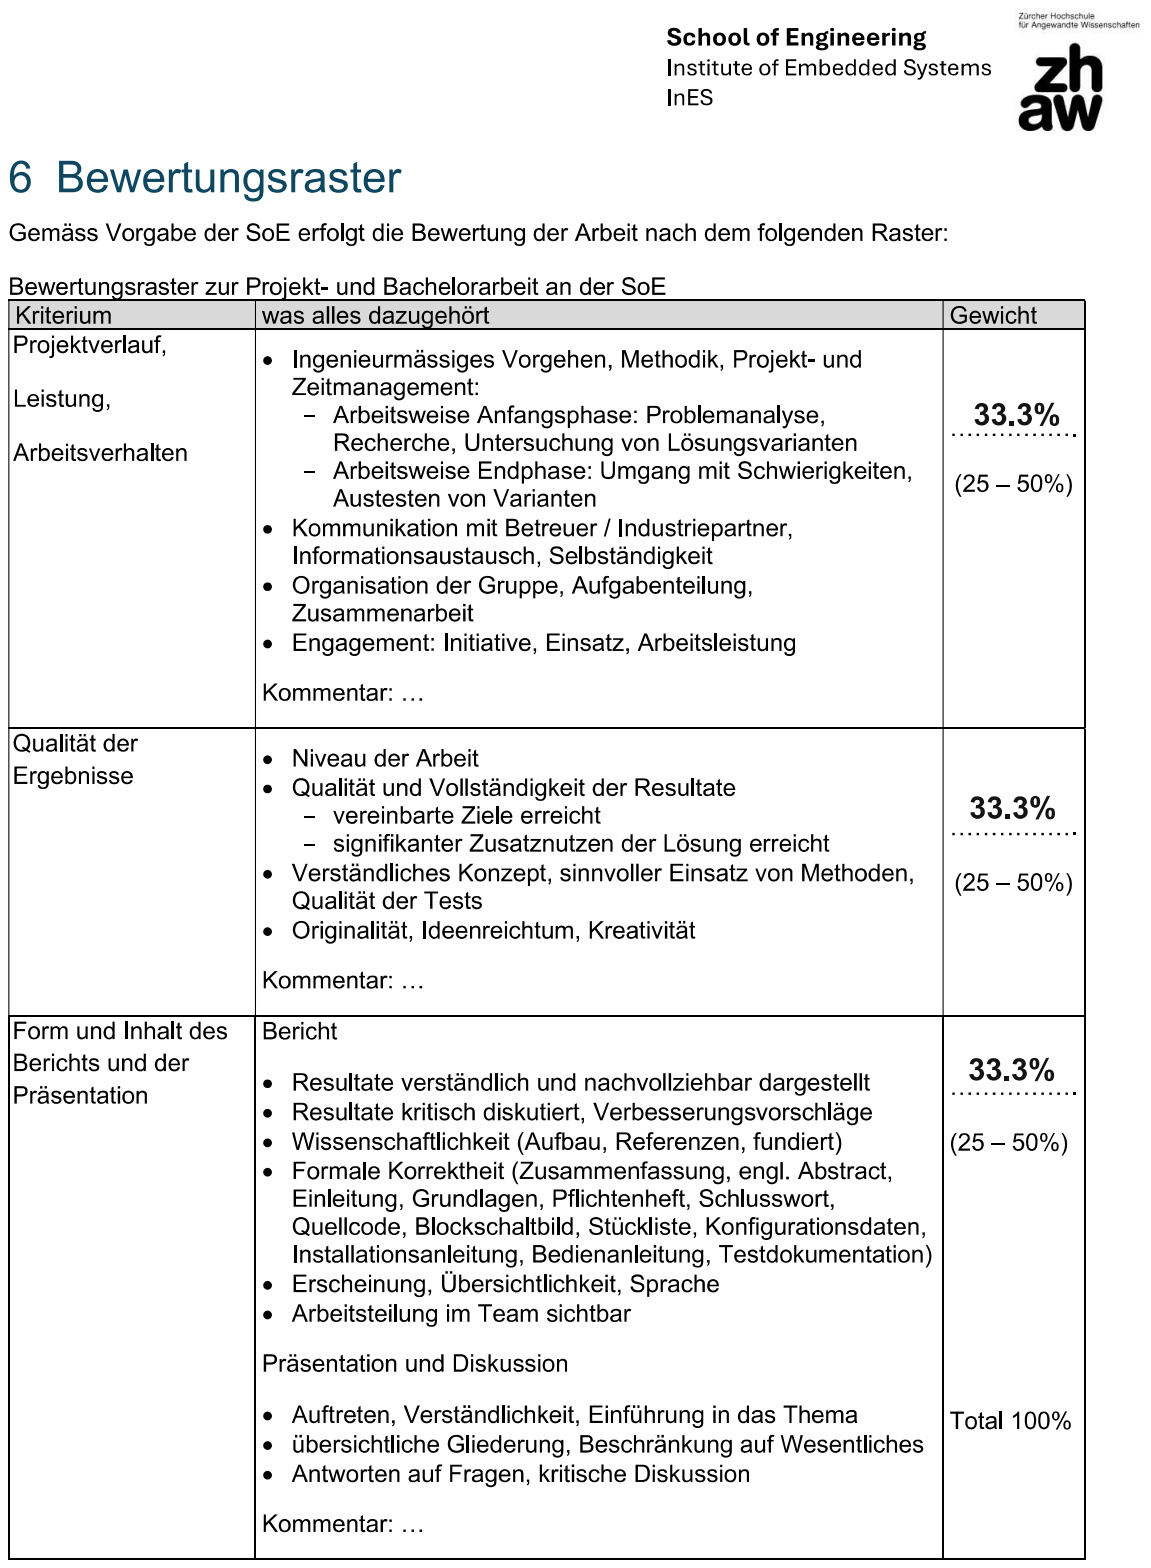
[picture p103: page 12]

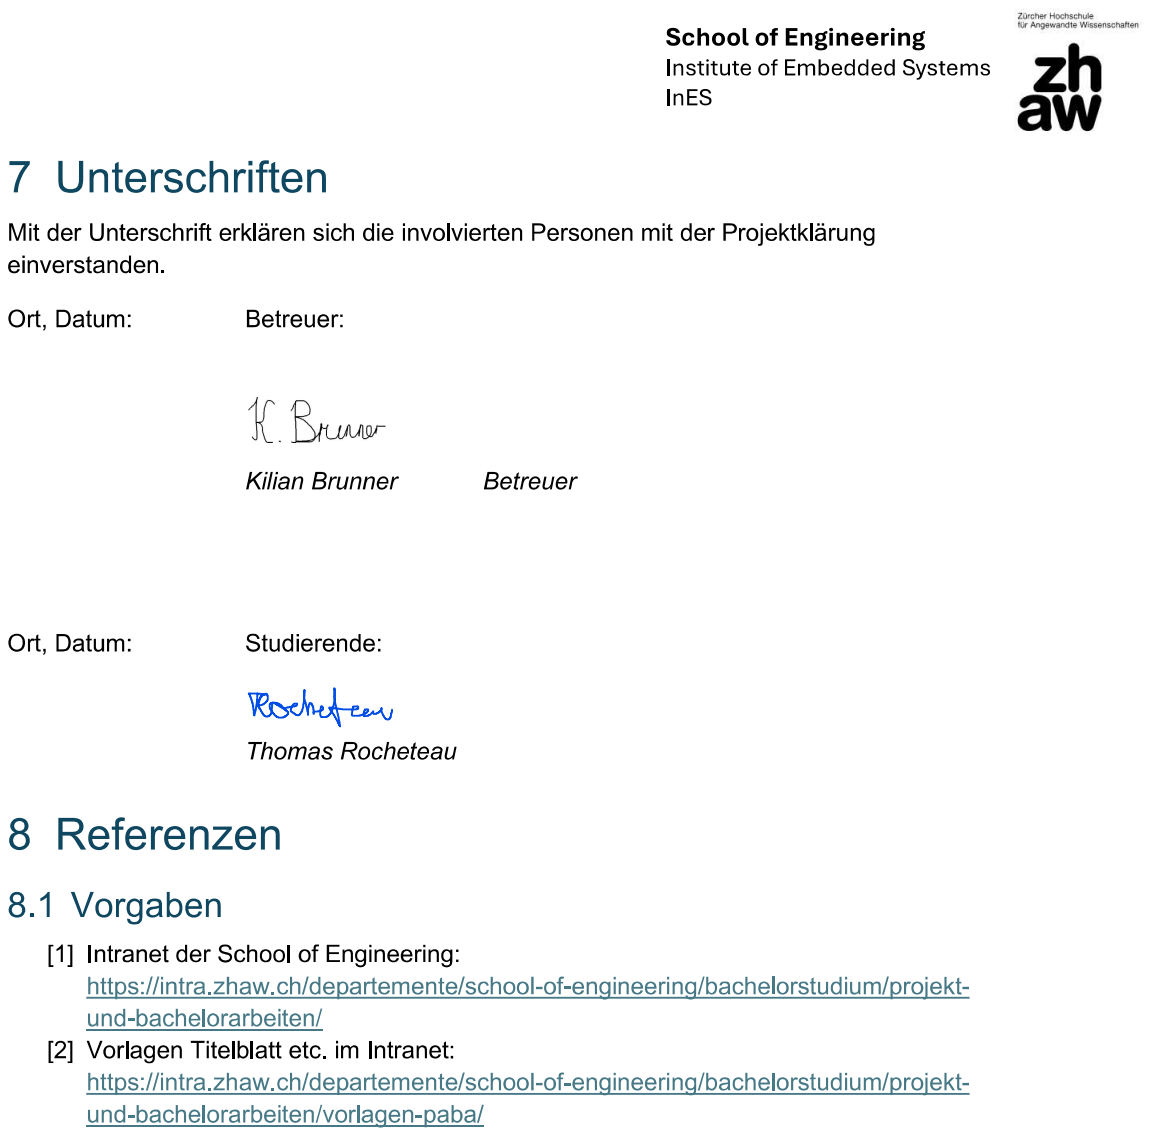
[picture p104: page 13]
