Newtonsohn/BA-Smart-Waage/Schematics/ESP32_Shield/ESP32_Shield/ESP32_Shield.kicad_pcb

## KiCad design Schematics/ESP32_Shield/ESP32_Shield/ESP32_Shield.kicad_pcb (2026-04-12)

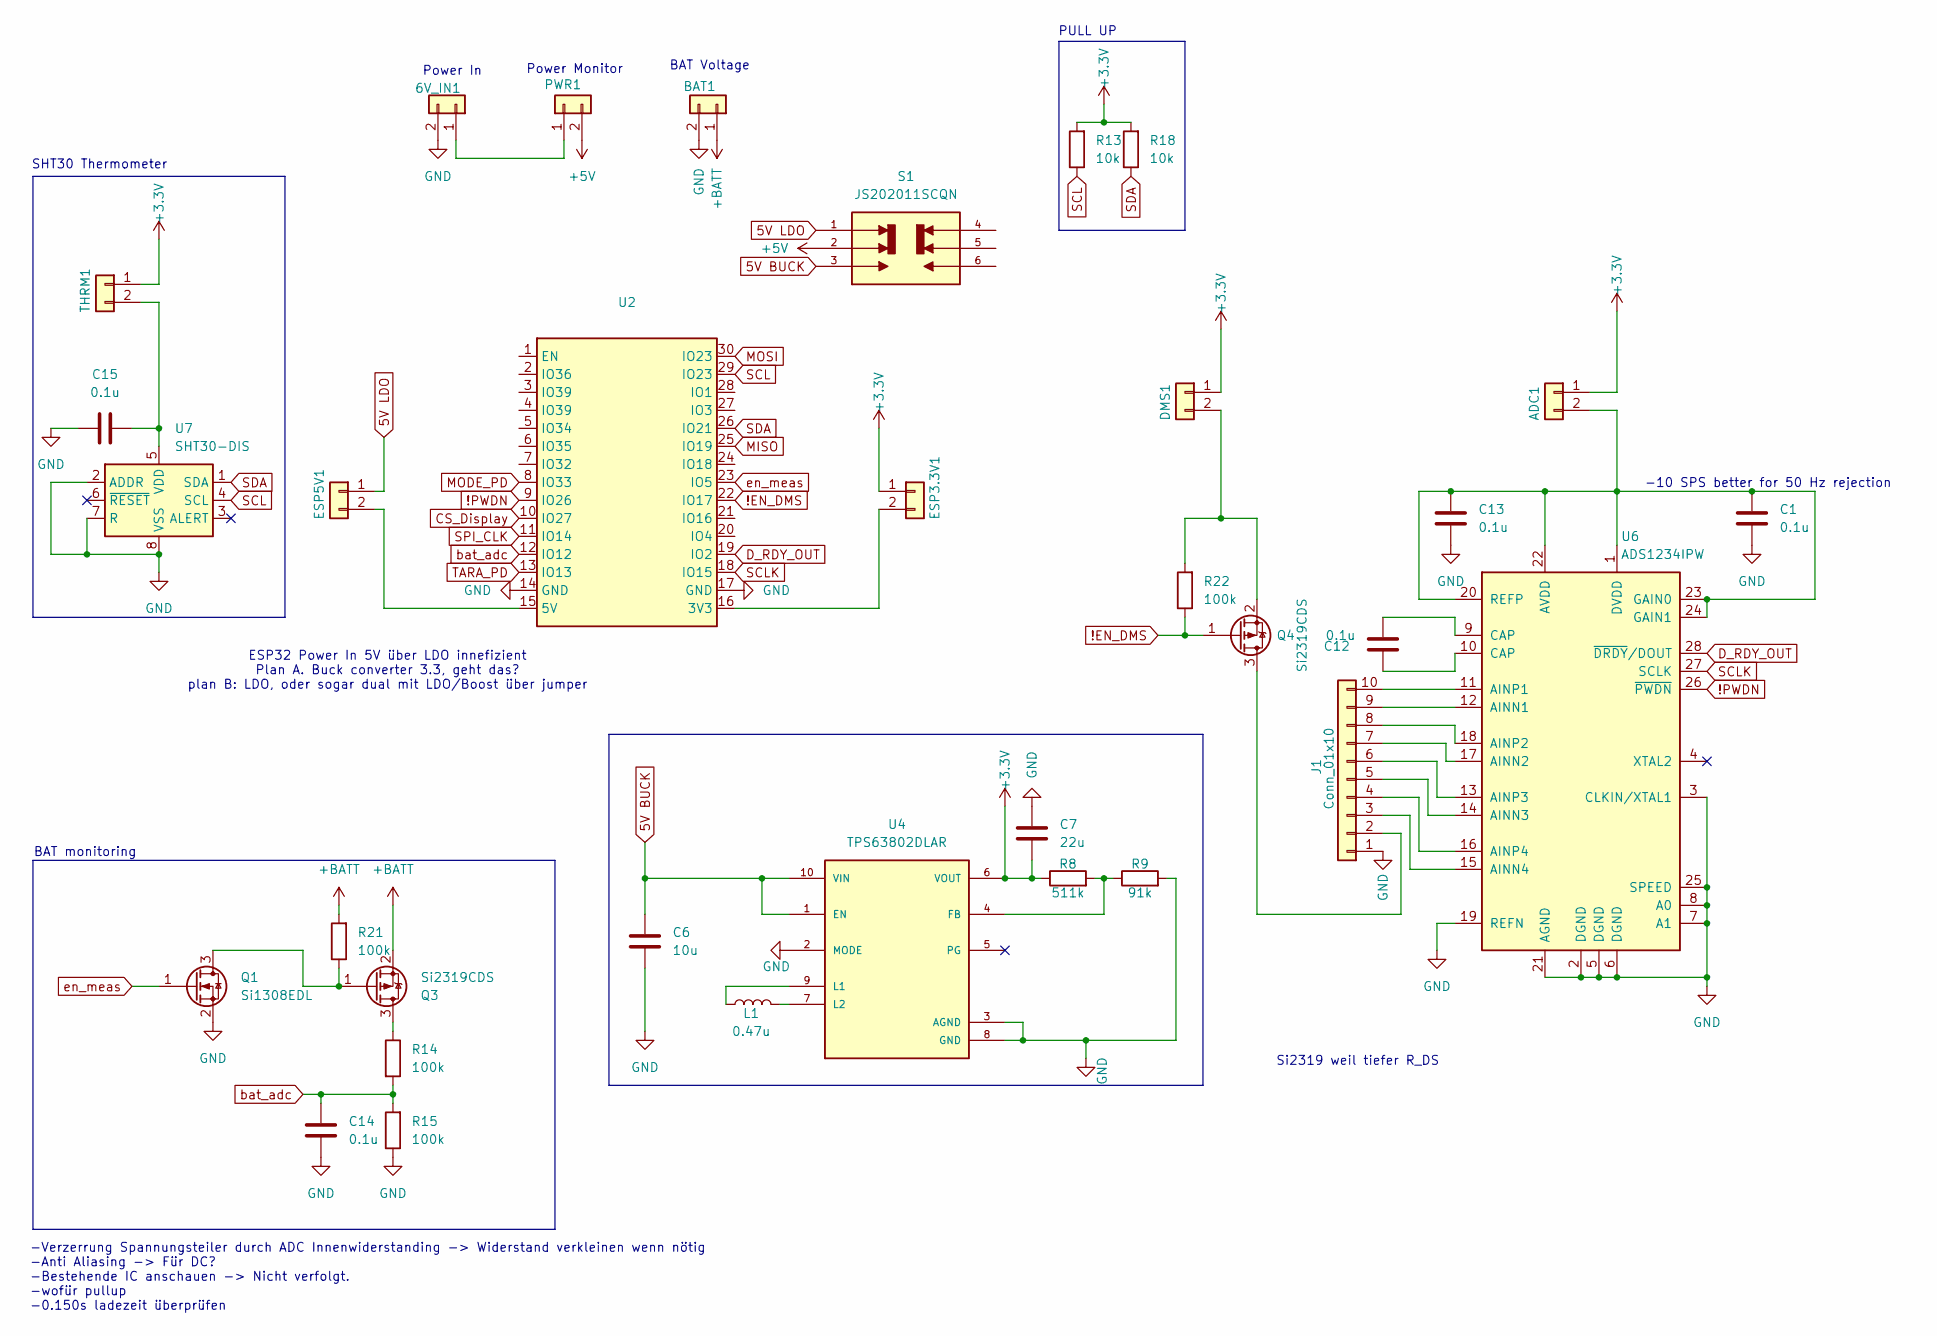
[picture p105: schematic ESP32_Shield.kicad_sch]

Parts:
6V_IN1: Conn_01x02; PinHeader_1x02_P2.54mm_Vertical
ADC1: Conn_01x02; PinHeader_1x02_P2.54mm_Vertical
BAT1: Conn_01x02; PinHeader_1x02_P2.54mm_Vertical
C1, C12, C13, C14, C15: 0.1u; C_0603_1608Metric_Pad1.08x0.95mm_HandSolder
C6: 10u; C_0603_1608Metric_Pad1.08x0.95mm_HandSolder
C7: 22u; C_0603_1608Metric_Pad1.08x0.95mm_HandSolder
DMS1: Conn_01x02; PinHeader_1x02_P2.54mm_Vertical
ESP3.3V1, ESP5V1: Conn_01x02; PinHeader_1x02_P2.54mm_Vertical
J1: Conn_01x10; PinHeader_1x10_P2.54mm_Vertical
L1: 0.47u; L_Coilcraft_XxL4020
PWR1: Conn_01x02; PinHeader_1x02_P2.54mm_Vertical
Q1: Si1308EDL; SOT-23
Q3, Q4: Si2319CDS; SOT-23
R8: 511k; R_0603_1608Metric_Pad0.98x0.95mm_HandSolder
R9: 91k; R_0603_1608Metric_Pad0.98x0.95mm_HandSolder
R13, R18: 10k; R_0603_1608Metric_Pad0.98x0.95mm_HandSolder
R14, R15, R21, R22: 100k; R_0603_1608Metric_Pad0.98x0.95mm_HandSolder
S1: JS202011SCQN; SW_DPDT_CK_JS202011JCQN; PARTREV 26 May 22
THRM1: Conn_01x02; PinHeader_1x02_P2.54mm_Vertical
U2: ESP32-C3-DevKitM-1
U4: TPS63802DLAR; VREG_TPS63802DLAR; PARTREV B
U6: ADS1234IPW; TSSOP-28-1EP_4.4x9.7mm_P0.65mm_EP2.74x4.75mm
U7: SHT30-DIS; Sensirion_DFN-8-1EP_2.5x2.5mm_P0.5mm_EP1.1x1.7mm

Connections:
5V BUCK: C6.1, S1.3, U4.1 (EN), U4.10 (VIN)
5V LDO: ESP5V1.1, S1.1
!EN_DMS: Q4.1 (G), R22.1, U2.22 (IO17)
!PWDN: U2.9 (IO26), U6.26 (~PWDN)
+3.3V: ADC1.1, C7.2, DMS1.1, ESP3.3V1.1, R8.1, R13.2, R18.2, THRM1.1, U4.6 (VOUT)
+5V: PWR1.2, S1.2
+BATT: BAT1.1, Q3.2 (S), R21.2
CS_Display: U2.10 (IO27)
D_RDY_OUT: U2.19 (IO2), U6.28 (~DRDY/DOUT)
GND: 6V_IN1.2, BAT1.2, C1.1, C6.2, C7.1, C13.1, C14.1, C15.2, J1.1, Q1.2 (S), R9.2, R15.1, U2.14 (GND), U2.17 (GND), U4.2 (MODE), U4.3 (AGND), U4.8 (GND), U6.2 (DGND), U6.3 (CLKIN/XTAL1), U6.5 (DGND), U6.6 (DGND), U6.7 (A1), U6.8 (A0), U6.19 (REFN), U6.21 (AGND), U6.25 (SPEED), U7.2 (ADDR), U7.7 (R), U7.8 (VSS), U7.9 (VSS)
MISO: U2.25 (IO19)
MODE_PD: U2.8 (IO33)
MOSI: U2.30 (IO23)
unnamed: 6V_IN1.1, PWR1.1
unnamed: ADC1.2, C1.2, C13.2, U6.1 (DVDD), U6.20 (REFP), U6.22 (AVDD), U6.23 (GAIN0), U6.24 (GAIN1)
unnamed: C12.1, U6.10 (CAP)
unnamed: C12.2, U6.9 (CAP)
unnamed: DMS1.2, Q4.2 (S), R22.2
unnamed: ESP3.3V1.2, U2.16 (3V3)
unnamed: ESP5V1.2, U2.15 (5V)
unnamed: J1.2, Q4.3 (D)
unnamed: J1.3, U6.15 (AINN4)
unnamed: J1.4, U6.16 (AINP4)
unnamed: J1.5, U6.14 (AINN3)
unnamed: J1.6, U6.13 (AINP3)
unnamed: J1.7, U6.17 (AINN2)
unnamed: J1.8, U6.18 (AINP2)
unnamed: J1.9, U6.12 (AINN1)
unnamed: J1.10, U6.11 (AINP1)
unnamed: Q1.3 (D), Q3.1 (G), R21.1
unnamed: Q3.3 (D), R14.1
unnamed: C15.1, THRM1.2, U7.5 (VDD)
unnamed: R8.2, R9.1, U4.4 (FB)
unnamed: L1.1, U4.9 (L1)
unnamed: L1.2, U4.7 (L2)
SCL: R13.1, U2.29 (IO23), U7.4 (SCL)
SCLK: U2.18 (IO15), U6.27 (SCLK)
SDA: R18.1, U2.26 (IO21), U7.1 (SDA)
SPI_CLK: U2.11 (IO14)
TARA_PD: U2.13 (IO13)
bat_adc: C14.2, R14.2, R15.2, U2.12 (IO12)
en_meas: Q1.1 (G), U2.23 (IO5)

Notes on the sheet:
SHT30 Thermometer
PULL UP
ESP32 Power In 5V über LDO innefizient Plan A. Buck converter 3.3, geht das? plan B: LDO, oder sogar dual mit LDO/Boost über jumper
-10 SPS better for 50 Hz rejection
BAT Voltage
Power In
Si2319 weil tiefer R_DS
-Verzerrung Spannungsteiler durch ADC Innenwiderstanding -> Widerstand verkleinen wenn nötig -Anti Aliasing -> Für DC? -Bestehende IC anschauen -> Nicht verfolgt. -wofür pullup -0.150s ladezeit überprüfen
BAT monitoring
Power Monitor

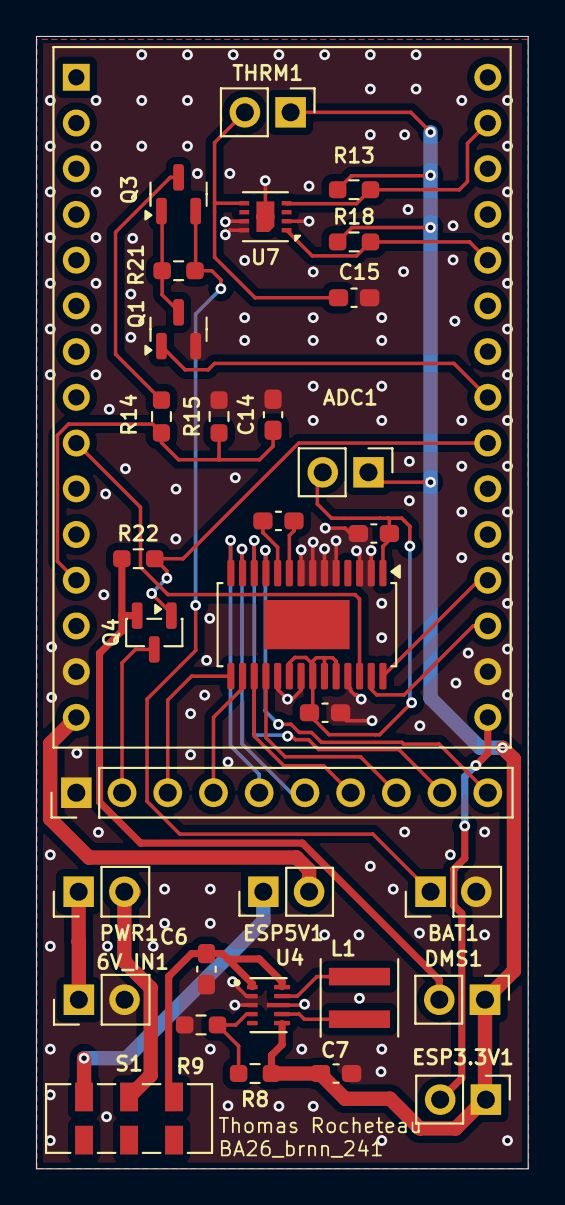
[picture p106: board ESP32_Shield.kicad_pcb from above]

Board: 2 copper layers, 27.3 x 62.9 mm, 33 parts (0 on the bottom side), 36 nets.
