Newtonsohn/BA-Smart-Waage/Schematics/ESP32_Shield/ESP C3/BA_Waage.kicad_pcb

## KiCad design Schematics/ESP32_Shield/ESP C3/BA_Waage.kicad_pcb (2026-03-10)

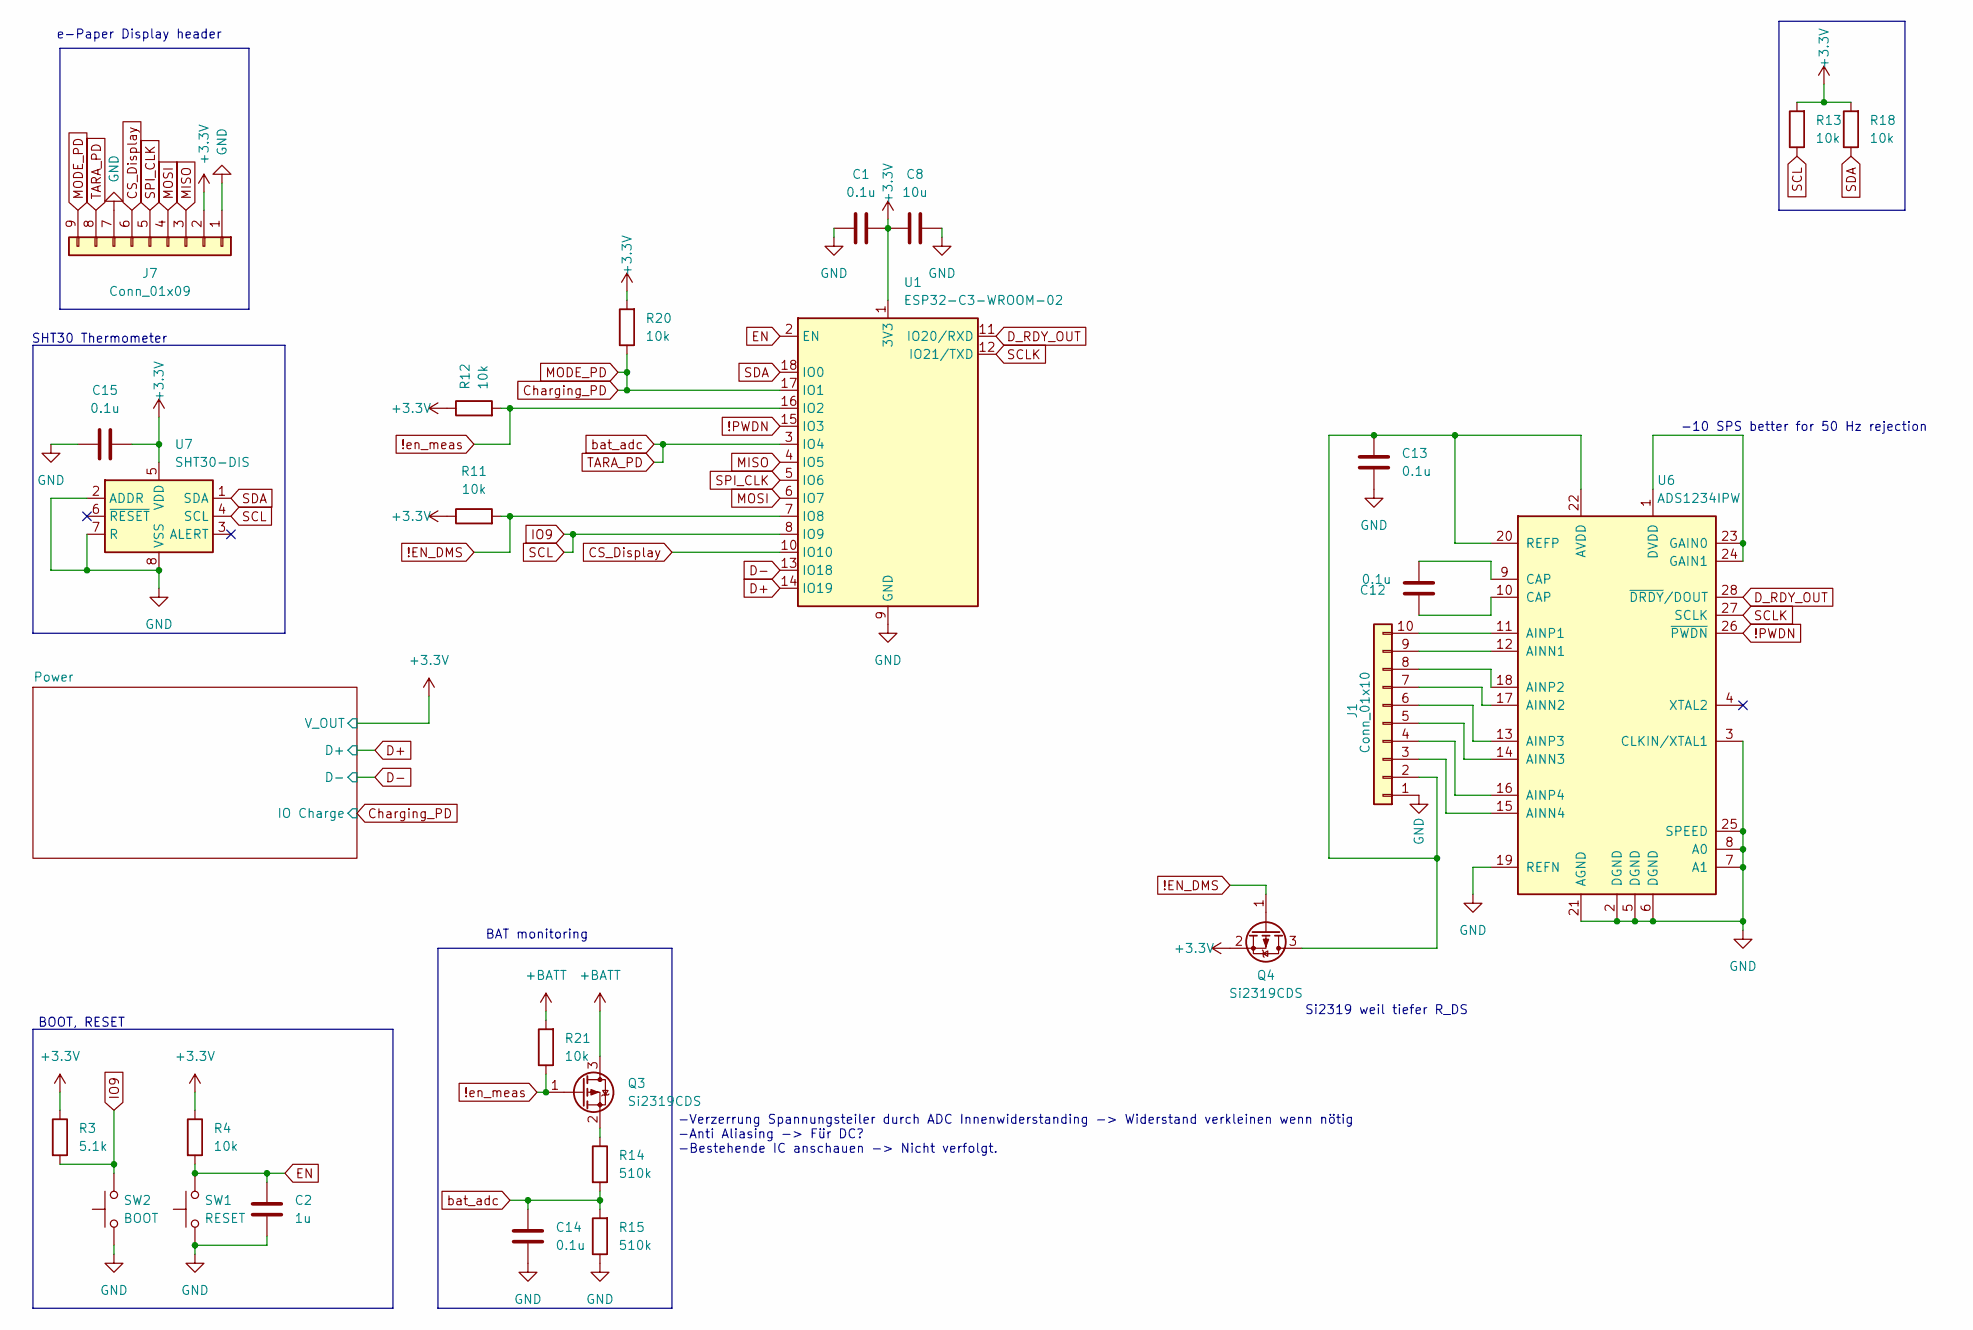
[picture p107: schematic BA_Waage.kicad_sch]

Parts:
C1, C12, C13, C14, C15: 0.1u; C_0603_1608Metric_Pad1.08x0.95mm_HandSolder
C2: 1u; C_0603_1608Metric_Pad1.08x0.95mm_HandSolder
C8: 10u; C_0603_1608Metric_Pad1.08x0.95mm_HandSolder
J1: Conn_01x10; PinHeader_1x10_P2.54mm_Vertical
J7: Conn_01x09; PinHeader_1x09_P2.54mm_Vertical
Q3, Q4: Si2319CDS; SOT-23
R3: 5.1k; R_0603_1608Metric_Pad0.98x0.95mm_HandSolder
R4, R11, R12, R13, R18, R20, R21: 10k; R_0603_1608Metric_Pad0.98x0.95mm_HandSolder
R14, R15: 510k; R_0603_1608Metric_Pad0.98x0.95mm_HandSolder
SW1: RESET; SW_Push_1P1T-SH_NO_CK_KMR2xxG
SW2: BOOT; SW_Push_1P1T-SH_NO_CK_KMR2xxG
U1: ESP32-C3-WROOM-02
U6: ADS1234IPW; TSSOP-28-1EP_4.4x9.7mm_P0.65mm_EP2.74x4.75mm
U7: SHT30-DIS; Sensirion_DFN-8-1EP_2.5x2.5mm_P0.5mm_EP1.1x1.7mm

Connections:
!EN_DMS: Q4.1 (G), R11.2, U1.7 (IO8)
!PWDN: U1.15 (IO3), U6.26 (~PWDN)
!en_meas: Q3.1 (G), R12.2, R21.1, U1.16 (IO2)
+3.3V: C1.2, C8.2, C15.1, J7.2, Q4.2 (S), R3.1, R4.1, R11.1, R12.1, R13.2, R18.2, R20.2, U1.1 (3V3), U7.5 (VDD); also elsewhere on the board
+BATT: Q3.3 (D), R21.2; also elsewhere on the board
CS_Display: J7.6, U1.10 (IO10)
Charging_PD: J7.9, R20.1, U1.17 (IO1); also elsewhere on the board
D+: U1.14 (IO19); also elsewhere on the board
D-: U1.13 (IO18); also elsewhere on the board
D_RDY_OUT: U1.11 (IO20/RXD), U6.28 (~DRDY/DOUT)
EN: C2.1, R4.2, SW1.2, U1.2 (EN)
GND: C1.1, C2.2, C8.1, C13.1, C14.1, C15.2, J1.1, J7.1, J7.7, R15.1, SW1.1, SW2.1, U1.9 (GND), U1.19 (GND), U6.2 (DGND), U6.3 (CLKIN/XTAL1), U6.5 (DGND), U6.6 (DGND), U6.7 (A1), U6.8 (A0), U6.19 (REFN), U6.21 (AGND), U6.25 (SPEED), U7.2 (ADDR), U7.7 (R), U7.8 (VSS), U7.9 (VSS); also elsewhere on the board
IO9: R3.2, R13.1, SW2.2, U1.8 (IO9), U7.4 (SCL)
MISO: J7.3, U1.4 (IO5)
MOSI: J7.4, U1.6 (IO7)
unnamed: C12.1, U6.10 (CAP)
unnamed: C12.2, U6.9 (CAP)
unnamed: C13.2, J1.2, Q4.3 (D), U6.20 (REFP), U6.22 (AVDD)
unnamed: J1.3, U6.15 (AINN4)
unnamed: J1.4, U6.16 (AINP4)
unnamed: J1.5, U6.14 (AINN3)
unnamed: J1.6, U6.13 (AINP3)
unnamed: J1.7, U6.17 (AINN2)
unnamed: J1.8, U6.18 (AINP2)
unnamed: J1.9, U6.12 (AINN1)
unnamed: J1.10, U6.11 (AINP1)
unnamed: Q3.2 (S), R14.1
unnamed: U6.1 (DVDD), U6.23 (GAIN0), U6.24 (GAIN1)
SCLK: U1.12 (IO21/TXD), U6.27 (SCLK)
SDA: R18.1, U1.18 (IO0), U7.1 (SDA)
SPI_CLK: J7.5, U1.5 (IO6)
TARA_PD: C14.2, J7.8, R14.2, R15.2, U1.3 (IO4)

Notes on the sheet:
Si2319 weil tiefer R_DS
-Verzerrung Spannungsteiler durch ADC Innenwiderstanding -> Widerstand verkleinen wenn nötig -Anti Aliasing -> Für DC? -Bestehende IC anschauen -> Nicht verfolgt.
SHT30 Thermometer
BAT monitoring
BOOT, RESET
e-Paper Display header
-10 SPS better for 50 Hz rejection

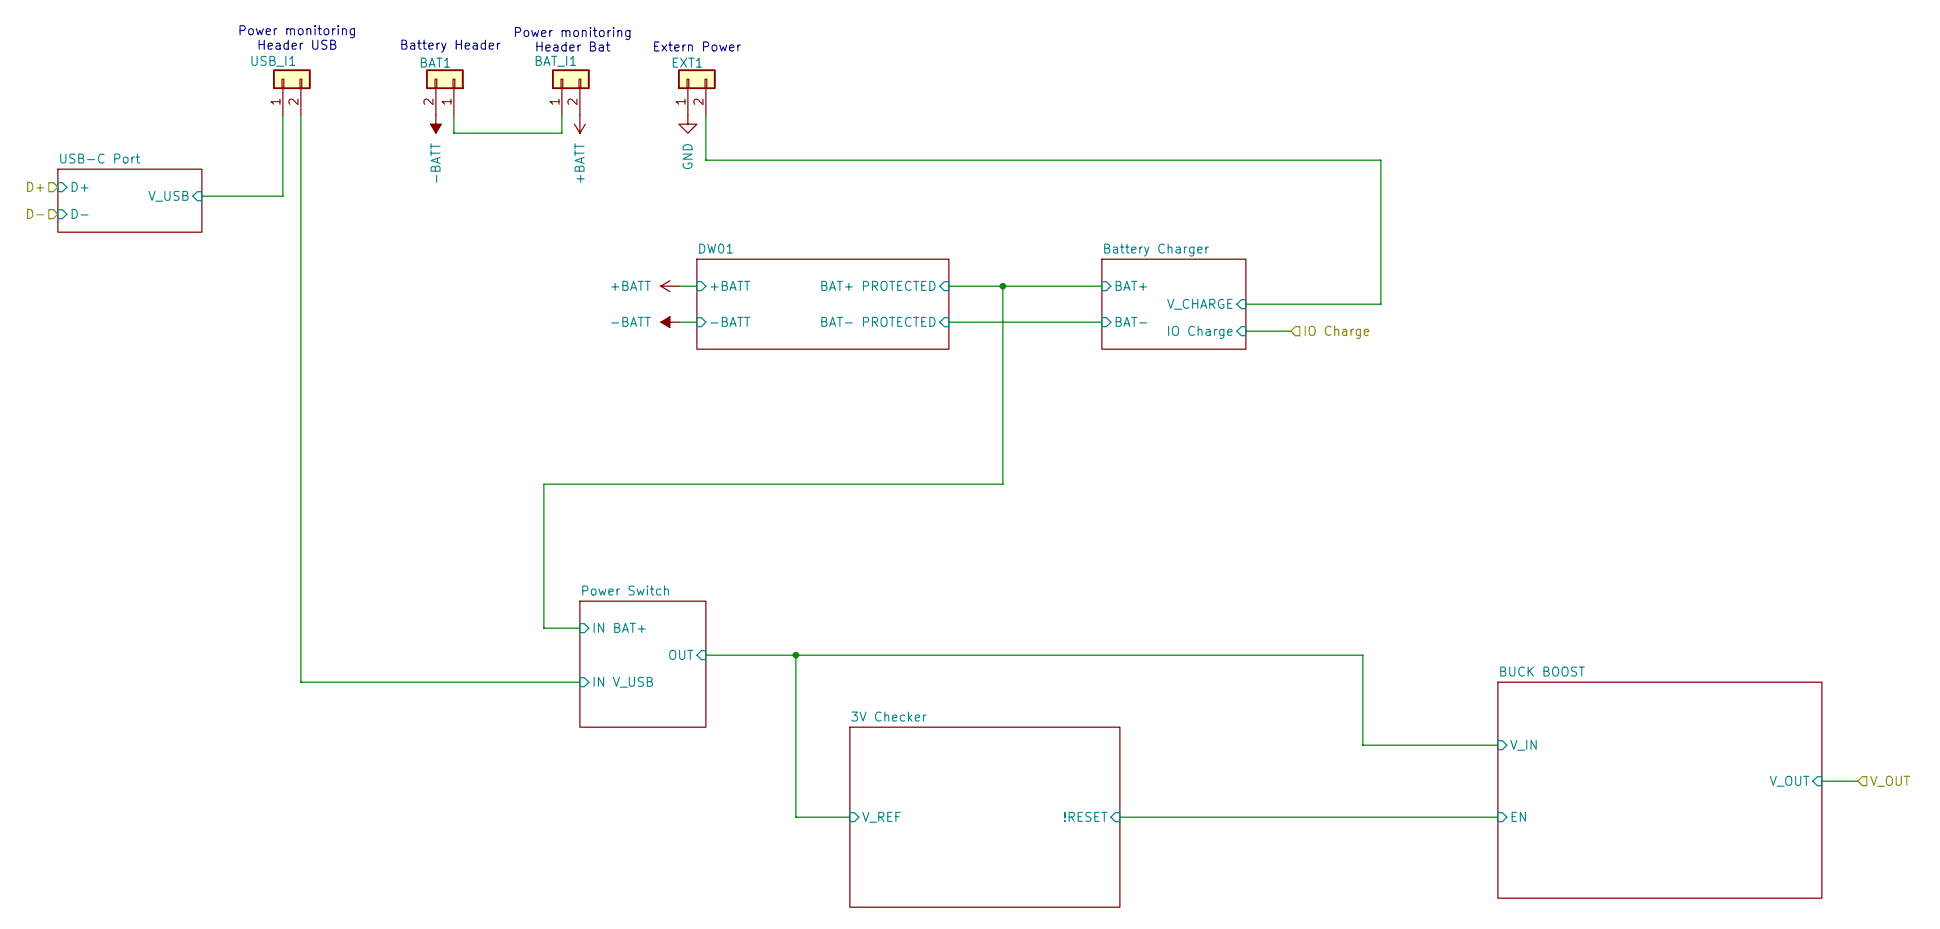
[picture p108: schematic power.kicad_sch]

Parts:
BAT1: Conn_01x02; PinHeader_1x02_P2.54mm_Vertical
BAT_I1: Conn_01x02; PinHeader_1x02_P2.54mm_Vertical
EXT1: Conn_01x02; PinHeader_1x02_P2.54mm_Vertical
USB_I1: Conn_01x02; PinHeader_1x02_P2.54mm_Vertical

Connections:
+BATT: BAT_I1.2; also elsewhere on the board
-BATT: BAT1.2; also elsewhere on the board
/Power/Battery Charger/V_CHARGE: EXT1.2; also elsewhere on the board
/Power/Power Switch/IN V_USB: USB_I1.2; also elsewhere on the board
GND: EXT1.1; also elsewhere on the board
unnamed: BAT1.1, BAT_I1.1
V_USB: USB_I1.1; also elsewhere on the board

Notes on the sheet:
Power monitoring Header USB
Power monitoring Header Bat
Extern Power
Battery Header

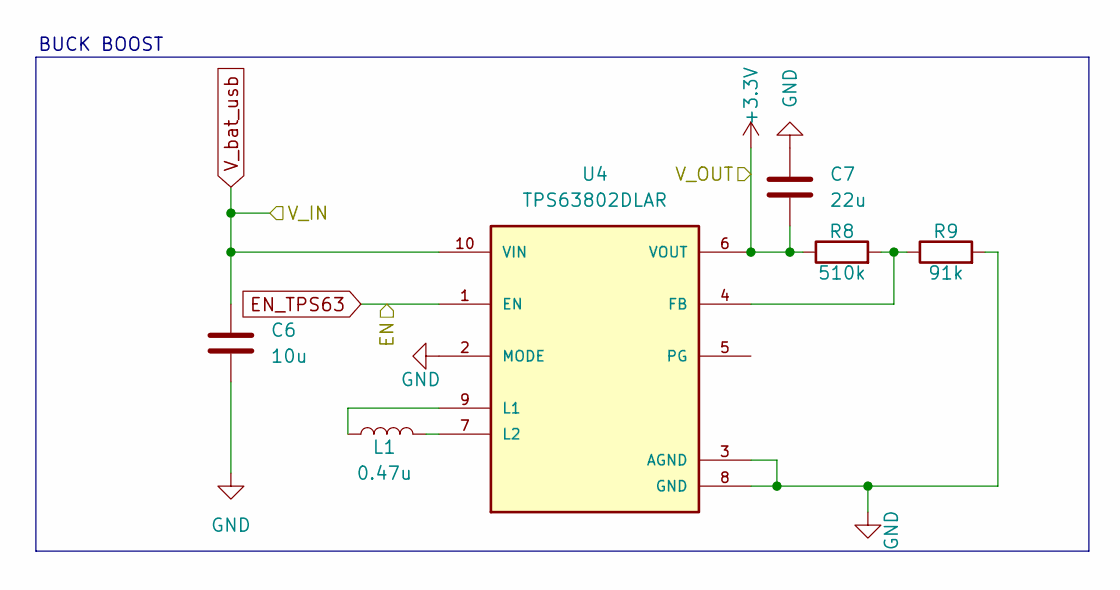
[picture p109: schematic Power Supply.kicad_sch]

Parts:
C6: 10u; C_0603_1608Metric_Pad1.08x0.95mm_HandSolder
C7: 22u; C_0603_1608Metric_Pad1.08x0.95mm_HandSolder
L1: 0.47u; L_Coilcraft_XxL4020
R8: 510k; R_0603_1608Metric_Pad0.98x0.95mm_HandSolder
R9: 91k; R_0603_1608Metric_Pad0.98x0.95mm_HandSolder
U4: TPS63802DLAR; VREG_TPS63802DLAR; PARTREV B

Connections:
+3.3V: C7.2, R8.1, U4.6 (VOUT); also elsewhere on the board
EN_TPS63: U4.1 (EN); also elsewhere on the board
GND: C6.2, C7.1, R9.2, U4.2 (MODE), U4.3 (AGND), U4.8 (GND); also elsewhere on the board
unnamed: R8.2, R9.1, U4.4 (FB)
unnamed: L1.1, U4.9 (L1)
unnamed: L1.2, U4.7 (L2)
V_bat_usb: C6.1, U4.10 (VIN); also elsewhere on the board

Notes on the sheet:
BUCK BOOST

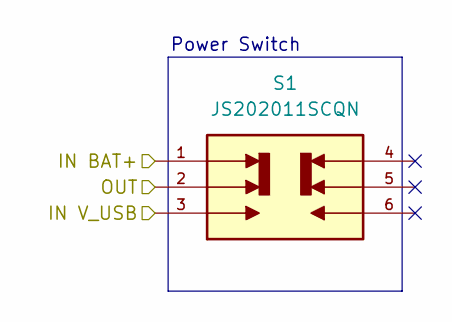
[picture p110: schematic Power Switch_sch.kicad_sch]

Parts:
S1: JS202011SCQN; SW_DPDT_CK_JS202011JCQN; PARTREV 26 May 22

Connections:
/Power/Power Switch/IN V_USB: S1.3; also elsewhere on the board
BAT+WD01: S1.1; also elsewhere on the board
V_bat_usb: S1.2; also elsewhere on the board

Notes on the sheet:
Power Switch

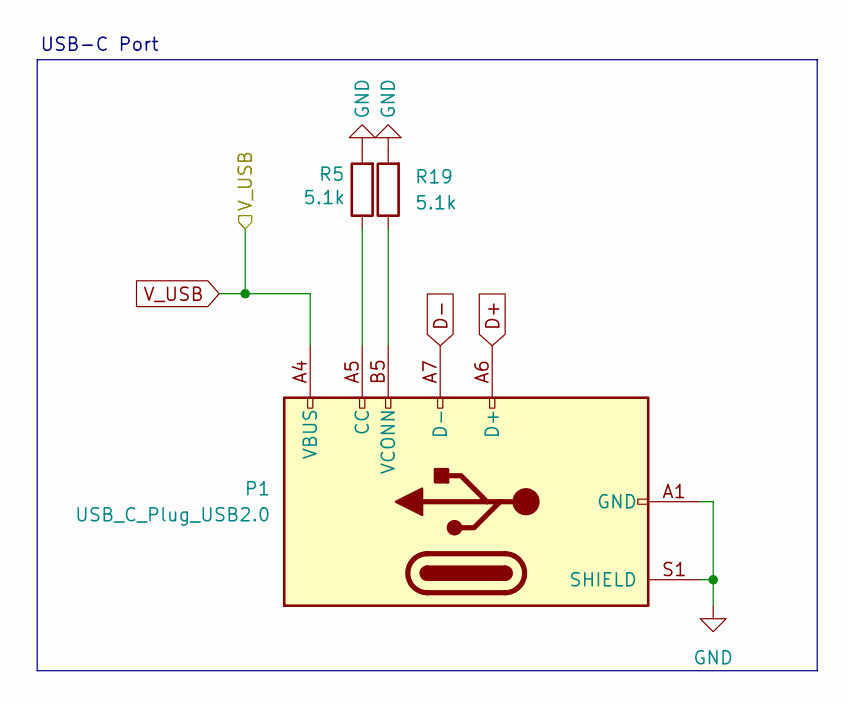
[picture p111: schematic USB-C Port.kicad_sch]

Parts:
P1: USB_C_Plug_USB2.0; USB_C_Receptacle_GCT_USB4105-xx-A_16P_TopMnt_Horizontal
R5, R19: 5.1k; R_0603_1608Metric_Pad0.98x0.95mm_HandSolder

Connections:
D+: P1.A6 (D+); also elsewhere on the board
D-: P1.A7 (D-); also elsewhere on the board
GND: P1.A1 (GND), P1.A12 (GND), P1.B1 (GND), P1.B12 (GND), P1.S1 (SHIELD), R5.2, R19.2; also elsewhere on the board
unnamed: P1.A5 (CC), R5.1
unnamed: P1.B5 (VCONN), R19.1
V_USB: P1.A4 (VBUS), P1.A9 (VBUS), P1.B4 (VBUS), P1.B9 (VBUS); also elsewhere on the board

Notes on the sheet:
USB-C Port

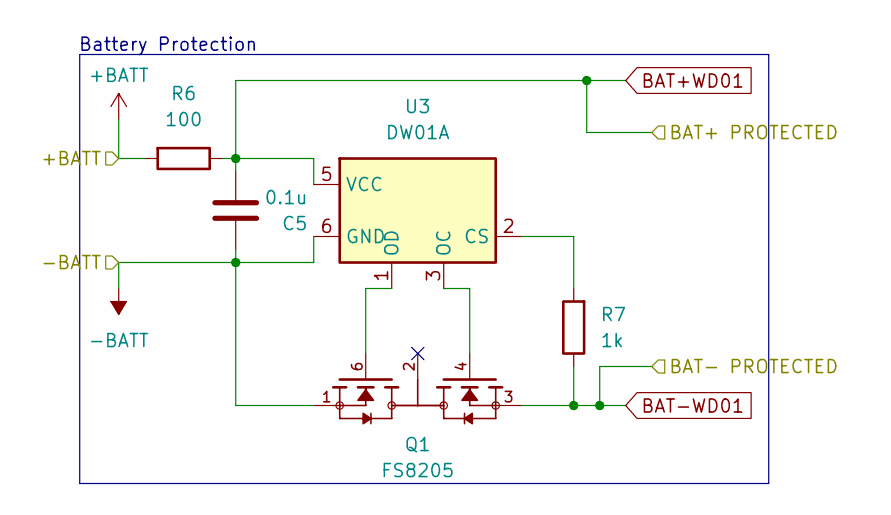
[picture p112: schematic untitled.kicad_sch]

Parts:
C5: 0.1u; C_0603_1608Metric_Pad1.08x0.95mm_HandSolder
Q1: FS8205; SOT95P280X145-6N; PARTREV 1.9
R6: 100; R_0603_1608Metric_Pad0.98x0.95mm_HandSolder
R7: 1k; R_0603_1608Metric_Pad0.98x0.95mm_HandSolder
U3: DW01A; SOT-23-6

Connections:
+BATT: R6.2; also elsewhere on the board
-BATT: C5.1, Q1.1, U3.6 (GND); also elsewhere on the board
BAT+WD01: C5.2, R6.1, U3.5 (VCC); also elsewhere on the board
GND: Q1.3, R7.1; also elsewhere on the board
unnamed: R7.2, U3.2 (CS)
unnamed: Q1.4, U3.3 (OC)
unnamed: Q1.6, U3.1 (OD)

Notes on the sheet:
Battery Protection

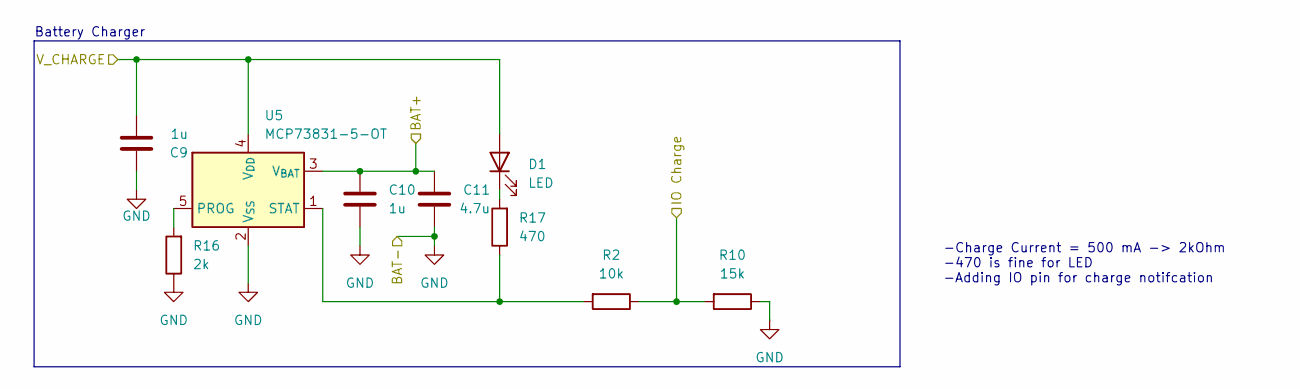
[picture p113: schematic Battery Charger.kicad_sch]

Parts:
C9, C10: 1u; C_0603_1608Metric_Pad1.08x0.95mm_HandSolder
C11: 4.7u; C_0603_1608Metric_Pad1.08x0.95mm_HandSolder
D1: LED; LED_0805_2012Metric_Pad1.15x1.40mm_HandSolder
R2: 10k; R_0603_1608Metric_Pad0.98x0.95mm_HandSolder
R10: 15k; R_0603_1608Metric_Pad0.98x0.95mm_HandSolder
R16: 2k; R_0603_1608Metric_Pad0.98x0.95mm_HandSolder
R17: 470; R_0603_1608Metric_Pad0.98x0.95mm_HandSolder
U5: MCP73831-5-OT; SOT-23-5

Connections:
/Power/Battery Charger/V_CHARGE: C9.2, D1.2 (A), U5.4 (V_{DD}); also elsewhere on the board
BAT+WD01: C10.1, C11.1, U5.3 (V_{BAT}); also elsewhere on the board
Charging_PD: R2.1, R10.2; also elsewhere on the board
GND: C9.1, C10.2, C11.2, R10.1, R16.1, U5.2 (V_{SS}); also elsewhere on the board
unnamed: D1.1 (K), R17.2
unnamed: R16.2, U5.5 (PROG)
unnamed: R2.2, R17.1, U5.1 (STAT)

Notes on the sheet:
Battery Charger
-Charge Current = 500 mA -> 2kOhm -470 is fine for LED -Adding IO pin for charge notifcation

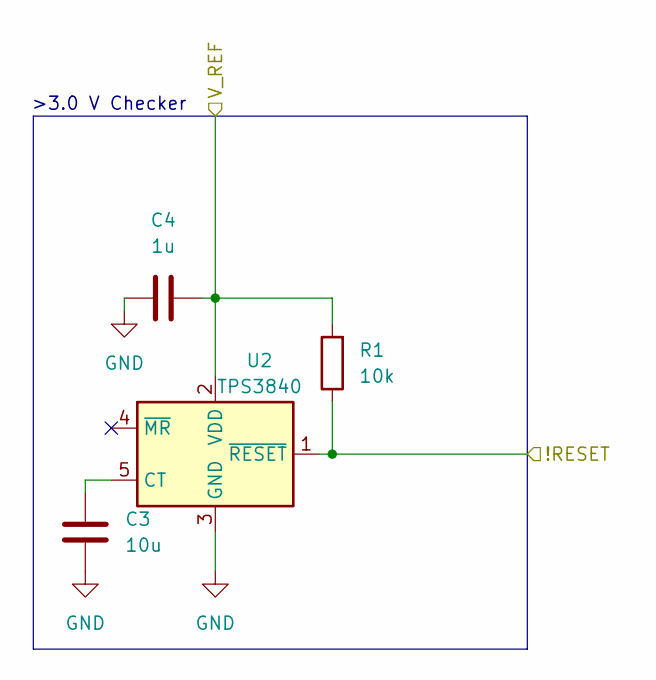
[picture p114: schematic 3V Checker.kicad_sch]

Parts:
C3: 10u; C_0603_1608Metric_Pad1.08x0.95mm_HandSolder
C4: 1u; C_0603_1608Metric_Pad1.08x0.95mm_HandSolder
R1: 10k; R_0603_1608Metric_Pad0.98x0.95mm_HandSolder
U2: TPS3840; SOT-23-5_HandSoldering

Connections:
EN_TPS63: R1.1, U2.1 (~RESET); also elsewhere on the board
GND: C3.1, C4.1, U2.3 (GND); also elsewhere on the board
unnamed: C3.2, U2.5 (CT)
V_bat_usb: C4.2, R1.2, U2.2 (VDD); also elsewhere on the board

Notes on the sheet:
>3.0 V Checker

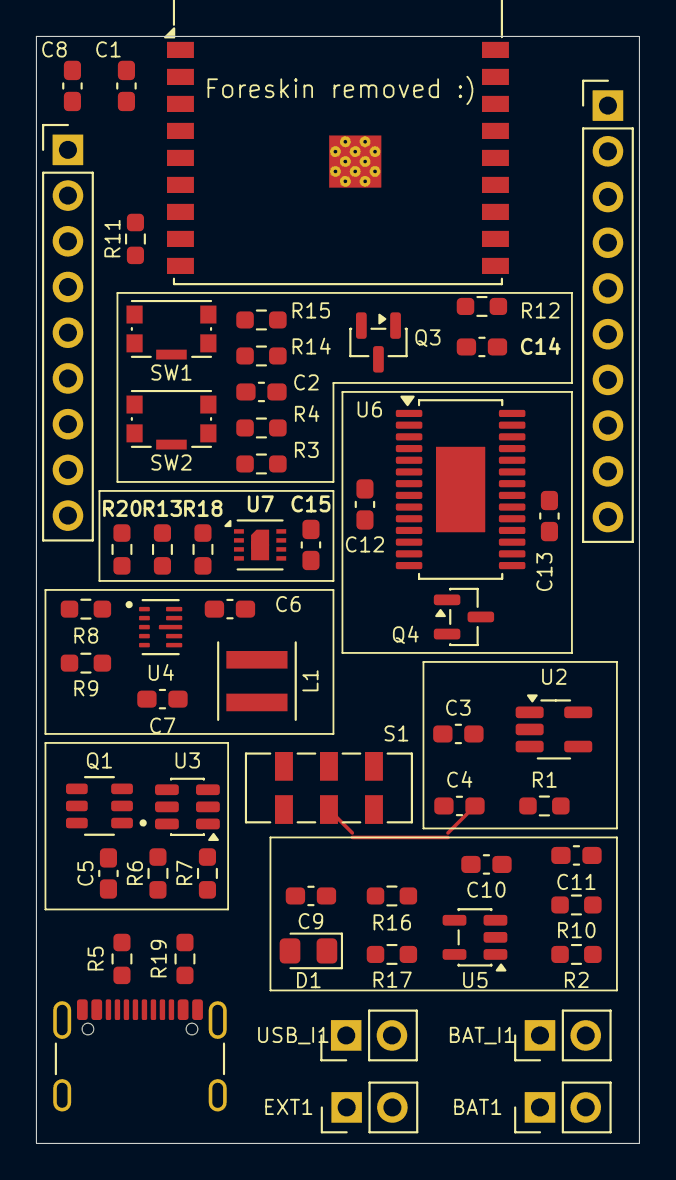
[picture p115: board BA_Waage.kicad_pcb from above]

Board: 2 copper layers, 33.5 x 61.5 mm, 57 parts (0 on the bottom side), 52 nets.
