Newtonsohn/BA-Smart-Waage/(commit log)

2026-03-02 upload hardware
    [3V Checker.kicad_sch, BA_Waage.kicad_pcb, BA_Waage.kicad_sch, Battery Charger.kicad_sch, ESP32_Shield.kicad_pcb, ESP32_Shield.kicad_sch, Power Supply.kicad_sch, Power Switch_sch.kicad_sch]
2026-03-02 Order ready
    [ESP32_Shield-B_Cu.gbr, ESP32_Shield-B_Mask.gbr, ESP32_Shield-B_Paste.gbr, ESP32_Shield-B_Silkscreen.gbr, ESP32_Shield-Edge_Cuts.gbr, ESP32_Shield-F_Cu.gbr, ESP32_Shield-F_Mask.gbr, ESP32_Shield-F_Paste.gbr]
2026-03-10 updated battery voltage monitor mosfet schematics
    [ESP32_Shield.kicad_sch]
2026-03-10 upload old PCB
    [3V Checker.kicad_sch, BA_Waage.kicad_pcb, BA_Waage.kicad_sch, Battery Charger.kicad_sch, Power Supply.kicad_sch, Power Switch_sch.kicad_sch, USB-C Port.kicad_sch, power.kicad_sch]
2026-03-10 Feedback umetzen
    [ESP32_Shield-B_Cu.gbr, ESP32_Shield-B_Mask.gbr, ESP32_Shield-B_Paste.gbr, ESP32_Shield-B_Silkscreen.gbr, ESP32_Shield-Edge_Cuts.gbr, ESP32_Shield-F_Cu.gbr, ESP32_Shield-F_Mask.gbr, ESP32_Shield-F_Paste.gbr]
2026-03-15 Implement dual-mode BLE: advertisement for timer wake-up, GATT for first boot
    ESP32 (BleInitState, SendDataState):
    - Timer wake-up: advertise weight in BLE manufacturer data (6 bytes: 2 company ID + 4 float), no GATT server
    - Power-cycle: full GATT server for configuration (unchanged)
    - SendDataState: in timer mode, wait for timeout then go to DEEP_SLEEP directly
    Gateway (GWBackgroundService):
    - HandleDevice: check for manufacturer data first; if present, parse weight and PUT to /bins/currentweight without connecting
    - Falls back to GATT connection flow only when no manufacturer data (power-cycle / first-boot configuration)
2026-04-12 upload adc dbg
2026-04-29 Further ADC debugging
2026-05-06 ADC debbuging
2026-05-17 kicad libraries
2026-06-05 back end upload
    [ConfigurationState.h]
2026-06-21 working calibration
2026-06-21 least square calibration
2026-06-23 Fixed light sleep during measuring
    [HwContext.cpp, HwContext.h]
